samim-robotix/IRoCU-2024-ISRO-Rover/README.md

# Project OBSERACT: Autonomous Planetary Exploration Rover
### ISRO Robotics Challenge - URSC 2024 (IRoC-U 2024) | 5th Position Nationally

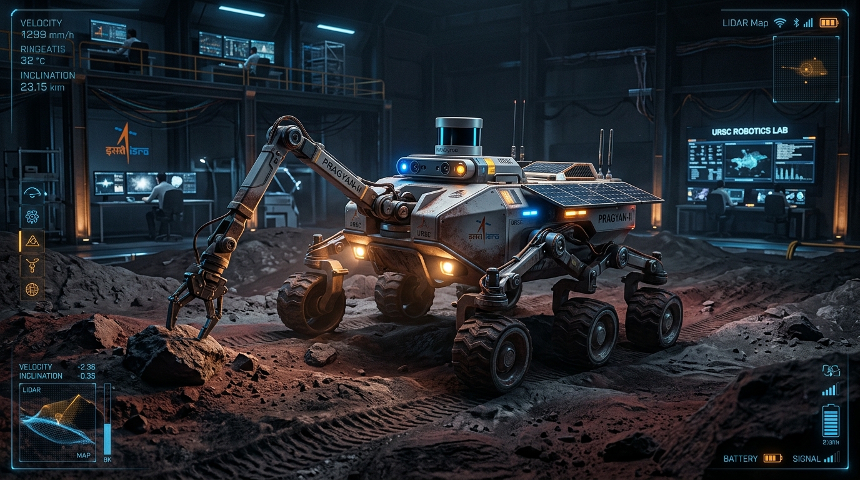
[picture p1: assets/banner.png]
Project Banner


<div align="center">














</div>

---

# Team OBSERACT - IROC-U 2024 Rover Project

<!-- PROJECT POSTER / INFOGRAPHIC (Full Width) -->
<p align="center">
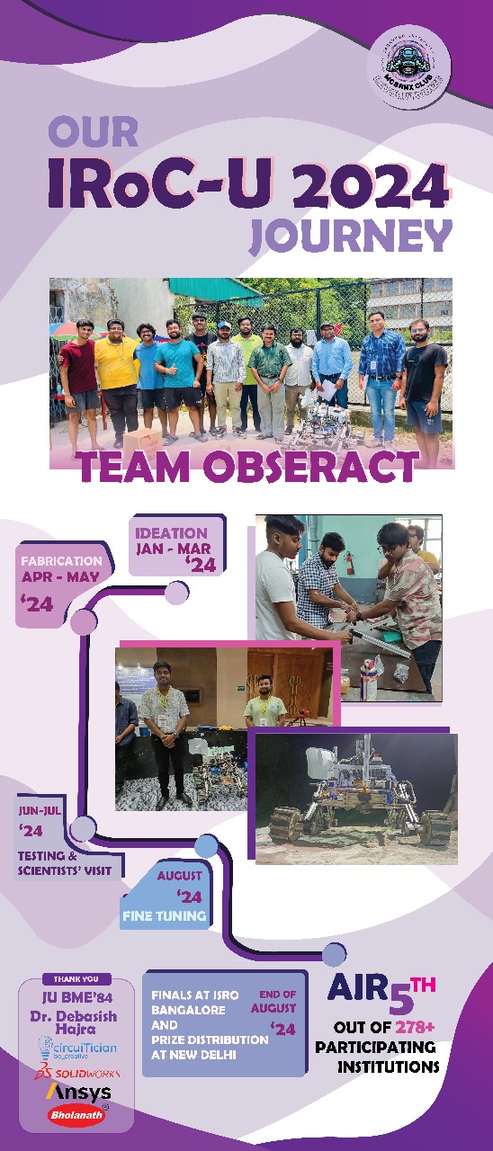
[picture p2: assets/photos/team banner.jpg]
Our IROC-U 2024 Journey Poster
  
</p>

## 🖼️ Project Gallery

### 🤖 Rover Design, Autonomous Testing & Engineering
_Detailed views of the Team OBSERACT rover hardware, computer vision inference, and obstacle navigation systems._

<table width="100%">
  <tr>
    <td width="50%" align="center">
      Rover Hardware Prototype<br>
      <b>Rover Hardware & Chassis Prototype</b>
    </td>
    <td width="50%" align="center">
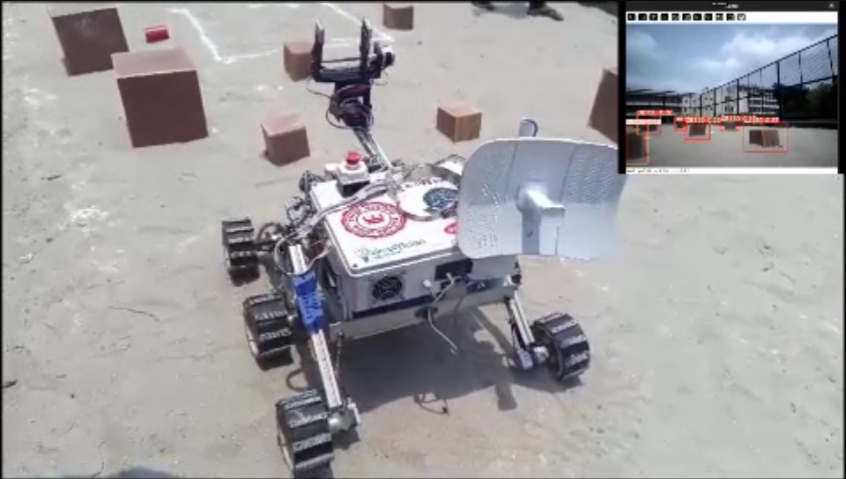
[picture p3: assets/photos/rover ju.PNG]
Autonomous Navigation Testing
      <br>
      <b>Computer Vision & Obstacle Avoidance Testing</b>
    </td>
  </tr>
  <tr>
    <td width="50%" align="center">
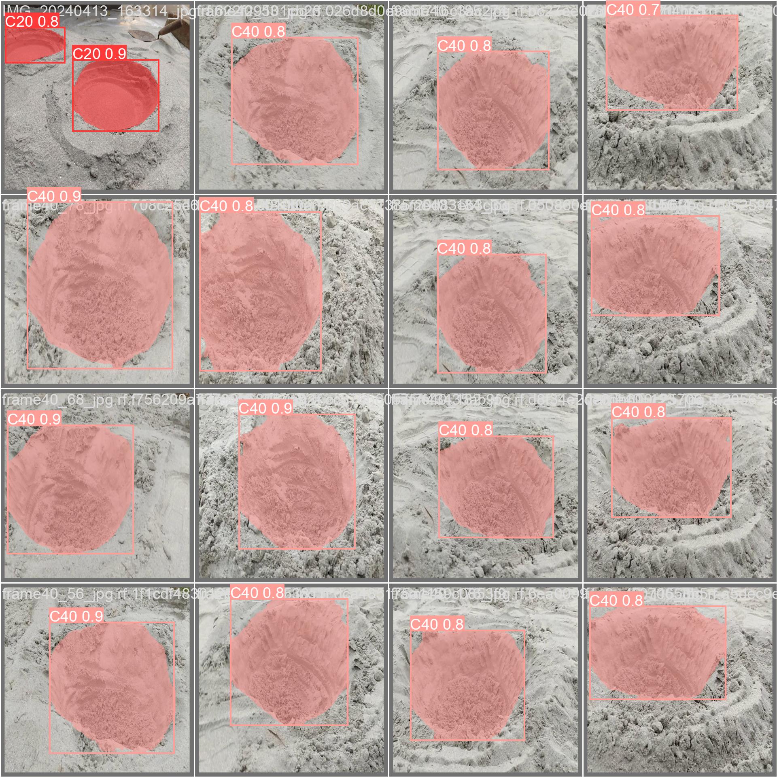
[picture p4: assets/photos/crater_detection_yolov8.jpeg]
YOLOv8 Crater Detection
      <br>
      <b>YOLOv8 Crater Detection Inference</b>
    </td>
    <td width="50%" align="center">
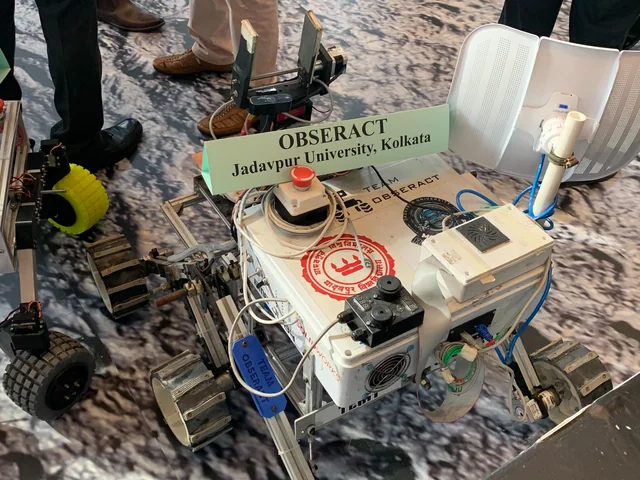
[picture p5: assets/photos/rover isro.WEBP]
Rover at ISRO Arena
      <br>
      <b>Final Rover Configuration at ISRO Arena</b>
    </td>
  </tr>
</table>

---

### 🚀 Team Journey & ISRO Finals
_Snapshots of the team during field calibration and the final staging at the U. R. Rao Satellite Centre (URSC)._

<table width="100%">
  <tr>
    <td width="50%" align="center">
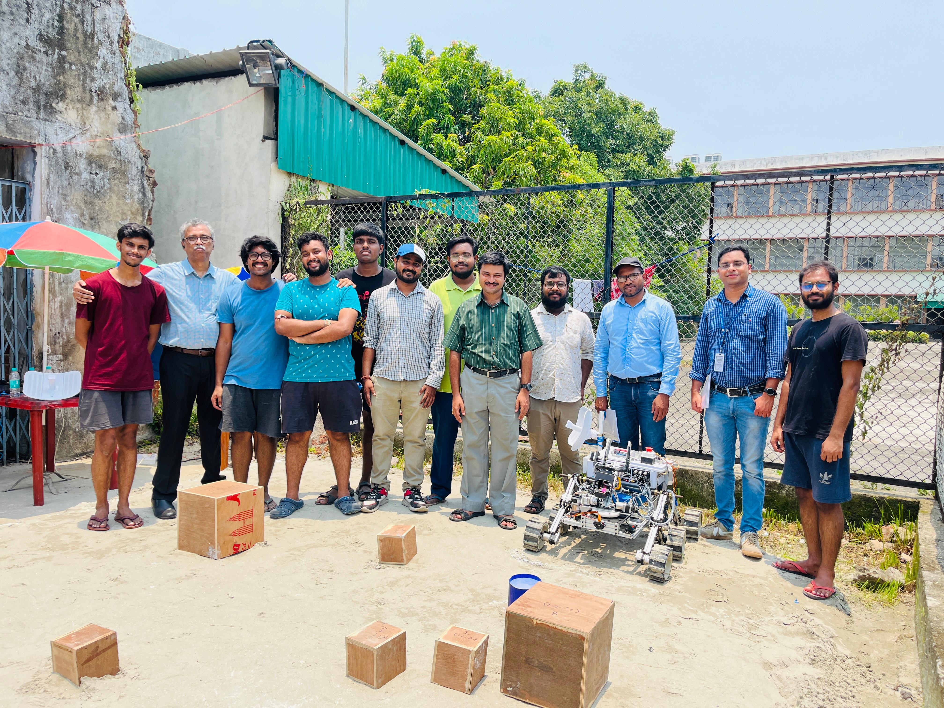
[picture p6: assets/photos/team jadavpur.jpg]
Team Jadavpur Testing Field
      <br>
      <b>Team at Jadavpur University Testing Site</b>
    </td>
    <td width="50%" align="center">
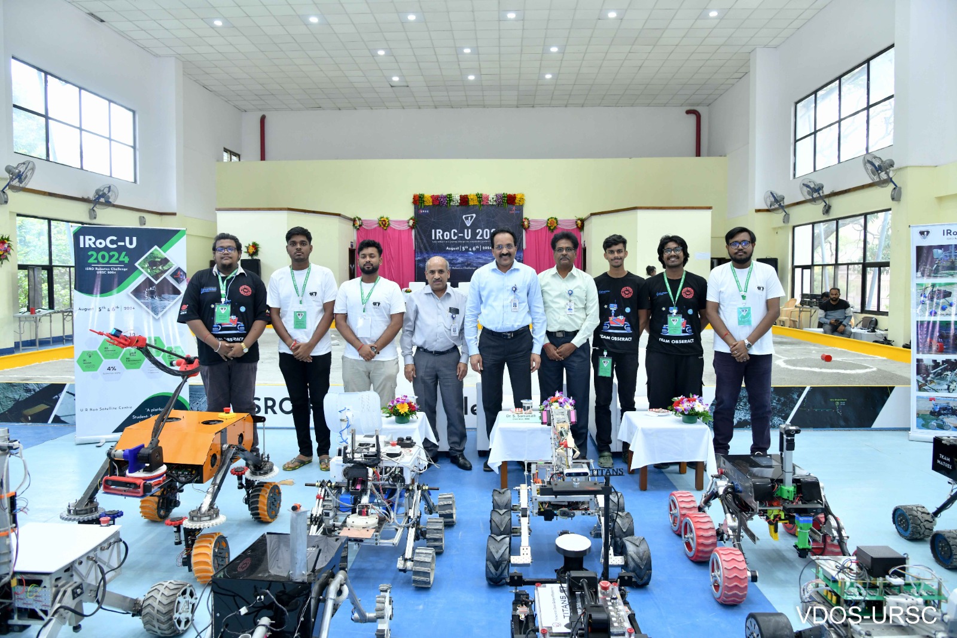
[picture p7: assets/photos/team isro 1.jpg]
ISRO Staging Arena Lineup
      <br>
      <b>Team OBSERACT at URSC Staging Arena</b>
    </td>
  </tr>
  <tr>
    <td width="50%" align="center">
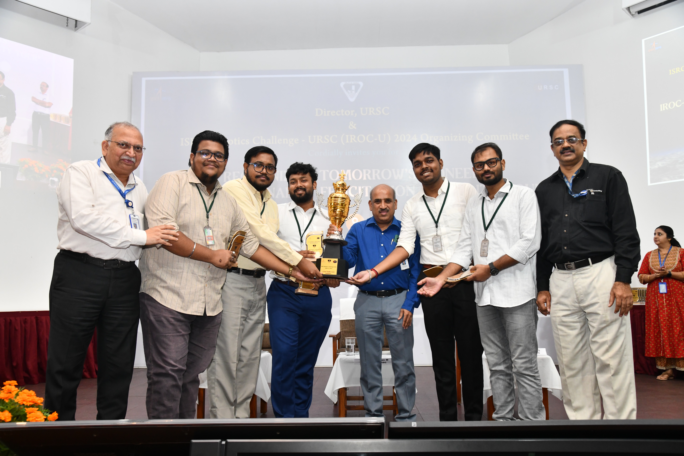
[picture p8: assets/photos/team isro.jpg]
Team Receiving Trophy
      <br>
      <b>Felicitation by the Director, URSC</b>
    </td>
    <td width="50%" align="center">
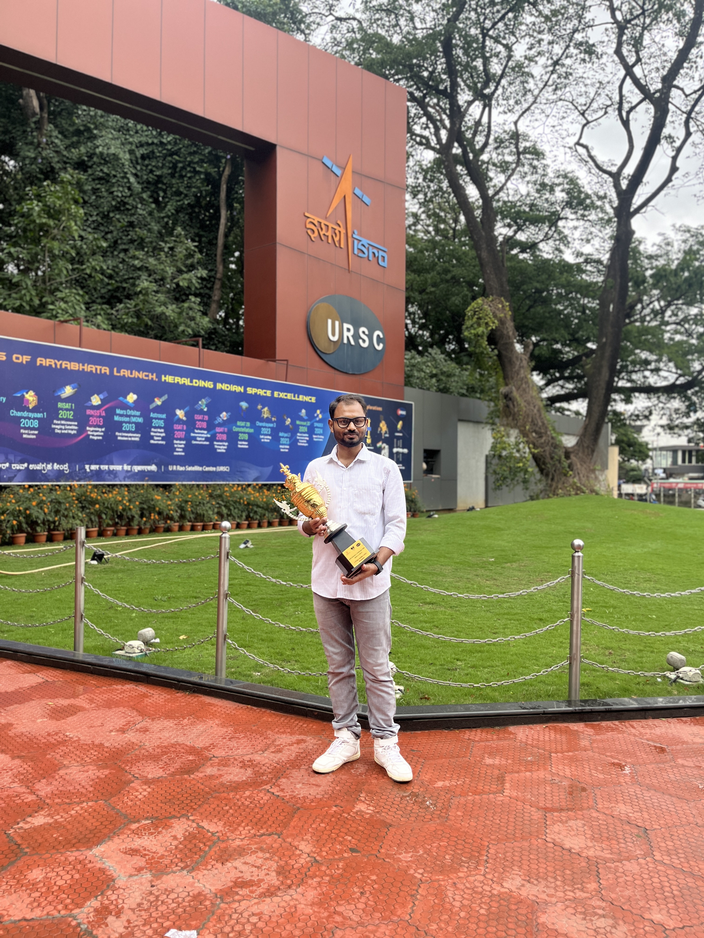
[picture p9: assets/photos/single fron.JPG]
Posing at URSC Sign
      <br>
      <b>Celebrating at URSC Headquarters</b>
    </td>
  </tr>
</table>

---

### 🏆 Awards, Certificates & Media Coverage
_Moments celebrating the All India Rank 5th achievement and the widespread recognition of our work._

<table width="100%">
  <tr>
    <td width="50%" align="center">
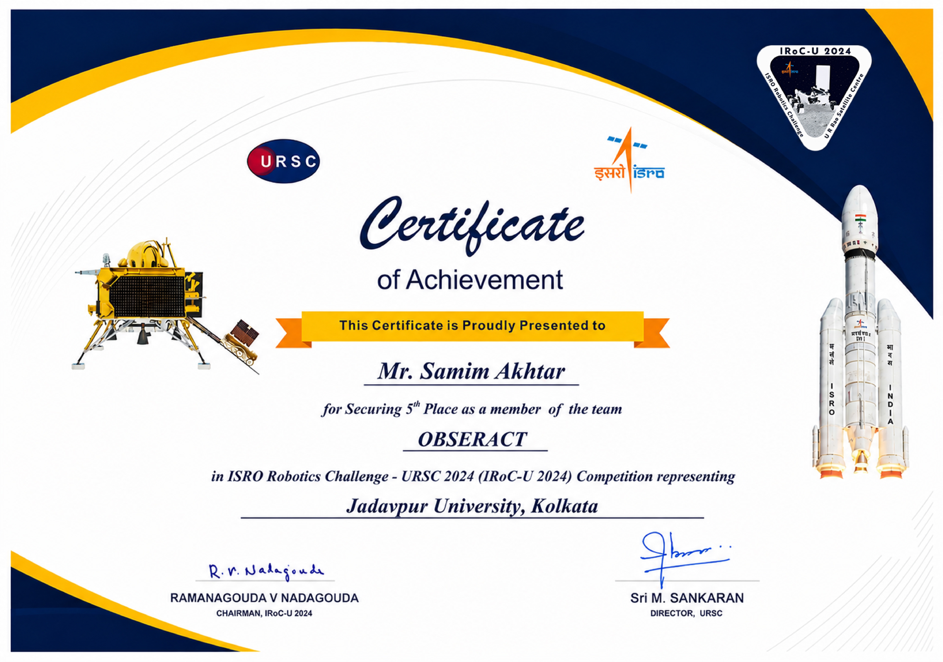
[picture p10: assets/photos/certificate.jpg]
Official Achievement Certificate
      <br>
      <b>Official Achievement Certificate</b>
    </td>
    <td width="50%" align="center">
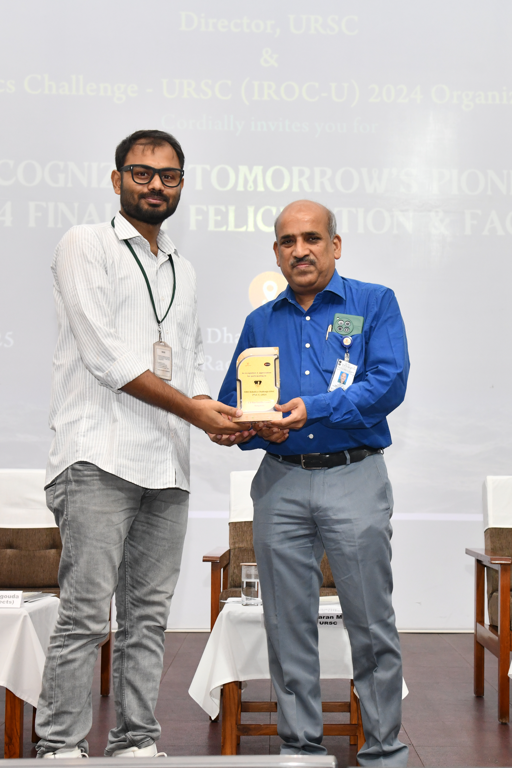
[picture p11: assets/photos/single isro.jpeg]
Receiving Award Token
      <br>
      <b>Receiving the Official Recognition Token</b>
    </td>
  </tr>
  <tr>
    <td width="50%" align="center">
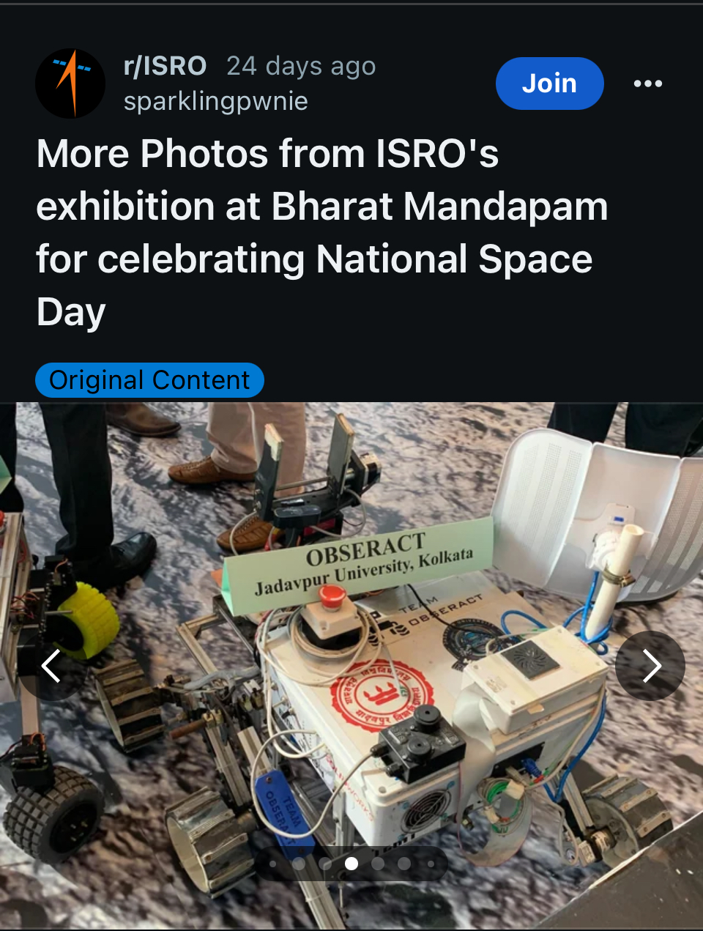
[picture p12: assets/photos/news isro.PNG]
News Coverage 1
      <br>
      <b>Press Coverage Highlighting the Achievement</b>
    </td>
    <td width="50%" align="center">
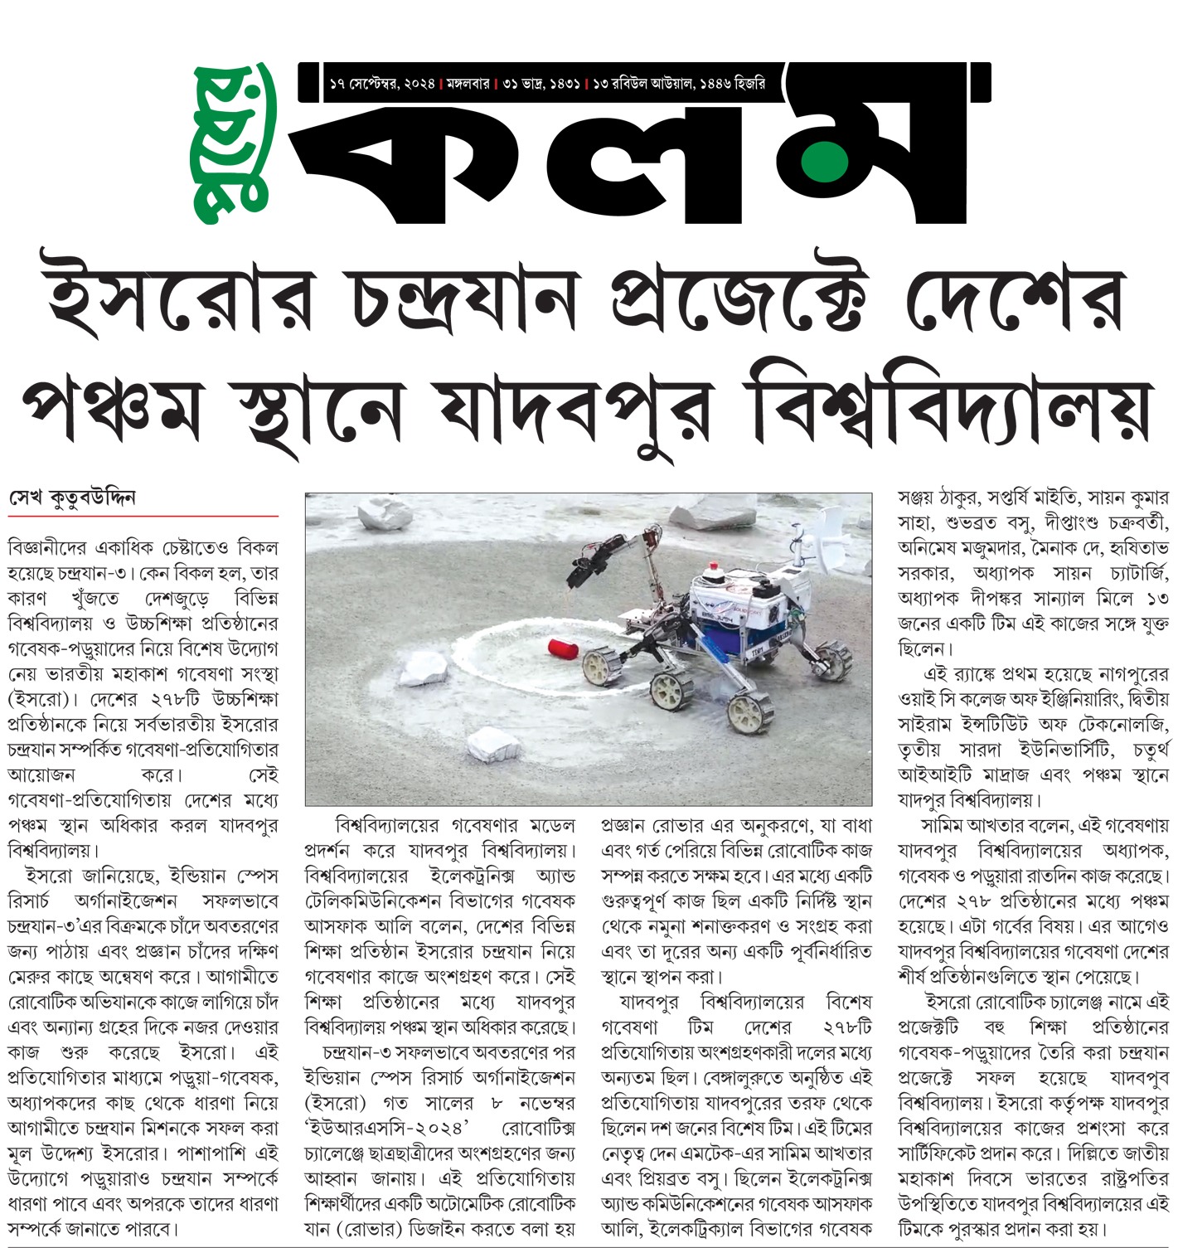
[picture p13: assets/photos/kalam news.jpg]
News Coverage 2
      <br>
      <b>Kalam News Feature Report</b>
    </td>
  </tr>
</table>

---

### 🎥 Field Test Videos & Demonstrations

https://github.com/user-attachments/assets/1fea89f5-3243-4703-b733-9410708686cc

https://github.com/user-attachments/assets/83157b1c-a9e9-4bf5-b669-3bb103190346

https://github.com/user-attachments/assets/7a4b1e10-6299-4aff-aaf4-be91f2c25774

https://github.com/user-attachments/assets/a8de3687-ca90-4187-93c7-3bbb9b5a7004

https://github.com/user-attachments/assets/2eed0919-5cf9-45e3-8780-65f5be33dcf5

https://github.com/user-attachments/assets/71d96060-224c-4bb0-9c72-89f13145069e

---

## 📝 Project Overview and Documentation

## Table of Contents
1. [Competition Overview & National Achievement](#competition-overview--national-achievement)
2. [Hardware & Embedded System Architecture](#hardware--embedded-system-architecture)
3. [Autonomous Perception & Control Pipeline](#autonomous-perception--control-pipeline)
4. [Core Engineering Features](#core-engineering-features)
5. [5-DOF Manipulator & Analytical Kinematics](#5-dof-manipulator--analytical-kinematics)
6. [Bill of Materials (BOM) & Pinout Configuration](#bill-of-materials-bom--pinout-configuration)
7. [Repository File & Directory Structure](#repository-file--directory-structure)
8. [Hardware & Software Setup Guide](#hardware--software-setup-guide)
9. [Media Showcase & Field Tests](#media-showcase--field-tests)
10. [Team & Mentorship](#team--mentorship)
11. [License & Acknowledgments](#license--acknowledgments)

---

## Competition Overview & National Achievement

The **ISRO Robotics Challenge - URSC 2024 (IRoC-U 2024)** was organized by the **U R Rao Satellite Centre (URSC), Indian Space Research Organisation (ISRO)**, Bengaluru. The challenge invited premier universities across India to engineer an extraterrestrial rover prototype capable of operating in simulated lunar and Martian regolith environments.

### Mission Criteria
- **Rocker-Bogie Traverse:** Traverse harsh uneven terrain, scale 150 mm & 300 mm obstacles, and negotiate 15° inclines at controlled speeds of 1 to 5 cm/s.
- **Crater Detection & Avoidance:** Identify and traverse or navigate around 20 cm and 40 cm diameter hemispherical craters.
- **Sample Manipulation:** Autonomously detect, grip, elevate, and deposit target sample cylinders using an onboard multi-axis robotic arm with closed-loop force sensing.
- **Beyond-Line-of-Sight Remote Operation:** Complete all operations remotely within a strict 40-minute window without direct line-of-sight, guided solely by real-time sensor fusion and video telemetry over a 5 GHz wireless link.
- **Emergency Protection:** Hardwired emergency kill-switch mechanism providing instantaneous actuator power isolation.

> **National Standing:** **Team OBSERACT (Team ID: 10487)** from **Jadavpur University, Kolkata** achieved **5th Position Nationally in India**, successfully passing stringent preliminary rounds, design qualification audits, and competitive arena trials.

---

## Hardware & Embedded System Architecture

The rover utilizes a **hierarchical dual-tier processing architecture**: an NVIDIA Jetson Edge AI computer executes compute-heavy perception, neural inference, and path planning, while an STM32F407 ARM Cortex-M4 microcontroller executes deterministic, low-latency motor commutation, CAN bus bus-arbitration, and sensor acquisition.

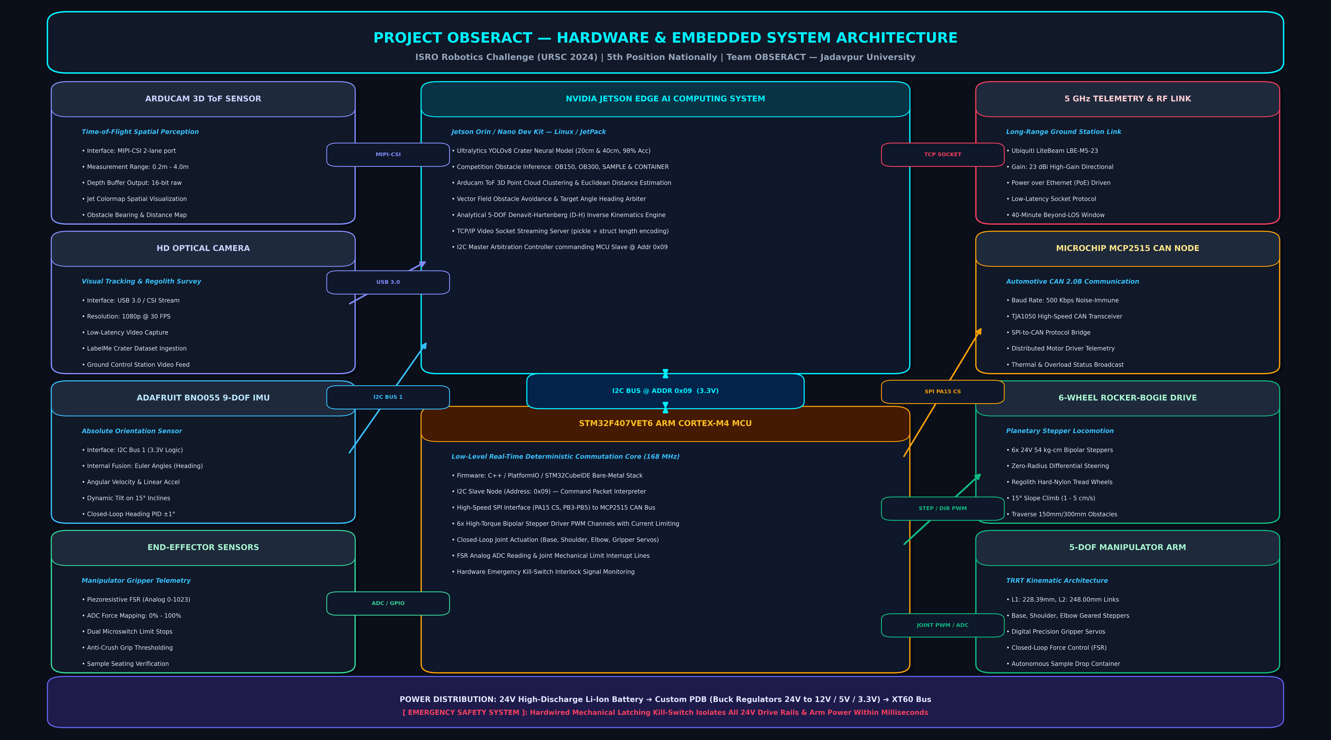
[picture p14: assets/architecture.png]
Hardware & Embedded System Architecture


### Architectural Tier Breakdown
1. **Perception & Telemetry Input Tier:**
   - **Arducam 3D ToF Camera:** Streams 16-bit raw depth buffers over high-speed MIPI-CSI (2-lane) for obstacle range (0.2m-4.0m) and bearing calculation.
   - **HD Optical Camera:** Captures 1080p RGB frames at 30 FPS for YOLOv8 edge inference and ground station streaming.
   - **Adafruit BNO055 9-DOF IMU:** Dedicated I2C Bus 1 interface feeding absolute Euler orientation (heading, pitch, roll) for closed-loop dynamic attitude compensation on 15° slopes.
   - **End-Effector Gripper Sensors:** Analog Piezoresistive FSR (0–1023 ADC mapped to 0–100% force) and digital dual-limit switches for tactile feedback.
2. **High-Level Compute Brain (NVIDIA Jetson Orin / Nano):**
   - Executes real-time TensorRT-accelerated YOLOv8 models for craters and obstacles.
   - Computes dynamic repulsive vector fields and closed-loop heading corrections.
   - Houses the analytical 5-DOF inverse kinematics solver.
   - Operates as **I2C Master** dispatching motion commands to the microcontroller at slave address `0x09`.
   - Runs a TCP/IP video streaming server sending pickle-encoded frame buffers over 5 GHz RF.
3. **Low-Level Deterministic Controller (STM32F407VET6 ARM Cortex-M4 @ 168 MHz):**
   - High-speed SPI (`PA15 CS`) driving the **Microchip MCP2515 CAN Controller** (500 Kbps CAN 2.0B).
   - Generates precision Step/Dir PWM pulses across 6 independent high-torque stepper channels.
   - Monitored by dynamic current-limiting and thermal protection circuits.
4. **Physical Actuation & Power:**
   - **Locomotion:** Six 24V bipolar planetary geared steppers (54 kg-cm torque) driving custom regolith tread wheels.
   - **Arm:** 5-DOF TRRT manipulator with aluminum links and servo/stepper actuators.
   - **Power Distribution Board (PDB):** Step-down buck regulators (24V  12V, 5V, 3.3V) with heavy-duty XT60 buses.
   - **Emergency Kill Switch:** Mechanical latching switch hardwired in-line with the 24V master rail for instantaneous power cutoff.

---

## Autonomous Perception & Control Pipeline

Project OBSERACT features an integrated, closed-loop autonomy pipeline operating in real time at **30 FPS**:

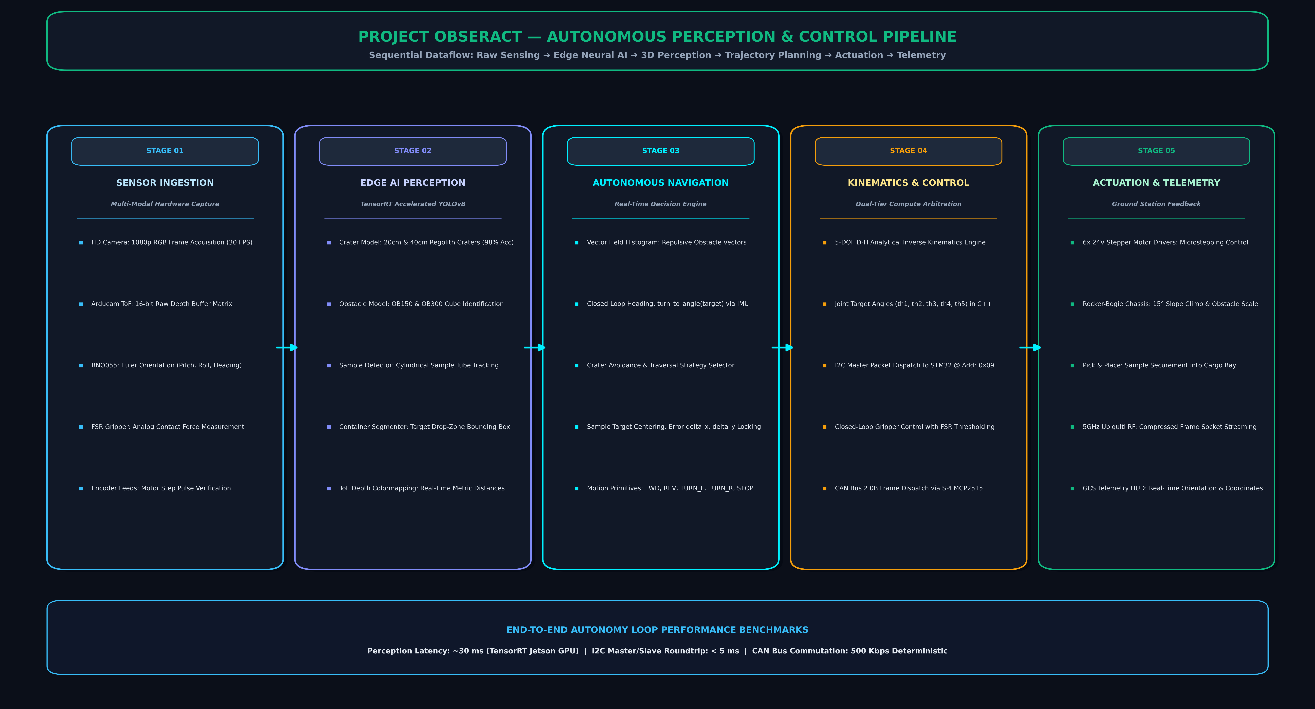
[picture p15: assets/pipeline.png]
Autonomous Perception & Control Pipeline


### Dataflow Stages
| Stage | Subsystem | Functionality & Technical Execution |
|:---:|:---|:---|
| **01** | **Sensor Ingestion** | Synchronized multi-modal capture of 1080p optical video, ToF 16-bit depth buffers, BNO055 9-DOF Euler angles, and analog FSR gripper readings. |
| **02** | **Edge AI Perception** | TensorRT-accelerated dual-model YOLOv8 inference: (1) 20 cm & 40 cm crater detection (98% accuracy), (2) ISRO challenge objects (`OB150`, `OB300`, `SAMPLE`, `CONTAINER`), plus Arducam ToF depth colormapping. |
| **03** | **Autonomous Navigation** | Vector Field Histogram (VFH) generating repulsive steering vectors; closed-loop `turn_to_angle(target)` heading stabilization with 1 precision; automated crater avoidance logic. |
| **04** | **Kinematics & Control** | Analytical 5-DOF Denavit-Hartenberg (D-H) Inverse Kinematics calculating joint angles $\theta_1 \dots \theta_5$; I2C command packet dispatch to STM32 (Addr `0x09`); CAN 2.0B frame broadcast via MCP2515. |
| **05** | **Actuation & Telemetry** | 6-wheel planetary stepper microstepping; 15° slope climb and obstacle traversal; sample pickup and container drop; low-latency OpenCV socket streaming to ground station over 5 GHz Ubiquiti RF. |

---

## Core Engineering Features

- **6-Wheel Rocker-Bogie Suspension:**
  - Engineered with lightweight, structural aluminum T-slot framing (400 mm rocker, 160 mm bogie, 100° span angle).
  - Maintains continuous ground contact across all six wheels on extreme regolith gradients without mechanical springs.
  - Zero-radius differential turning allows on-the-spot rotation and tight steering in confined spaces.
- **Industrial Planetary Drive Actuation:**
  - Six independent 24V bipolar planetary geared stepper motors providing up to **54 kg-cm torque** per wheel.
  - Dedicated multi-channel drive PCB equipped with dynamic current limiting and thermal shutdown safeguards.
- **Dual-Bus Communication Hierarchy:**
  - **CAN Bus 2.0B @ 500 kbps:** Driven by STM32 via SPI-controlled Microchip MCP2515 transceiver for noise-immune actuator signaling.
  - **I2C Master/Slave Protocol:** Jetson Nano operates as I2C master sending motion primitives (`1: Forward`, `2: Backward`, `3: Left`, `4: Right`, `5: Stop`, `6: Heading Target`) to the microcontroller slave at address `0x09`.
- **Closed-Loop Heading Stabilization:**
  - Real-time absolute Euler orientation feedback sourced from the **Adafruit BNO055 9-DOF IMU**.
  - Dynamic turning algorithms (`turn_to_angle`) maintain trajectory accuracy within 1 tolerance.
- **Edge-to-Ground High-Bandwidth Telemetry:**
  - Long-range directional Ubiquiti LiteBeam 5GHz antenna (23 dBi gain) running low-latency TCP/IP socket video streaming.
  - Custom serialization protocol packing frame headers (`struct.pack("Q", len(frame))`) for live ground control feeds.
- **Fail-Safe Emergency Cutoff:**
  - Integrated hardware kill-switch triggering direct power isolation to all actuator circuits within milliseconds.

---

## 5-DOF Manipulator & Analytical Kinematics

The rover carries a 5-Degree-of-Freedom robotic arm configured in a **TRRT** (Twist-Revolute-Revolute-Twist) kinematic arrangement built with lightweight CNC aluminum links and dual-bearing revolute joints.

### Denavit-Hartenberg (D-H) Parameter Table
| Link (i) | Joint Angle (i) | Link Offset (di) | Link Twist (i) | Link Length (ai) |
|:---:|:---:|:---:|:---:|:---:|
| **1** | 1 | 0 | -90 | 0 |
| **2** | 2 | 0 | 0 | L1 (228.39mm) |
| **3** | 3 | 0 | 0 | L2 (248.00mm) |
| **4** | 4 | 0 | +90 | 0 |
| **5** | 5 | 0 | 0 | 0 |

### Analytical Inverse Kinematics Formulation
Given target end-effector coordinates (qx,qy,qz) and orientation matrix elements rij:

1=atan2(qy,qx)

3=qx2+qy2+qz2-L12-L222L1L2

2=L1+L23L23+qx1+qy1-qz

4=r131+r231r33-2-3

5=r211-r111r221-r211

*Closed-form solutions are implemented in high-performance C/C++ ([`arm_manipulator_C_Code.ino`](ISRO/arm_manipulator_C_Code/arm_manipulator_C_Code.ino)) and Python for real-time trajectory planning.*

---

## Bill of Materials (BOM) & Pinout Configuration

### Master Bill of Materials (BOM)
| Subsystem | Component Description | Specifications / Model | Qty | Function |
|:---|:---|:---|:---:|:---|
| **Chassis** | Rocker-Bogie Linkage | 6061-T6 Aluminum T-Slots | 1 Set | Terrain articulation & ground clearance |
| **Locomotion** | Planetary Geared Stepper | 24V, 54 kg-cm torque, BH42SH38-1684PL | 6 | Individual wheel traction & drive |
| **Wheels** | Custom Regolith Wheels | High-durability Nylon / Rubber treads | 6 | Regolith surface grip |
| **Drive Electronics** | Stepper Driver Controller | Multi-Channel Current Regulated Board | 1 | Microstepping & current limiting |
| **Embedded Compute** | Microcontroller | STM32F407VET6 (ARM Cortex-M4, 168 MHz) | 1 | Real-time motion control & CAN bus |
| **Edge AI Brain** | Edge AI Computer | NVIDIA Jetson Nano / Jetson Orin | 1 | YOLOv8 inference, CV, high-level nav |
| **CAN Bus Interface** | CAN Controller & PHY | Microchip MCP2515 + TJA1050 | 1 | High-speed SPI-to-CAN 2.0B bus |
| **Attitude Sensor** | 9-DOF Absolute IMU | Adafruit BNO055 | 1 | Orientation, angular rate & heading |
| **Depth Sensor** | Time-of-Flight Camera | Arducam ToF Depth Camera (MIPI-CSI) | 1 | 3D obstacle depth mapping (up to 4m) |
| **Robotic Arm** | 5-DOF Manipulator | Precision Steppers + Digital High-Torque Servos | 5 | Sample pickup, elevation, and drop |
| **End Effector** | Force Feedback Sensor | Piezoresistive FSR (Analog 0-1023) | 1 | Grasping force regulation |
| **End Effector** | Limit Switches | Microswitches | 2 | Mechanical over-travel protection |
| **RF Communications** | Directional Long-Range Antenna| Ubiquiti LiteBeam LBE-M5-23 (5 GHz, 23 dBi)| 2 | Low-latency telemetry link (Rover + Base) |
| **Power Storage** | Main Battery Pack | 24V High-Discharge Lithium-Ion Pack | 1 | System master power source |
| **Power Distribution** | Custom PDB | Buck Converters (24V  12V, 5V, 3.3V) + XT60 | 1 | Regulated rails & noise filtering |
| **Safety System** | Emergency Kill Switch | High-Current Latching E-Stop Switch | 1 | Instantaneous actuator power cut |

### GPIO Pinout & Communication Interconnect Map

| Device / Module | Signal / Pin | Host / Board Connection | Protocol / Logic Level | Description |
|:---|:---|:---|:---|:---|
| **MCP2515 CAN** | `CS` | STM32F407 Pin `PA15` | SPI (3.3V) | Chip Select for CAN Bus Controller |
| **MCP2515 CAN** | `SCK` | STM32F407 Pin `PB3` / `PA5` | SPI Clock | SPI Bus Clock Line |
| **MCP2515 CAN** | `SO / MISO`| STM32F407 Pin `PB4` / `PA6` | SPI MISO | Controller Data In |
| **MCP2515 CAN** | `SI / MOSI`| STM32F407 Pin `PB5` / `PA7` | SPI MOSI | Controller Data Out |
| **MCP2515 CAN** | `INT` | STM32F407 Interrupt GPIO | Active-Low Interrupt | Frame Receive Notification |
| **BNO055 9-DOF IMU**| `SDA` | Jetson Pin 3 / STM32 `PB7` | I2C (3.3V Pull-up) | Serial Data Line |
| **BNO055 9-DOF IMU**| `SCL` | Jetson Pin 5 / STM32 `PB6` | I2C (3.3V Pull-up) | Serial Clock Line |
| **MCU Slave Port** | `SDA / SCL`| Jetson I2C Bus 1  MCU Addr `0x09`| I2C (3.3V) | Motion command link (Jetson  MCU) |
| **Gripper FSR** | `V_OUT` | STM32 ADC Channel `A0` | Analog (0 - 3.3V) | Force mapping ($0 - 100\%$) |
| **Gripper Limit SW**| `SIGNAL` | STM32 Digital GPIO (Pull-up) | Digital Input | Stroke limit safety interlock |
| **Arducam Depth Cam**| `CSI-2` | Jetson 15-pin / 22-pin MIPI Port | High-Speed MIPI-CSI | Real-time ToF raw depth stream |
| **Kill Switch** | `V_IN / V_OUT`| In-line with 24V Drive Rail | High-Current DC | Emergency power cutoff to drivers |

---

## Repository File & Directory Structure

```
IRoCU-2024/
├── assets/
│   ├── banner.png                              # High-tech project banner
│   ├── architecture.png                        # Hardware & embedded system architecture
│   ├── pipeline.png                            # Autonomous perception & control pipeline
│   ├── photos/                                 # Hardware and arena prototype photos
│   │   ├── crater_detection_yolov8.jpeg        # YOLOv8 crater inference validation
│   │   ├── crater_training_metrics.png         # Precision-recall & loss curves
│   │   ├── rover_hardware_prototype.jpg        # Fabricated Rocker-Bogie chassis
│   │   ├── obstacle_150mm_cube.jpg             # 150mm obstacle detection target
│   │   ├── obstacle_300mm_cube.jpg             # 300mm obstacle avoidance target
│   │   └── obstacle_sample_tube.jpg            # Cylindrical sample target
│   └── videos/                                 # Field tests & mobility recordings
│       ├── rover_mobility_demo.mp4             # 6-wheel rover traversal test
│       ├── obstacle_traversal_demo.mp4         # Rocker-bogie climbing demonstration
│       └── robotic_arm_demo.mp4                # Manipulator pick-and-place trial
├── ISRO/
│   ├── ArmManipulatorC_code_2/                 # Manipulator kinematics firmware
│   ├── arm_manipulator_C_Code/                 # 5-DOF analytical IK implementation
│   ├── Client Server/                          # Video & telemetry socket streaming
│   ├── Force_Sensor_Code/                      # FSR analog force measurement code
│   ├── General Codes/                          # Vector math, frame extraction & nav
│   ├── ML/                                     # YOLOv8 crater weights (best_25.pt)
│   ├── stm_roboarm/                            # PlatformIO project for STM32F407VE
│   │   ├── platformio.ini                      # STSTM32 platform config & DFRobot CAN
│   │   └── src/main.cpp                        # CAN bus transmission loop
│   └── New folder/                             # Design report, schematics & rulebooks
├── ISRO Total File/
│   ├── ISRO Robotics Challenge/
│   │   ├── autonomy/                           # Integrated YOLOv8 + I2C heading navigation
│   │   │   ├── autonomy.py                     # Main autonomy control loop
│   │   │   ├── heading_i2c.py                  # BNO055 IMU + I2C MCU arbitration
│   │   │   └── ml-inf.py                       # Standalone edge inference
│   │   ├── obseract-live-demonstration/        # Arducam ToF depth camera integration
│   │   │   └── depth_cam.py                    # ToF 3D spatial colormapping & range
│   │   └── obseract/                           # Inverse kinematics regression models
│   ├── New Designs/                            # SolidWorks CAD assemblies (.SLDASM, .SLDPRT)
│   └── OBS_Chassis/                            # Rocker-Bogie chassis structural models
├── generate_diagrams.py                        # Automated architecture & pipeline renderer
├── .gitignore                                  # Optimized Git exclusion filters
└── README.md                                   # Production project documentation
```

---

## Hardware & Software Setup Guide

### 1. Embedded Firmware Setup (STM32F407VE)

The low-level controller firmware is developed using **PlatformIO** and **STM32CubeIDE**.

```bash
# Clone the repository
git clone https://github.com/<your-username>/IRoCU-2024.git
cd IRoCU-2024/ISRO/stm_roboarm

# Install PlatformIO Core if not installed:
pip install platformio

# Compile firmware for STM32F407VE
pio run -e black_f407ve

# Flash to target board via ST-Link v2
pio run -e black_f407ve --target upload
```

### 2. Jetson Edge AI & Autonomous Navigation Setup

Ensure your NVIDIA Jetson Nano / Orin is flashed with **JetPack 5.x / Ubuntu 20.04+** with CUDA and TensorRT enabled.

```bash
# Navigate to the autonomy module
cd "ISRO Total File/ISRO Robotics Challenge/autonomy"

# Create virtual environment
python3 -m venv venv
source venv/bin/activate

# Install required packages
pip install --upgrade pip
pip install ultralytics opencv-python numpy smbus2 adafruit-circuitpython-bno055

# Run the autonomous perception and drive loop
python3 autonomy.py
```

### 3. Video Telemetry & Ground Station Streaming

**On Rover (NVIDIA Jetson Server):**
```bash
cd "ISRO/Client Server/Socket Programming Video streaming"
python3 Server.py
```

**On Ground Control Station (PC Client):**
```bash
cd "ISRO Total File/ISRO Robotics Challenge/obseract-live-demonstration"
python3 client.py --host <ROVER_IP_ADDRESS> --port 9999
```

---

## Field Tests

### Hardware Prototype & Deep Learning Outputs
| Fabricated Rover Prototype | YOLOv8 Crater Detection | Model Metrics |
|:---:|:---:|:---:|
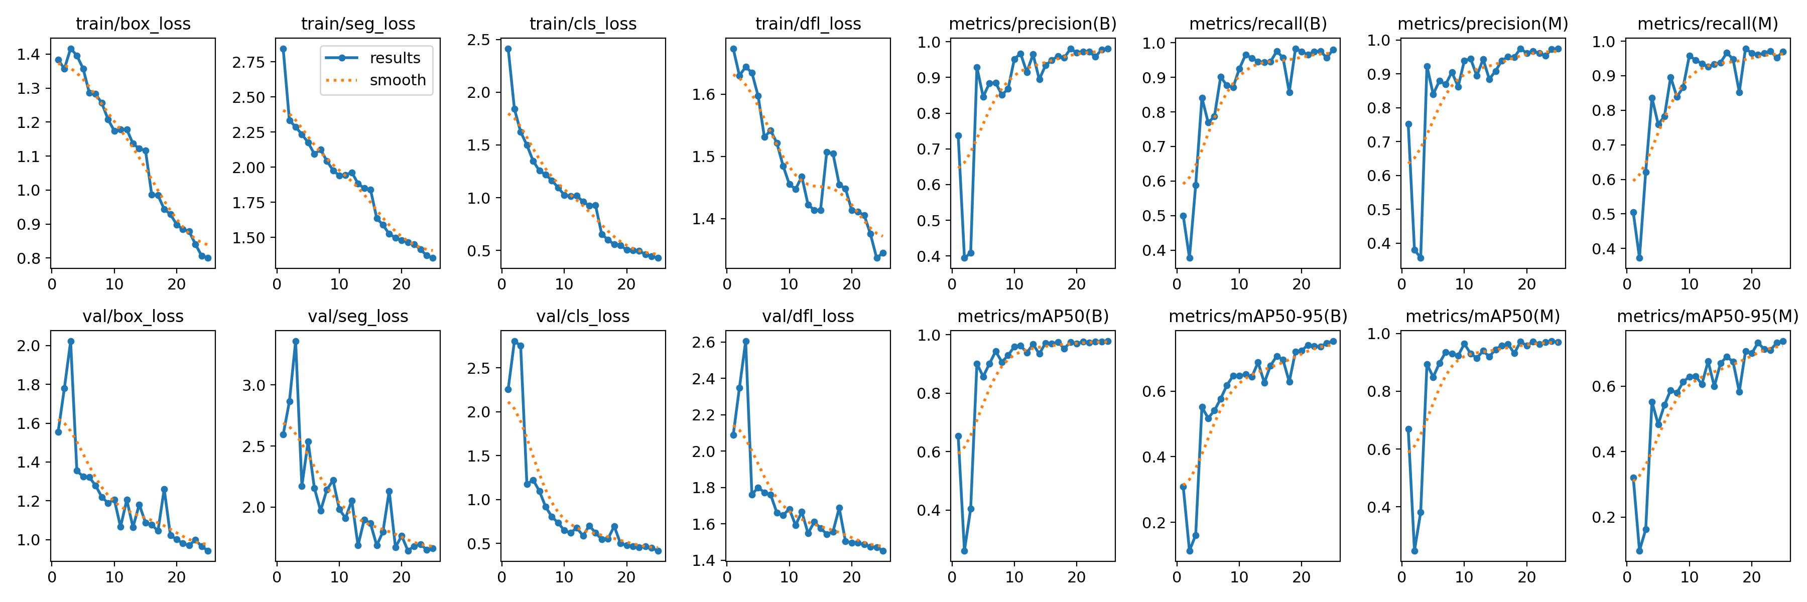
[picture p16: assets/photos/crater_training_metrics.png]
Training Metrics
| Rover Prototype | Crater Detection |  |
| *6-wheel Rocker-Bogie suspension testbed* | *Real-time 20cm/40cm crater inference* | *High precision-recall curve ($98\%$)* |

### Field Target Markers
| 150 mm Obstacle Block | 300 mm Obstacle Block | Sample Retrieval Tube |
|:---:|:---:|:---:|
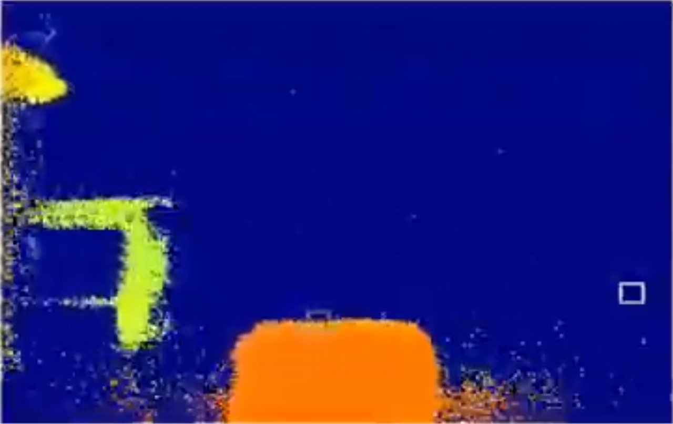
[picture p17: assets/photos/obstacle_150mm_cube.jpg]
150mm Block
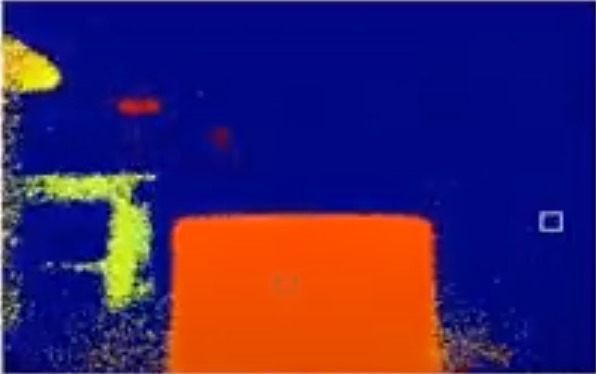
[picture p18: assets/photos/obstacle_sample_tube.jpg]
Sample Tube
|  | 300mm Block |  |
| *Scaling & traversal target* | *Autonomous avoidance obstacle* | *5-DOF manipulator pickup target* |

## Team & Mentorship

<div align="center">

### Faculty Mentors
**Prof. Dr. Sayan Chatterjee**  
*Professor, Department of Electronics & Telecommunication Engineering*  
*Jadavpur University, Kolkata*

**Prof. Dipankar Sanyal**  
*Professor, Department of Mechanical Engineering*  
*Jadavpur University, Kolkata*

---

### Student Engineering Team (Team OBSERACT)

| # | Name | Department | Role / Subsystem Specialization |
|:---:|:---|:---|:---|
| 1 | **Samim Akhtar** | Electronics & Telecommunication Engg | **Team Lead** · Embedded Architecture, CAN Bus & Vision Integration |
| 2 | **Priyabrata Basu** | Electronics & Telecommunication Engg | Telecommunications, Socket Networking & RF Telemetry |
| 3 | **Diptanshu Chakrabartty**| Civil Engineering | Structural Loading, Dynamics & Ground Analysis |
| 4 | **Saptarshi Maity** | Metallurgical & Material Engineering | Materials Selection, Thermal Profiling & Link Rigidity |
| 5 | **Asfak Ali** | Electronics & Telecommunication Engg | Low-Level Firmware, STM32 Driver Development & Kinematics |
| 6 | **Sanjay Thakur** | Electrical Engineering | Power Distribution Board (PDB), Motor Drivers & Battery |
| 7 | **Hrishitava Sarkar** | Mechanical Engineering | Rocker-Bogie Chassis Design, SolidWorks CAD & Stress FEA |
| 8 | **Sayan Kumar Sah** | Metallurgical & Material Engineering | Fabrication, Joint Machining & Mechanical Prototyping |
| 9 | **Mainak Dey** | Mechanical Engineering | 5-DOF Robotic Arm Mechanical Design & Gripper Mechanism |
| 10 | **Animesh Majumder** | Metallurgical & Material Engineering | Chassis Testing, Quality Assurance & Mechanical Assembly |

</div>

---

## License & Acknowledgments

- **Competition Host:** We express our deepest gratitude to the **U R Rao Satellite Centre (URSC), Indian Space Research Organisation (ISRO)** for conceptualizing and organizing the **IRoC-U 2024** challenge and providing a national platform for robotics innovation.
- **Academic Support:** Sincere thanks to **Jadavpur University**, the Department of Electronics & Telecommunication Engineering, and the Department of Mechanical Engineering for workshop facilities, fabrication resources, and departmental guidance.
- **License:** This project is distributed under the [MIT License](LICENSE).
