samim-robotix/IRoCU-2024-ISRO-Rover/ISRO Total File/ISRO Robotics Challenge/ML Images/20_40Craters.v2i.yolov8/valid/images/frame_2_jpg.rf.8c1ff94af3c7788ad4eeecb040791eaf.jpg

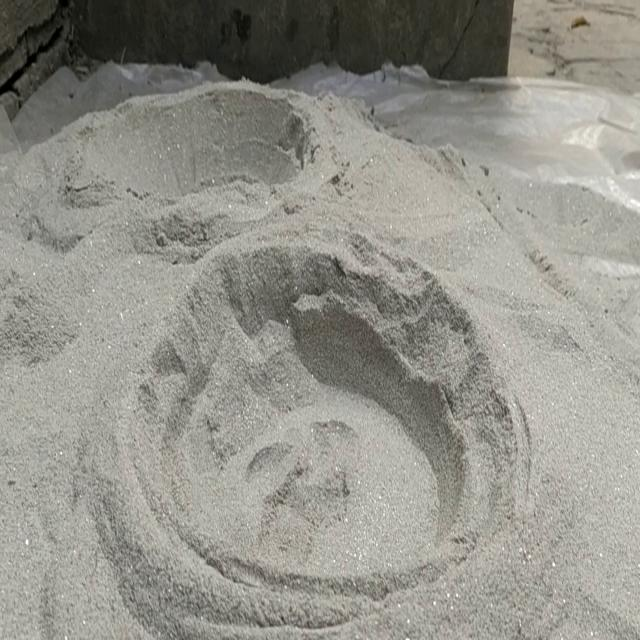
ISRO Total File/ISRO Robotics Challenge/ML Images/20_40Craters.v2i.yolov8/valid/images/frame_2_jpg.rf.8c1ff94af3c7788ad4eeecb040791eaf.jpg
