samim-robotix/IRoCU-2024-ISRO-Rover/ISRO Total File/ISRO Robotics Challenge/ML Images/20_40Craters.v2i.yolov8/valid/images/frame_6_jpg.rf.a0acbc5d8ad12a6c4472a24d94ab41eb.jpg

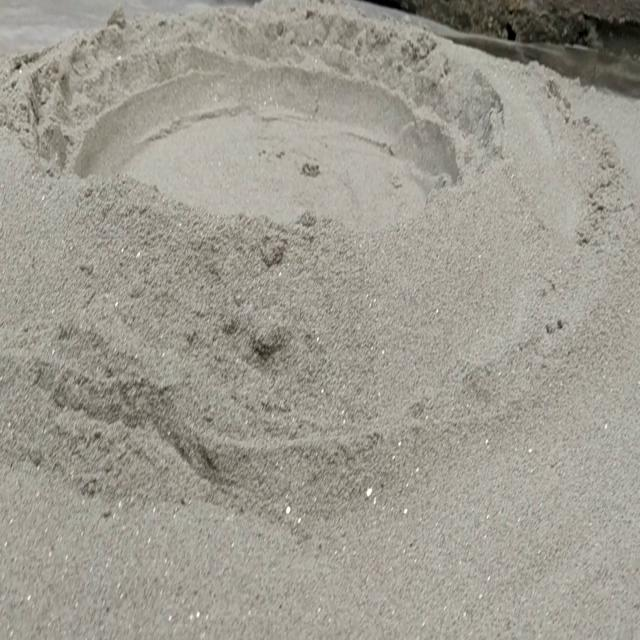
ISRO Total File/ISRO Robotics Challenge/ML Images/20_40Craters.v2i.yolov8/valid/images/frame_6_jpg.rf.a0acbc5d8ad12a6c4472a24d94ab41eb.jpg
