samim-robotix/IRoCU-2024-ISRO-Rover/ISRO Total File/ISRO Robotics Challenge/ML Images/20_40Craters.v2i.yolov8/valid/images/frame_13_jpg.rf.e731c97d967fa71e6efc258e65cf71a0.jpg

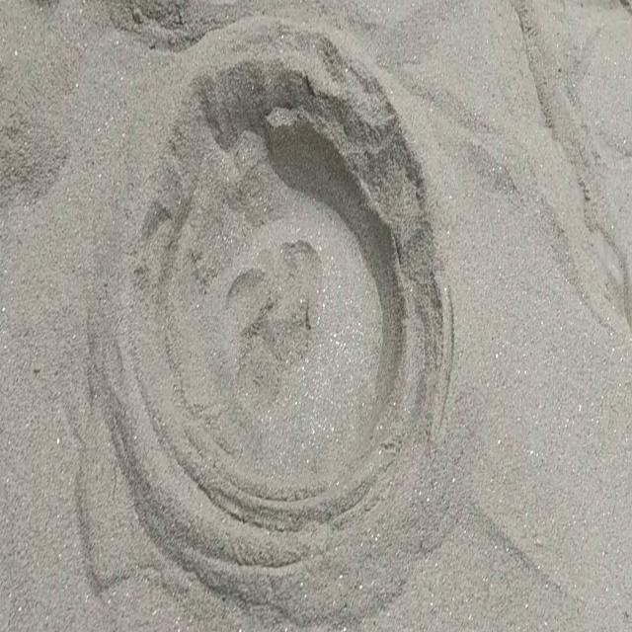
ISRO Total File/ISRO Robotics Challenge/ML Images/20_40Craters.v2i.yolov8/valid/images/frame_13_jpg.rf.e731c97d967fa71e6efc258e65cf71a0.jpg
