samim-robotix/IRoCU-2024-ISRO-Rover/ISRO Total File/ISRO Robotics Challenge/ML Images/20_40Craters.v2i.yolov8/valid/images/frame_14_jpg.rf.c568cc90a22e0c4fc50a3a65dd571331.jpg

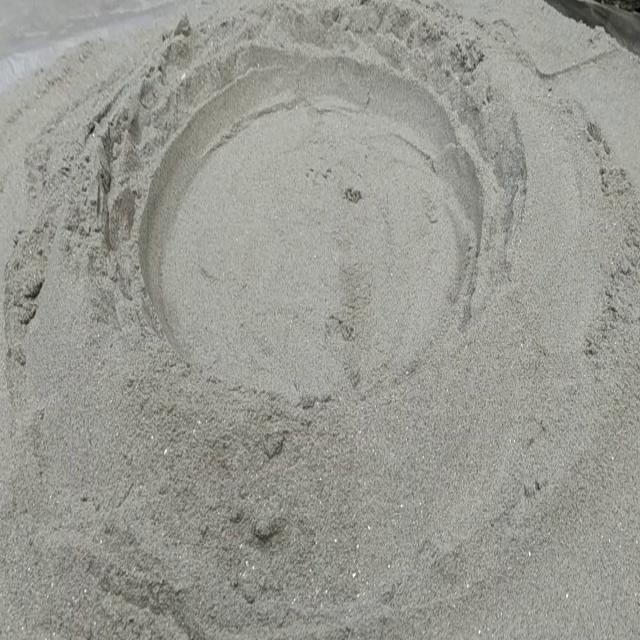
ISRO Total File/ISRO Robotics Challenge/ML Images/20_40Craters.v2i.yolov8/valid/images/frame_14_jpg.rf.c568cc90a22e0c4fc50a3a65dd571331.jpg
