samim-robotix/IRoCU-2024-ISRO-Rover/ISRO Total File/ISRO Robotics Challenge/ML Images/20_40Craters.v2i.yolov8/valid/images/frame_16_jpg.rf.244cc28c9cb41436c8d806cb94a364ef.jpg

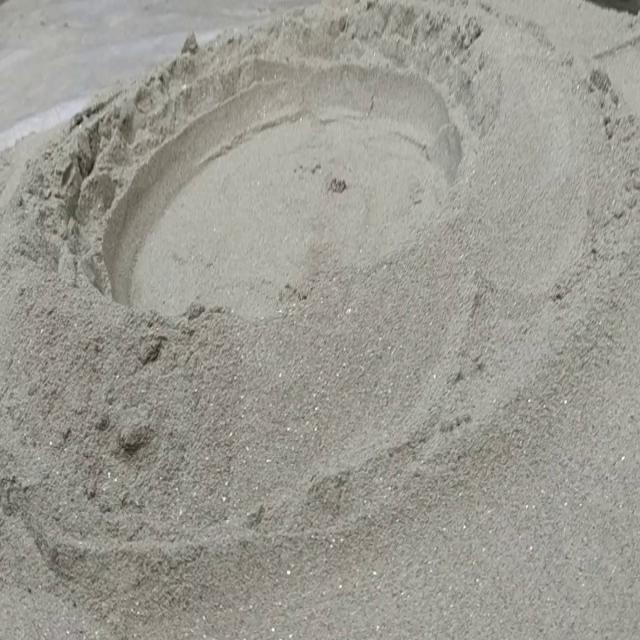
ISRO Total File/ISRO Robotics Challenge/ML Images/20_40Craters.v2i.yolov8/valid/images/frame_16_jpg.rf.244cc28c9cb41436c8d806cb94a364ef.jpg
