samim-robotix/IRoCU-2024-ISRO-Rover/ISRO Total File/ISRO Robotics Challenge/ML Images/20_40Craters.v2i.yolov8/valid/images/frame_19_jpg.rf.c27591f4d9e881a9ca520bb8543271ca.jpg

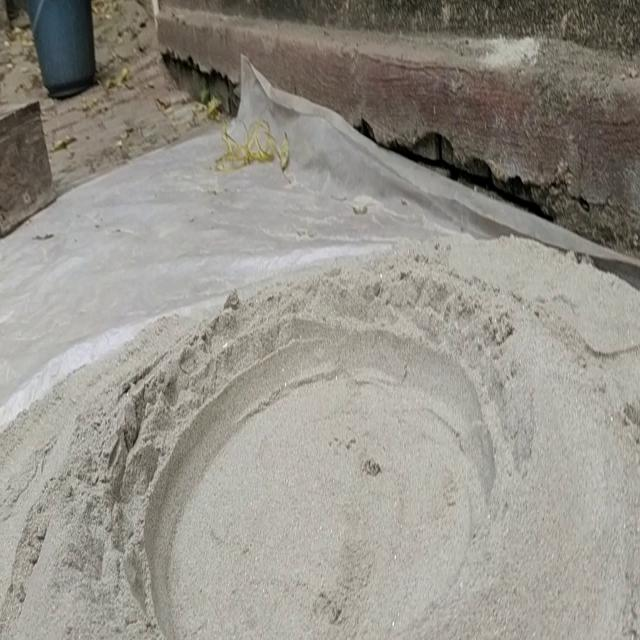
ISRO Total File/ISRO Robotics Challenge/ML Images/20_40Craters.v2i.yolov8/valid/images/frame_19_jpg.rf.c27591f4d9e881a9ca520bb8543271ca.jpg
