samim-robotix/IRoCU-2024-ISRO-Rover/ISRO Total File/ISRO Robotics Challenge/ML Images/20_40Craters.v2i.yolov8/valid/images/frame_22_jpg.rf.d7eccf38984a533224983687193d13f5.jpg

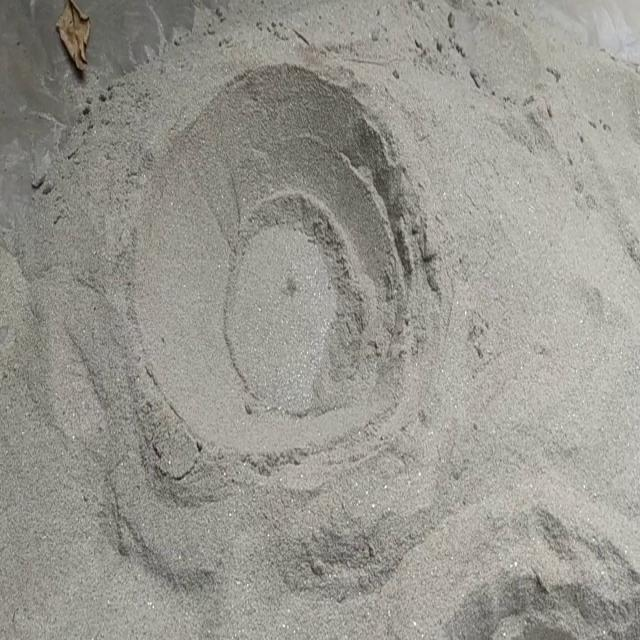
ISRO Total File/ISRO Robotics Challenge/ML Images/20_40Craters.v2i.yolov8/valid/images/frame_22_jpg.rf.d7eccf38984a533224983687193d13f5.jpg
