samim-robotix/IRoCU-2024-ISRO-Rover/ISRO Total File/ISRO Robotics Challenge/ML Images/20_40Craters.v2i.yolov8/valid/images/frame_38_jpg.rf.6da5c61d2fe1e5bdc8561fcd88d1da7a.jpg

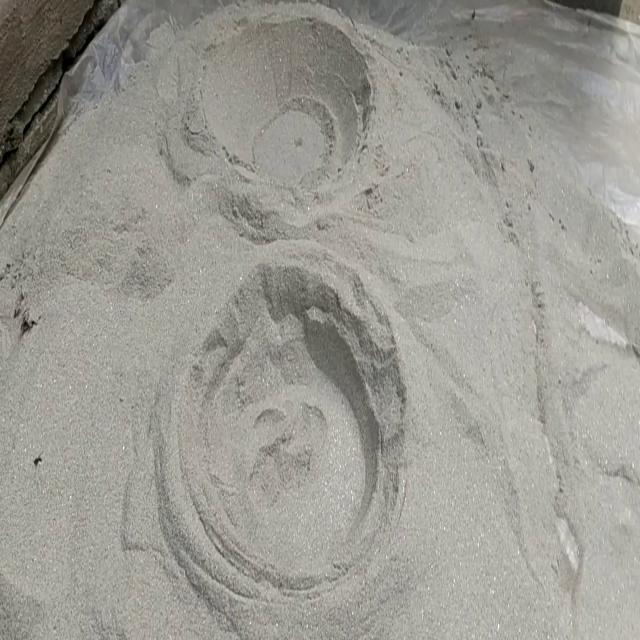
ISRO Total File/ISRO Robotics Challenge/ML Images/20_40Craters.v2i.yolov8/valid/images/frame_38_jpg.rf.6da5c61d2fe1e5bdc8561fcd88d1da7a.jpg
