samim-robotix/IRoCU-2024-ISRO-Rover/ISRO Total File/ISRO Robotics Challenge/ML Images/20_40Craters.v2i.yolov8/valid/images/frame_41_jpg.rf.98104d6bf74a7b3cd82ac5a42d375469.jpg

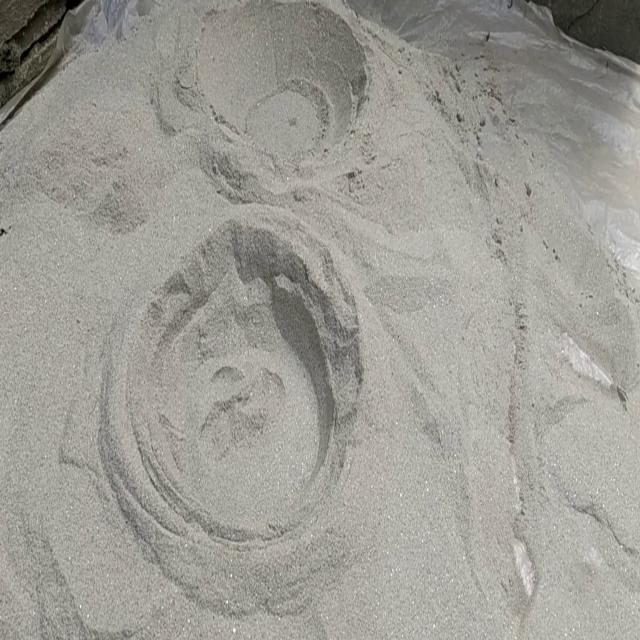
ISRO Total File/ISRO Robotics Challenge/ML Images/20_40Craters.v2i.yolov8/valid/images/frame_41_jpg.rf.98104d6bf74a7b3cd82ac5a42d375469.jpg
