samim-robotix/IRoCU-2024-ISRO-Rover/ISRO Total File/ISRO Robotics Challenge/ML Images/20_40Craters.v2i.yolov8/valid/images/frame_41_jpg.rf.ecd536e4f354195c257cbc0845ad31dd.jpg

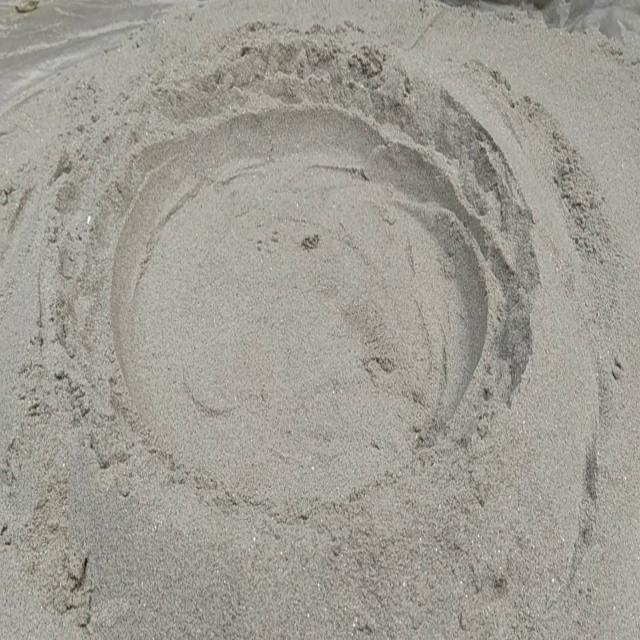
ISRO Total File/ISRO Robotics Challenge/ML Images/20_40Craters.v2i.yolov8/valid/images/frame_41_jpg.rf.ecd536e4f354195c257cbc0845ad31dd.jpg
