samim-robotix/IRoCU-2024-ISRO-Rover/ISRO Total File/ISRO Robotics Challenge/ML Images/20_40Craters.v2i.yolov8/valid/images/frame_42_jpg.rf.6f22638ecfdecd7398a9221b63d22070.jpg

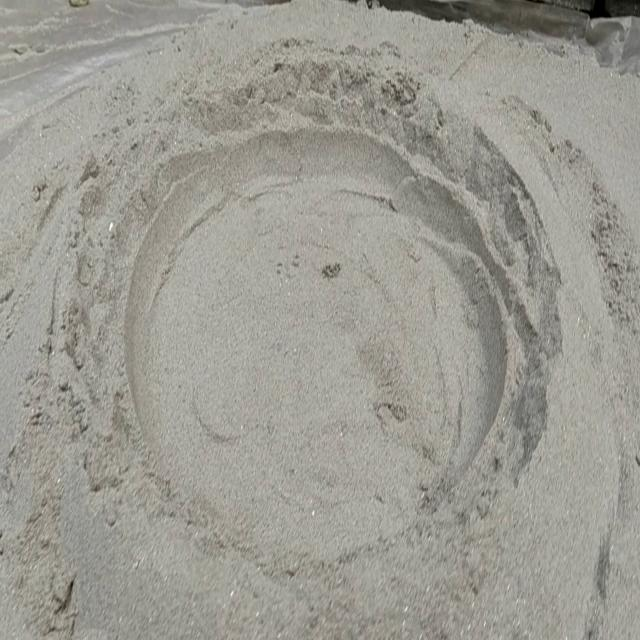
ISRO Total File/ISRO Robotics Challenge/ML Images/20_40Craters.v2i.yolov8/valid/images/frame_42_jpg.rf.6f22638ecfdecd7398a9221b63d22070.jpg
