samim-robotix/IRoCU-2024-ISRO-Rover/ISRO Total File/ISRO Robotics Challenge/ML Images/20_40Craters.v2i.yolov8/valid/images/frame_50_jpg.rf.9fcf4a4fdef42a2672088c543ecdaf5c.jpg

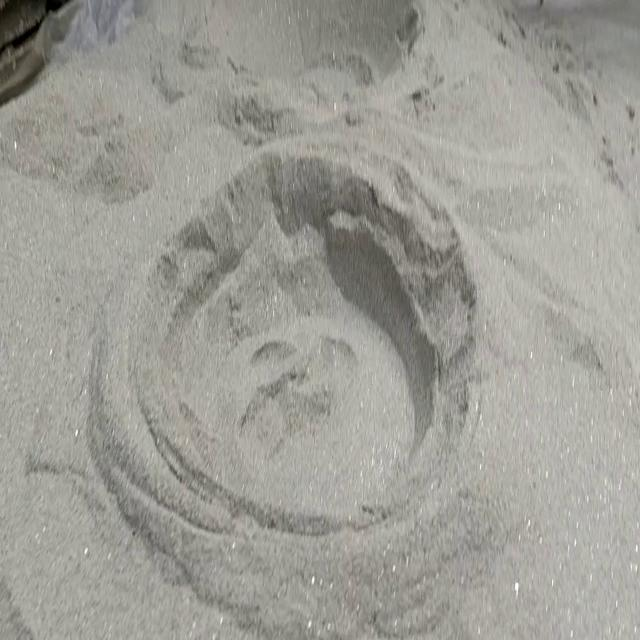
ISRO Total File/ISRO Robotics Challenge/ML Images/20_40Craters.v2i.yolov8/valid/images/frame_50_jpg.rf.9fcf4a4fdef42a2672088c543ecdaf5c.jpg
