samim-robotix/IRoCU-2024-ISRO-Rover/ISRO Total File/ISRO Robotics Challenge/ML Images/20_40Craters.v2i.yolov8/valid/images/frame_50_jpg.rf.f9093e20577cfd321961667b26d30df2.jpg

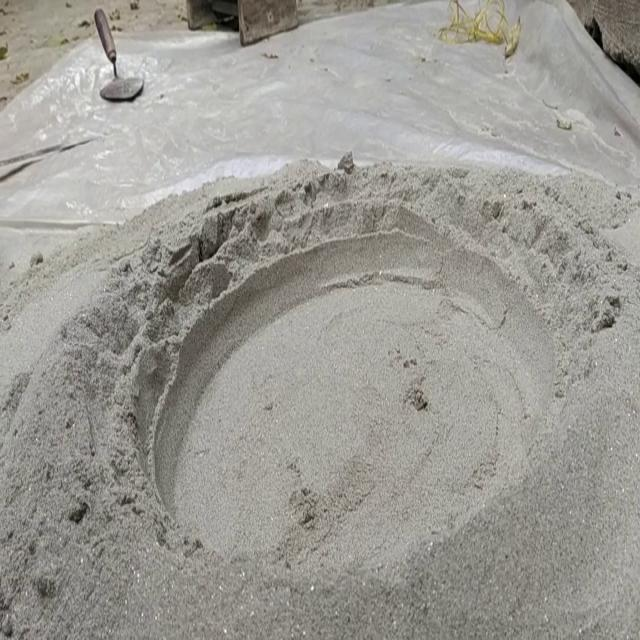
ISRO Total File/ISRO Robotics Challenge/ML Images/20_40Craters.v2i.yolov8/valid/images/frame_50_jpg.rf.f9093e20577cfd321961667b26d30df2.jpg
