samim-robotix/IRoCU-2024-ISRO-Rover/ISRO Total File/ISRO Robotics Challenge/ML Images/20_40Craters.v2i.yolov8/valid/images/frame_55_jpg.rf.c5cb5579119fe4d7c7a84fded9bd8c95.jpg

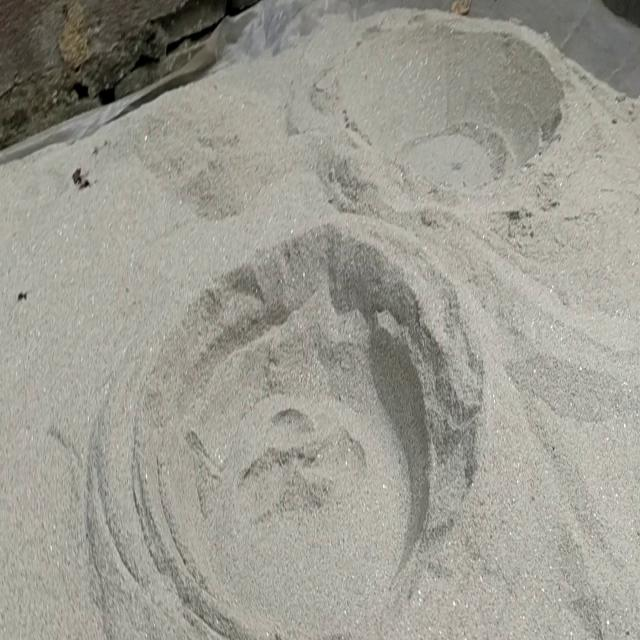
ISRO Total File/ISRO Robotics Challenge/ML Images/20_40Craters.v2i.yolov8/valid/images/frame_55_jpg.rf.c5cb5579119fe4d7c7a84fded9bd8c95.jpg
