samim-robotix/IRoCU-2024-ISRO-Rover/ISRO Total File/ISRO Robotics Challenge/ML Images/20_40Craters.v2i.yolov8/valid/images/frame_56_jpg.rf.14609f3cdea8566490607b31cebca83f.jpg

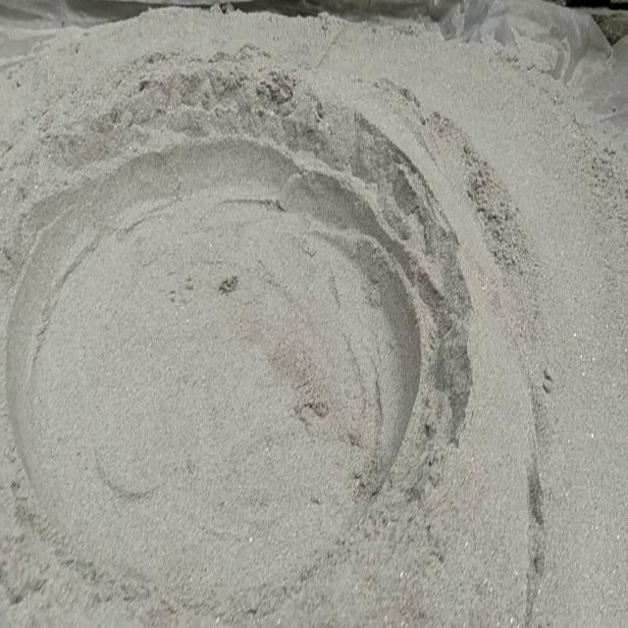
ISRO Total File/ISRO Robotics Challenge/ML Images/20_40Craters.v2i.yolov8/valid/images/frame_56_jpg.rf.14609f3cdea8566490607b31cebca83f.jpg
