samim-robotix/IRoCU-2024-ISRO-Rover/ISRO Total File/ISRO Robotics Challenge/ML Images/20_40Craters.v2i.yolov8/valid/images/frame_57_jpg.rf.93f1606f98c719a71131d59f7b032d25.jpg

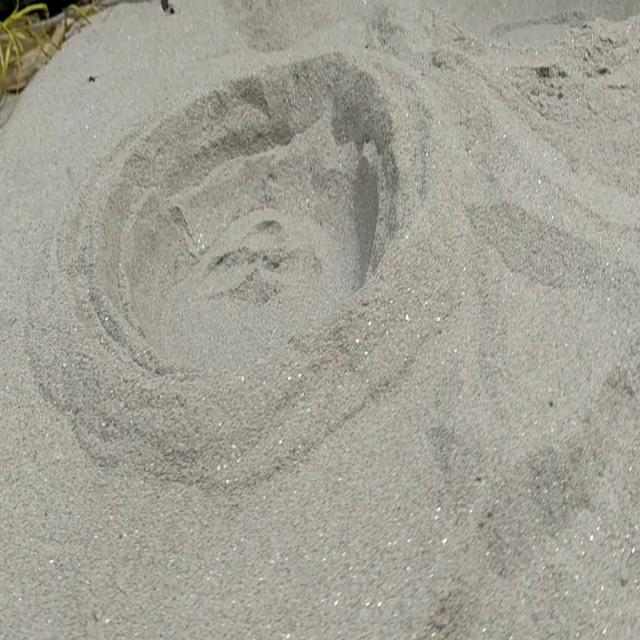
ISRO Total File/ISRO Robotics Challenge/ML Images/20_40Craters.v2i.yolov8/valid/images/frame_57_jpg.rf.93f1606f98c719a71131d59f7b032d25.jpg
