samim-robotix/IRoCU-2024-ISRO-Rover/ISRO Total File/ISRO Robotics Challenge/ML Images/20_40Craters.v2i.yolov8/valid/images/frame_75_jpg.rf.51f10fb425b23fcc2a3e807a93401cce.jpg

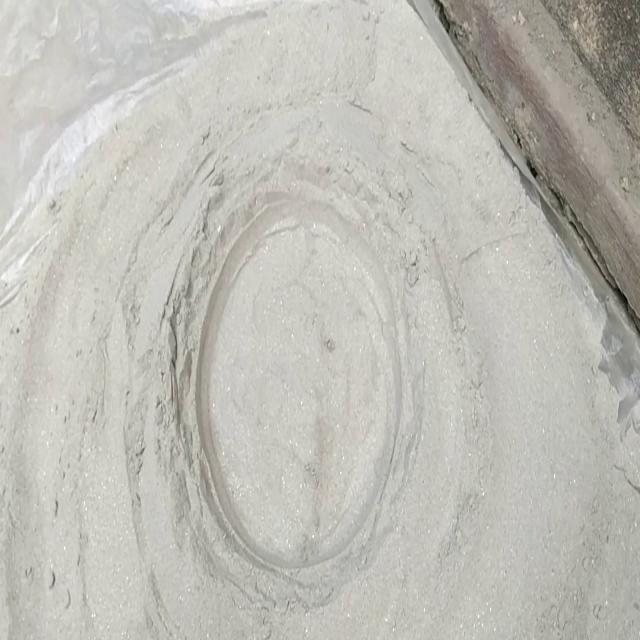
ISRO Total File/ISRO Robotics Challenge/ML Images/20_40Craters.v2i.yolov8/valid/images/frame_75_jpg.rf.51f10fb425b23fcc2a3e807a93401cce.jpg
