samim-robotix/IRoCU-2024-ISRO-Rover/ISRO Total File/ISRO Robotics Challenge/ML Images/20_40Craters.v2i.yolov8/valid/images/frame_78_jpg.rf.a7c25cd1e5da02aac2f0bc3ecab0f3ce.jpg

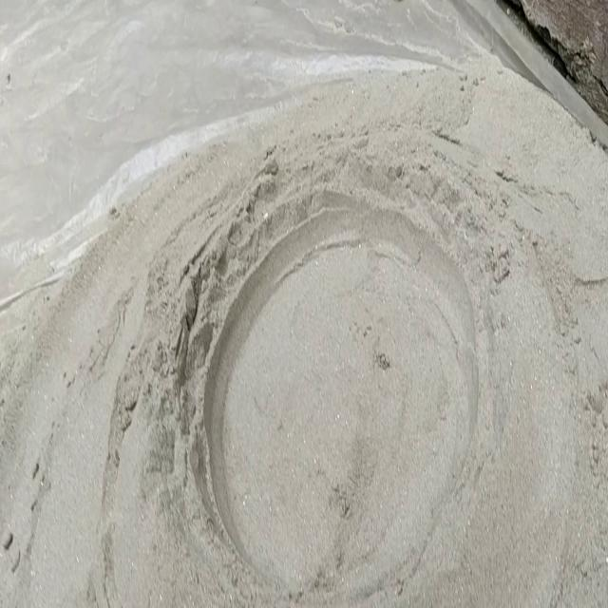
ISRO Total File/ISRO Robotics Challenge/ML Images/20_40Craters.v2i.yolov8/valid/images/frame_78_jpg.rf.a7c25cd1e5da02aac2f0bc3ecab0f3ce.jpg
