samim-robotix/IRoCU-2024-ISRO-Rover/ISRO Total File/ISRO Robotics Challenge/ML Images/20_40Craters.v2i.yolov8/valid/images/frame_79_jpg.rf.c63901935a1f01d035abdc1aa334992b.jpg

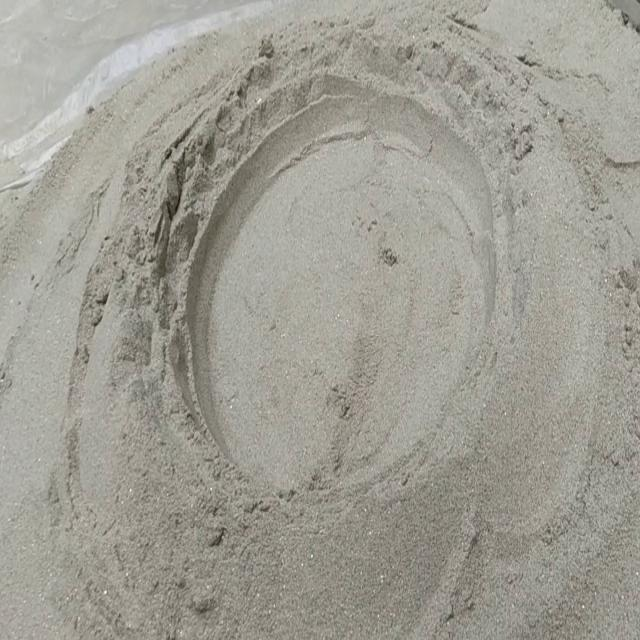
ISRO Total File/ISRO Robotics Challenge/ML Images/20_40Craters.v2i.yolov8/valid/images/frame_79_jpg.rf.c63901935a1f01d035abdc1aa334992b.jpg
