samim-robotix/IRoCU-2024-ISRO-Rover/ISRO Total File/ISRO Robotics Challenge/ML Images/20_40Craters.v2i.yolov8/valid/images/frame_82_jpg.rf.daf9e92e8d16757172b76886ac764654.jpg

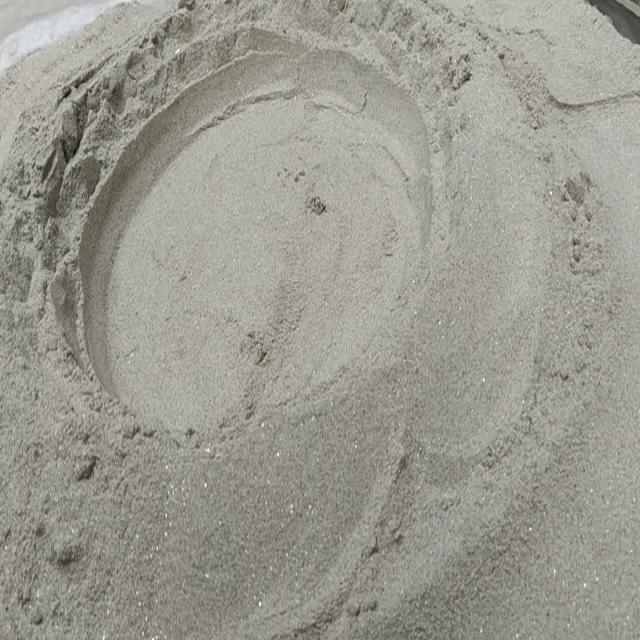
ISRO Total File/ISRO Robotics Challenge/ML Images/20_40Craters.v2i.yolov8/valid/images/frame_82_jpg.rf.daf9e92e8d16757172b76886ac764654.jpg
