samim-robotix/IRoCU-2024-ISRO-Rover/ISRO Total File/ISRO Robotics Challenge/ML Images/20_40Craters.v2i.yolov8/valid/images/frame_87_jpg.rf.393565ed081ba05aa5c6b54c0cd1e7cd.jpg

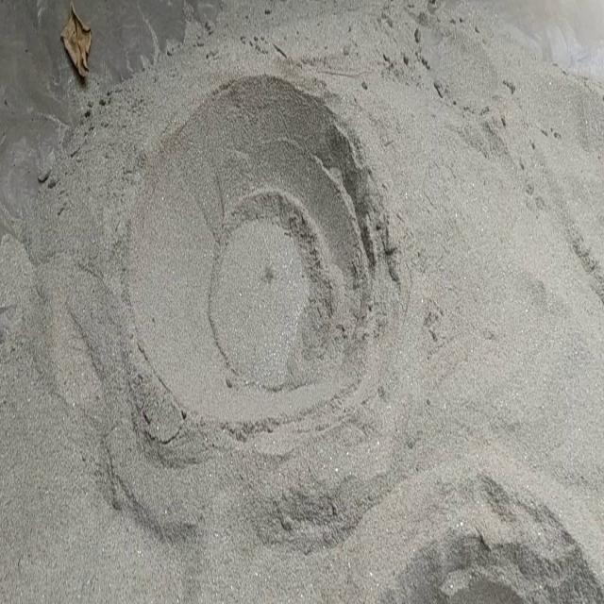
ISRO Total File/ISRO Robotics Challenge/ML Images/20_40Craters.v2i.yolov8/valid/images/frame_87_jpg.rf.393565ed081ba05aa5c6b54c0cd1e7cd.jpg
