samim-robotix/IRoCU-2024-ISRO-Rover/ISRO Total File/ISRO Robotics Challenge/ML Images/20_40Craters.v2i.yolov8/valid/images/frame_92_jpg.rf.01d093807f87a33678cef150a2ba1afc.jpg

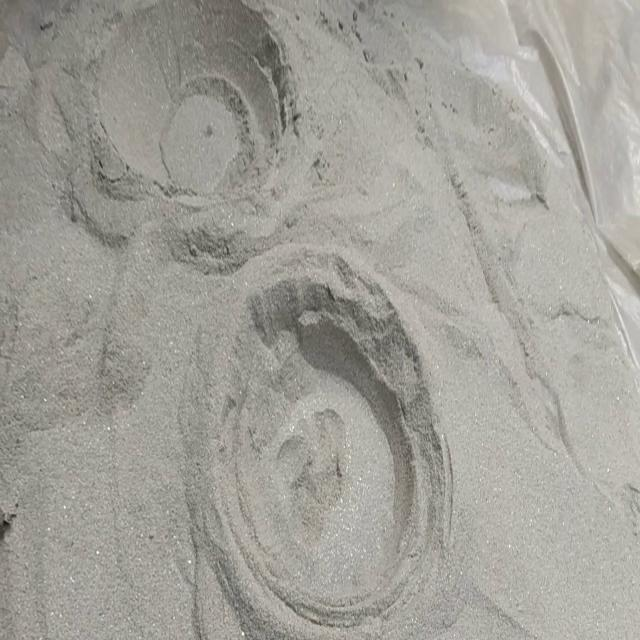
ISRO Total File/ISRO Robotics Challenge/ML Images/20_40Craters.v2i.yolov8/valid/images/frame_92_jpg.rf.01d093807f87a33678cef150a2ba1afc.jpg
