samim-robotix/IRoCU-2024-ISRO-Rover/ISRO Total File/ISRO Robotics Challenge/ML Images/20_40Craters.v2i.yolov8/valid/images/frame_99_jpg.rf.05140fdc88e68e8d5e7c7946fd0cb119.jpg

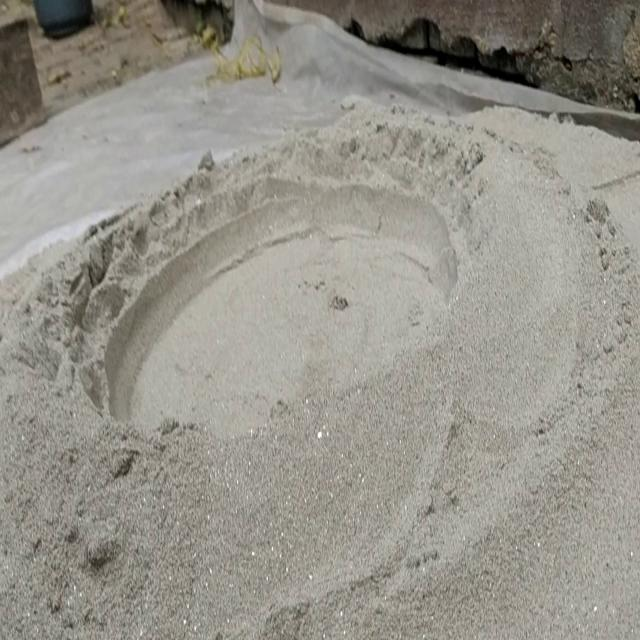
ISRO Total File/ISRO Robotics Challenge/ML Images/20_40Craters.v2i.yolov8/valid/images/frame_99_jpg.rf.05140fdc88e68e8d5e7c7946fd0cb119.jpg
