samim-robotix/IRoCU-2024-ISRO-Rover/ISRO Total File/ISRO Robotics Challenge/ML Images/20_40Craters.v2i.yolov8/valid/images/frame_104_jpg.rf.9ae2e81127c039883ac6e435107af33f.jpg

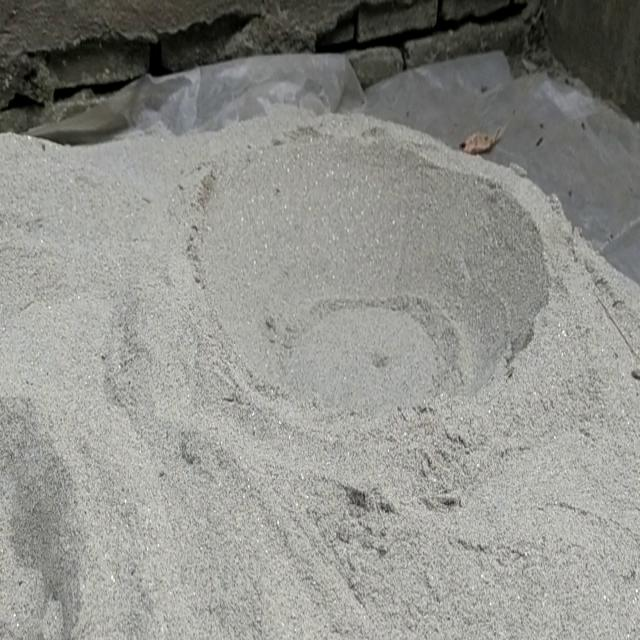
ISRO Total File/ISRO Robotics Challenge/ML Images/20_40Craters.v2i.yolov8/valid/images/frame_104_jpg.rf.9ae2e81127c039883ac6e435107af33f.jpg
