samim-robotix/IRoCU-2024-ISRO-Rover/ISRO Total File/ISRO Robotics Challenge/ML Images/20_40Craters.v2i.yolov8/valid/images/frame_105_jpg.rf.d6d9e8e9b47f6043ca831b5ad91ea921.jpg

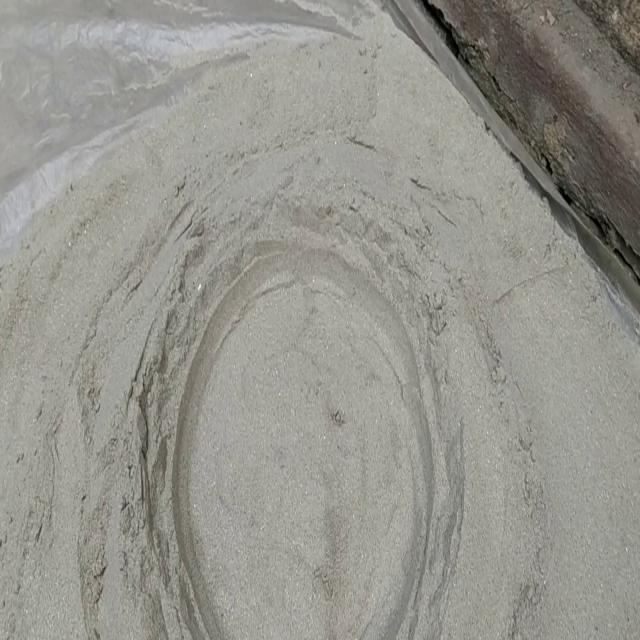
ISRO Total File/ISRO Robotics Challenge/ML Images/20_40Craters.v2i.yolov8/valid/images/frame_105_jpg.rf.d6d9e8e9b47f6043ca831b5ad91ea921.jpg
