samim-robotix/IRoCU-2024-ISRO-Rover/ISRO Total File/ISRO Robotics Challenge/ML Images/20_40Craters.v2i.yolov8/valid/images/frame_108_jpg.rf.b1ee0e7f21684331ad3e0f052290f1b8.jpg

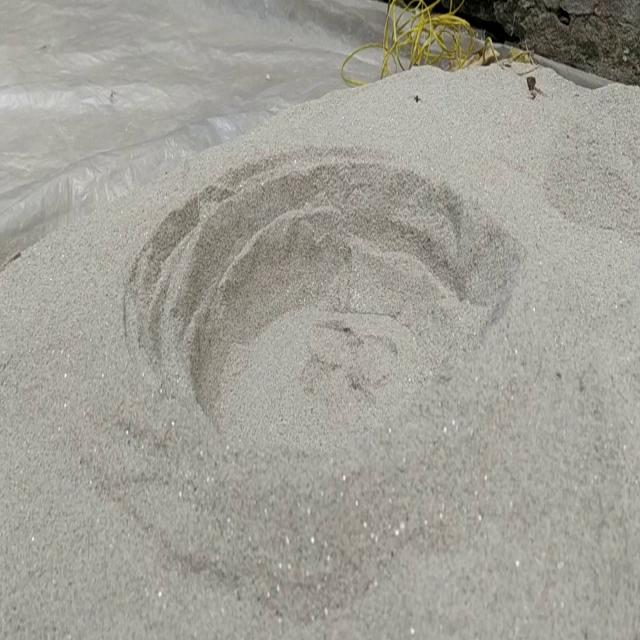
ISRO Total File/ISRO Robotics Challenge/ML Images/20_40Craters.v2i.yolov8/valid/images/frame_108_jpg.rf.b1ee0e7f21684331ad3e0f052290f1b8.jpg
