samim-robotix/IRoCU-2024-ISRO-Rover/ISRO Total File/ISRO Robotics Challenge/ML Images/20_40Craters.v2i.yolov8/valid/images/frame_127_jpg.rf.47b52c701239e405727ab3b69a9ca63c.jpg

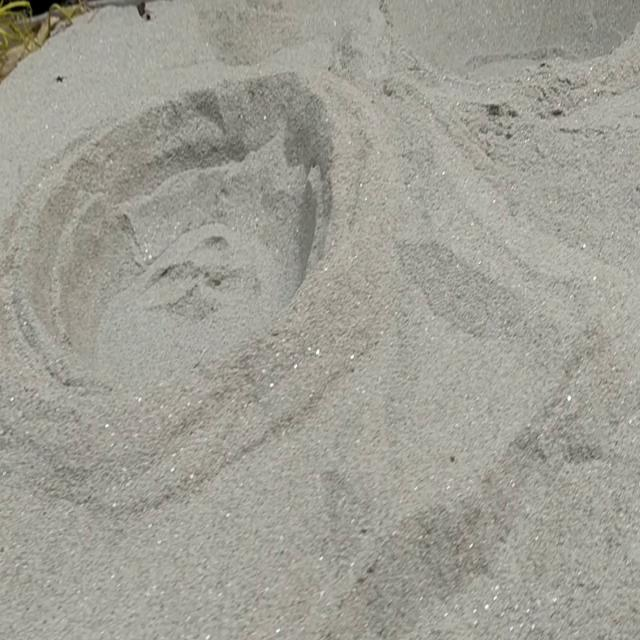
ISRO Total File/ISRO Robotics Challenge/ML Images/20_40Craters.v2i.yolov8/valid/images/frame_127_jpg.rf.47b52c701239e405727ab3b69a9ca63c.jpg
