samim-robotix/IRoCU-2024-ISRO-Rover/ISRO Total File/ISRO Robotics Challenge/ML Images/20_40Craters.v2i.yolov8/valid/images/frame_139_jpg.rf.aceb1fcfb4785dbdea2f3b7b8a7255c0.jpg

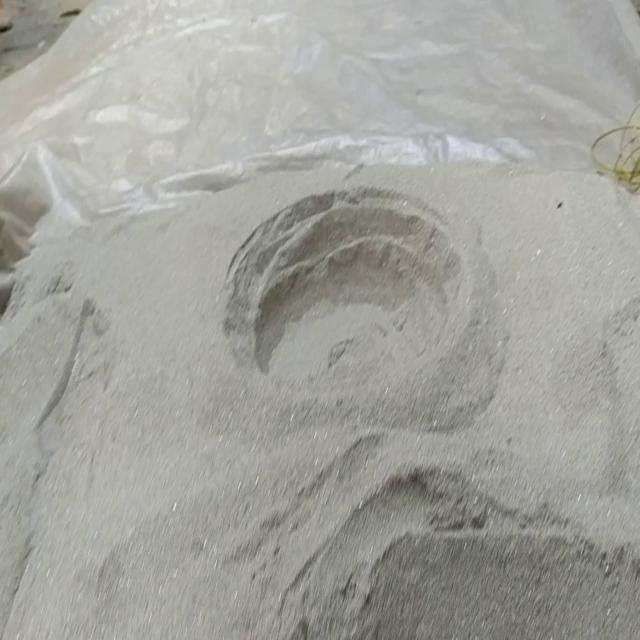
ISRO Total File/ISRO Robotics Challenge/ML Images/20_40Craters.v2i.yolov8/valid/images/frame_139_jpg.rf.aceb1fcfb4785dbdea2f3b7b8a7255c0.jpg
