samim-robotix/IRoCU-2024-ISRO-Rover/ISRO Total File/ISRO Robotics Challenge/ML Images/20_40Craters.v2i.yolov8/valid/images/frame_144_jpg.rf.2bd2aaf739ac835c689580035ae3eca1.jpg

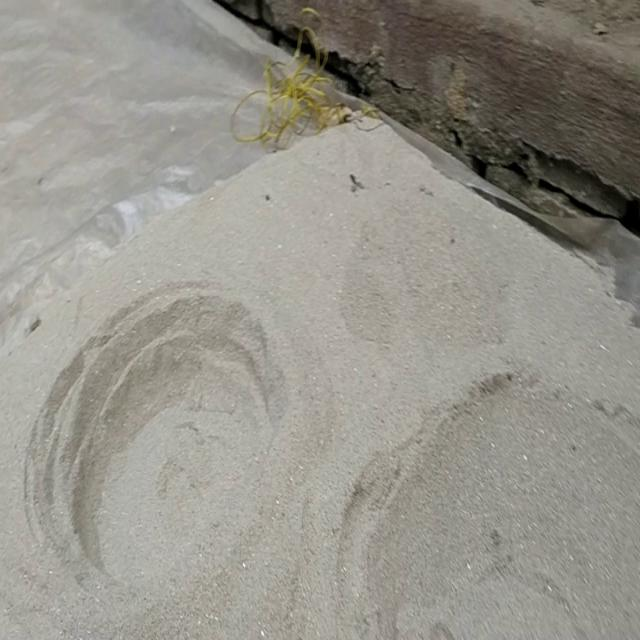
ISRO Total File/ISRO Robotics Challenge/ML Images/20_40Craters.v2i.yolov8/valid/images/frame_144_jpg.rf.2bd2aaf739ac835c689580035ae3eca1.jpg
