samim-robotix/IRoCU-2024-ISRO-Rover/ISRO Total File/ISRO Robotics Challenge/ML Images/20_40Craters.v2i.yolov8/valid/images/frame_147_jpg.rf.20ec984a3a53d7f930d4af329ee93c37.jpg

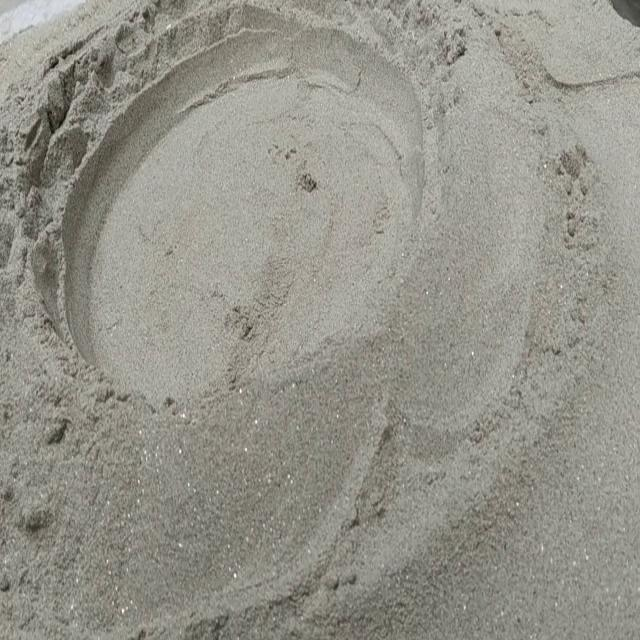
ISRO Total File/ISRO Robotics Challenge/ML Images/20_40Craters.v2i.yolov8/valid/images/frame_147_jpg.rf.20ec984a3a53d7f930d4af329ee93c37.jpg
