samim-robotix/IRoCU-2024-ISRO-Rover/ISRO Total File/ISRO Robotics Challenge/ML Images/20_40Craters.v2i.yolov8/valid/images/frame_148_jpg.rf.f3b6759beb35a5ae3310dc77cdf1f2a2.jpg

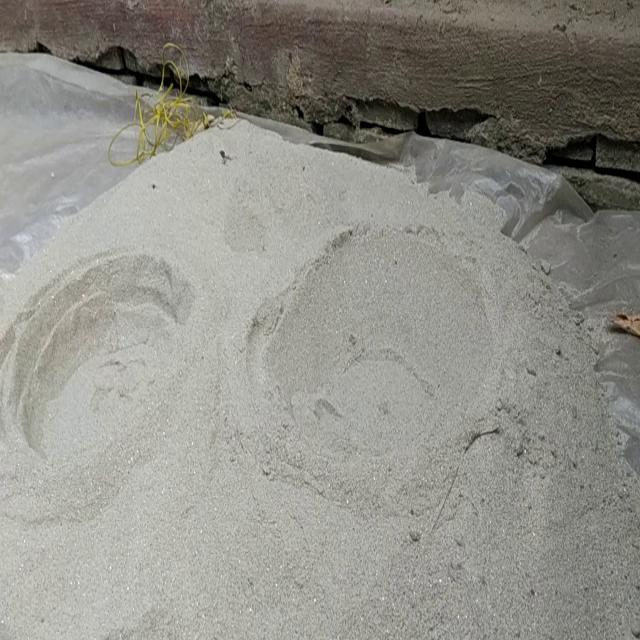
ISRO Total File/ISRO Robotics Challenge/ML Images/20_40Craters.v2i.yolov8/valid/images/frame_148_jpg.rf.f3b6759beb35a5ae3310dc77cdf1f2a2.jpg
