samim-robotix/IRoCU-2024-ISRO-Rover/ISRO Total File/ISRO Robotics Challenge/ML Images/20_40Craters.v2i.yolov8/valid/images/frame_154_jpg.rf.3a0c457bda682c21e72c783e0be0aa3d.jpg

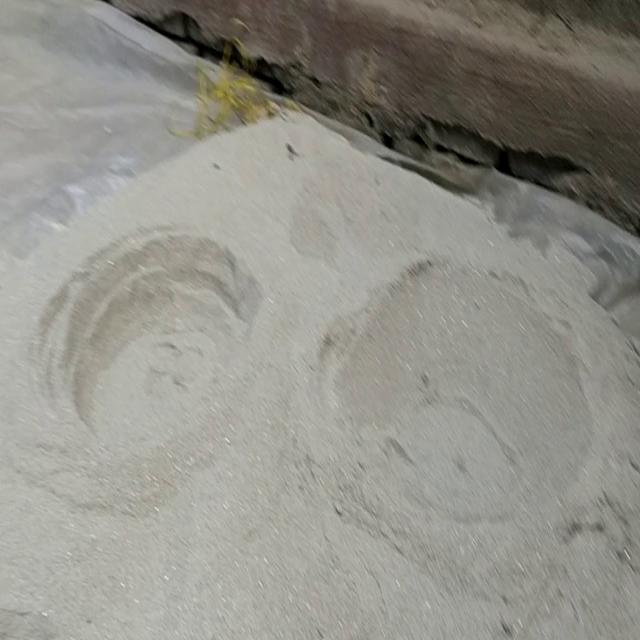
ISRO Total File/ISRO Robotics Challenge/ML Images/20_40Craters.v2i.yolov8/valid/images/frame_154_jpg.rf.3a0c457bda682c21e72c783e0be0aa3d.jpg
