samim-robotix/IRoCU-2024-ISRO-Rover/ISRO Total File/ISRO Robotics Challenge/ML Images/20_40Craters.v2i.yolov8/valid/images/frame_159_jpg.rf.2dba0fa8bd8965e56d932e8f21e22e2c.jpg

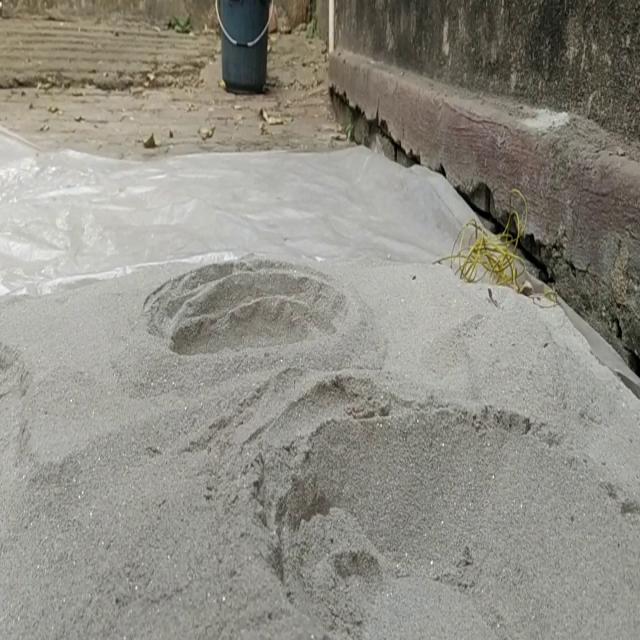
ISRO Total File/ISRO Robotics Challenge/ML Images/20_40Craters.v2i.yolov8/valid/images/frame_159_jpg.rf.2dba0fa8bd8965e56d932e8f21e22e2c.jpg
