samim-robotix/IRoCU-2024-ISRO-Rover/ISRO Total File/ISRO Robotics Challenge/ML Images/20_40Craters.v2i.yolov8/valid/images/frame_166_jpg.rf.cfc1435ee6b97ab140554c725cc1696a.jpg

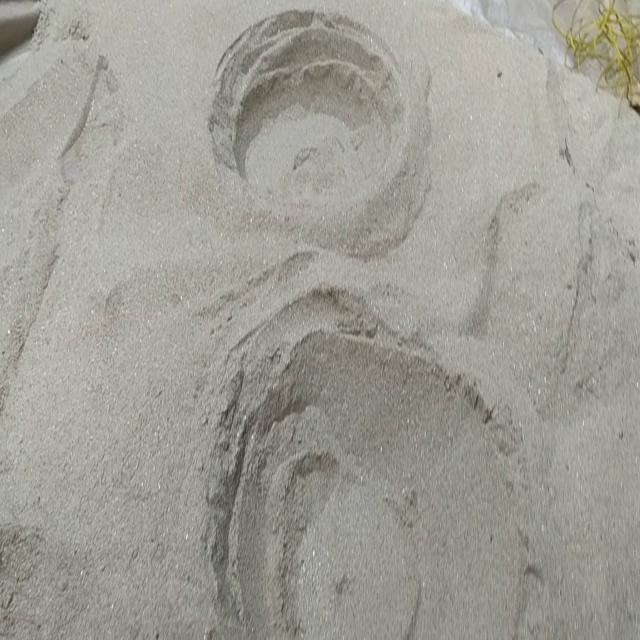
ISRO Total File/ISRO Robotics Challenge/ML Images/20_40Craters.v2i.yolov8/valid/images/frame_166_jpg.rf.cfc1435ee6b97ab140554c725cc1696a.jpg
