samim-robotix/IRoCU-2024-ISRO-Rover/ISRO Total File/ISRO Robotics Challenge/ML Images/20_40Craters.v2i.yolov8/valid/images/frame_169_jpg.rf.c75c79bab8d35a848754456a6d10cd5d.jpg

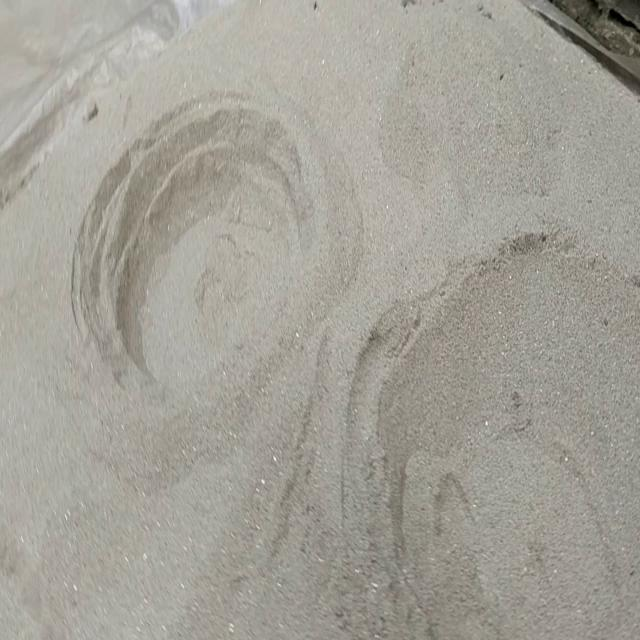
ISRO Total File/ISRO Robotics Challenge/ML Images/20_40Craters.v2i.yolov8/valid/images/frame_169_jpg.rf.c75c79bab8d35a848754456a6d10cd5d.jpg
