samim-robotix/IRoCU-2024-ISRO-Rover/ISRO Total File/ISRO Robotics Challenge/ML Images/20_40Craters.v2i.yolov8/valid/images/frame_173_jpg.rf.ced0bdbae4f27bad622915199a909a66.jpg

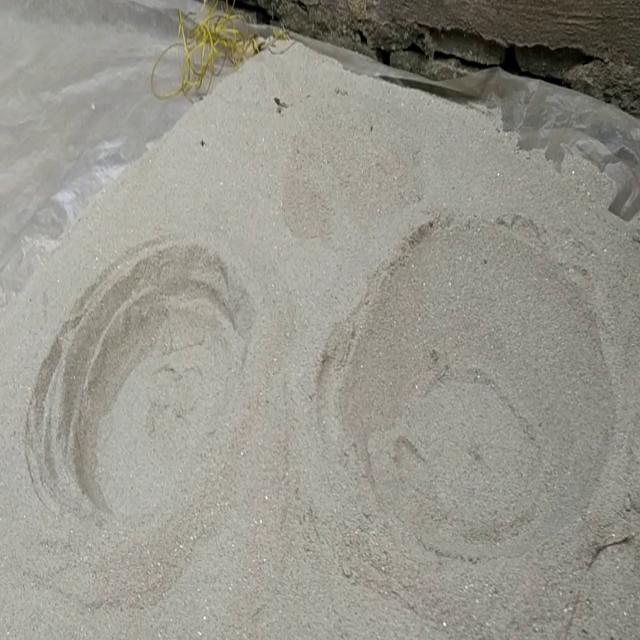
ISRO Total File/ISRO Robotics Challenge/ML Images/20_40Craters.v2i.yolov8/valid/images/frame_173_jpg.rf.ced0bdbae4f27bad622915199a909a66.jpg
