samim-robotix/IRoCU-2024-ISRO-Rover/ISRO Total File/ISRO Robotics Challenge/ML Images/20_40Craters.v2i.yolov8/valid/images/frame_176_jpg.rf.59cde87a840ab7fab69db6559b27eff0.jpg

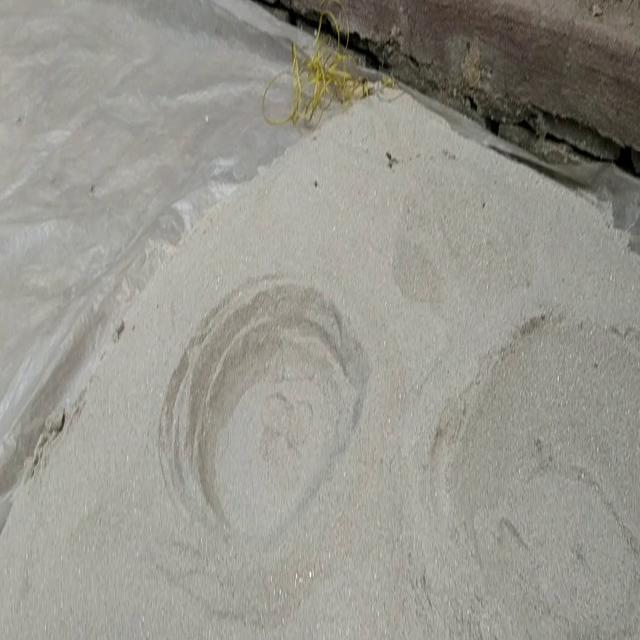
ISRO Total File/ISRO Robotics Challenge/ML Images/20_40Craters.v2i.yolov8/valid/images/frame_176_jpg.rf.59cde87a840ab7fab69db6559b27eff0.jpg
