samim-robotix/IRoCU-2024-ISRO-Rover/ISRO Total File/ISRO Robotics Challenge/ML Images/20_40Craters.v2i.yolov8/valid/images/frame_180_jpg.rf.4d55e63b2dabb1412b8d55a17c7eb3f3.jpg

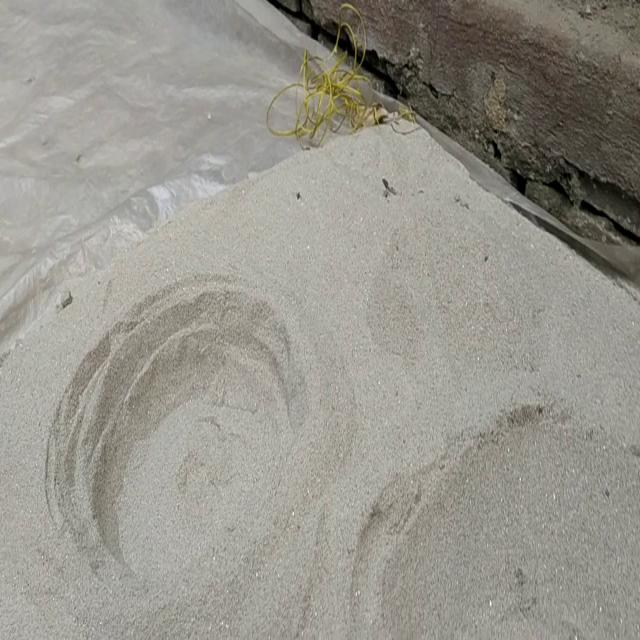
ISRO Total File/ISRO Robotics Challenge/ML Images/20_40Craters.v2i.yolov8/valid/images/frame_180_jpg.rf.4d55e63b2dabb1412b8d55a17c7eb3f3.jpg
