samim-robotix/IRoCU-2024-ISRO-Rover/ISRO Total File/ISRO Robotics Challenge/ML Images/20_40Craters.v2i.yolov8/valid/images/frame_181_jpg.rf.d2f000fa86070397a0b80a28a985409b.jpg

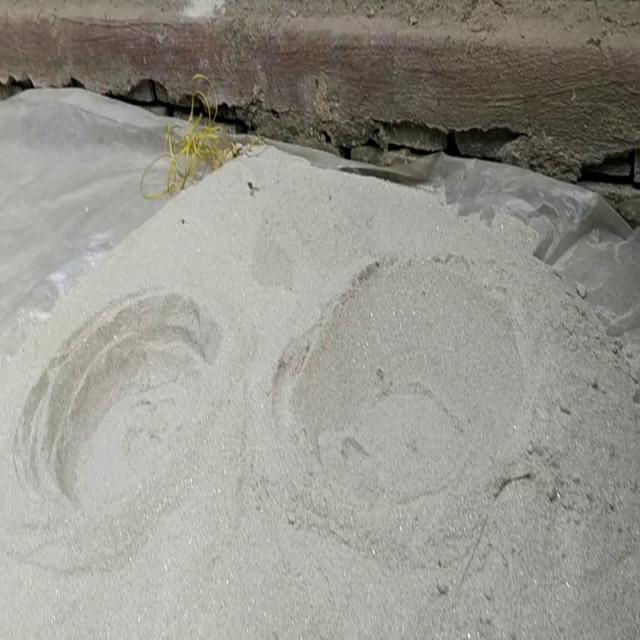
ISRO Total File/ISRO Robotics Challenge/ML Images/20_40Craters.v2i.yolov8/valid/images/frame_181_jpg.rf.d2f000fa86070397a0b80a28a985409b.jpg
