samim-robotix/IRoCU-2024-ISRO-Rover/ISRO Total File/ISRO Robotics Challenge/ML Images/20_40Craters.v2i.yolov8/valid/images/frame_183_jpg.rf.b1ff9fa90d9352ecca88f84ef4094f80.jpg

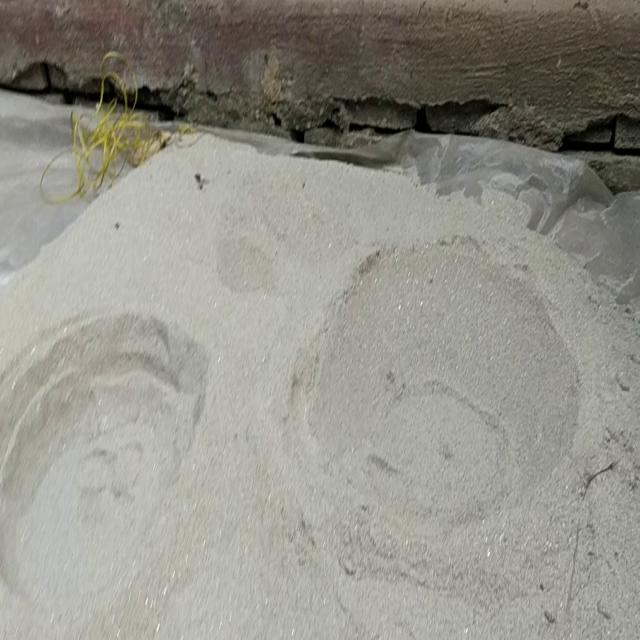
ISRO Total File/ISRO Robotics Challenge/ML Images/20_40Craters.v2i.yolov8/valid/images/frame_183_jpg.rf.b1ff9fa90d9352ecca88f84ef4094f80.jpg
