samim-robotix/IRoCU-2024-ISRO-Rover/ISRO Total File/ISRO Robotics Challenge/ML Images/20_40Craters.v2i.yolov8/valid/images/frame_185_jpg.rf.af2d7cf883eda0bb767288c4276e7411.jpg

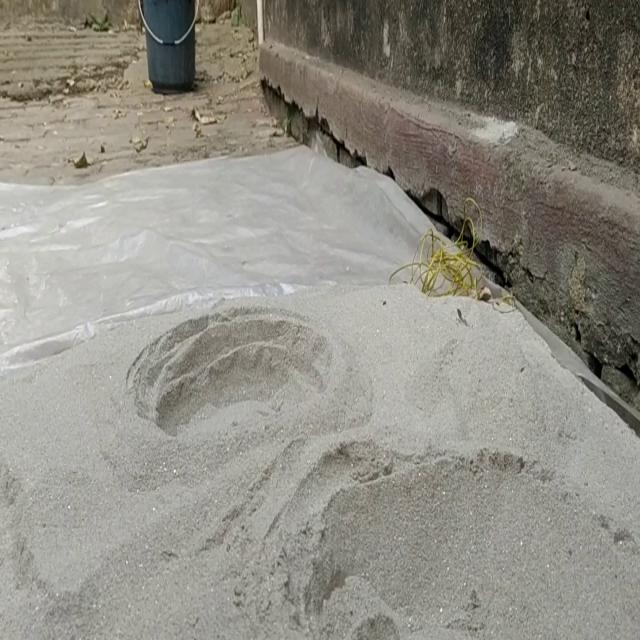
ISRO Total File/ISRO Robotics Challenge/ML Images/20_40Craters.v2i.yolov8/valid/images/frame_185_jpg.rf.af2d7cf883eda0bb767288c4276e7411.jpg
