samim-robotix/IRoCU-2024-ISRO-Rover/ISRO Total File/ISRO Robotics Challenge/ML Images/20_40Craters.v2i.yolov8/valid/images/IMG_20240413_163314_jpg.rf.ff69f6687d99125ef99c7f3812cc13fc.jpg

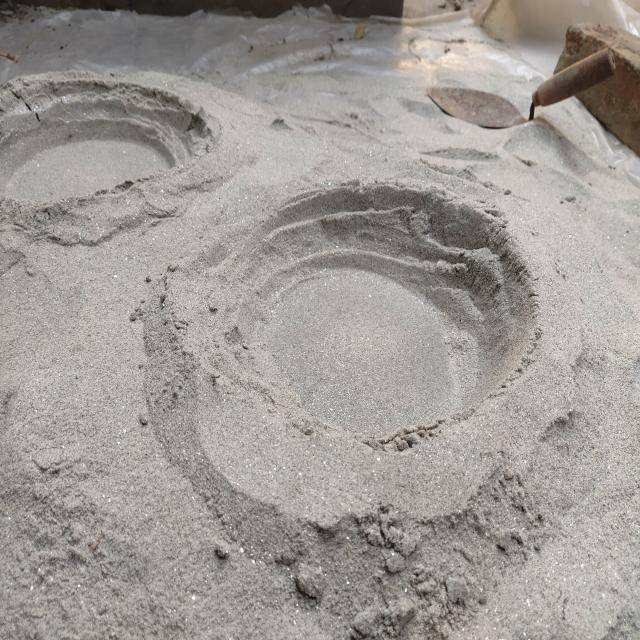
ISRO Total File/ISRO Robotics Challenge/ML Images/20_40Craters.v2i.yolov8/valid/images/IMG_20240413_163314_jpg.rf.ff69f6687d99125ef99c7f3812cc13fc.jpg
