samim-robotix/IRoCU-2024-ISRO-Rover/ISRO Total File/ISRO Robotics Challenge/ML Images/20_40Craters.v2i.yolov8/valid/images/IMG_20240413_163339_jpg.rf.6c94660e89682dea70ec29ece08c84ce.jpg

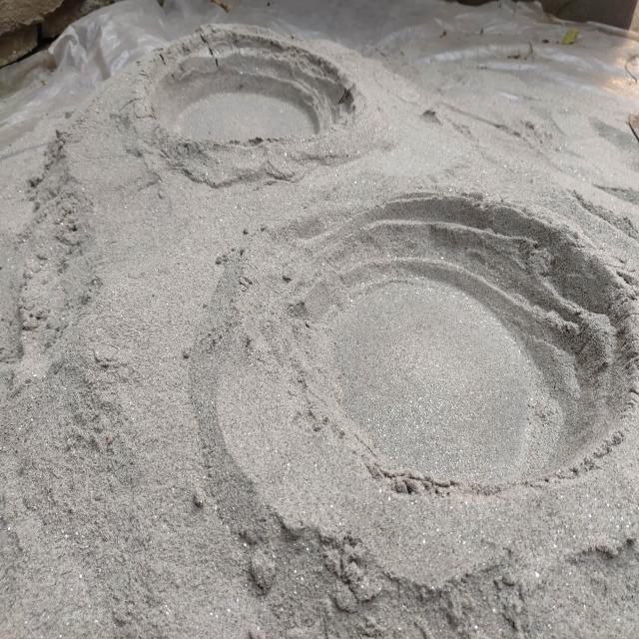
ISRO Total File/ISRO Robotics Challenge/ML Images/20_40Craters.v2i.yolov8/valid/images/IMG_20240413_163339_jpg.rf.6c94660e89682dea70ec29ece08c84ce.jpg
