samim-robotix/IRoCU-2024-ISRO-Rover/ISRO Total File/ISRO Robotics Challenge/ML Images/20_40Craters.v2i.yolov8/valid/images/IMG_20240413_163426_jpg.rf.a5046a0e9176494a9a883bcd8753f503.jpg

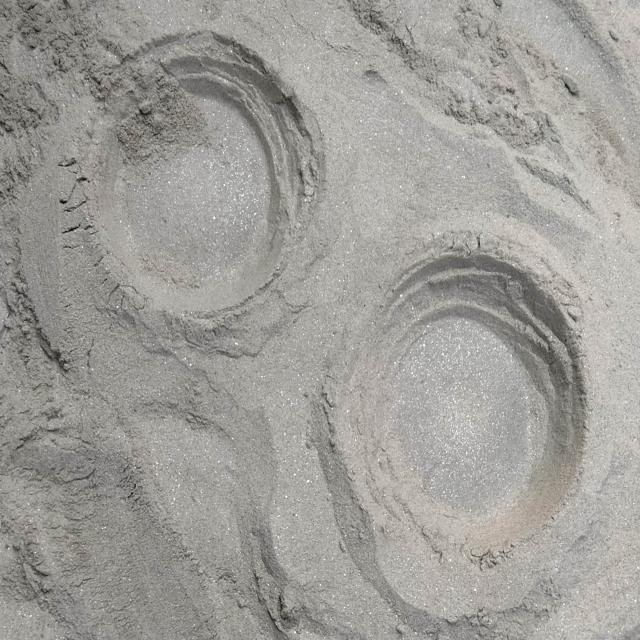
ISRO Total File/ISRO Robotics Challenge/ML Images/20_40Craters.v2i.yolov8/valid/images/IMG_20240413_163426_jpg.rf.a5046a0e9176494a9a883bcd8753f503.jpg
