samim-robotix/IRoCU-2024-ISRO-Rover/ISRO Total File/ISRO Robotics Challenge/ML Images/20_40Craters.v2i.yolov8/valid/images/IMG_20240413_163514_jpg.rf.fbb8fa3e9f49fa1f0e001a1dd062ca19.jpg

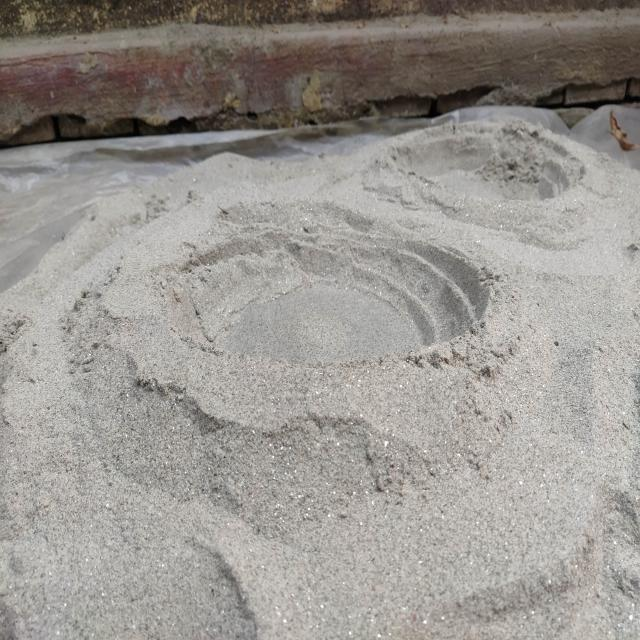
ISRO Total File/ISRO Robotics Challenge/ML Images/20_40Craters.v2i.yolov8/valid/images/IMG_20240413_163514_jpg.rf.fbb8fa3e9f49fa1f0e001a1dd062ca19.jpg
