samim-robotix/IRoCU-2024-ISRO-Rover/ISRO Total File/ISRO Robotics Challenge/ML Images/20_40Craters.v2i.yolov8/valid/images/IMG_20240413_164128_jpg.rf.69066e8d13748bf5ef8833f41b7f28c2.jpg

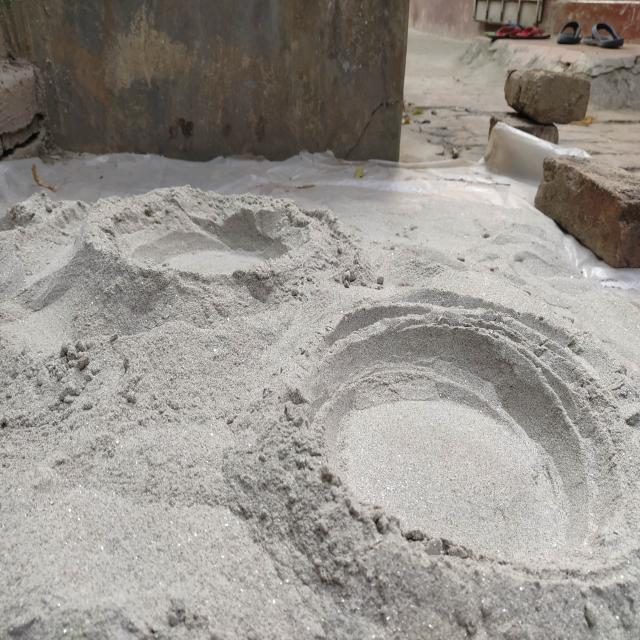
ISRO Total File/ISRO Robotics Challenge/ML Images/20_40Craters.v2i.yolov8/valid/images/IMG_20240413_164128_jpg.rf.69066e8d13748bf5ef8833f41b7f28c2.jpg
