samim-robotix/IRoCU-2024-ISRO-Rover/ISRO Total File/ISRO Robotics Challenge/ML Images/20_40Craters.v2i.yolov8/valid/images/IMG_20240413_164129_jpg.rf.9d959480151e8a1fd7beb08fe64e17fe.jpg

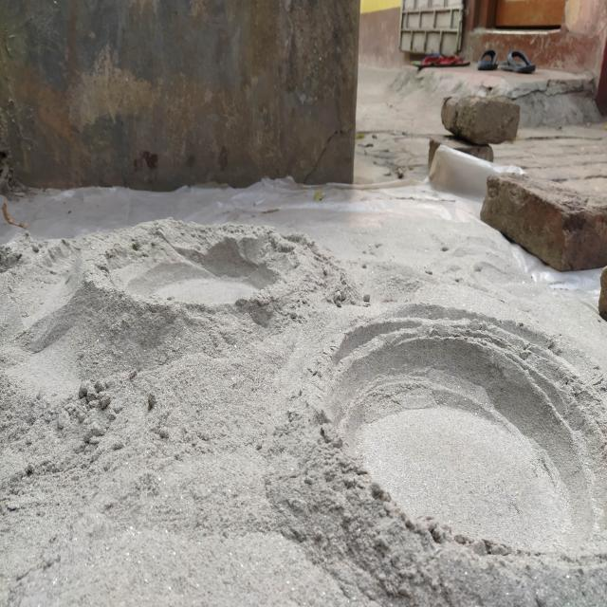
ISRO Total File/ISRO Robotics Challenge/ML Images/20_40Craters.v2i.yolov8/valid/images/IMG_20240413_164129_jpg.rf.9d959480151e8a1fd7beb08fe64e17fe.jpg
