samim-robotix/IRoCU-2024-ISRO-Rover/ISRO Total File/ISRO Robotics Challenge/ML Images/20_40Craters.v2i.yolov8/valid/images/IMG_20240413_164140_jpg.rf.2fb11c65ebeecbe1f4c4b8adee278386.jpg

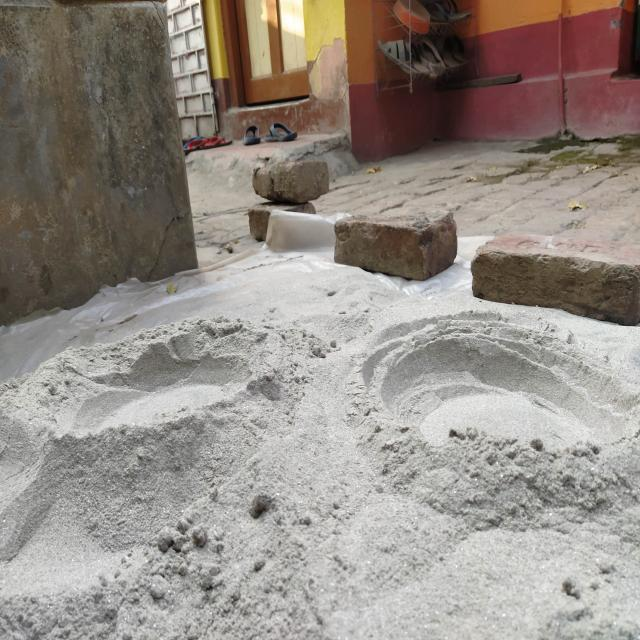
ISRO Total File/ISRO Robotics Challenge/ML Images/20_40Craters.v2i.yolov8/valid/images/IMG_20240413_164140_jpg.rf.2fb11c65ebeecbe1f4c4b8adee278386.jpg
