samim-robotix/IRoCU-2024-ISRO-Rover/ISRO Total File/ISRO Robotics Challenge/ML Images/20_40Craters.v2i.yolov8/valid/images/IMG_20240413_164243_jpg.rf.de9690627a3820f2a5f9503eec7deedf.jpg

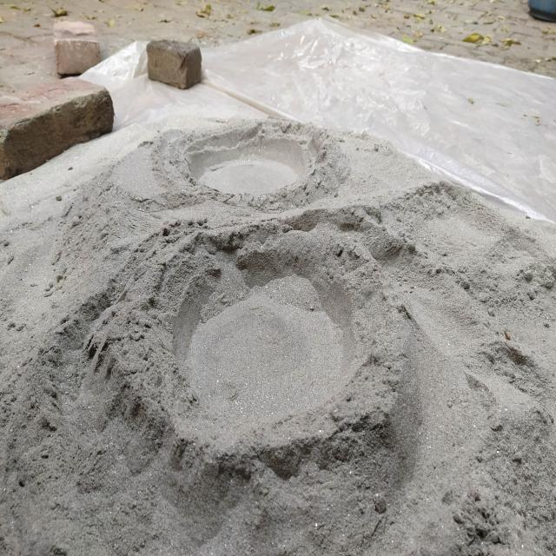
ISRO Total File/ISRO Robotics Challenge/ML Images/20_40Craters.v2i.yolov8/valid/images/IMG_20240413_164243_jpg.rf.de9690627a3820f2a5f9503eec7deedf.jpg
