samim-robotix/IRoCU-2024-ISRO-Rover/ISRO Total File/ISRO Robotics Challenge/ML Images/20_40Craters.v2i.yolov8/valid/images/IMG_20240413_164309_jpg.rf.d2669d3ab9257b441cc941f29dba0e70.jpg

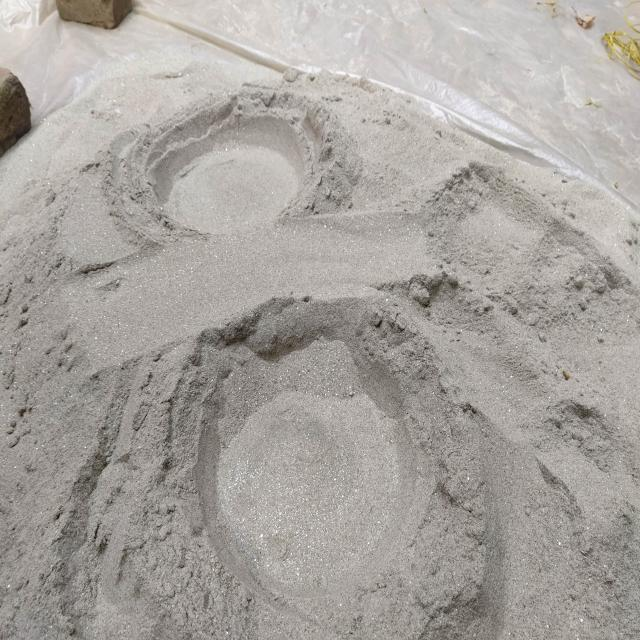
ISRO Total File/ISRO Robotics Challenge/ML Images/20_40Craters.v2i.yolov8/valid/images/IMG_20240413_164309_jpg.rf.d2669d3ab9257b441cc941f29dba0e70.jpg
