samim-robotix/IRoCU-2024-ISRO-Rover/ISRO Total File/ISRO Robotics Challenge/ML Images/20_40Craters.v2i.yolov8/valid/images/IMG_20240413_164528_jpg.rf.36ff515d4278af4d65cafb5d9ccbec8b.jpg

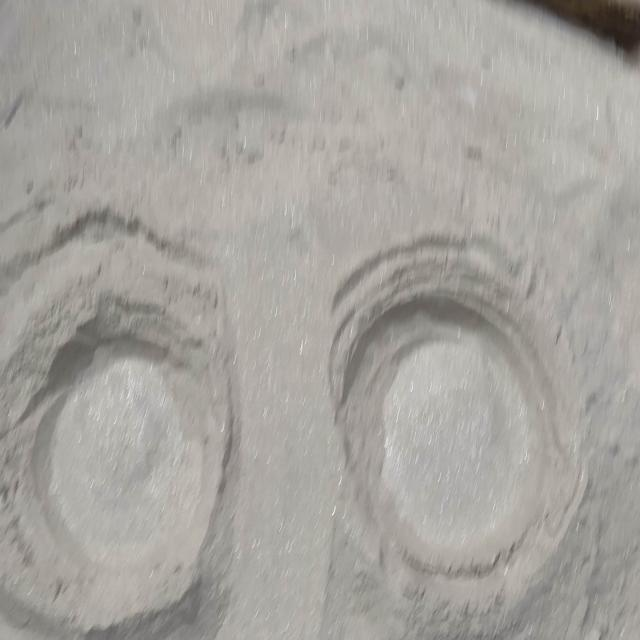
ISRO Total File/ISRO Robotics Challenge/ML Images/20_40Craters.v2i.yolov8/valid/images/IMG_20240413_164528_jpg.rf.36ff515d4278af4d65cafb5d9ccbec8b.jpg
