samim-robotix/IRoCU-2024-ISRO-Rover/ISRO Total File/ISRO Robotics Challenge/ML Images/20_40Craters.v2i.yolov8/valid/images/IMG_20240413_164614_jpg.rf.bc44d34c3add04e42779a9fd4d958b71.jpg

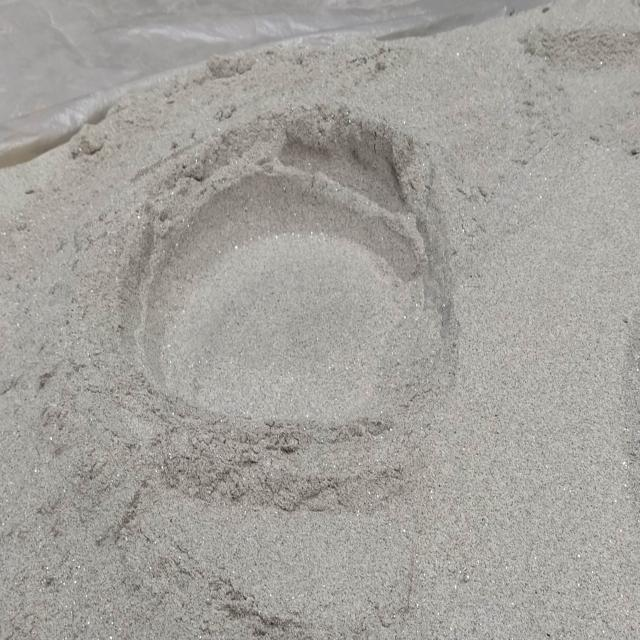
ISRO Total File/ISRO Robotics Challenge/ML Images/20_40Craters.v2i.yolov8/valid/images/IMG_20240413_164614_jpg.rf.bc44d34c3add04e42779a9fd4d958b71.jpg
