samim-robotix/IRoCU-2024-ISRO-Rover/ISRO Total File/ISRO Robotics Challenge/ML Images/20_40Craters.v2i.yolov8/valid/images/IMG_20240413_164622_jpg.rf.241ca6f788b3053a85f225df5cb3836d.jpg

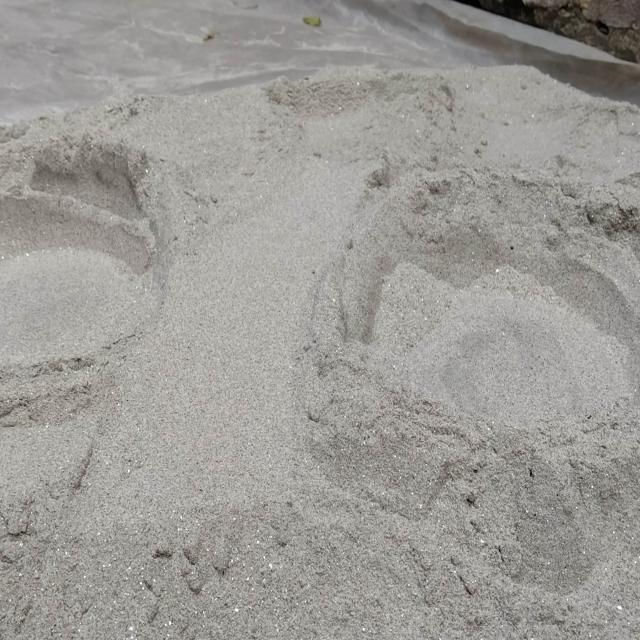
ISRO Total File/ISRO Robotics Challenge/ML Images/20_40Craters.v2i.yolov8/valid/images/IMG_20240413_164622_jpg.rf.241ca6f788b3053a85f225df5cb3836d.jpg
