samim-robotix/IRoCU-2024-ISRO-Rover/ISRO Total File/ISRO Robotics Challenge/ML Images/20_40Craters.v2i.yolov8/valid/images/IMG_20240413_164639_jpg.rf.1d1e5b86984272add638e2b1b283b51a.jpg

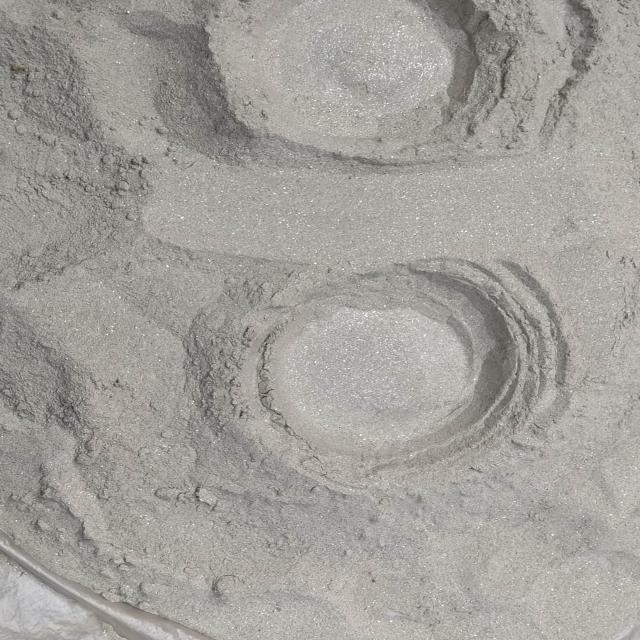
ISRO Total File/ISRO Robotics Challenge/ML Images/20_40Craters.v2i.yolov8/valid/images/IMG_20240413_164639_jpg.rf.1d1e5b86984272add638e2b1b283b51a.jpg
