samim-robotix/IRoCU-2024-ISRO-Rover/ISRO Total File/ISRO Robotics Challenge/ML Images/20_40Craters.v2i.yolov8/valid/images/IMG_20240413_164653_jpg.rf.0acf46fa053ed0f6849593cd6d18d2d8.jpg

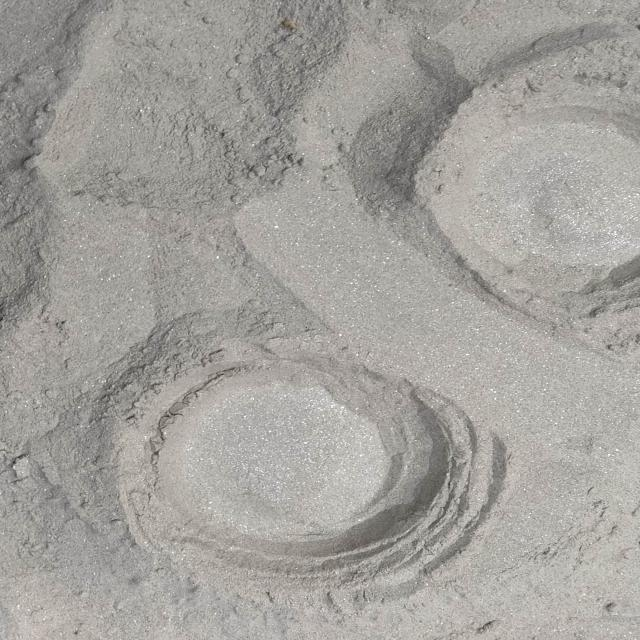
ISRO Total File/ISRO Robotics Challenge/ML Images/20_40Craters.v2i.yolov8/valid/images/IMG_20240413_164653_jpg.rf.0acf46fa053ed0f6849593cd6d18d2d8.jpg
