samim-robotix/IRoCU-2024-ISRO-Rover/ISRO Total File/ISRO Robotics Challenge/ML Images/20_40Craters.v2i.yolov8/valid/images/IMG_20240413_164725_jpg.rf.725b4a7a84d728971c7c4aef6179a669.jpg

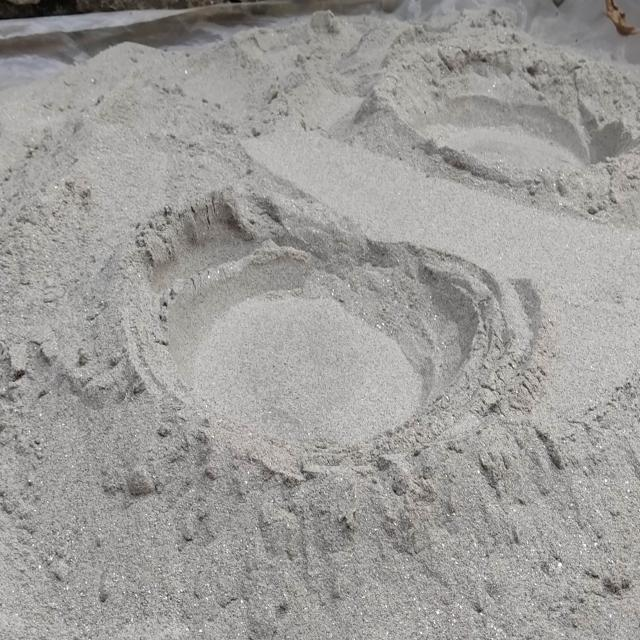
ISRO Total File/ISRO Robotics Challenge/ML Images/20_40Craters.v2i.yolov8/valid/images/IMG_20240413_164725_jpg.rf.725b4a7a84d728971c7c4aef6179a669.jpg
