samim-robotix/IRoCU-2024-ISRO-Rover/ISRO Total File/ISRO Robotics Challenge/ML Images/20_40Craters.v2i.yolov8/valid/images/IMG_20240413_164829_jpg.rf.cab28a98d6eb1e9c748473c5926953ee.jpg

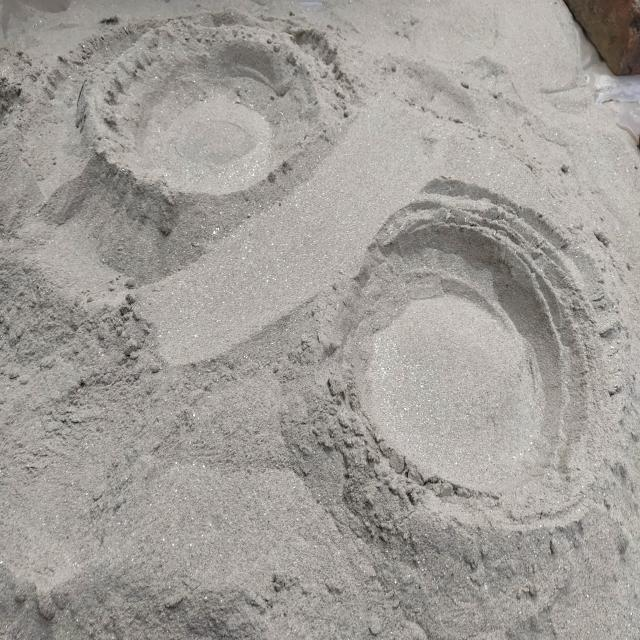
ISRO Total File/ISRO Robotics Challenge/ML Images/20_40Craters.v2i.yolov8/valid/images/IMG_20240413_164829_jpg.rf.cab28a98d6eb1e9c748473c5926953ee.jpg
