samim-robotix/IRoCU-2024-ISRO-Rover/ISRO Total File/ISRO Robotics Challenge/ML Images/20_40Craters.v2i.yolov8/valid/images/IMG_20240413_165030_jpg.rf.bbb3314a0fd515dec545e74a01ace980.jpg

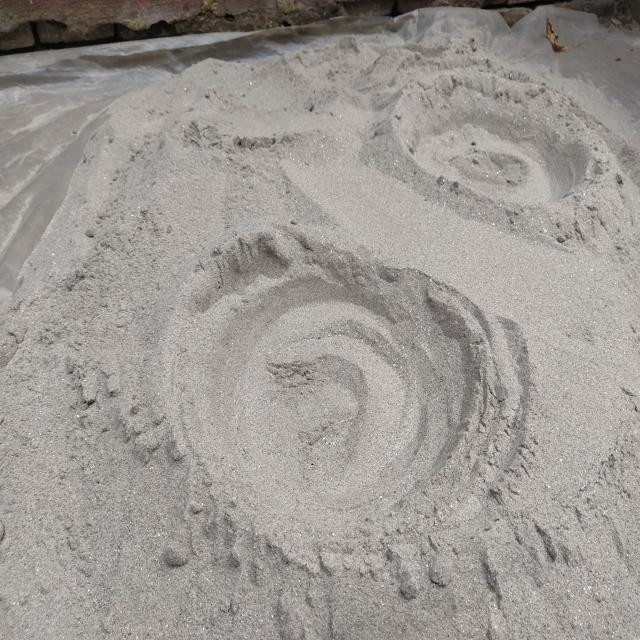
ISRO Total File/ISRO Robotics Challenge/ML Images/20_40Craters.v2i.yolov8/valid/images/IMG_20240413_165030_jpg.rf.bbb3314a0fd515dec545e74a01ace980.jpg
