samim-robotix/IRoCU-2024-ISRO-Rover/ISRO Total File/ISRO Robotics Challenge/ML Images/20_40Craters.v2i.yolov8/valid/images/IMG_20240413_165135_jpg.rf.79d9f88d471e45bdd934fb70b2819812.jpg

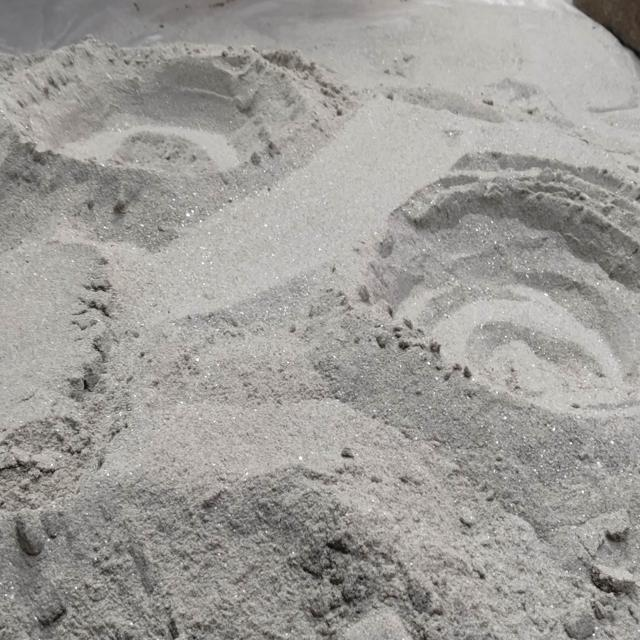
ISRO Total File/ISRO Robotics Challenge/ML Images/20_40Craters.v2i.yolov8/valid/images/IMG_20240413_165135_jpg.rf.79d9f88d471e45bdd934fb70b2819812.jpg
