samim-robotix/IRoCU-2024-ISRO-Rover/ISRO Total File/ISRO Robotics Challenge/ML Images/20_40Craters.v2i.yolov8/valid/images/IMG_20240413_165211_jpg.rf.d4ad13d6372beb247c30577bb7c3d29d.jpg

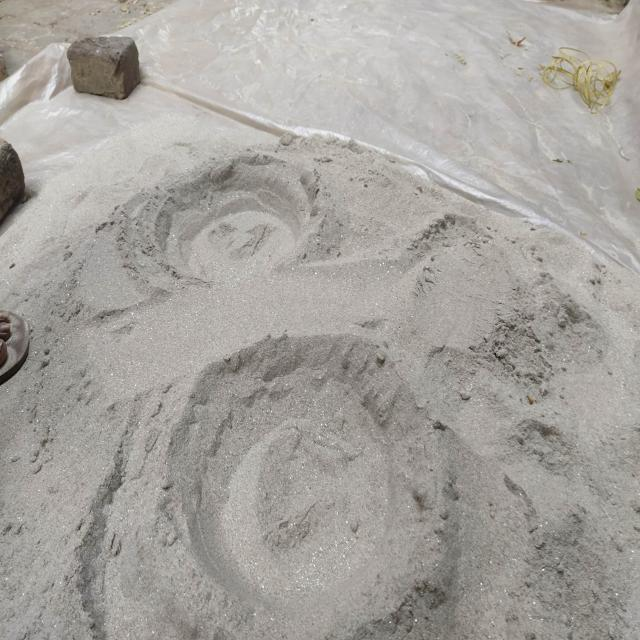
ISRO Total File/ISRO Robotics Challenge/ML Images/20_40Craters.v2i.yolov8/valid/images/IMG_20240413_165211_jpg.rf.d4ad13d6372beb247c30577bb7c3d29d.jpg
