samim-robotix/IRoCU-2024-ISRO-Rover/ISRO Total File/ISRO Robotics Challenge/ML Images/20_40Craters.v2i.yolov8/valid/images/IMG_20240413_165214_jpg.rf.a67ef12a4416668218bb5440ccff308a.jpg

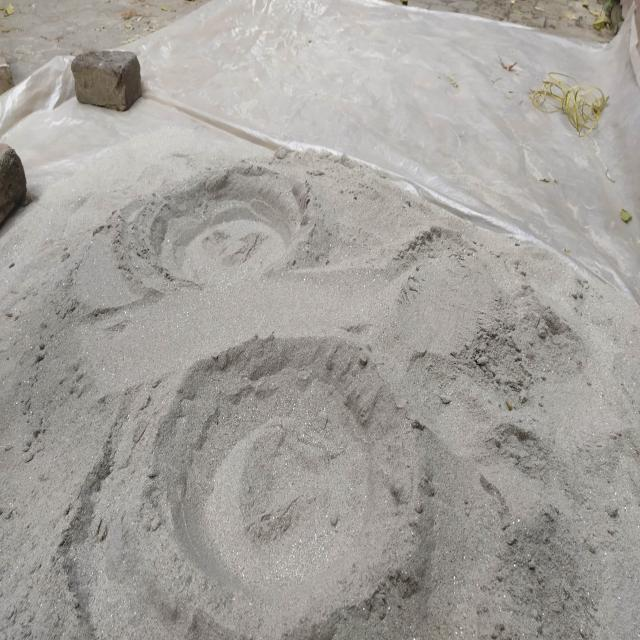
ISRO Total File/ISRO Robotics Challenge/ML Images/20_40Craters.v2i.yolov8/valid/images/IMG_20240413_165214_jpg.rf.a67ef12a4416668218bb5440ccff308a.jpg
