samim-robotix/IRoCU-2024-ISRO-Rover/ISRO Total File/ISRO Robotics Challenge/ML Images/20_40Craters.v2i.yolov8/valid/images/IMG_20240413_170524_jpg.rf.a87111198c95b79ca978d71c9e3217d8.jpg

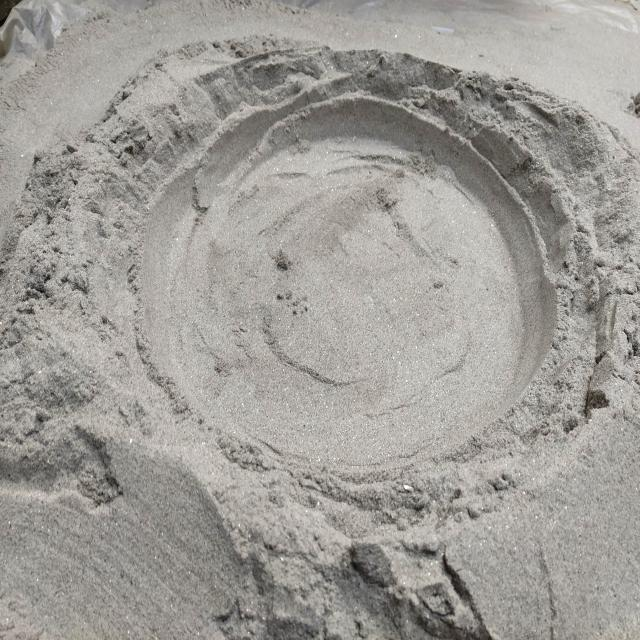
ISRO Total File/ISRO Robotics Challenge/ML Images/20_40Craters.v2i.yolov8/valid/images/IMG_20240413_170524_jpg.rf.a87111198c95b79ca978d71c9e3217d8.jpg
