samim-robotix/IRoCU-2024-ISRO-Rover/ISRO Total File/ISRO Robotics Challenge/ML Images/20_40Craters.v2i.yolov8/valid/images/IMG_20240413_170556_jpg.rf.2ea6eb63d1d5a24202387d17405c8859.jpg

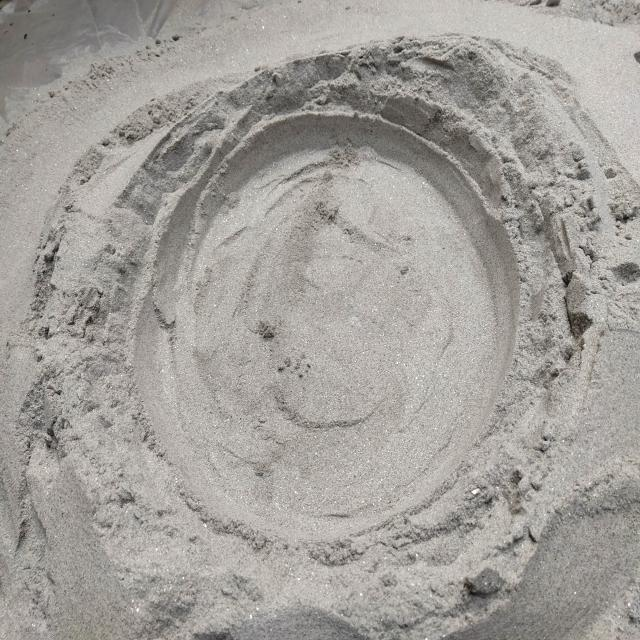
ISRO Total File/ISRO Robotics Challenge/ML Images/20_40Craters.v2i.yolov8/valid/images/IMG_20240413_170556_jpg.rf.2ea6eb63d1d5a24202387d17405c8859.jpg
