samim-robotix/IRoCU-2024-ISRO-Rover/ISRO Total File/ISRO Robotics Challenge/ML Images/20_40Craters.v2i.yolov8/valid/images/IMG_20240413_170606_jpg.rf.ed52e3d3e116c18624078eecdd196820.jpg

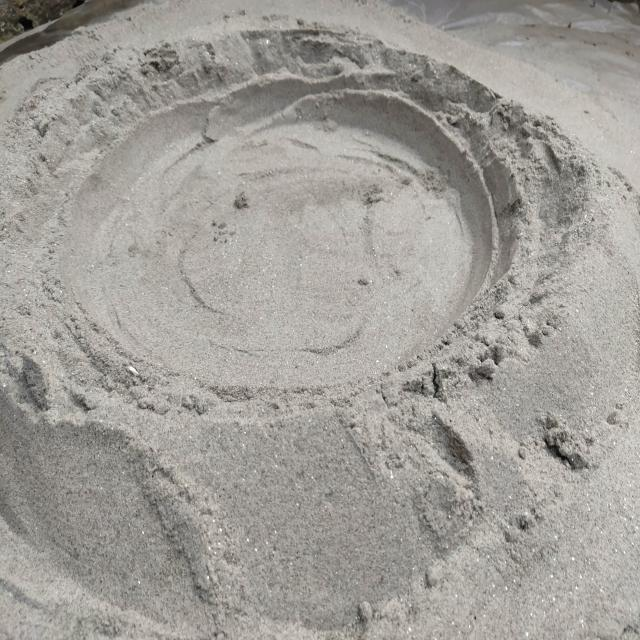
ISRO Total File/ISRO Robotics Challenge/ML Images/20_40Craters.v2i.yolov8/valid/images/IMG_20240413_170606_jpg.rf.ed52e3d3e116c18624078eecdd196820.jpg
