samim-robotix/IRoCU-2024-ISRO-Rover/ISRO Total File/ISRO Robotics Challenge/ML Images/20_40Craters.v2i.yolov8/valid/images/IMG_20240413_170621_jpg.rf.3dbd2df6ec229af867114b4bd0d3b4a8.jpg

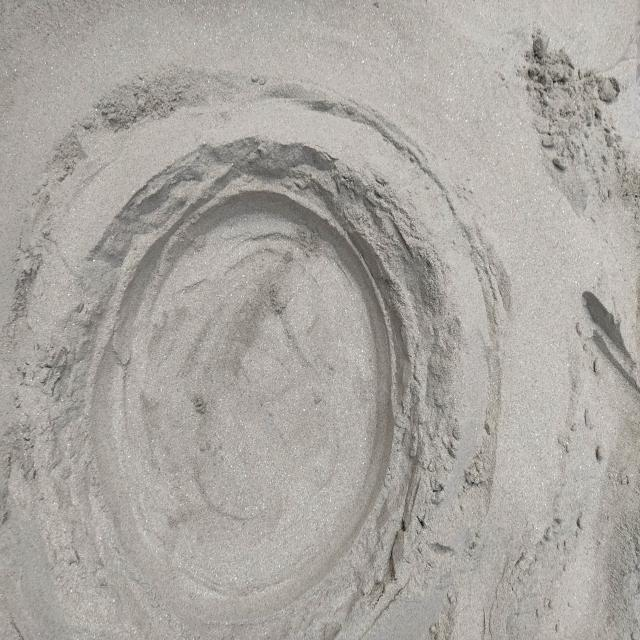
ISRO Total File/ISRO Robotics Challenge/ML Images/20_40Craters.v2i.yolov8/valid/images/IMG_20240413_170621_jpg.rf.3dbd2df6ec229af867114b4bd0d3b4a8.jpg
