samim-robotix/IRoCU-2024-ISRO-Rover/ISRO Total File/ISRO Robotics Challenge/ML Images/20_40Craters.v2i.yolov8/valid/images/IMG_20240413_170752_jpg.rf.be32dcb7e4adaa1e0b37c60805049445.jpg

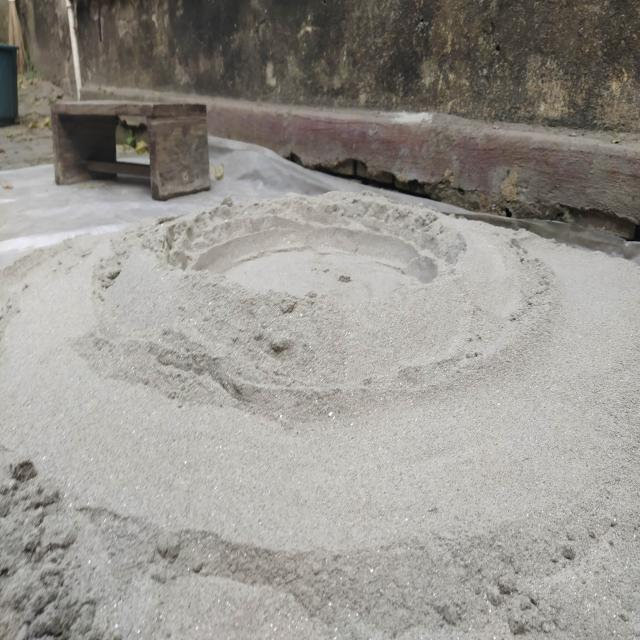
ISRO Total File/ISRO Robotics Challenge/ML Images/20_40Craters.v2i.yolov8/valid/images/IMG_20240413_170752_jpg.rf.be32dcb7e4adaa1e0b37c60805049445.jpg
