samim-robotix/IRoCU-2024-ISRO-Rover/ISRO Total File/ISRO Robotics Challenge/ML Images/20_40Craters.v2i.yolov8/valid/images/IMG_20240413_170813_jpg.rf.b748196a85a19d93d0676aa554f3c8bd.jpg

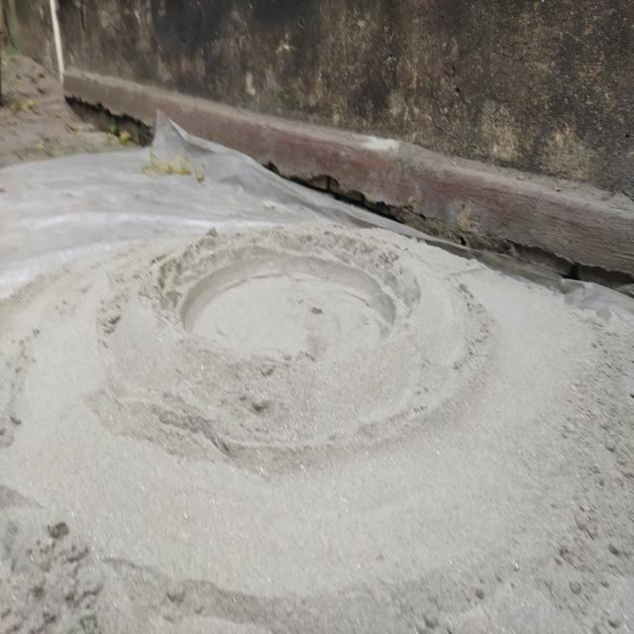
ISRO Total File/ISRO Robotics Challenge/ML Images/20_40Craters.v2i.yolov8/valid/images/IMG_20240413_170813_jpg.rf.b748196a85a19d93d0676aa554f3c8bd.jpg
