samim-robotix/IRoCU-2024-ISRO-Rover/ISRO Total File/ISRO Robotics Challenge/ML Images/20_40Craters.v2i.yolov8/valid/images/IMG_20240413_170819_jpg.rf.261f57a9d229f3ca26e11e771cca77c5.jpg

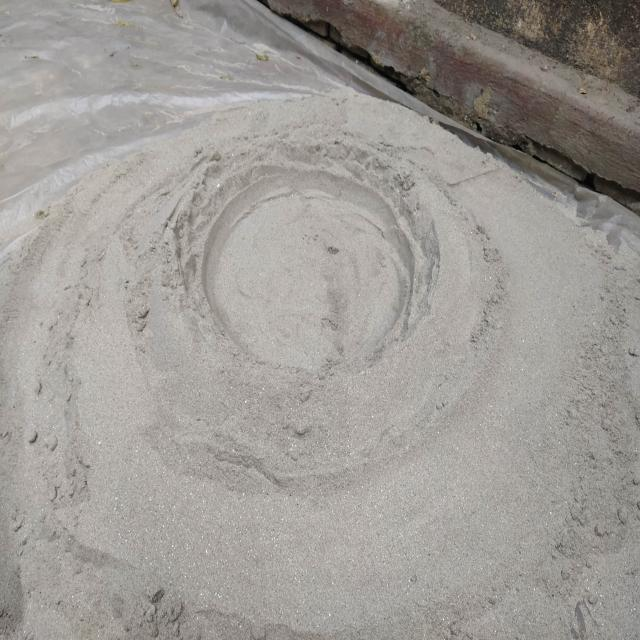
ISRO Total File/ISRO Robotics Challenge/ML Images/20_40Craters.v2i.yolov8/valid/images/IMG_20240413_170819_jpg.rf.261f57a9d229f3ca26e11e771cca77c5.jpg
