samim-robotix/IRoCU-2024-ISRO-Rover/ISRO Total File/ISRO Robotics Challenge/ML Images/20_40Craters.v2i.yolov8/valid/images/IMG_20240413_170842_jpg.rf.1c2907d3b1ec54c9b2945384bc402ea9.jpg

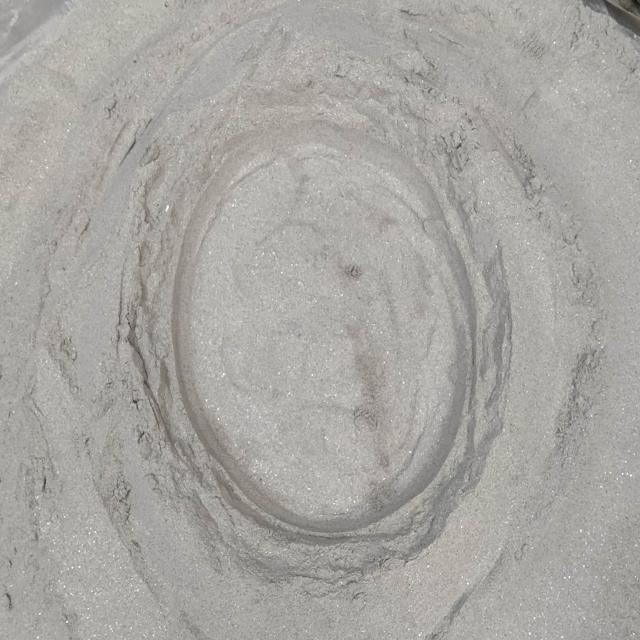
ISRO Total File/ISRO Robotics Challenge/ML Images/20_40Craters.v2i.yolov8/valid/images/IMG_20240413_170842_jpg.rf.1c2907d3b1ec54c9b2945384bc402ea9.jpg
