samim-robotix/IRoCU-2024-ISRO-Rover/ISRO Total File/ISRO Robotics Challenge/ML Images/20_new/video/extracted_frames/frame_96.jpg

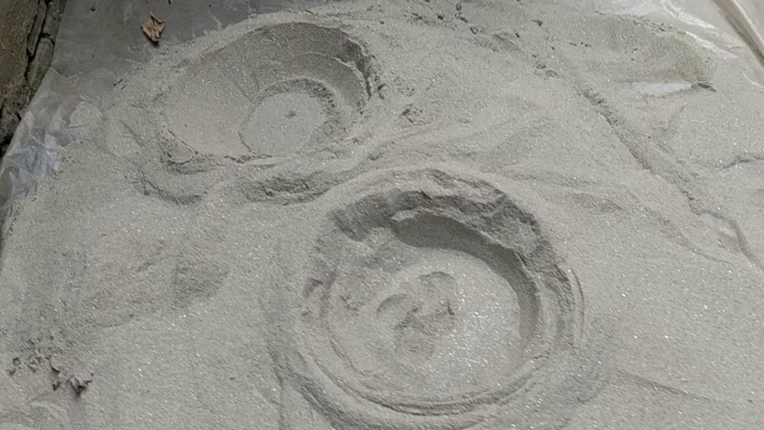
ISRO Total File/ISRO Robotics Challenge/ML Images/20_new/video/extracted_frames/frame_96.jpg
