samim-robotix/IRoCU-2024-ISRO-Rover/ISRO Total File/ISRO Robotics Challenge/ML Images/40_new/frame_45.jpg

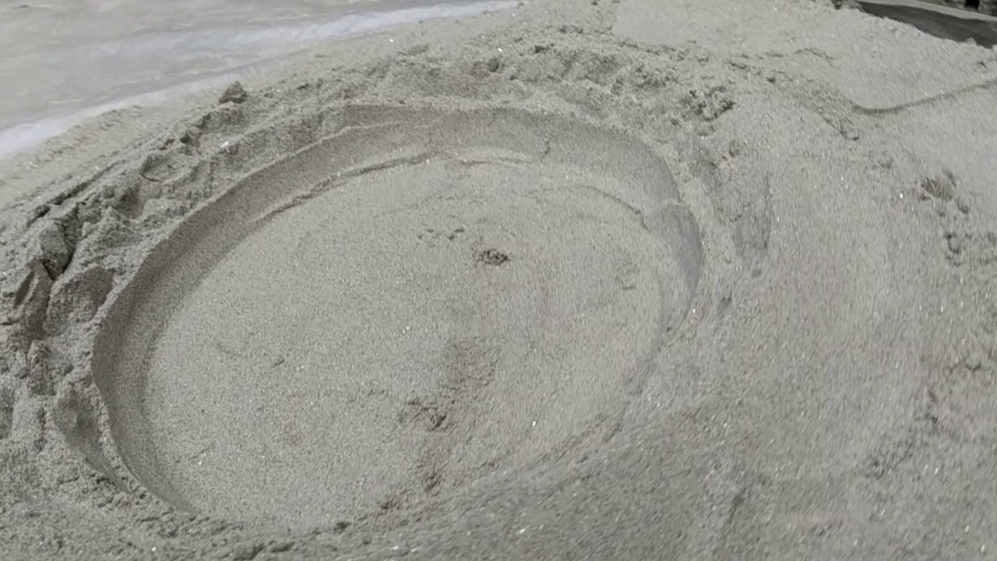
ISRO Total File/ISRO Robotics Challenge/ML Images/40_new/frame_45.jpg
