samim-robotix/IRoCU-2024-ISRO-Rover/ISRO Total File/ISRO Robotics Challenge/ML Images/40_new/IMG_20240413_170732.jpg

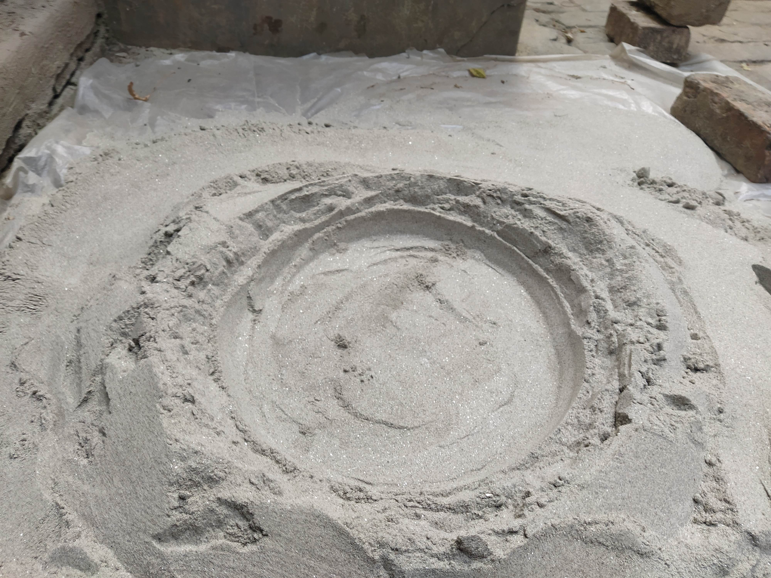
ISRO Total File/ISRO Robotics Challenge/ML Images/40_new/IMG_20240413_170732.jpg
