samim-robotix/IRoCU-2024-ISRO-Rover/ISRO Total File/ISRO Robotics Challenge/ML Images/40_new/video/extracted_frames/frame_9.jpg

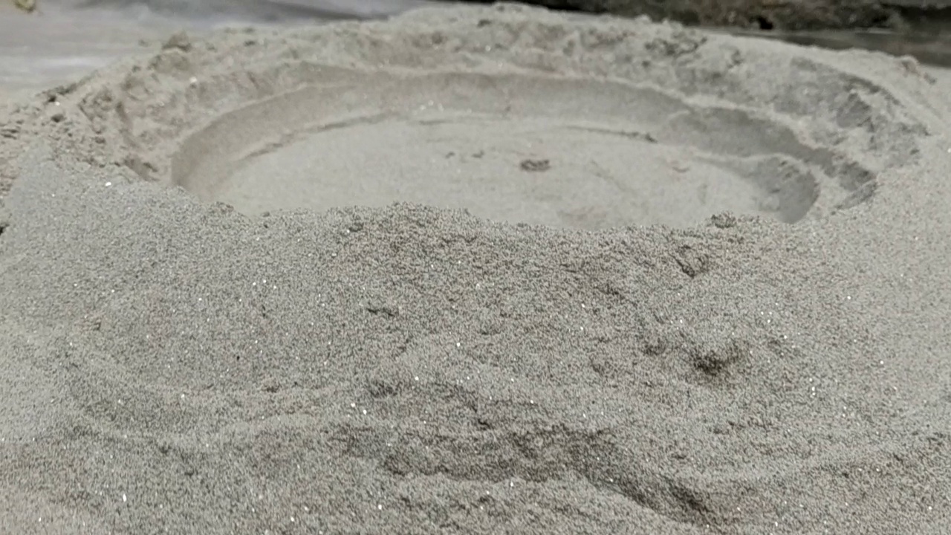
ISRO Total File/ISRO Robotics Challenge/ML Images/40_new/video/extracted_frames/frame_9.jpg
