samim-robotix/IRoCU-2024-ISRO-Rover/ISRO Total File/ISRO Robotics Challenge/ML Images/Data_0105/Images/IMG_20240430_180324_BURST1.jpg

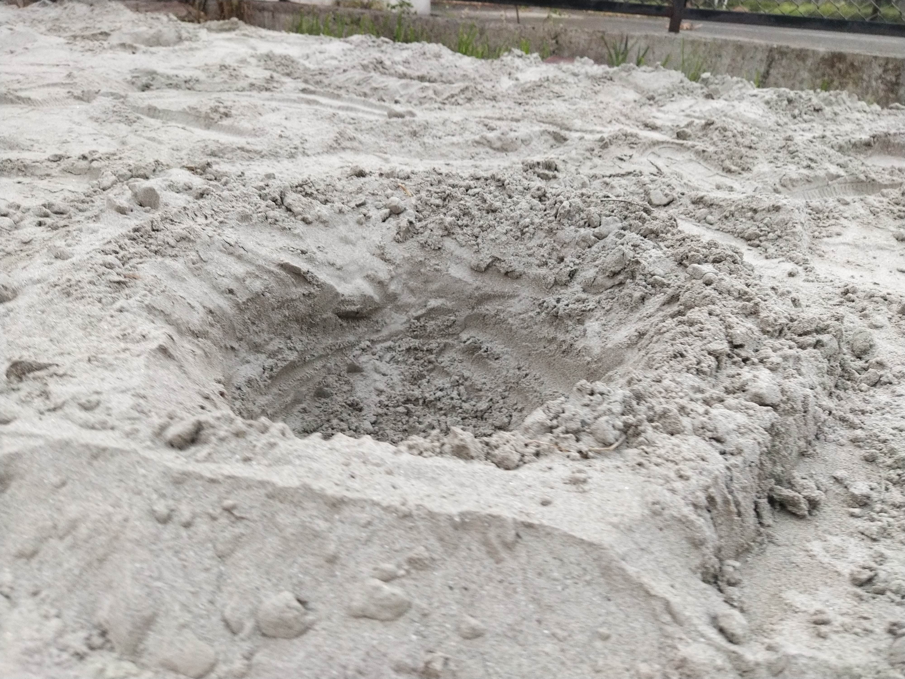
ISRO Total File/ISRO Robotics Challenge/ML Images/Data_0105/Images/IMG_20240430_180324_BURST1.jpg
