samim-robotix/IRoCU-2024-ISRO-Rover/ISRO Total File/ISRO Robotics Challenge/ML Images/obstacle sample/output.png

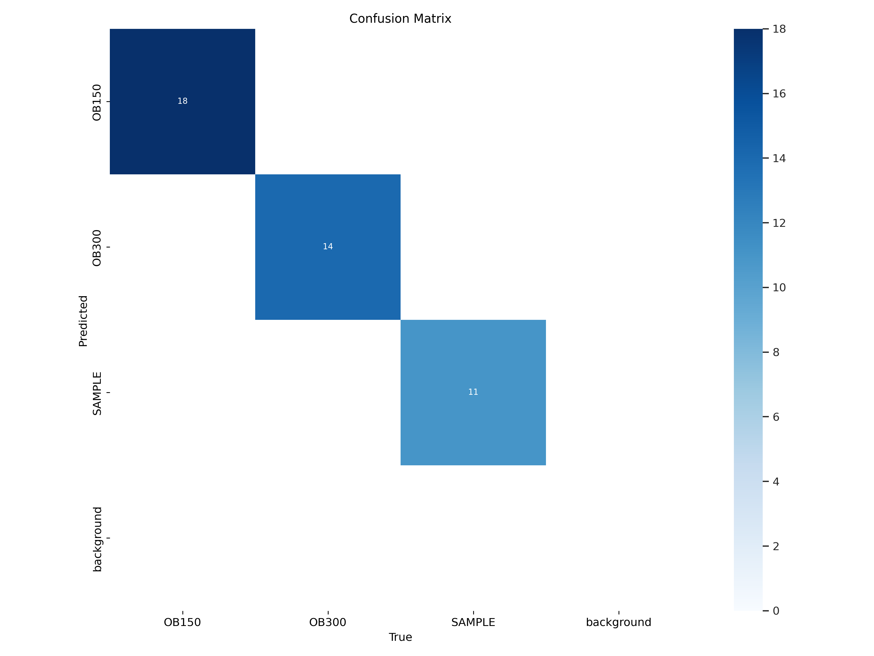
ISRO Total File/ISRO Robotics Challenge/ML Images/obstacle sample/output.png
