samim-robotix/IRoCU-2024-ISRO-Rover/ISRO Total File/ISRO Robotics Challenge/OB_Final/g1.jpg

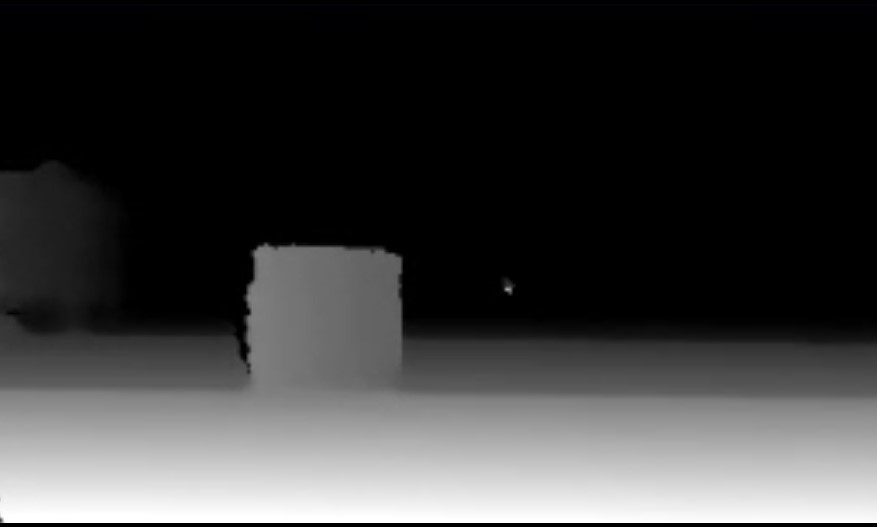
ISRO Total File/ISRO Robotics Challenge/OB_Final/g1.jpg
