samim-robotix/IRoCU-2024-ISRO-Rover/ISRO Total File/ISRO Robotics Challenge/Obseract Final Image Data/stars/27.jpg

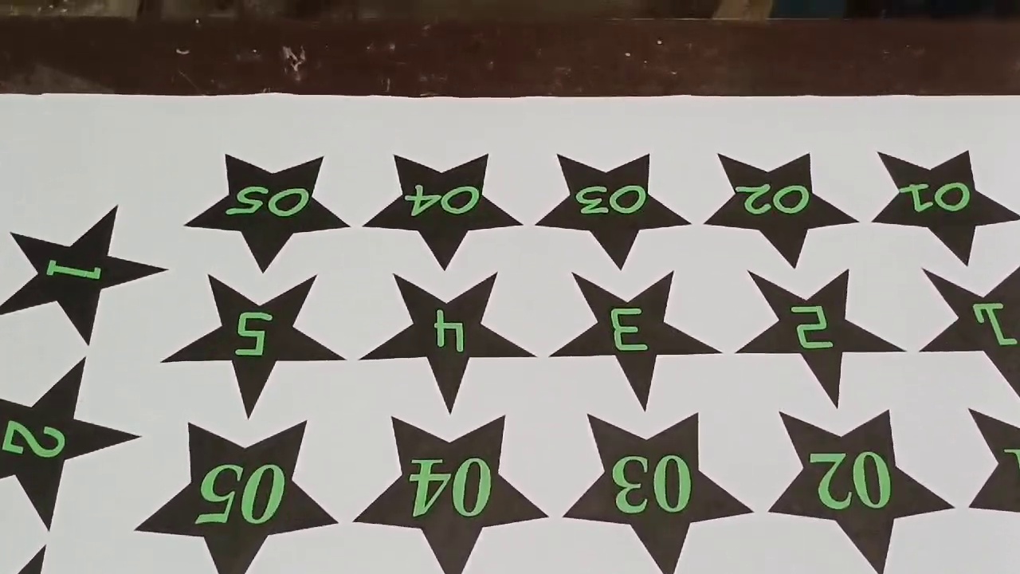
ISRO Total File/ISRO Robotics Challenge/Obseract Final Image Data/stars/27.jpg
