samim-robotix/IRoCU-2024-ISRO-Rover/ISRO Total File/OBS_Chassis/Chasis FOS min max.jpg

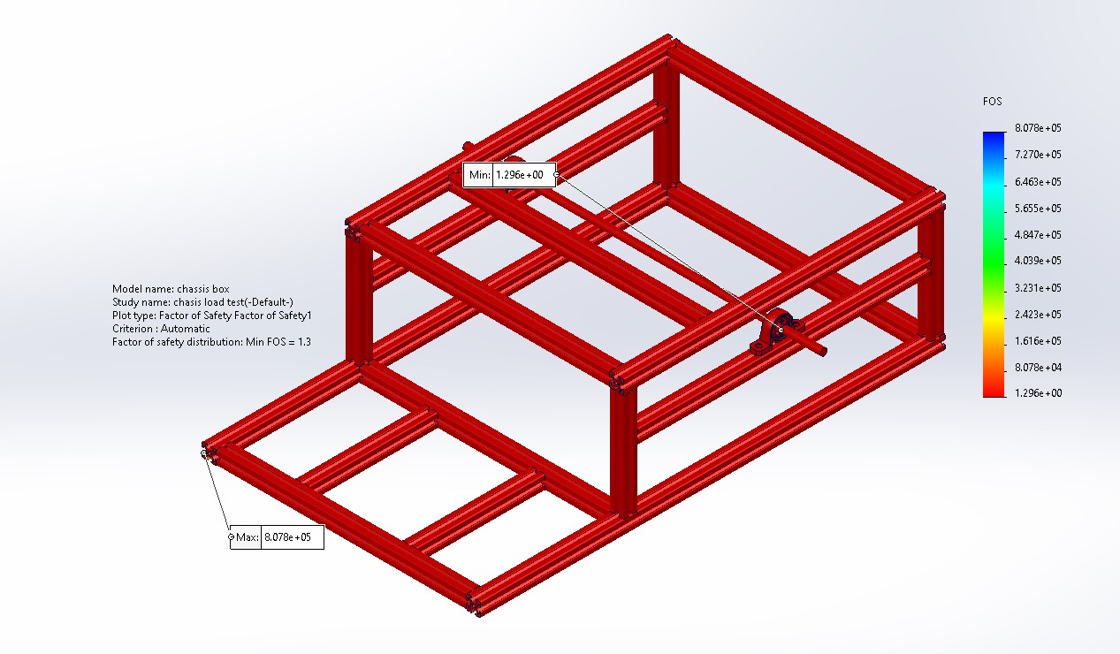
ISRO Total File/OBS_Chassis/Chasis FOS min max.jpg
