samim-robotix/IRoCU-2024-ISRO-Rover/ISRO Total File/Robotic Arm/Gripper/robot-servo-motor-gripper-1.snapshot.3/8.png

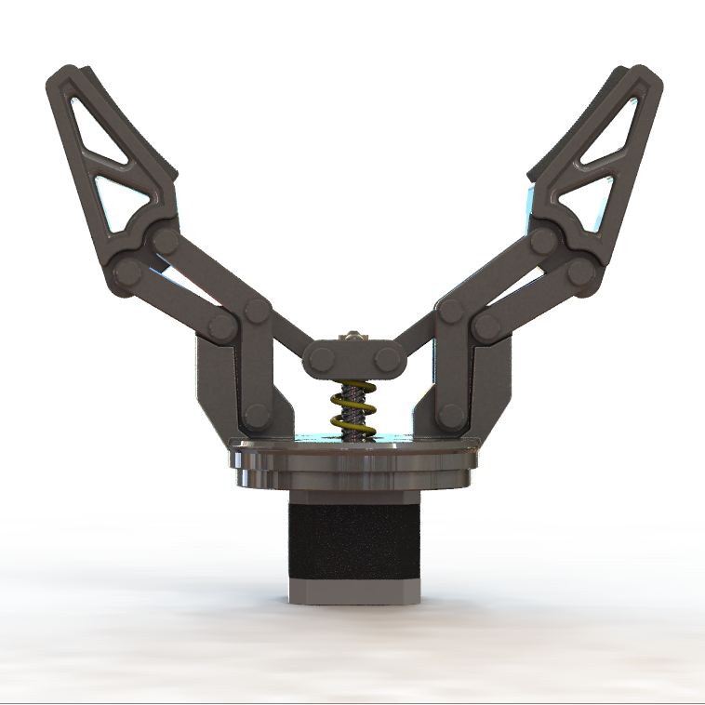
ISRO Total File/Robotic Arm/Gripper/robot-servo-motor-gripper-1.snapshot.3/8.png
