samim-robotix/IRoCU-2024-ISRO-Rover/ISRO Total File/Robotic Arm/simple-gripper-with-high-gripping-force-2.snapshot.5/Cattura5.PNG

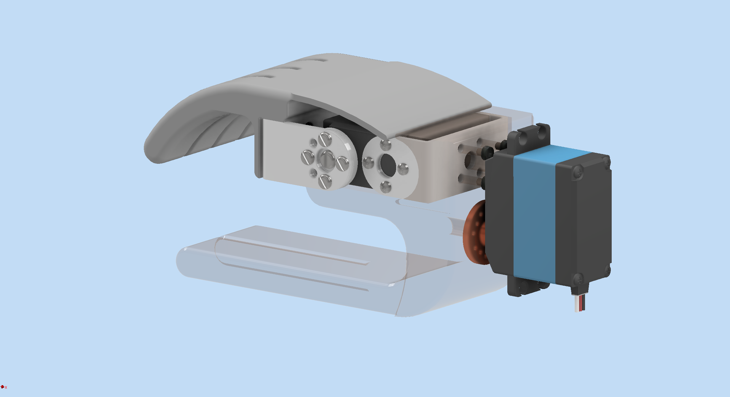
ISRO Total File/Robotic Arm/simple-gripper-with-high-gripping-force-2.snapshot.5/Cattura5.PNG
