samim-robotix/IRoCU-2024-ISRO-Rover/ISRO/DAY Video/dayphoto/frame1_189.jpg

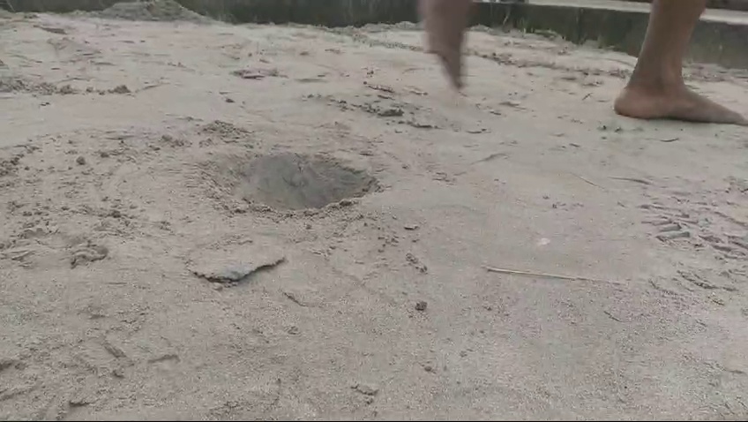
ISRO/DAY Video/dayphoto/frame1_189.jpg
