samim-robotix/IRoCU-2024-ISRO-Rover/ISRO Total File/Electronics/xt60 assm.SLDASM

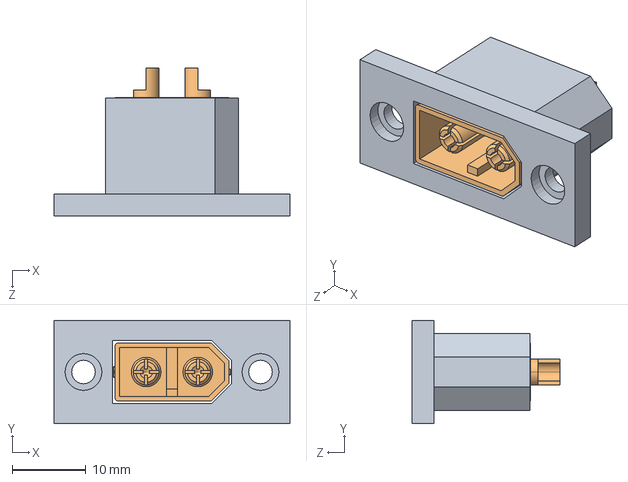
[picture p245: CAD file, 2026-10-19]
ISRO Total File/Electronics/xt60 assm.SLDASM
32.0 x 14.0 x 20.1 mm
xt60_faceplate
XT60_Macho.step
