samim-robotix/IRoCU-2024-ISRO-Rover/ISRO Total File/New Designs/wheel 2.1 assembly.STEP

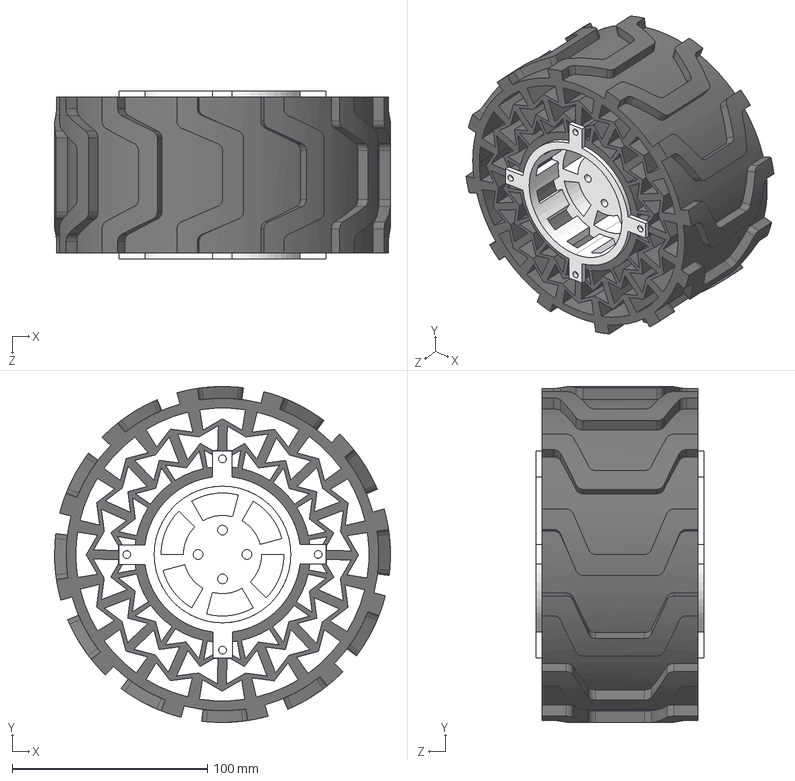
[picture p246: CAD file, 2026-10-19]
ISRO Total File/New Designs/wheel 2.1 assembly.STEP
172.0 x 172.0 x 86.0 mm
wheel 2.1
rim2
