samim-robotix/IRoCU-2024-ISRO-Rover/ISRO Total File/OBS_Chassis/Chassis Asem 2_1.SLDASM

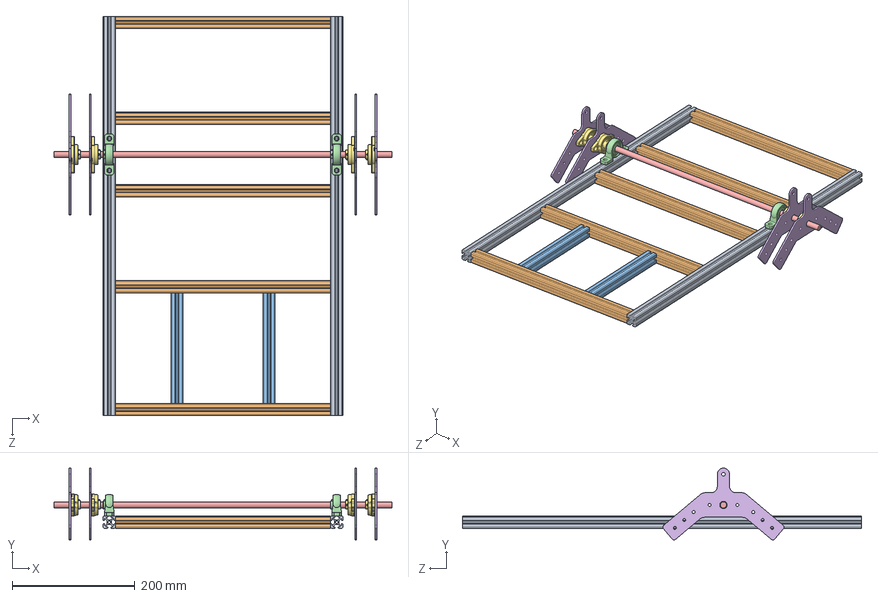
[picture p247: CAD file, 2026-10-19]
ISRO Total File/OBS_Chassis/Chassis Asem 2_1.SLDASM
550.0 x 116.9 x 650.0 mm
T55 x 2
T35 x 5
T18 x 2
KP000 x 2
axl
1st piv x 4
KFL000 bearing unit 10mm x 4
