samim-robotix/IRoCU-2024-ISRO-Rover/ISRO Total File/Robotic Arm/146552629-7-skf_bearing_51118_2/skf_bearing_51118_2.SLDASM

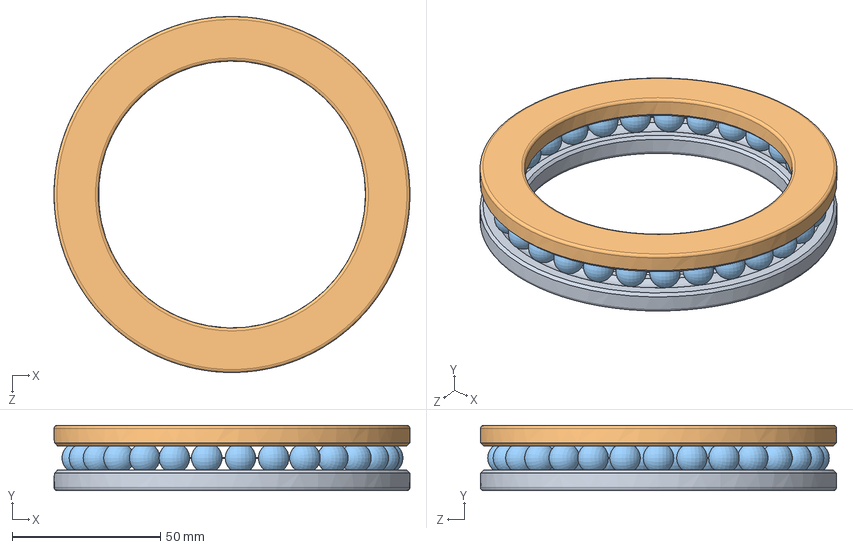
[picture p248: CAD file, 2026-10-19]
ISRO Total File/Robotic Arm/146552629-7-skf_bearing_51118_2/skf_bearing_51118_2.SLDASM
120.0 x 22.0 x 120.0 mm
skf_bearing_51118_2_01
skf_bearing_51118_2_02
skf_bearing_51118_2_03
