samim-robotix/IRoCU-2024-ISRO-Rover/ISRO Total File/Robotic Arm/roboarm.SLDASM

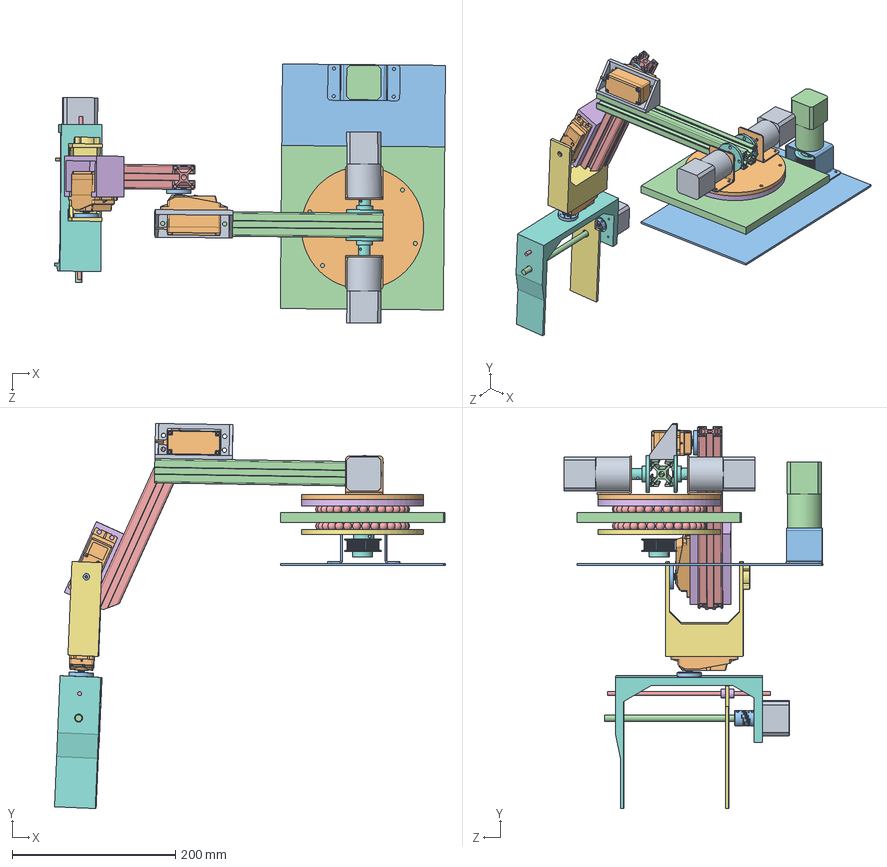
[picture p249: CAD file, 2026-10-19]
ISRO Total File/Robotic Arm/roboarm.SLDASM
479.6 x 472.3 x 317.8 mm
servo clamp
DS Servo DS5160 SSG x 3
DS51_Arm_Disc x 3
arm_l1
arm_l2_30
servo clamp - wrist
servo clamp - wrist U
u gripper clamp
gripper motor
skf_bearing_608-z_2.stp x 2
5mm to 8mm flexible shaft coupler.stp
lead screw
smooth rod 5mm
5mm bush
grip move
sld_cpl x 2
shoulder _elbow x 2
shldr motor clamp x 2
base big plate
51118 base
skf_bearing_51118_2_03 x 2
top rot plate
bot rot plate
GT2 pulley 60 teeth width 11mm 8mm bore.stp x 2
skf_bearing_16010_2.stp
shoulder motor holder
base motor clamp
wheel motor
