samim-robotix/IRoCU-2024-ISRO-Rover/ISRO Total File/ARM/arm new assm.SLDASM

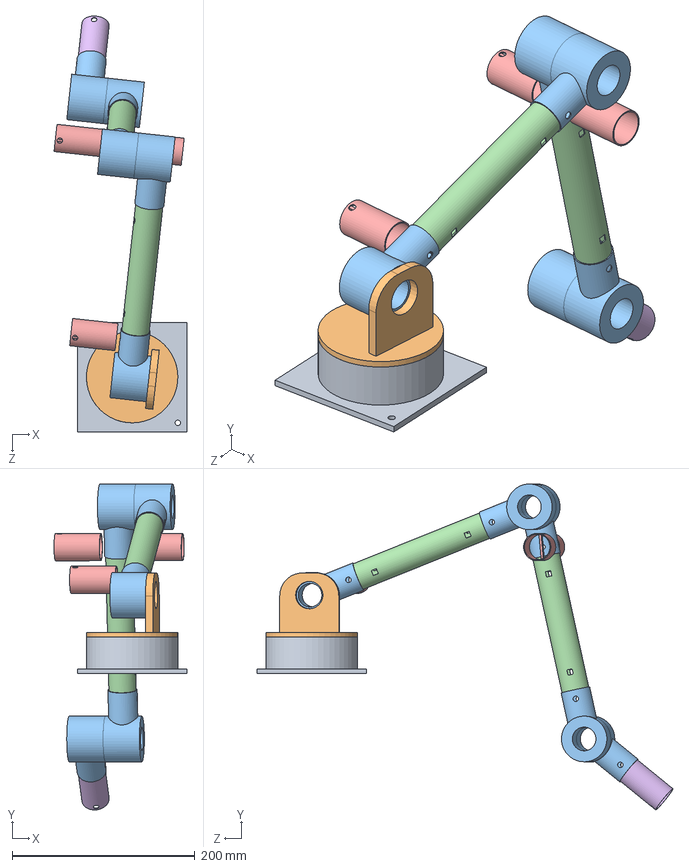
[picture p250: CAD file, 2026-10-19]
ISRO Total File/ARM/arm new assm.SLDASM
145.5 x 356.6 x 455.1 mm
base j
base joiner
joints x 5
AL1 x 2
wt blk x 3
ALG
