samim-robotix/IRoCU-2024-ISRO-Rover/ISRO Total File/OBS_Chassis/Chassis Asem 2.SLDASM

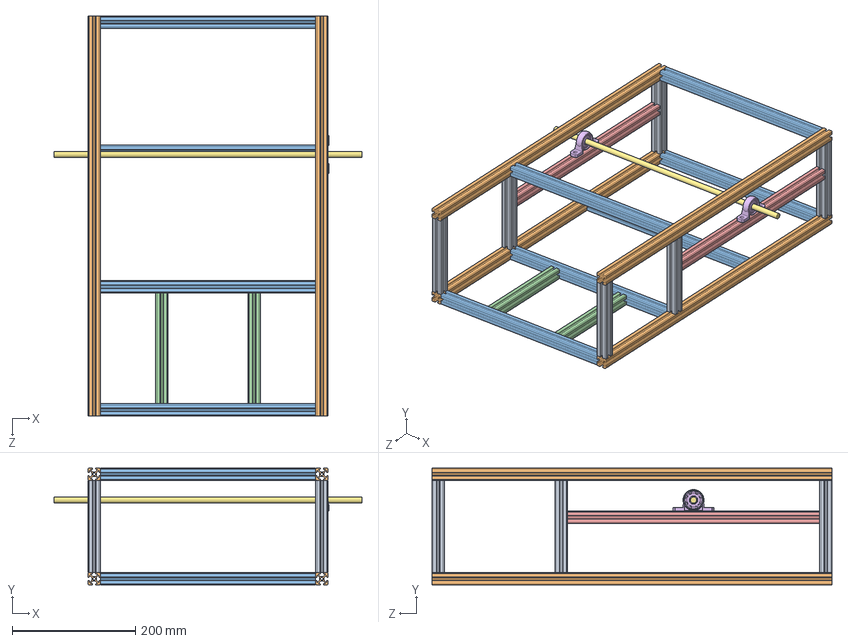
[picture p251: CAD file, 2026-10-19]
ISRO Total File/OBS_Chassis/Chassis Asem 2.SLDASM
500.0 x 190.0 x 650.0 mm
T15 x 6
T55 x 4
T35 x 6
T18 x 2
T41 x 2
KP000 x 2
axl
