samim-robotix/IRoCU-2024-ISRO-Rover/ISRO Total File/RoboML/roboarmml.SLDASM

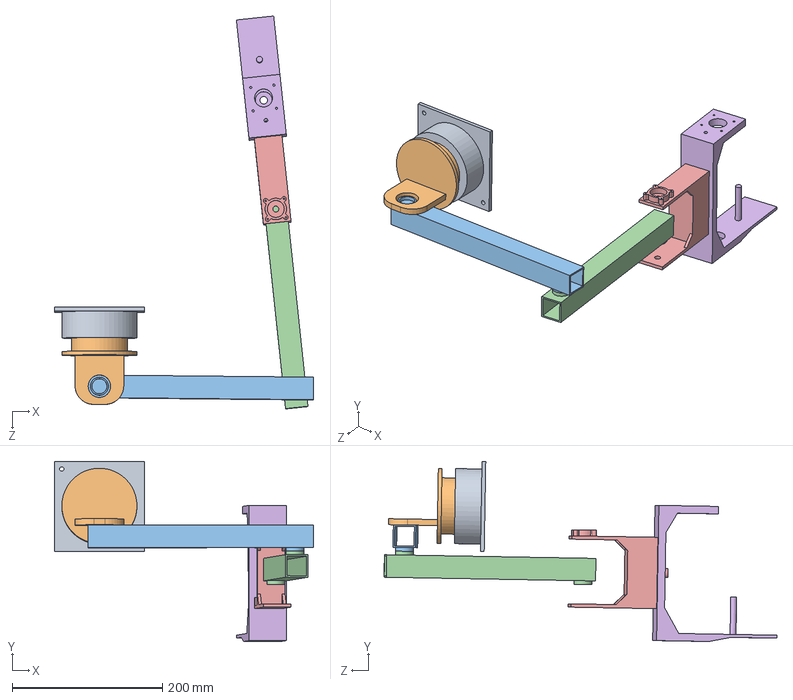
[picture p252: CAD file, 2026-10-19]
ISRO Total File/RoboML/roboarmml.SLDASM
345.1 x 239.6 x 523.0 mm
base j
base joiner
tp1
tp2
servo clamp - wrist U
u gripper clamp
