samim-robotix/IRoCU-2024-ISRO-Rover/ISRO Total File/Robotic Arm/Gripper/gripper assem.SLDASM

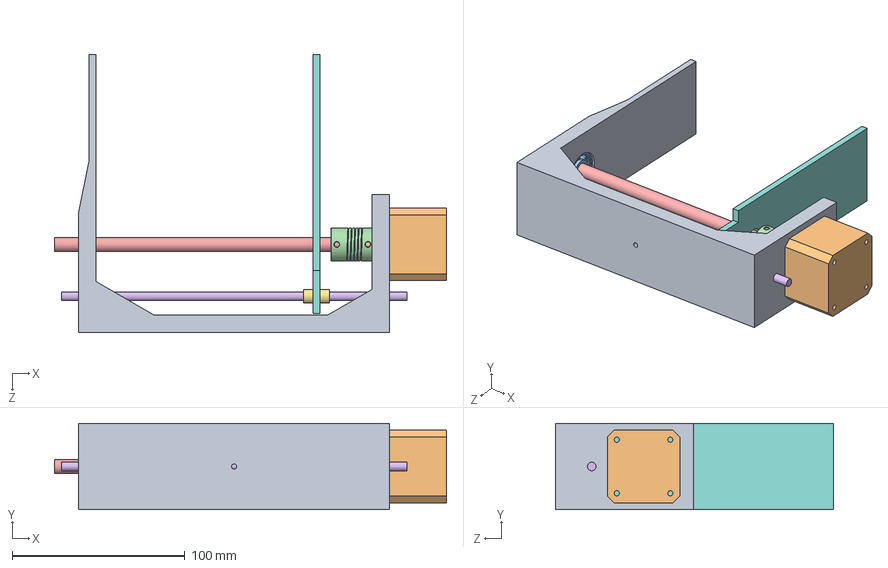
[picture p253: CAD file, 2026-10-19]
ISRO Total File/Robotic Arm/Gripper/gripper assem.SLDASM
227.0 x 50.0 x 161.0 mm
u gripper clamp
gripper motor
skf_bearing_608-z_2.stp
5mm to 8mm flexible shaft coupler.stp
lead screw
smooth rod 5mm
5mm bush
grip move
