samim-robotix/IRoCU-2024-ISRO-Rover/ISRO Total File/OBS_Chassis/RB parts/2-3assm.SLDASM

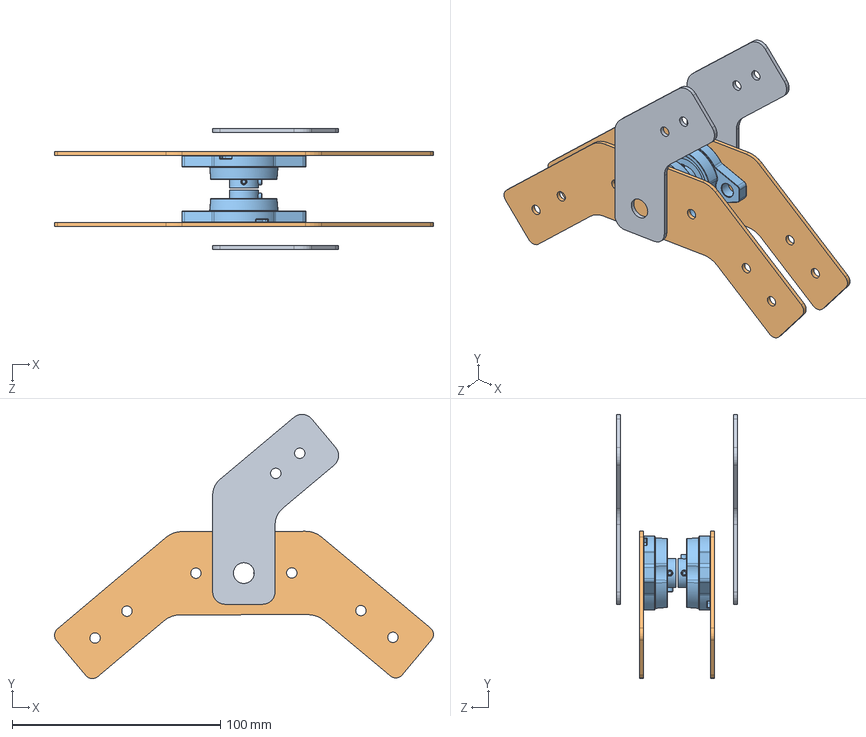
[picture p254: CAD file, 2026-10-19]
ISRO Total File/OBS_Chassis/RB parts/2-3assm.SLDASM
181.9 x 126.8 x 58.0 mm
2nd piv 1 x 2
3rd piv x 2
KFL000 bearing unit 10mm x 2
