samim-robotix/IRoCU-2024-ISRO-Rover/ISRO Total File/ARM/testassm.SLDASM

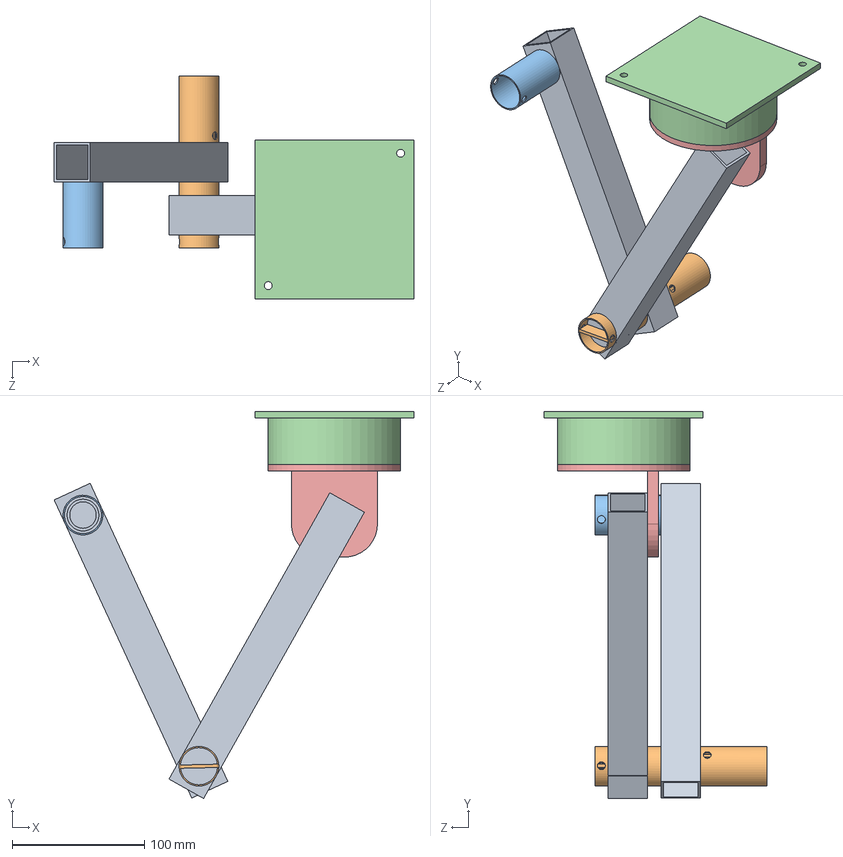
[picture p255: CAD file, 2026-10-19]
ISRO Total File/ARM/testassm.SLDASM
271.7 x 292.3 x 168.2 mm
tp1 x 2
wt blk x 2
ALG
base j
base joiner
