samim-robotix/IRoCU-2024-ISRO-Rover/ISRO Total File/OBS_Chassis/RB parts/alter 3rd assm.SLDASM

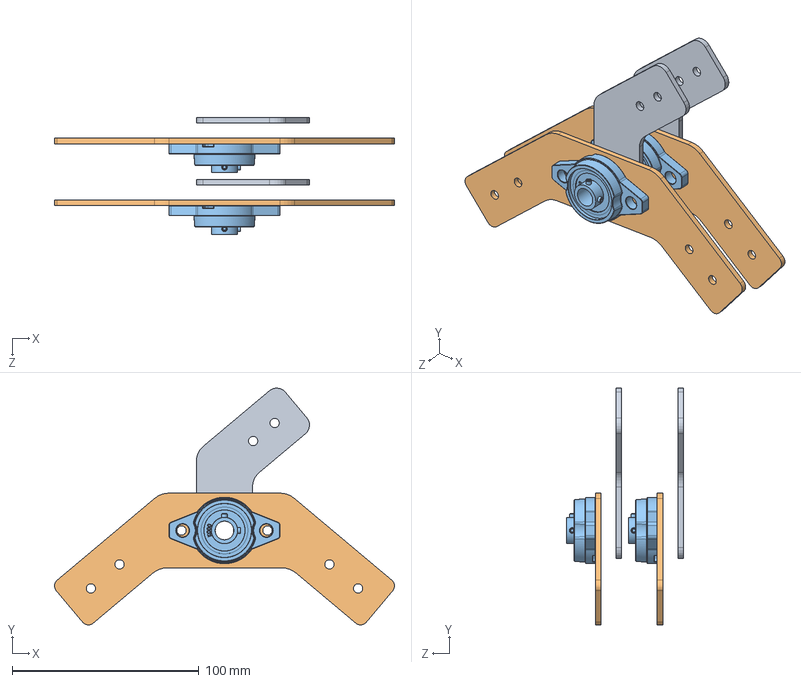
[picture p256: CAD file, 2026-10-19]
ISRO Total File/OBS_Chassis/RB parts/alter 3rd assm.SLDASM
181.9 x 126.6 x 62.5 mm
2nd piv 1 x 2
3rd piv x 2
KFL000 bearing unit 10mm x 2
