samim-robotix/IRoCU-2024-ISRO-Rover/ISRO Total File/ARM/test base.SLDASM

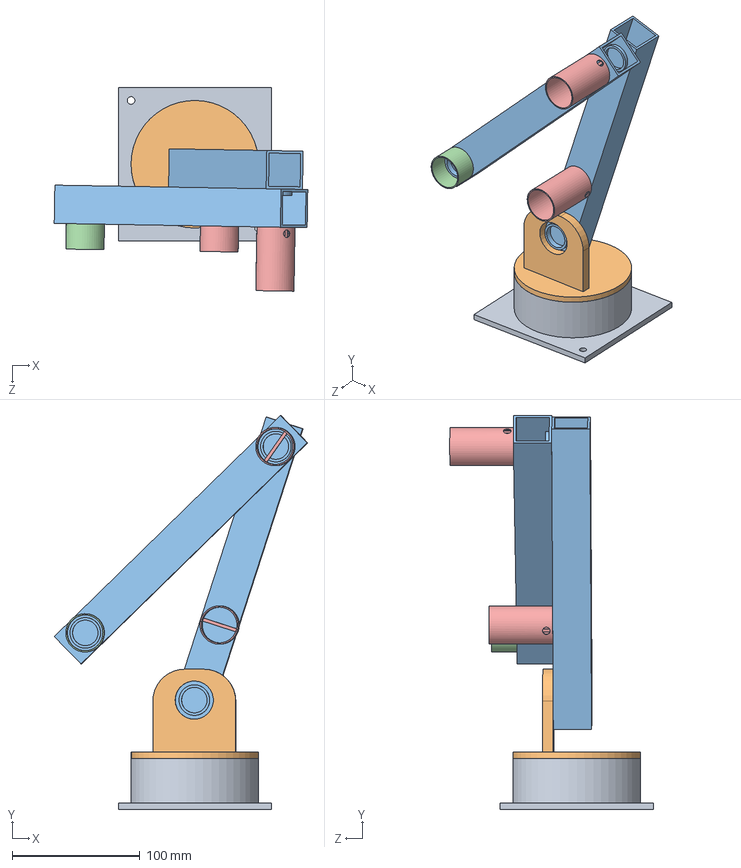
[picture p257: CAD file, 2026-10-19]
ISRO Total File/ARM/test base.SLDASM
198.8 x 308.9 x 159.6 mm
base j
base joiner
tp1 x 2
ALG
wt blk x 2
