samim-robotix/IRoCU-2024-ISRO-Rover/ISRO Total File/OBS_Chassis/chassis box.SLDASM

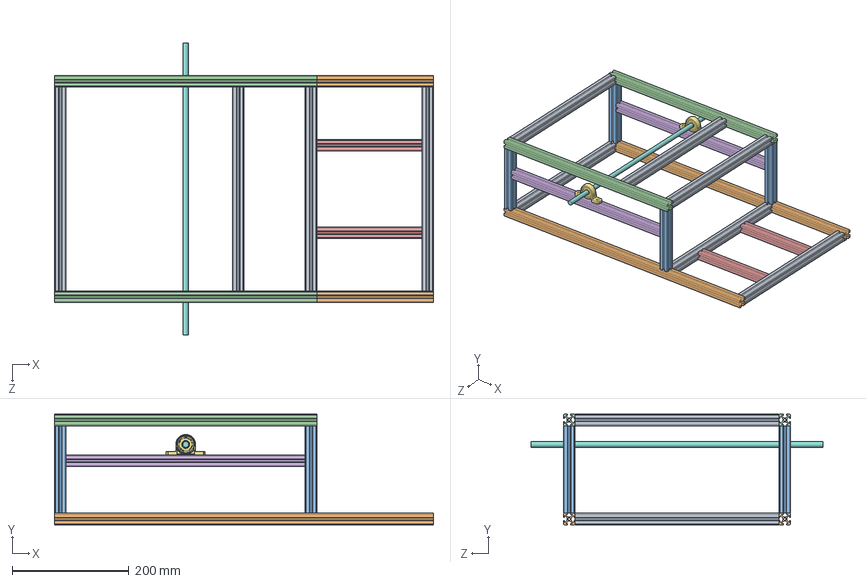
[picture p258: CAD file, 2026-10-19]
ISRO Total File/OBS_Chassis/chassis box.SLDASM
650.0 x 190.0 x 500.0 mm
T35 x 6
T55 x 2
T15 x 4
T45 x 2
T18 x 2
T41 x 2
KP000.stp x 2
axl
