samim-robotix/IRoCU-2024-ISRO-Rover/ISRO Total File/Robotic Arm/SM Base assm.SLDASM

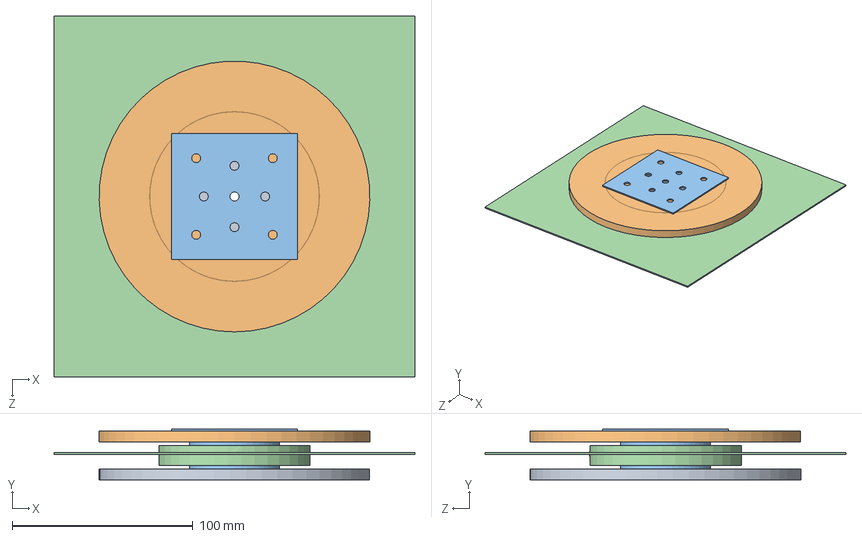
[picture p259: CAD file, 2026-10-19]
ISRO Total File/Robotic Arm/SM Base assm.SLDASM
200.0 x 28.0 x 200.0 mm
nylon disk btm
nylon disk top
plate pipe
SM_base
skf_bearing_16010_2.stp
