samim-robotix/IRoCU-2024-ISRO-Rover/ISRO Total File/ARM/arm assem.SLDASM

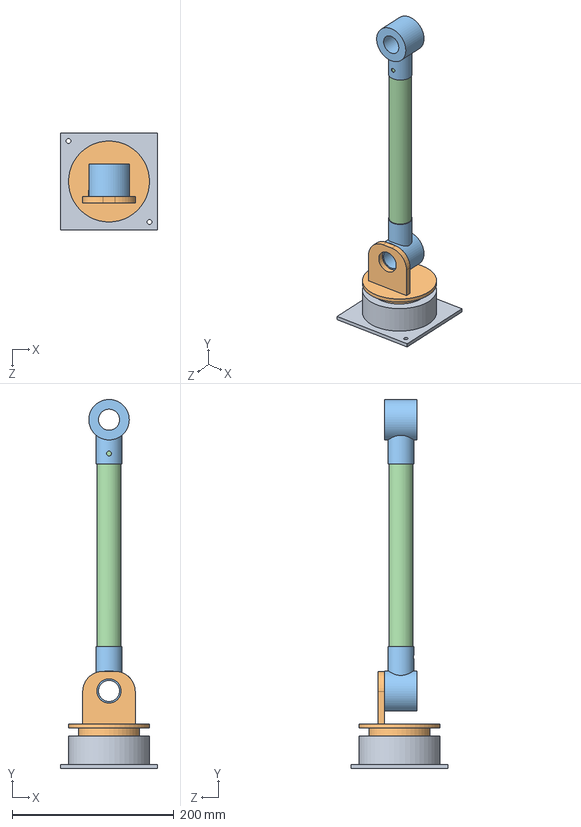
[picture p260: CAD file, 2026-10-19]
ISRO Total File/ARM/arm assem.SLDASM
120.0 x 455.7 x 120.0 mm
base j
base joiner
joints x 2
AL1
