samim-robotix/IRoCU-2024-ISRO-Rover/ISRO Total File/BOT/bot assem.SLDASM

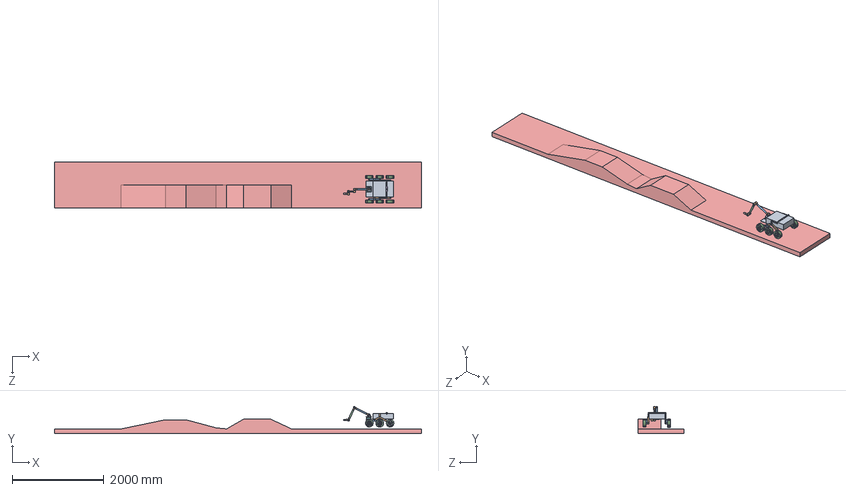
[picture p261: CAD file, 2026-10-19]
ISRO Total File/BOT/bot assem.SLDASM
8000.0 x 589.7 x 1000.0 mm
rocker x 2
boogie x 2
wheel x 6
diff bar
diff arm3 x 2
base j
base joiner
joints x 5
AL1
AL2
ALG
