samim-robotix/IRoCU-2024-ISRO-Rover/ISRO Total File/OBS_Chassis/RB parts/2nd piv assm.SLDASM

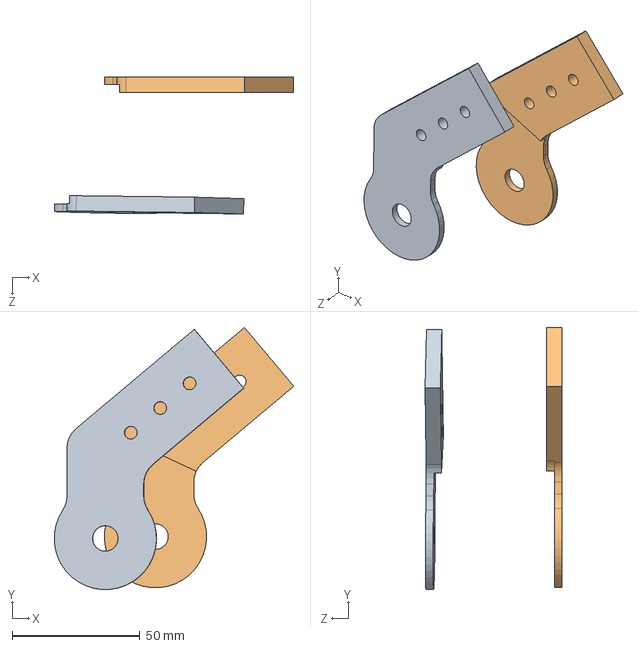
[picture p262: CAD file, 2026-10-19]
ISRO Total File/OBS_Chassis/RB parts/2nd piv assm.SLDASM
93.7 x 102.5 x 53.6 mm
2nd piv 2
2nd piv 1
