samim-robotix/IRoCU-2024-ISRO-Rover/ISRO Total File/OBS_Chassis/RB parts/cent_pivot.SLDASM

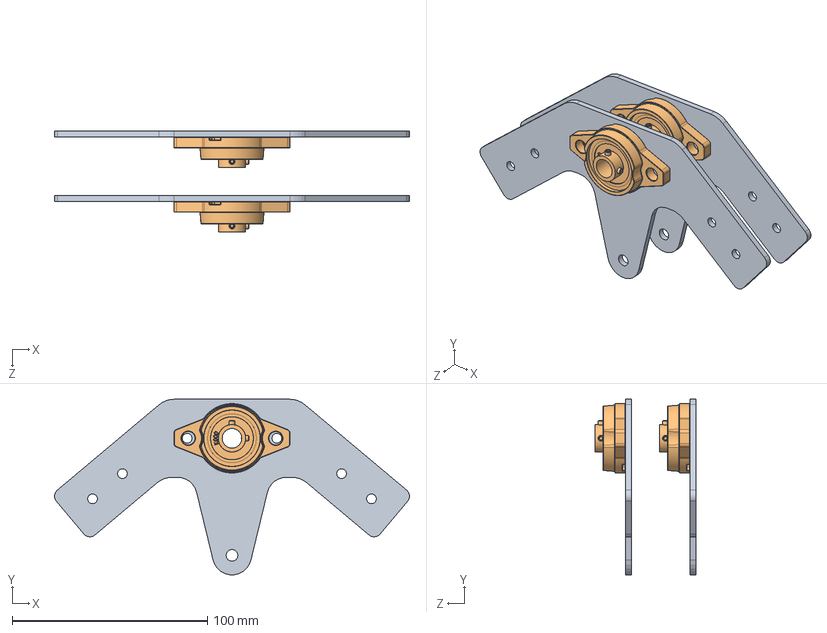
[picture p263: CAD file, 2026-10-19]
ISRO Total File/OBS_Chassis/RB parts/cent_pivot.SLDASM
181.9 x 89.9 x 51.5 mm
1st piv x 2
KFL000 bearing unit 10mm x 2
