samim-robotix/IRoCU-2024-ISRO-Rover/ISRO Total File/OBS_Chassis/rover assem.SLDASM

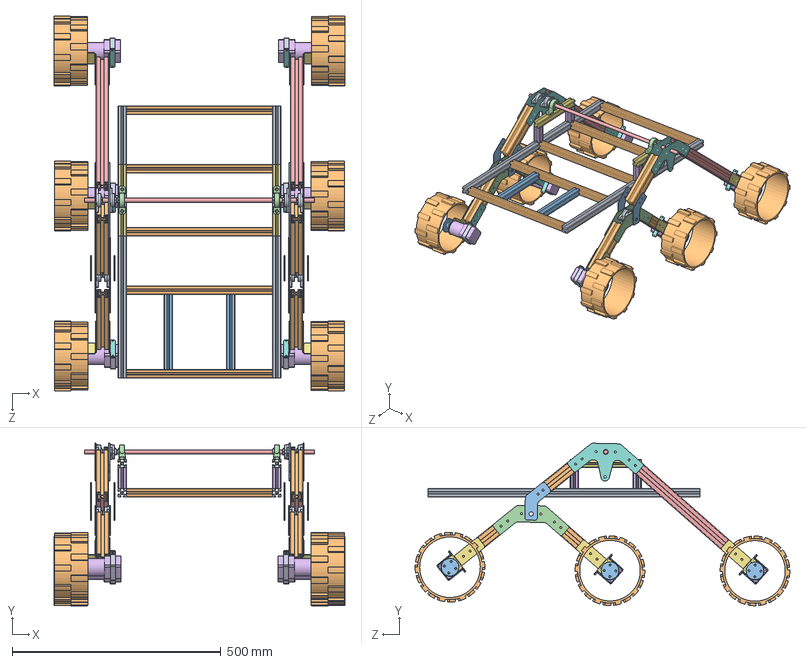
[picture p264: CAD file, 2026-10-19]
ISRO Total File/OBS_Chassis/rover assem.SLDASM
696.4 x 389.2 x 896.9 mm
T55 x 2
T35 x 5
T18 x 2
KP000 x 2
axl
T15 x 4
T41 x 2
1st piv x 4
KFL000 bearing unit 10mm x 8
30 RL x 6
2nd piv 1 x 4
3rd piv x 4
30 RR x 2
wheel motor x 6
motor Clamp msd x 6
motor Clamp osd x 6
motor Clamp Losd x 6
wheel 2.2 x 6
wheel motor coupler x 6
