samim-robotix/IRoCU-2024-ISRO-Rover/ISRO Total File/Robotic Arm/wrist_motor assm.SLDASM

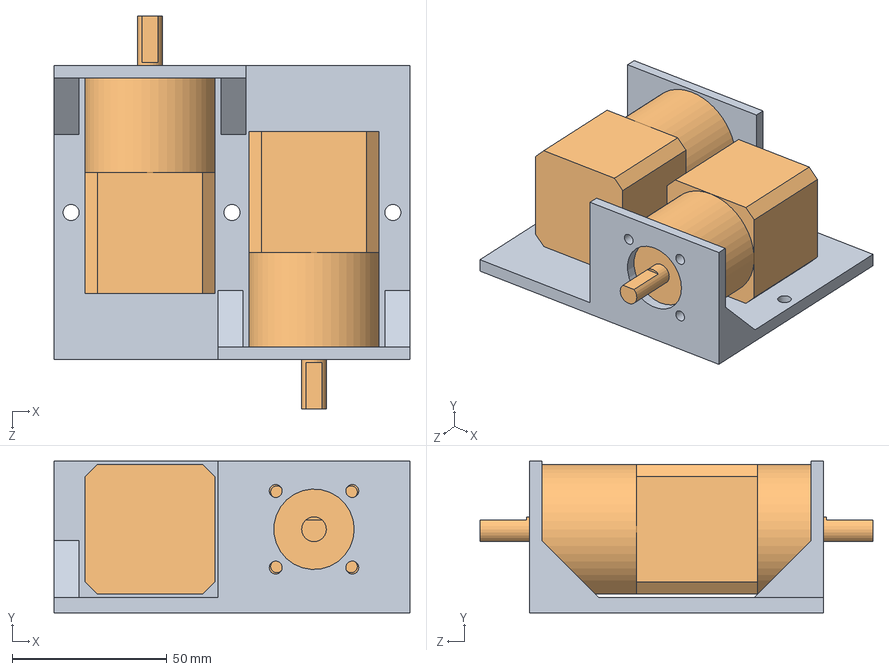
[picture p265: CAD file, 2026-10-19]
ISRO Total File/Robotic Arm/wrist_motor assm.SLDASM
115.0 x 49.0 x 127.0 mm
wrist motor clamp
wrist motor x 2
