samim-robotix/IRoCU-2024-ISRO-Rover/ISRO Total File/Robotic Arm/Gripper/robot-servo-motor-gripper-1.snapshot.3/Assembly/Assem2.SLDASM

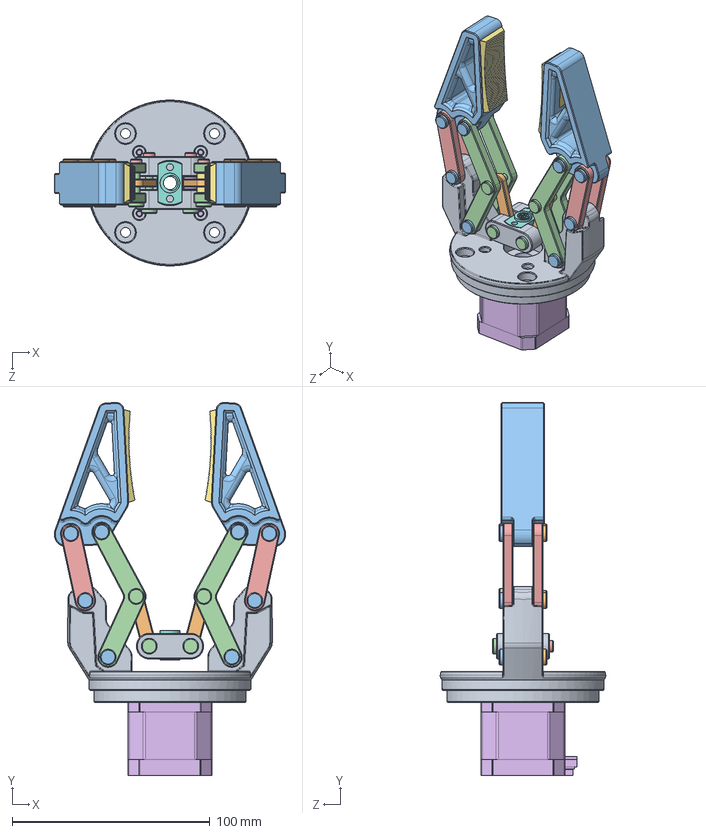
[picture p266: CAD file, 2026-10-19]
ISRO Total File/Robotic Arm/Gripper/robot-servo-motor-gripper-1.snapshot.3/Assembly/Assem2.SLDASM
117.1 x 188.7 x 83.8 mm
B1
LR1 x 2
G1 x 2
L1 x 4
L2 x 4
17HS3001-280N
GE x 2
T8 Nut 1.5
LCH0
Joint rod cap x 8
Joint rod x 8
Joint rod_3.8 x 4
Joint rod cap 3.8 x 4
washer_1 x 2
washer_2.8 x 2
