samim-robotix/IRoCU-2024-ISRO-Rover/ISRO Total File/Robotic Arm/cam assem.SLDASM

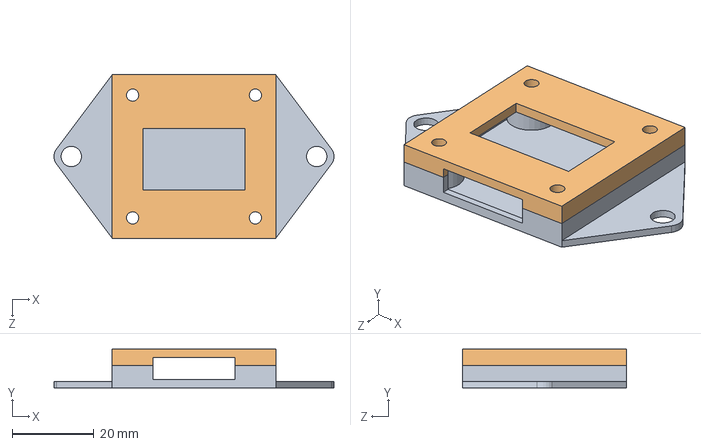
[picture p267: CAD file, 2026-10-19]
ISRO Total File/Robotic Arm/cam assem.SLDASM
68.5 x 9.45 x 40.0 mm
cam enc p1
cam enc p2
