samim-robotix/IRoCU-2024-ISRO-Rover/ISRO Total File/Robotic Arm/base assem.SLDASM

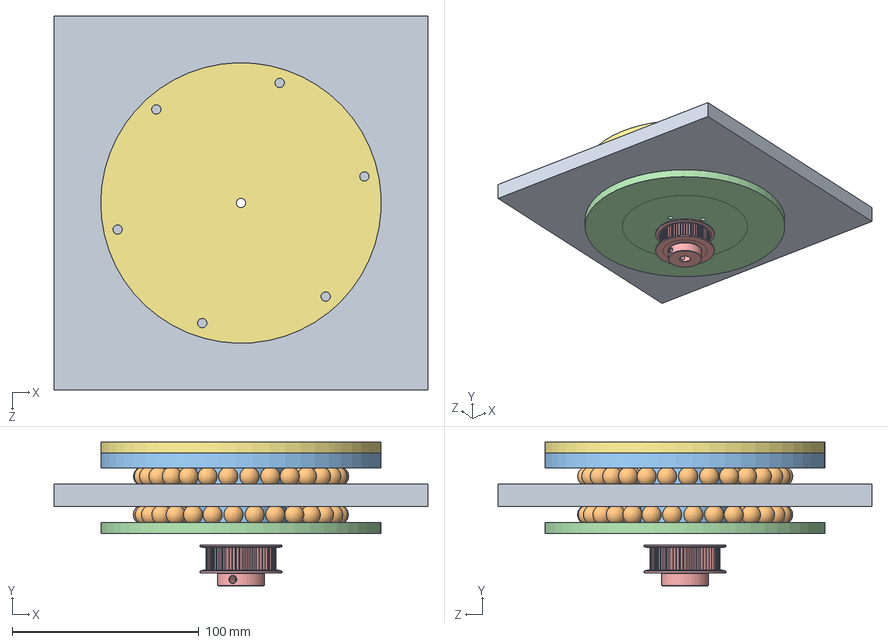
[picture p268: CAD file, 2026-10-19]
ISRO Total File/Robotic Arm/base assem.SLDASM
200.0 x 77.0 x 200.0 mm
51118 base
skf_bearing_51118_2_03 x 2
top rot plate
bot rot plate
GT2 pulley 60 teeth width 11mm 8mm bore.stp
skf_bearing_16010_2.stp
shoulder motor holder
