samim-robotix/IRoCU-2024-ISRO-Rover/ISRO Total File/Robotic Arm/roboarm-ml.SLDASM

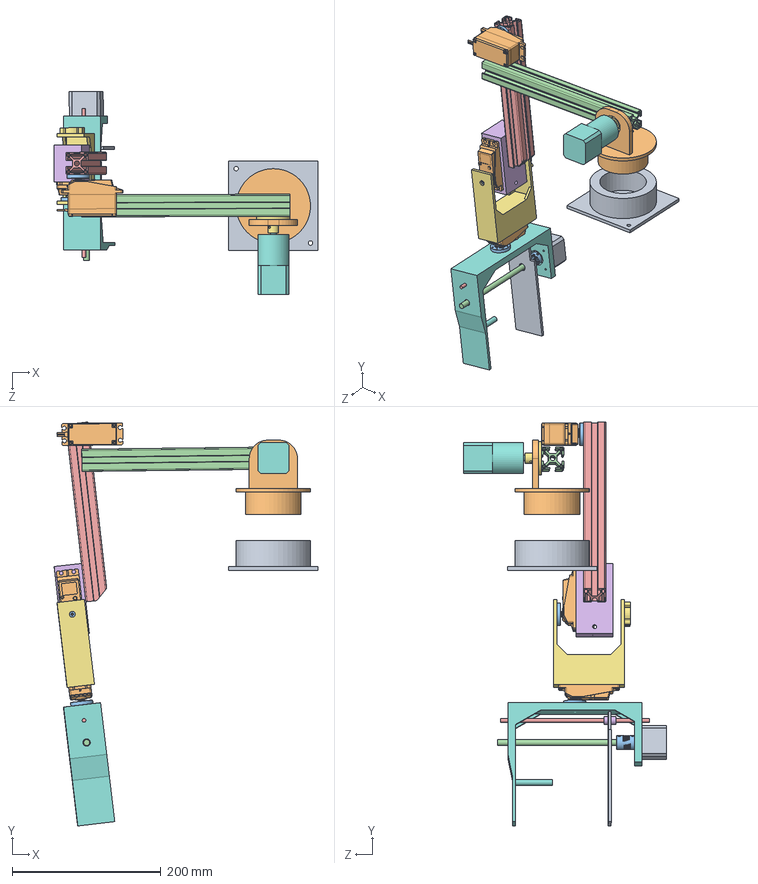
[picture p269: CAD file, 2026-10-19]
ISRO Total File/Robotic Arm/roboarm-ml.SLDASM
354.8 x 543.2 x 272.7 mm
DS Servo DS5160 SSG x 3
DS51_Arm_Disc x 3
arm_l1
arm_l2_30
servo clamp - wrist
servo clamp - wrist U
u gripper clamp
gripper motor
skf_bearing_608-z_2.stp x 2
5mm to 8mm flexible shaft coupler.stp
lead screw
smooth rod 5mm
5mm bush
grip move
sld_cpl
base j
base joiner
