samim-robotix/IRoCU-2024-ISRO-Rover/ISRO Total File/Robotic Arm/enc assm.SLDASM

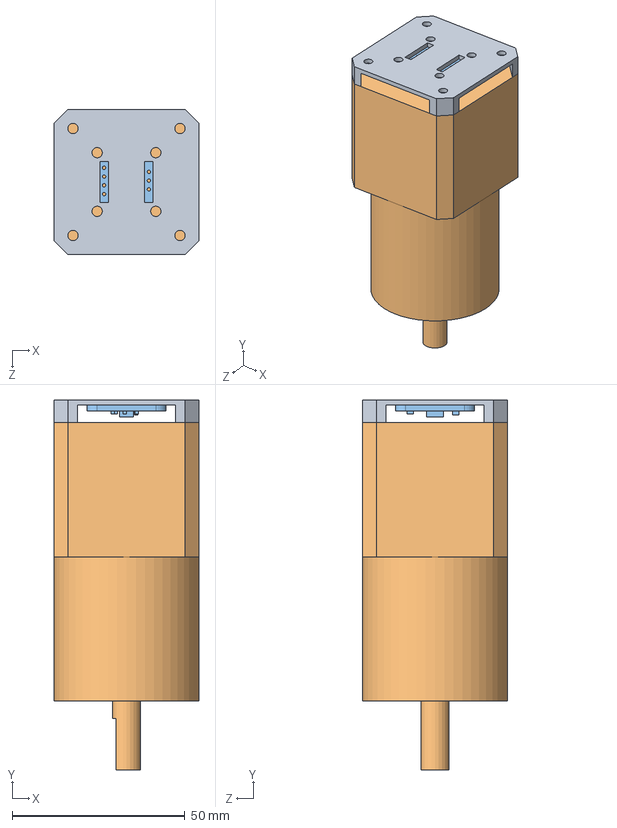
[picture p270: CAD file, 2026-10-19]
ISRO Total File/Robotic Arm/enc assm.SLDASM
42.0 x 107.2 x 42.0 mm
enc case
shoulder _elbow
AS5600 v1.step
