samim-robotix/IRoCU-2024-ISRO-Rover/ISRO Total File/Robotic Arm/arm_l1_assm.SLDASM

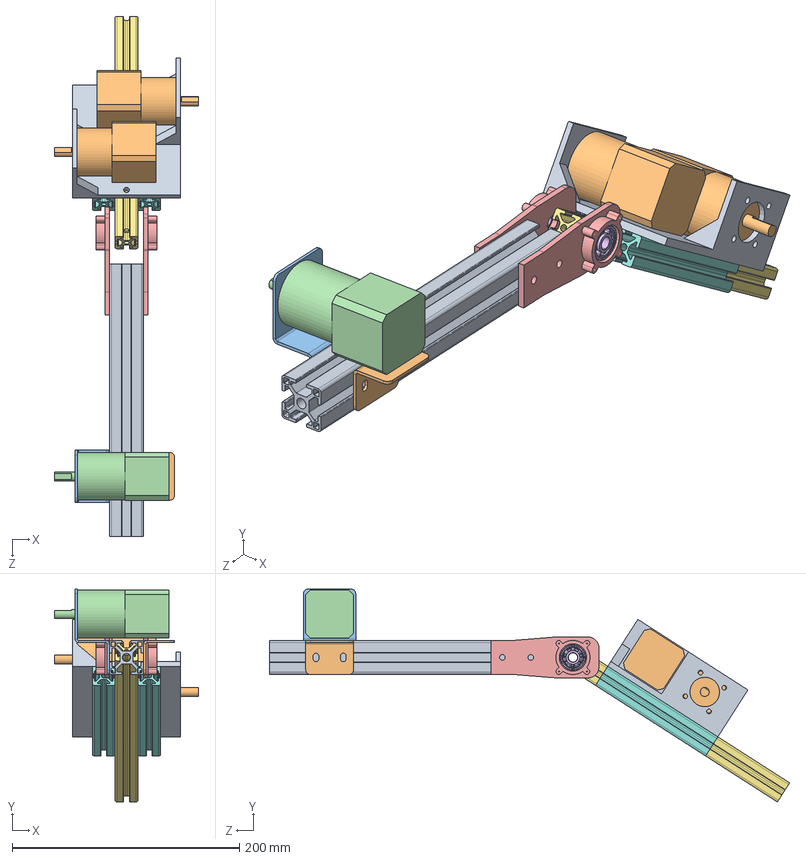
[picture p271: CAD file, 2026-10-19]
ISRO Total File/Robotic Arm/arm_l1_assm.SLDASM
127.0 x 187.3 x 457.6 mm
arm_l1
el_mt_sup
el_mt_clmp
wheel motor
elbow_link_1 x 2
skf_bearing_608-z_2.stp x 2
arm_l2_20
arm_l2_20 -supp x 2
wrist motor clamp
wrist motor x 2
