samim-robotix/IRoCU-2024-ISRO-Rover/ISRO Total File/ARM/tp2.SLDPRT

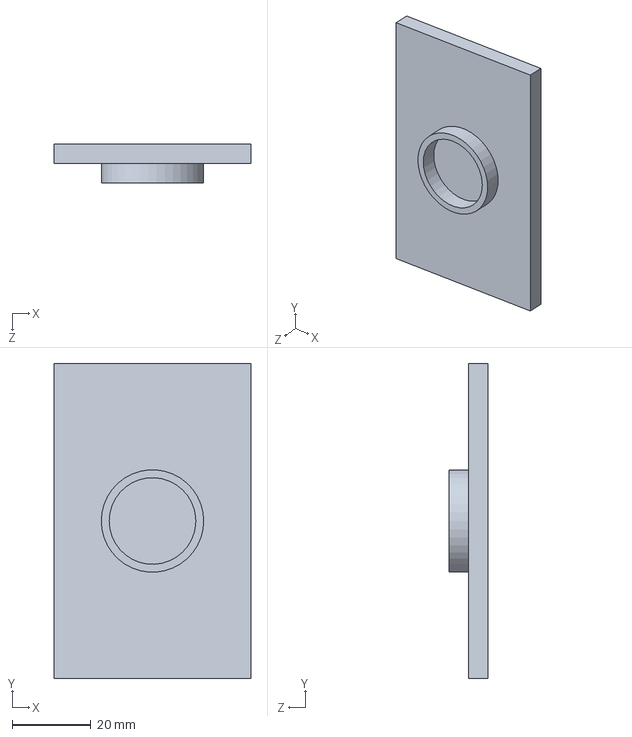
[picture p272: CAD file, 2026-10-19]
ISRO Total File/ARM/tp2.SLDPRT
50.0 x 80.0 x 10.0 mm
