samim-robotix/IRoCU-2024-ISRO-Rover/ISRO Total File/BOT/wheel.SLDPRT

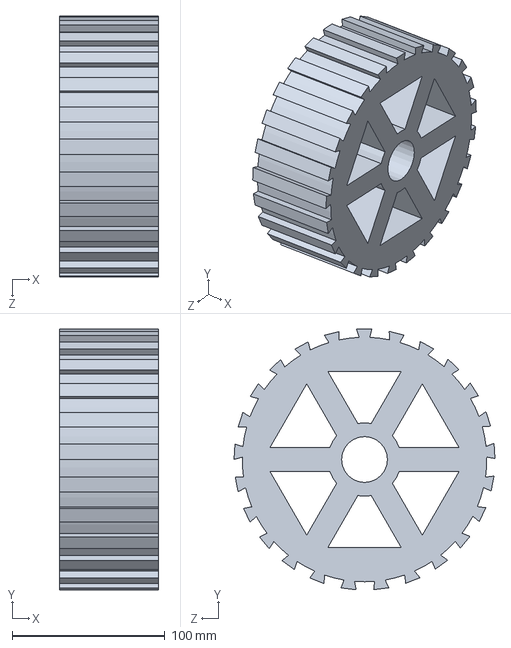
[picture p273: CAD file, 2026-10-19]
ISRO Total File/BOT/wheel.SLDPRT
65.0 x 170.5 x 170.8 mm
