samim-robotix/IRoCU-2024-ISRO-Rover/ISRO Total File/Electronics/xt60_faceplate.SLDPRT

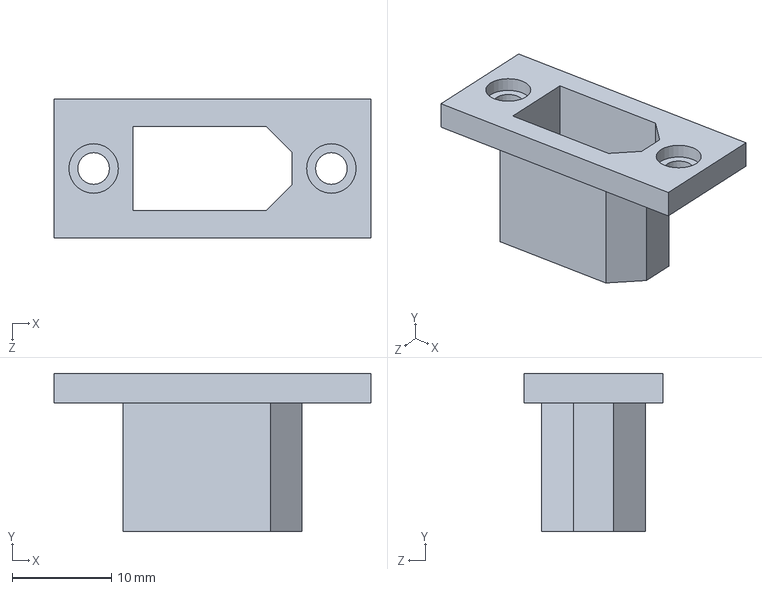
[picture p274: CAD file, 2026-10-19]
ISRO Total File/Electronics/xt60_faceplate.SLDPRT
32.0 x 16.0 x 14.0 mm
