samim-robotix/IRoCU-2024-ISRO-Rover/ISRO Total File/New Designs/rim.STEP

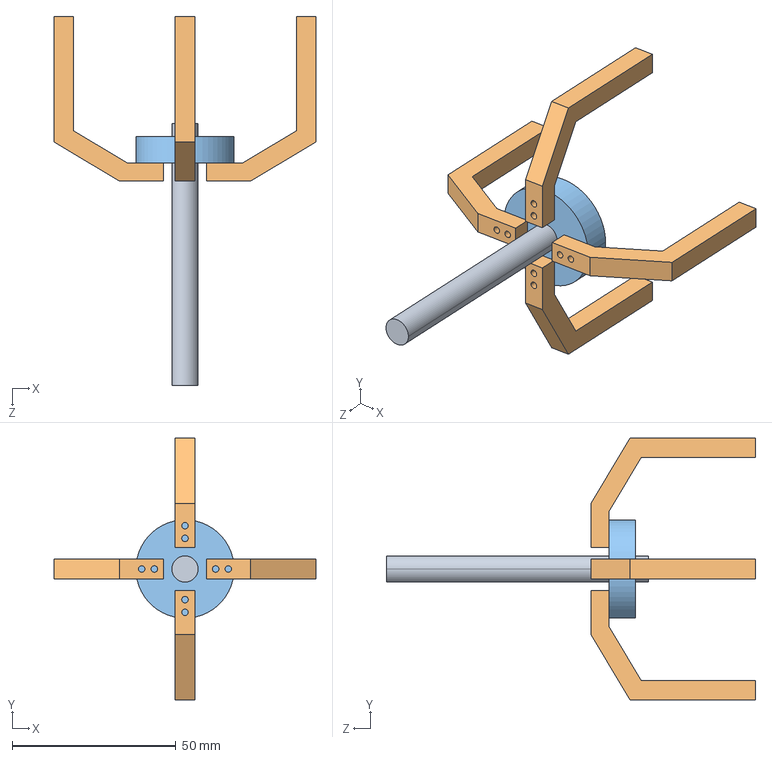
[picture p275: CAD file, 2026-10-19]
ISRO Total File/New Designs/rim.STEP
80.0 x 80.0 x 112.7 mm
