samim-robotix/IRoCU-2024-ISRO-Rover/ISRO Total File/OBS_Chassis/RB parts/30 RR.SLDPRT

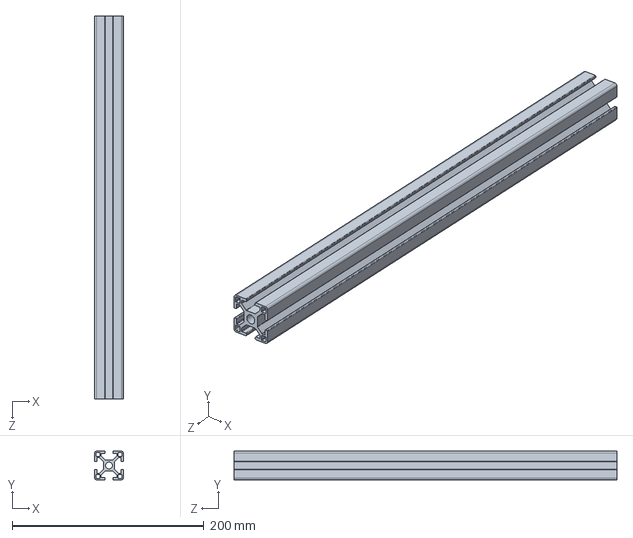
[picture p276: CAD file, 2026-10-19]
ISRO Total File/OBS_Chassis/RB parts/30 RR.SLDPRT
30.0 x 30.0 x 400.0 mm
