samim-robotix/IRoCU-2024-ISRO-Rover/ISRO Total File/OBS_Chassis/T45.SLDPRT

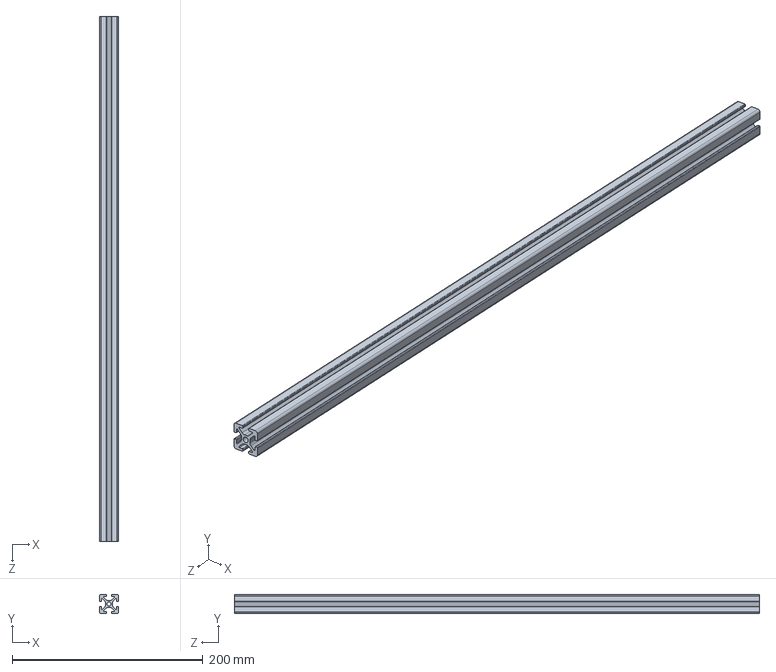
[picture p277: CAD file, 2026-10-19]
ISRO Total File/OBS_Chassis/T45.SLDPRT
20.0 x 20.0 x 550.0 mm
