samim-robotix/IRoCU-2024-ISRO-Rover/ISRO Total File/RoboML/tp2.SLDPRT

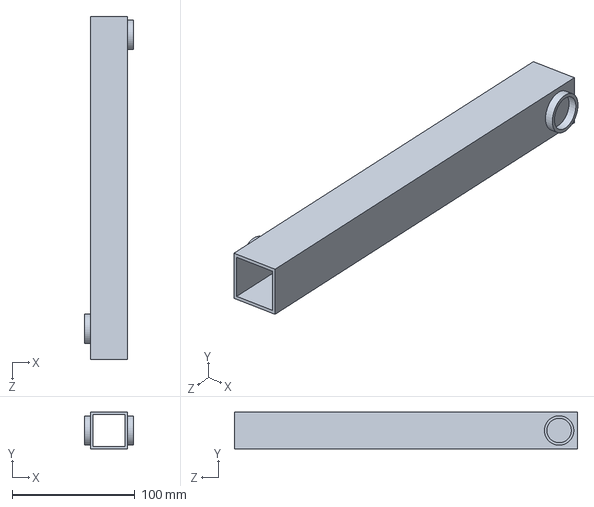
[picture p278: CAD file, 2026-10-19]
ISRO Total File/RoboML/tp2.SLDPRT
40.0 x 30.0 x 280.0 mm
