samim-robotix/IRoCU-2024-ISRO-Rover/ISRO Total File/Robotic Arm/146552629-7-skf_bearing_51118_2/skf_bearing_51118_2_01.SLDPRT

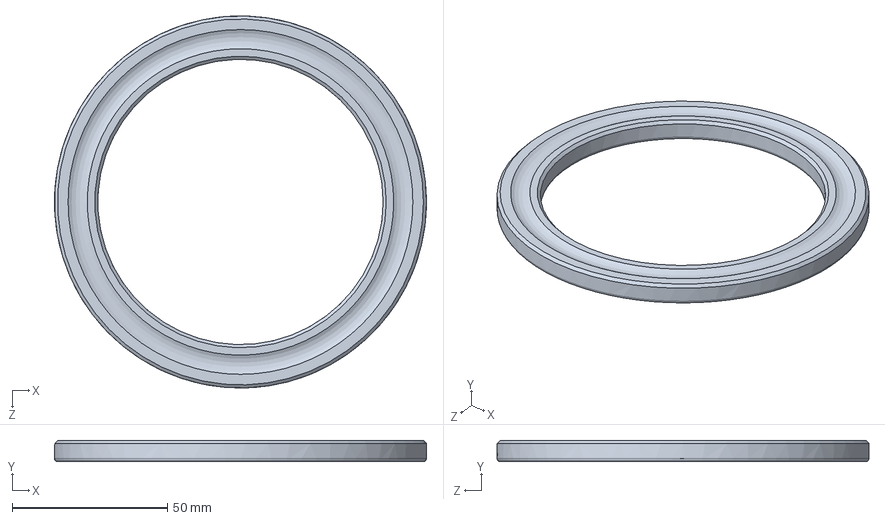
[picture p279: CAD file, 2026-10-19]
ISRO Total File/Robotic Arm/146552629-7-skf_bearing_51118_2/skf_bearing_51118_2_01.SLDPRT
120.0 x 6.87 x 120.0 mm
