samim-robotix/IRoCU-2024-ISRO-Rover/ISRO Total File/Robotic Arm/146972118-19-skf_bearing_608-z_2/skf_bearing_608-z_2.stp

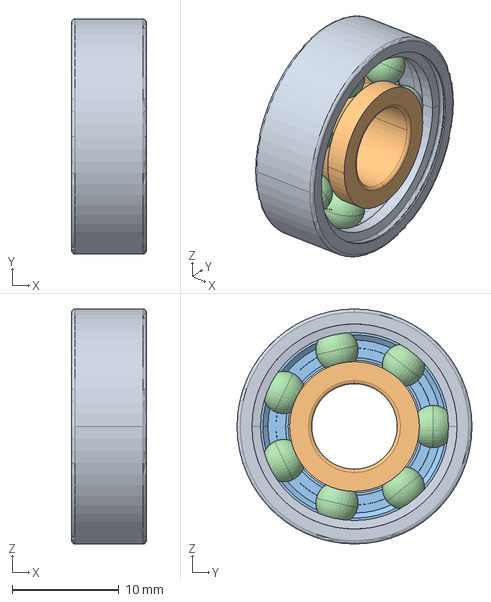
[picture p280: CAD file, 2026-10-19]
ISRO Total File/Robotic Arm/146972118-19-skf_bearing_608-z_2/skf_bearing_608-z_2.stp
7.00 x 22.0 x 22.0 mm
