samim-robotix/IRoCU-2024-ISRO-Rover/ISRO Total File/Robotic Arm/Gripper/grip move.SLDPRT

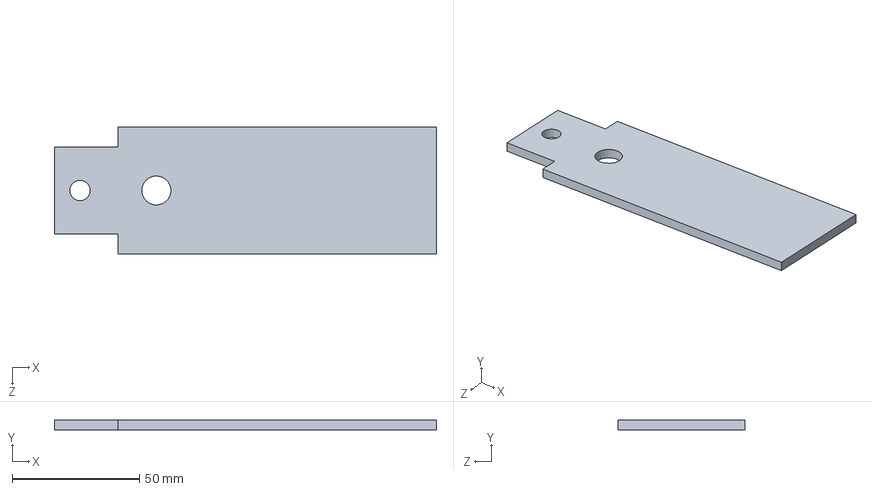
[picture p281: CAD file, 2026-10-19]
ISRO Total File/Robotic Arm/Gripper/grip move.SLDPRT
150.0 x 4.00 x 50.0 mm
