samim-robotix/IRoCU-2024-ISRO-Rover/ISRO Total File/Robotic Arm/Gripper/robot-servo-motor-gripper-1.snapshot.3/Assembly/Joint rod.SLDPRT

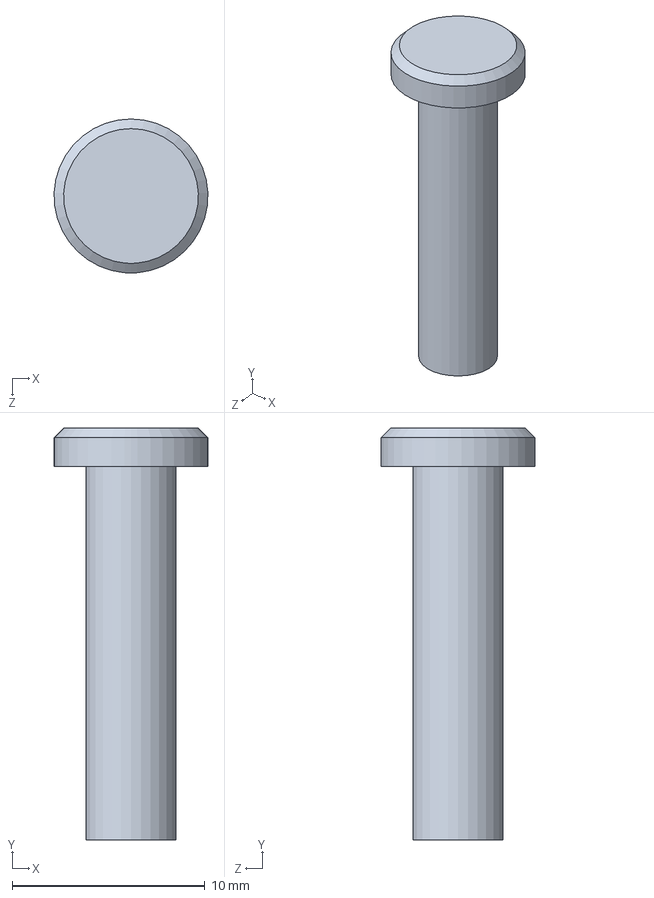
[picture p282: CAD file, 2026-10-19]
ISRO Total File/Robotic Arm/Gripper/robot-servo-motor-gripper-1.snapshot.3/Assembly/Joint rod.SLDPRT
7.99 x 21.4 x 8.00 mm
