samim-robotix/IRoCU-2024-ISRO-Rover/ISRO Total File/Robotic Arm/Robo Arm Assem/el_mt_sup.SLDPRT

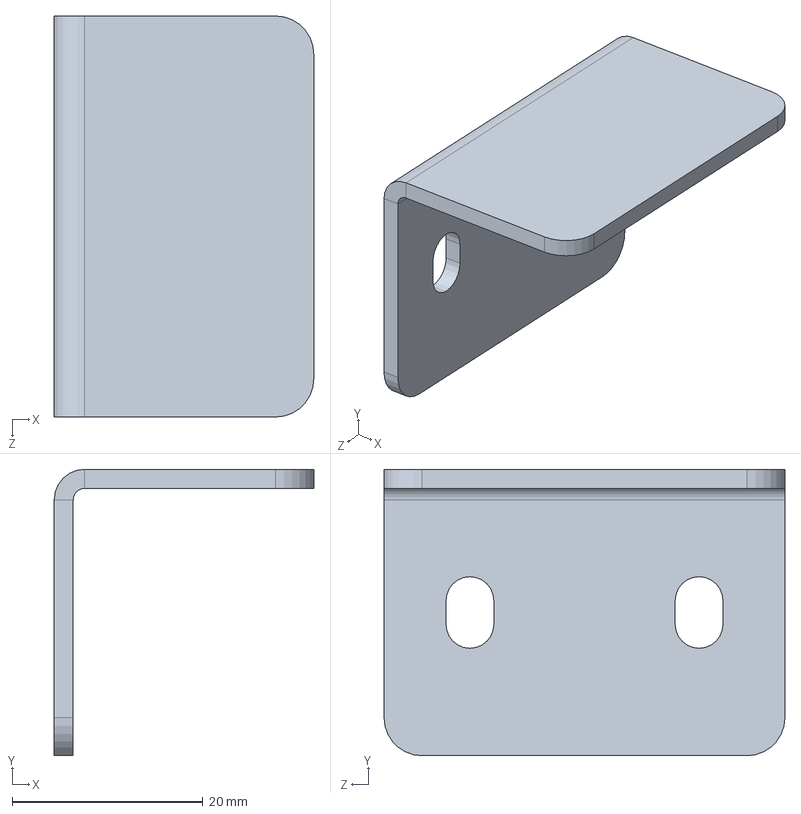
[picture p283: CAD file, 2026-10-19]
ISRO Total File/Robotic Arm/Robo Arm Assem/el_mt_sup.SLDPRT
27.2 x 30.0 x 42.0 mm
