samim-robotix/IRoCU-2024-ISRO-Rover/ISRO Total File/Robotic Arm/roboarm-backup.IGS

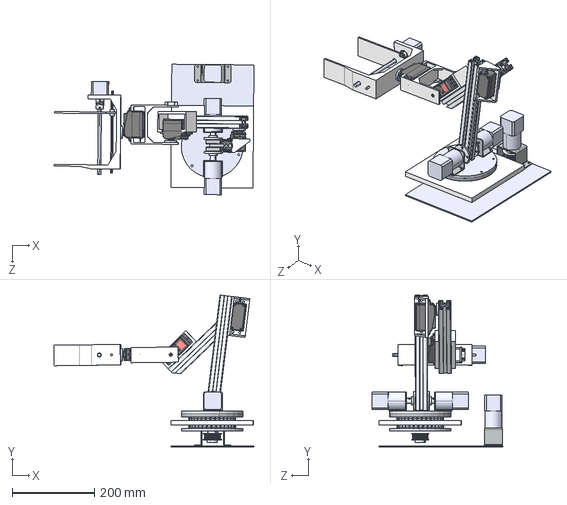
[picture p284: CAD file, 2026-10-19]
ISRO Total File/Robotic Arm/roboarm-backup.IGS
486.8 x 369.9 x 317.8 mm
