samim-robotix/IRoCU-2024-ISRO-Rover/ISRO Total File/Robotic Arm/simple-gripper-with-high-gripping-force-2.snapshot.5/Assieme_pinza_rds2.stp

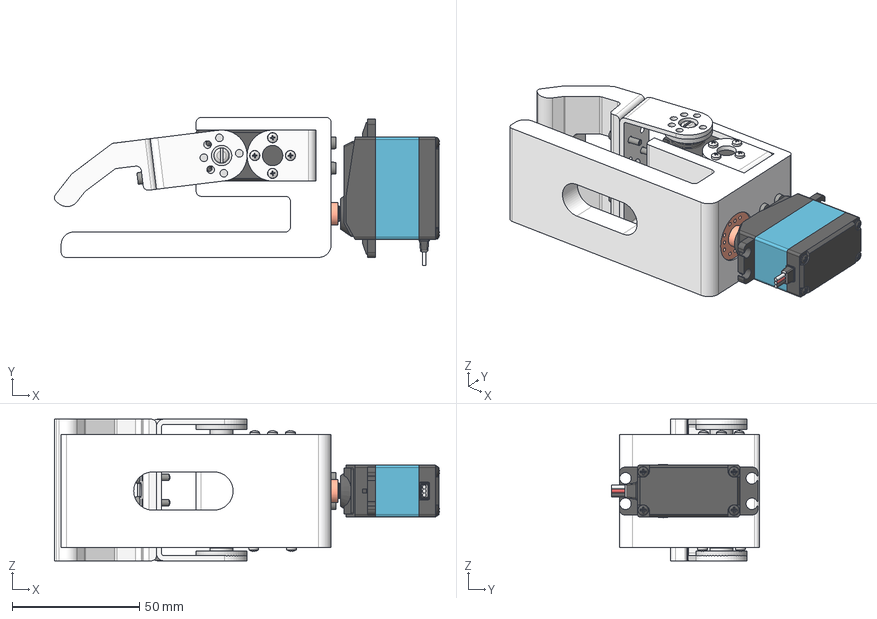
[picture p285: CAD file, 2026-10-19]
ISRO Total File/Robotic Arm/simple-gripper-with-high-gripping-force-2.snapshot.5/Assieme_pinza_rds2.stp
151.1 x 58.2 x 55.6 mm
GE_57
DUOPAN-SG
DUOPAN-DG
ZJ-DUAN
corpo_3ds3120
ANSI B18.6.5M - 2.2x0.8 x 4(9) x 8
mano
DS3225MG Servo 25Kg 4.8-6.8V B
DS3225MG Servo 25Kg 4.8-6.8V A
DS3225MG Servo 25Kg 4.8-6.8V C
FS5109M_palo C
Vite a testa cilindrica incassata esalobulare ISO 14580 - M2,5x12-4.8 x 8
AS 1427 - M3 x 8
FS5109M_vis arbre M3 x 6
griffa_alta
AS 1112 - M2,5 Tipo 5 x 4
ZJ-CHANG
