samim-robotix/IRoCU-2024-ISRO-Rover/ISRO Total File/Robotic Arm/WXA-250-6DOF/WXA-250-6DOF-MOBILE.step

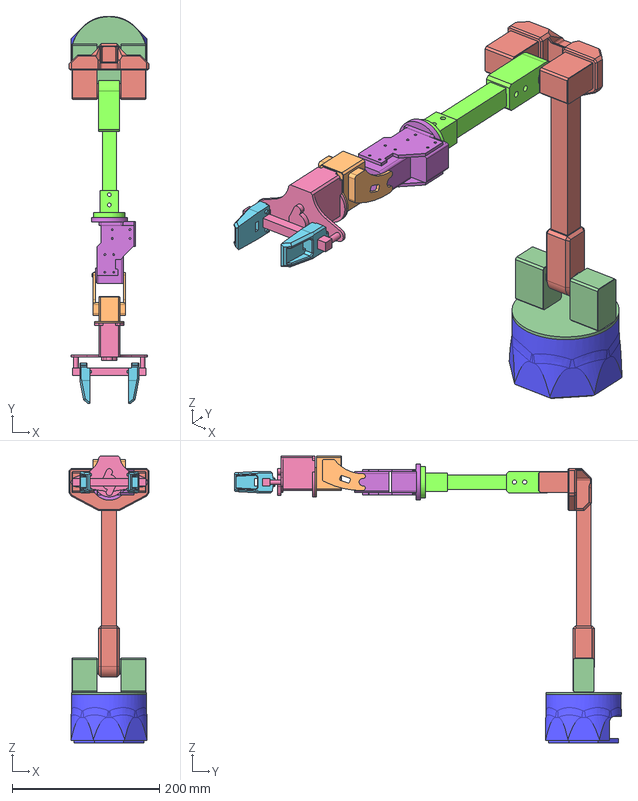
[picture p286: CAD file, 2026-10-19]
ISRO Total File/Robotic Arm/WXA-250-6DOF/WXA-250-6DOF-MOBILE.step
108.2 x 525.2 x 389.1 mm
SIMPLIFIED - WXA-250-6DOF Upper Forearm v3
430 Dual Shoulder v2
SIMPLIFIED - XM-430 Base Mobile v3 x 4
SRG Carriage With Finger v3 x 2
UA - 6 - WX-250 v2
SRG v3 x 2
430 - Wrist v3
SIMPLIFIED - WXA-250-6DOF Lower Forearm v4
