samim-robotix/IRoCU-2024-ISRO-Rover/ISRO Total File/usb-type-a-housing-case20221211-228130-ea8r07/jinner/usb-type-a-housing-case/Case_lower.stl

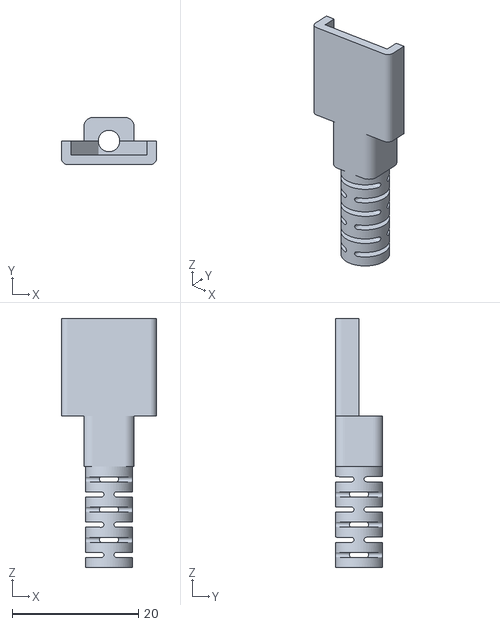
[picture p287: CAD file, 2026-10-19]
ISRO Total File/usb-type-a-housing-case20221211-228130-ea8r07/jinner/usb-type-a-housing-case/Case_lower.stl
15.1 x 7.50 x 39.5
