samim-robotix/IRoCU-2024-ISRO-Rover/ISRO Total File/ARM/base j.SLDPRT

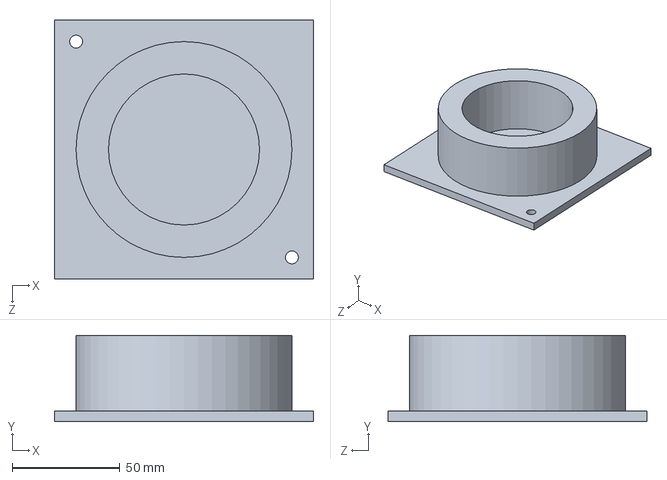
[picture p288: CAD file, 2026-10-19]
ISRO Total File/ARM/base j.SLDPRT
120.0 x 40.0 x 120.0 mm
