samim-robotix/IRoCU-2024-ISRO-Rover/ISRO Total File/BOT/diff arm 2b.SLDPRT

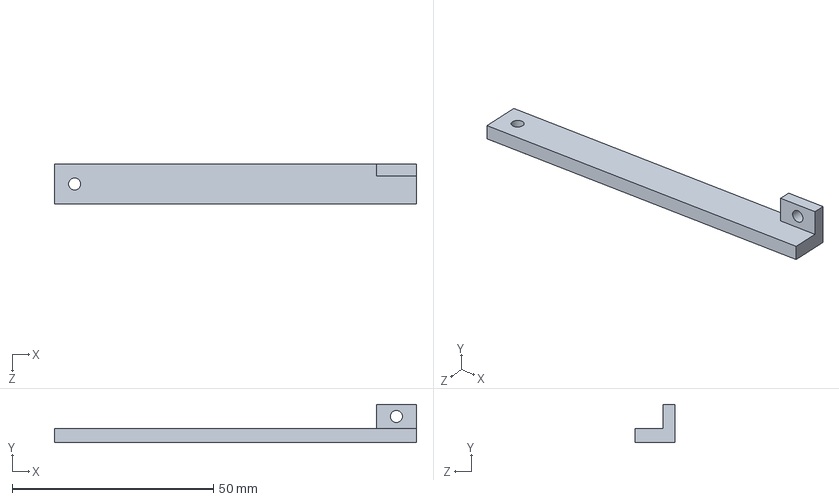
[picture p289: CAD file, 2026-10-19]
ISRO Total File/BOT/diff arm 2b.SLDPRT
90.0 x 9.50 x 10.0 mm
