samim-robotix/IRoCU-2024-ISRO-Rover/ISRO Total File/RoboML/tp1.SLDPRT

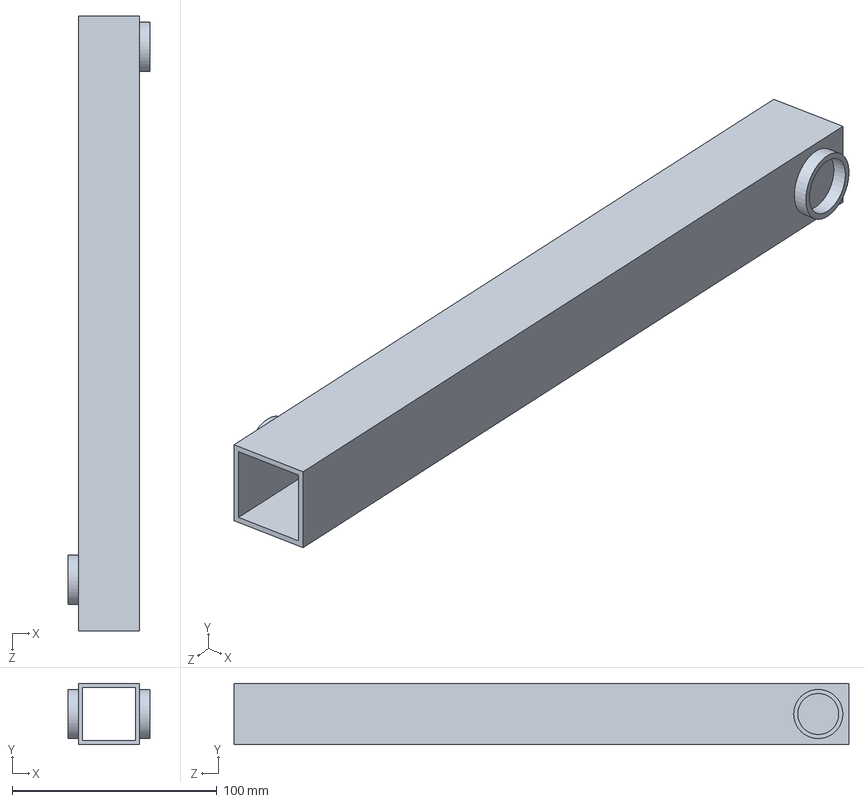
[picture p290: CAD file, 2026-10-19]
ISRO Total File/RoboML/tp1.SLDPRT
40.0 x 30.0 x 300.0 mm
