samim-robotix/IRoCU-2024-ISRO-Rover/ISRO Total File/Robotic Arm/Gripper/5mm bush.SLDPRT

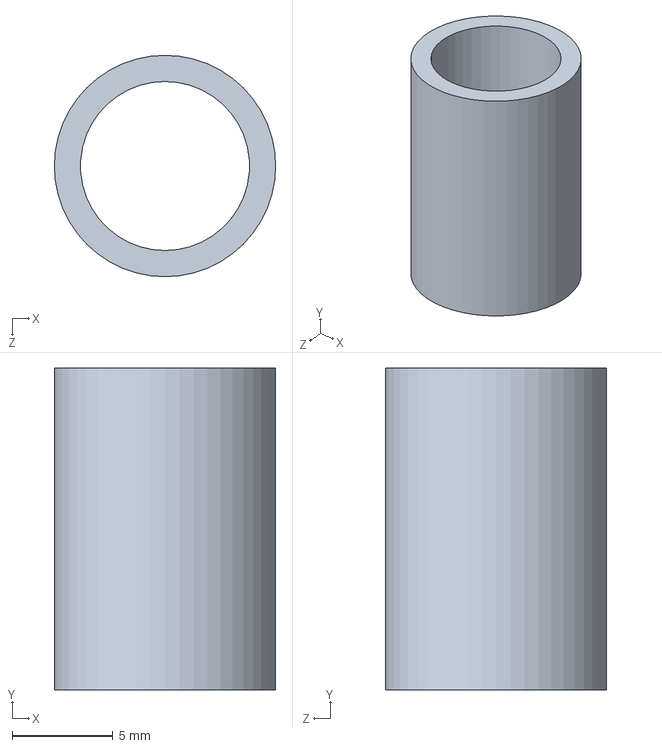
[picture p291: CAD file, 2026-10-19]
ISRO Total File/Robotic Arm/Gripper/5mm bush.SLDPRT
11.0 x 16.0 x 11.0 mm
