samim-robotix/IRoCU-2024-ISRO-Rover/ISRO Total File/Robotic Arm/Gripper/robot-servo-motor-gripper-1.snapshot.3/Assembly/17HS3001-280N.SLDPRT

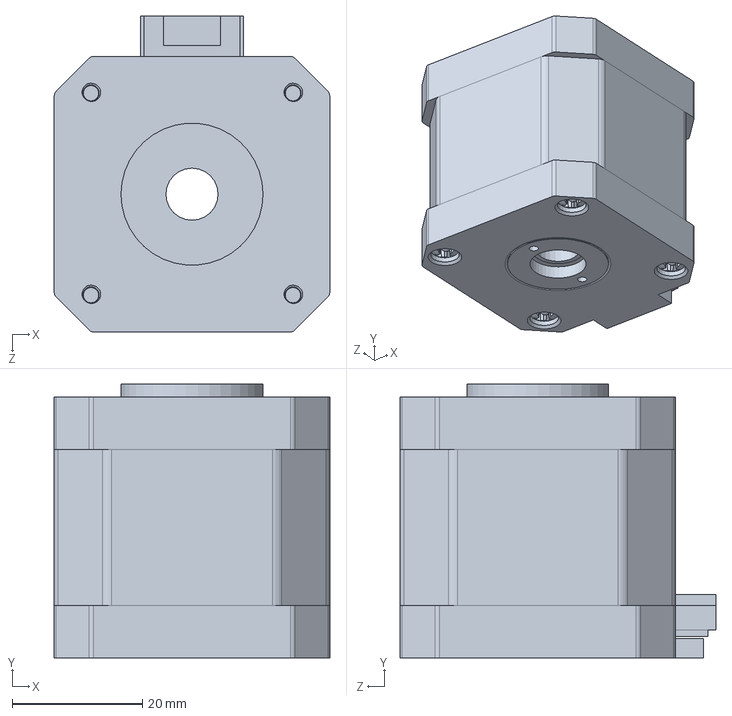
[picture p292: CAD file, 2026-10-19]
ISRO Total File/Robotic Arm/Gripper/robot-servo-motor-gripper-1.snapshot.3/Assembly/17HS3001-280N.SLDPRT
42.3 x 42.0 x 48.5 mm
