samim-robotix/IRoCU-2024-ISRO-Rover/ISRO Total File/Robotic Arm/misc/shldr cpl wld.SLDPRT

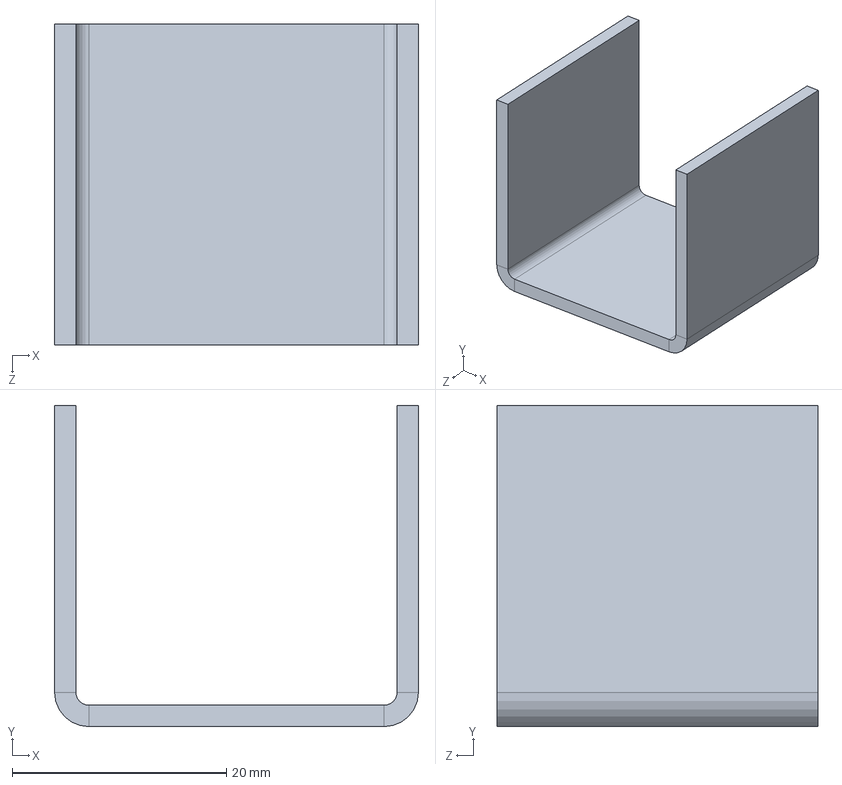
[picture p293: CAD file, 2026-10-19]
ISRO Total File/Robotic Arm/misc/shldr cpl wld.SLDPRT
34.0 x 30.0 x 30.0 mm
