samim-robotix/IRoCU-2024-ISRO-Rover/ISRO Total File/Robotic Arm/Robo Arm Assem/shoulder _elbow.SLDPRT

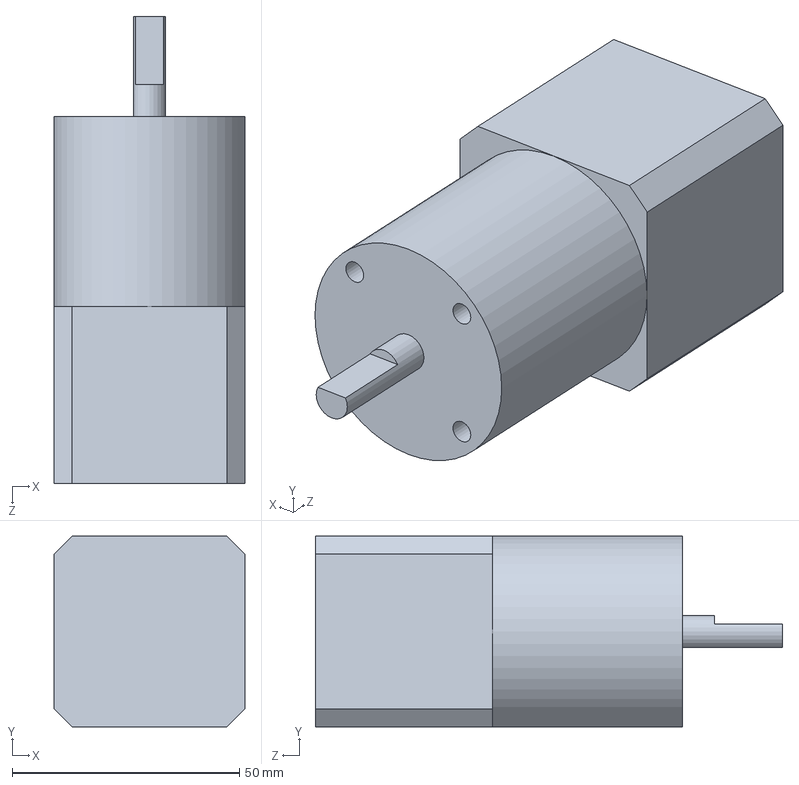
[picture p294: CAD file, 2026-10-19]
ISRO Total File/Robotic Arm/Robo Arm Assem/shoulder _elbow.SLDPRT
42.0 x 42.0 x 102.8 mm
