samim-robotix/IRoCU-2024-ISRO-Rover/ISRO Total File/Robotic Arm/simple-gripper-with-high-gripping-force-2.snapshot.5/Assieme_pinza_rds.stp

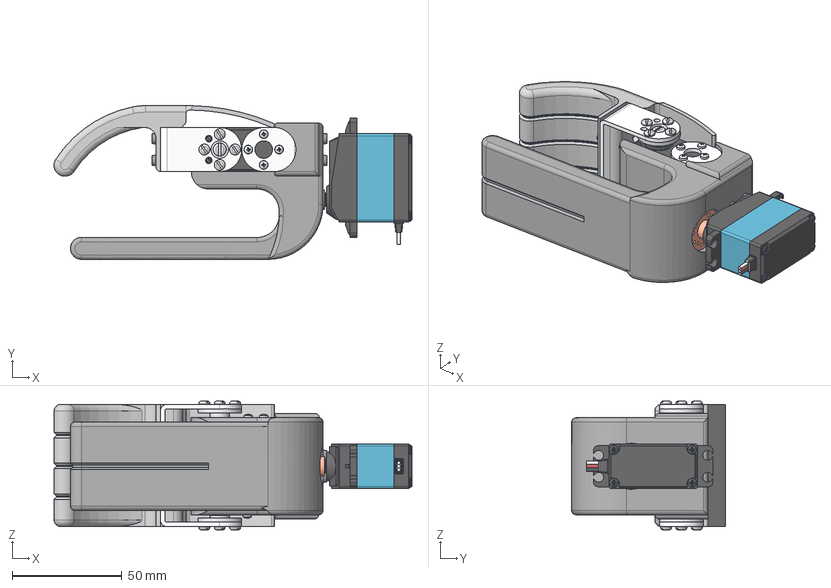
[picture p295: CAD file, 2026-10-19]
ISRO Total File/Robotic Arm/simple-gripper-with-high-gripping-force-2.snapshot.5/Assieme_pinza_rds.stp
163.0 x 70.0 x 58.6 mm
GE_57
DUOPAN-SG
DUOPAN-DG
ZJ-CHANG
ZJ-DUAN
corpo_3ds3120
AS 1427 - M2,5 x 4(3) x 8
ANSI B18.6.5M - 2.2x0.8 x 4(9) x 8
dita
mano
DS3225MG Servo 25Kg 4.8-6.8V B
DS3225MG Servo 25Kg 4.8-6.8V A
DS3225MG Servo 25Kg 4.8-6.8V C
FS5109M_vis arbre M3 x 6
FS5109M_palo C
Vite a testa cilindrica incassata esalobulare ISO 14580 - M2,5x3-4.8 x 8
AS 1427 - M3 x 8
