samim-robotix/IRoCU-2024-ISRO-Rover/ISRO Total File/Robotic Arm/WXA-250-6DOF/WXA-250-6DOF.step

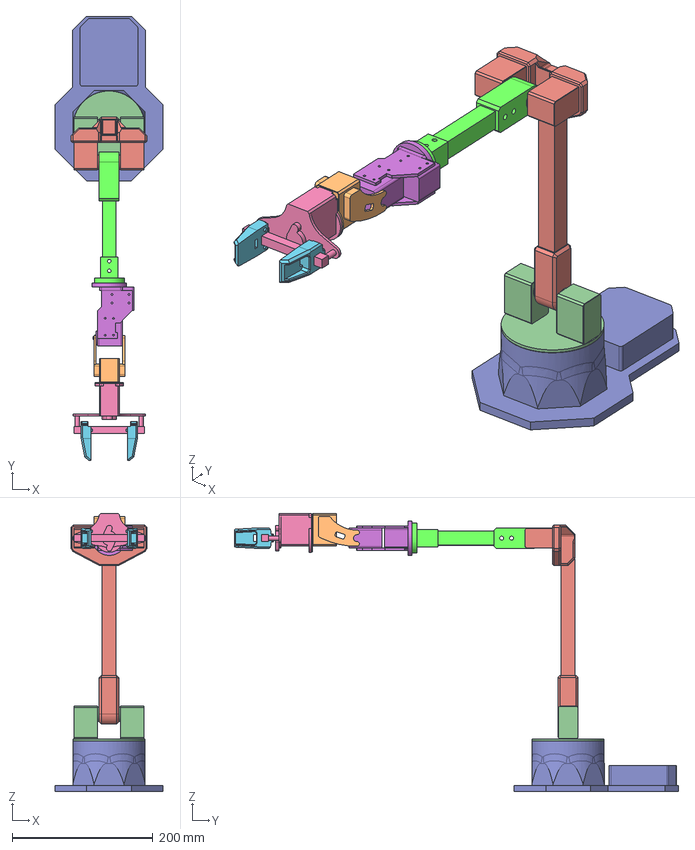
[picture p296: CAD file, 2026-10-19]
ISRO Total File/Robotic Arm/WXA-250-6DOF/WXA-250-6DOF.step
153.1 x 631.2 x 395.5 mm
430 Base v3
430 Dual Shoulder v2
UA - 6 - WX-250 v2
SIMPLIFIED - WXA-250-6DOF Upper Forearm v3
SIMPLIFIED - WXA-250-6DOF Lower Forearm v4
430 - Wrist v3
SRG v3 (1)
SRG Carriage With Finger v3 x 2
SRG v3
