samim-robotix/IRoCU-2024-ISRO-Rover/ISRO Total File/ARM/wheel mill 1.SLDPRT

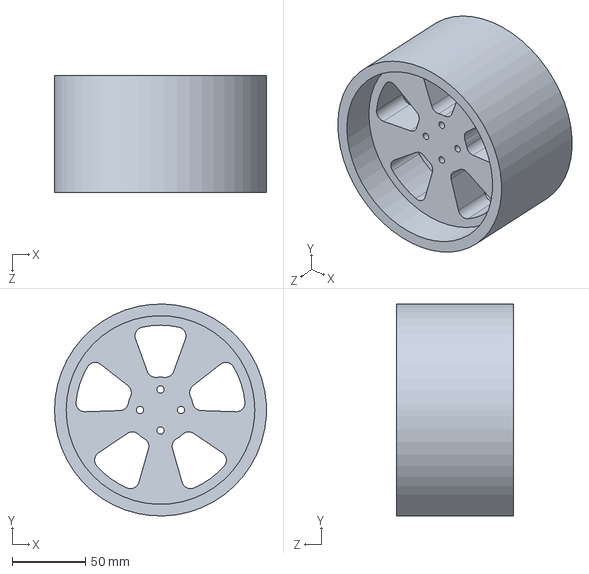
[picture p298: CAD file, 2026-10-19]
ISRO Total File/ARM/wheel mill 1.SLDPRT
145.0 x 144.9 x 80.0 mm
