samim-robotix/IRoCU-2024-ISRO-Rover/ISRO Total File/BOT/arena.SLDPRT

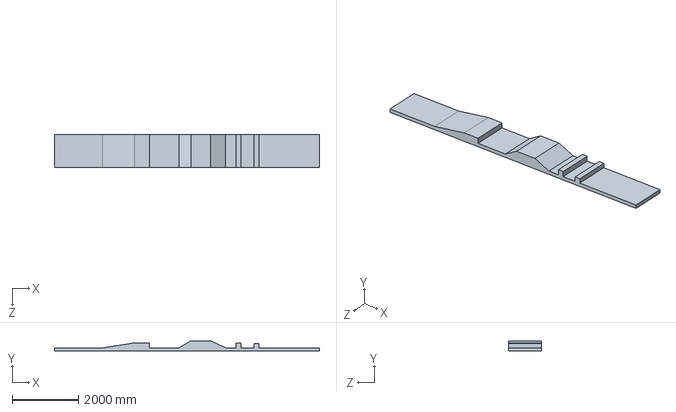
[picture p299: CAD file, 2026-10-19]
ISRO Total File/BOT/arena.SLDPRT
8000.0 x 312.1 x 1000.0 mm
