samim-robotix/IRoCU-2024-ISRO-Rover/ISRO Total File/New Designs/motor mount1.SLDPRT

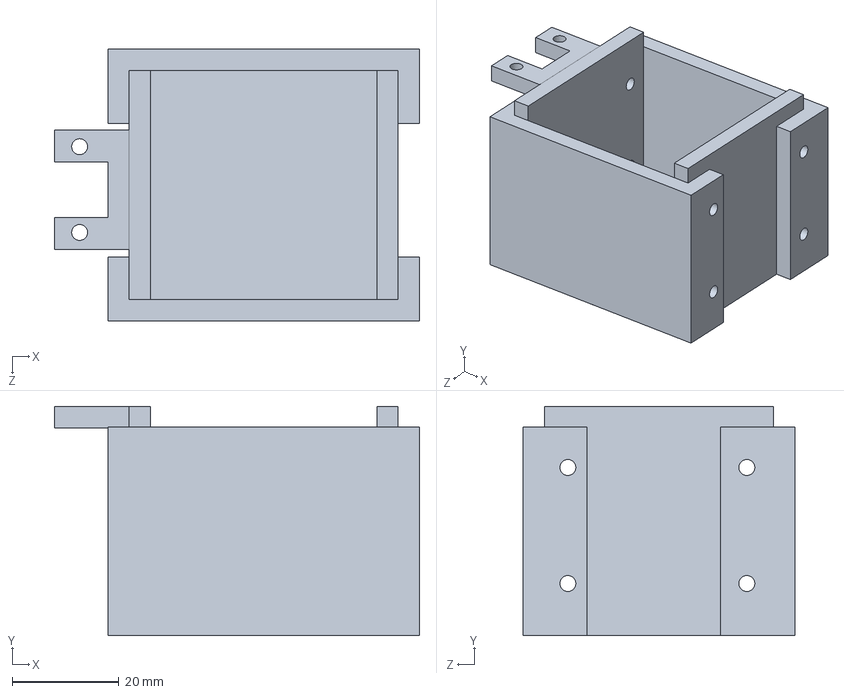
[picture p300: CAD file, 2026-10-19]
ISRO Total File/New Designs/motor mount1.SLDPRT
68.5 x 43.0 x 51.0 mm
