samim-robotix/IRoCU-2024-ISRO-Rover/ISRO Total File/OBS_Chassis/KP000.stp

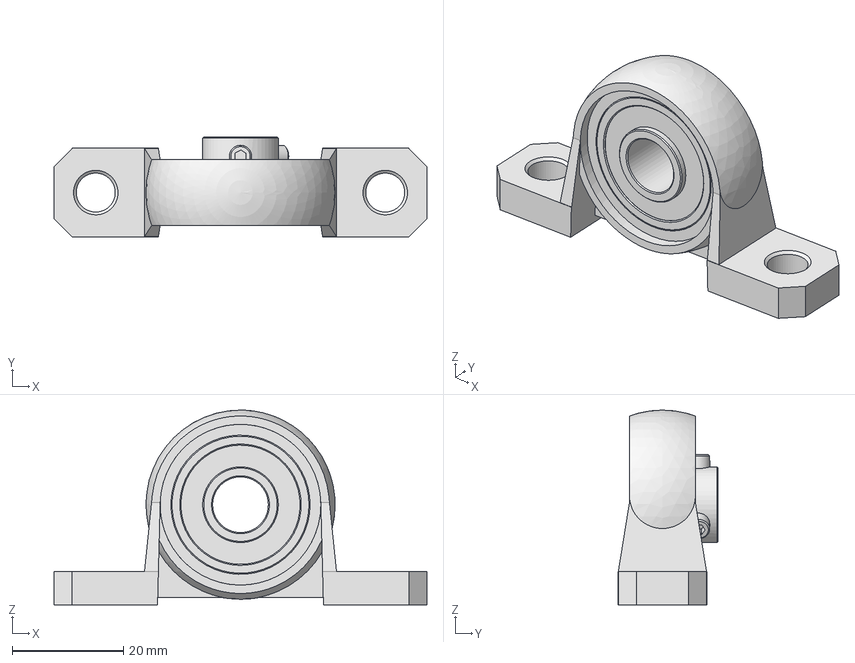
[picture p301: CAD file, 2026-10-19]
ISRO Total File/OBS_Chassis/KP000.stp
67.0 x 18.0 x 35.0 mm
