samim-robotix/IRoCU-2024-ISRO-Rover/ISRO Total File/OBS_Chassis/RB parts/2nd piv 2.SLDPRT

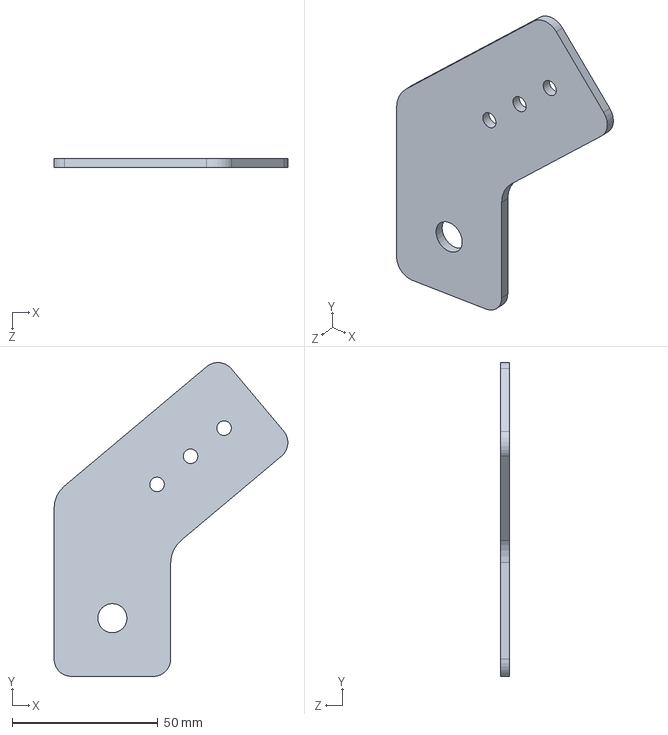
[picture p302: CAD file, 2026-10-19]
ISRO Total File/OBS_Chassis/RB parts/2nd piv 2.SLDPRT
80.2 x 107.7 x 3.00 mm
