samim-robotix/IRoCU-2024-ISRO-Rover/ISRO Total File/RoboML/servo clamp - wrist U.SLDPRT

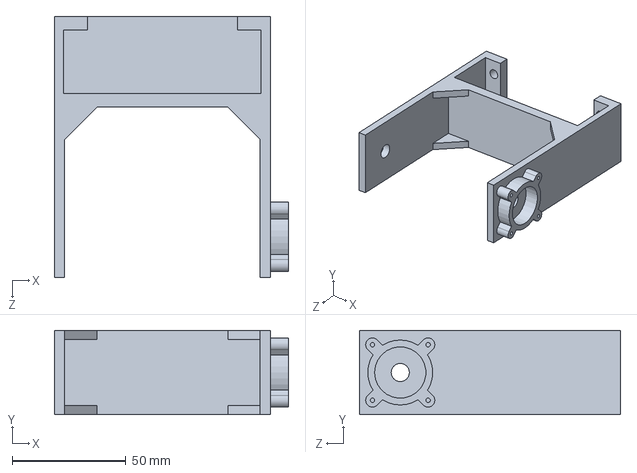
[picture p303: CAD file, 2026-10-19]
ISRO Total File/RoboML/servo clamp - wrist U.SLDPRT
103.0 x 37.0 x 115.0 mm
