samim-robotix/IRoCU-2024-ISRO-Rover/ISRO Total File/Robotic Arm/Gripper/robot-servo-motor-gripper-1.snapshot.3/Assembly/LCH0.SLDPRT

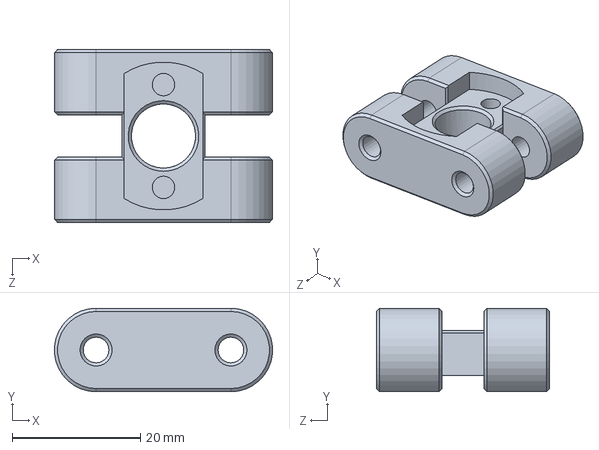
[picture p305: CAD file, 2026-10-19]
ISRO Total File/Robotic Arm/Gripper/robot-servo-motor-gripper-1.snapshot.3/Assembly/LCH0.SLDPRT
33.9 x 13.0 x 27.0 mm
