samim-robotix/IRoCU-2024-ISRO-Rover/ISRO Total File/Robotic Arm/misc/Bearing_Ball_6206_ZZ.SLDPRT

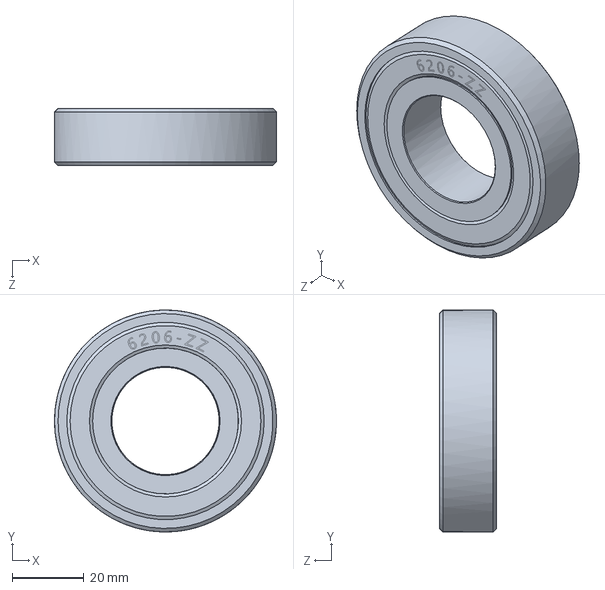
[picture p306: CAD file, 2026-10-19]
ISRO Total File/Robotic Arm/misc/Bearing_Ball_6206_ZZ.SLDPRT
62.0 x 62.0 x 16.0 mm
