samim-robotix/IRoCU-2024-ISRO-Rover/ISRO Total File/Robotic Arm/Robo Arm Assem/shoulder motor holder.SLDPRT

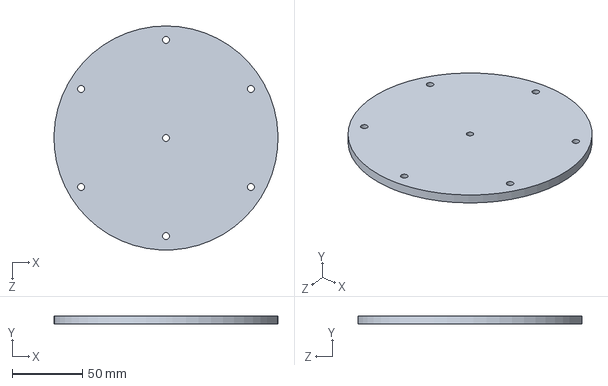
[picture p307: CAD file, 2026-10-19]
ISRO Total File/Robotic Arm/Robo Arm Assem/shoulder motor holder.SLDPRT
159.9 x 6.00 x 160.0 mm
