samim-robotix/IRoCU-2024-ISRO-Rover/ISRO Total File/Robotic Arm/STLS/u gripper clamp.STL

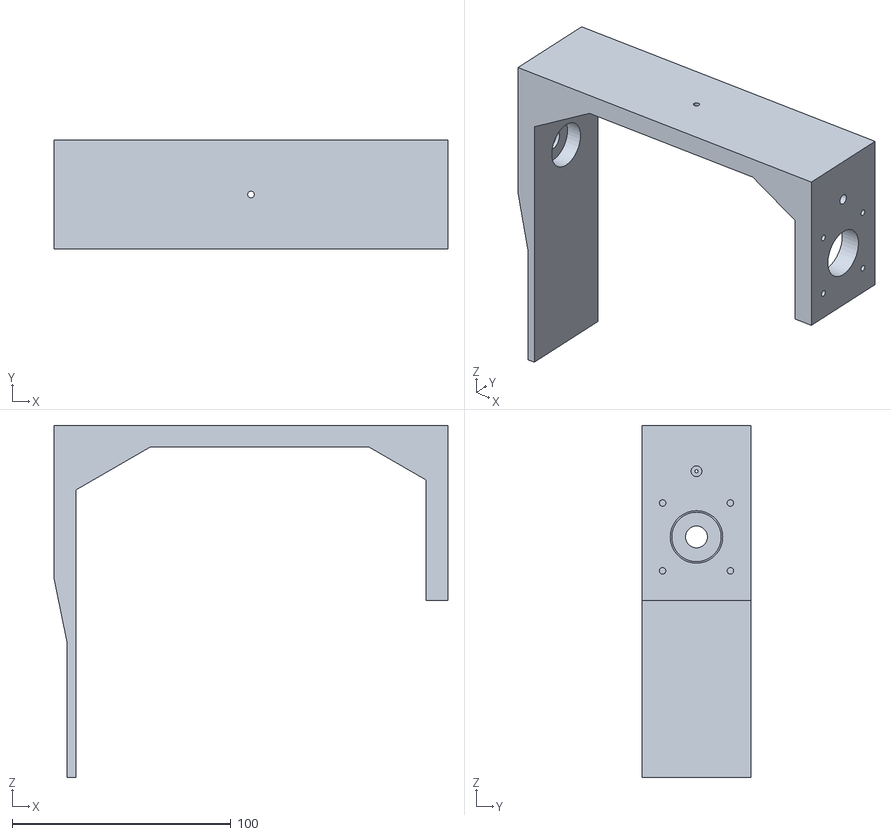
[picture p308: CAD file, 2026-10-19]
ISRO Total File/Robotic Arm/STLS/u gripper clamp.STL
180.0 x 50.0 x 161.0
