samim-robotix/IRoCU-2024-ISRO-Rover/ISRO Total File/BOT/rocker.SLDPRT

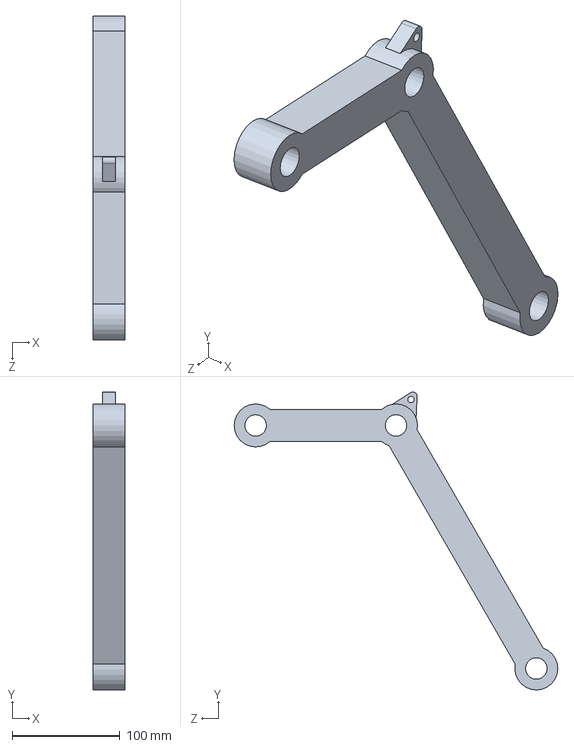
[picture p309: CAD file, 2026-10-19]
ISRO Total File/BOT/rocker.SLDPRT
30.0 x 277.1 x 301.0 mm
