samim-robotix/IRoCU-2024-ISRO-Rover/ISRO Total File/Electronics/XT60_Macho.STEP

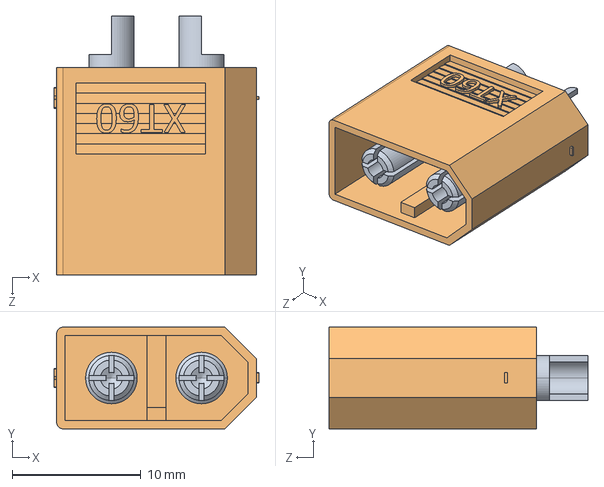
[picture p310: CAD file, 2026-10-19]
ISRO Total File/Electronics/XT60_Macho.STEP
15.9 x 7.90 x 20.1 mm
