samim-robotix/IRoCU-2024-ISRO-Rover/ISRO Total File/New Designs/wheel rim.STL

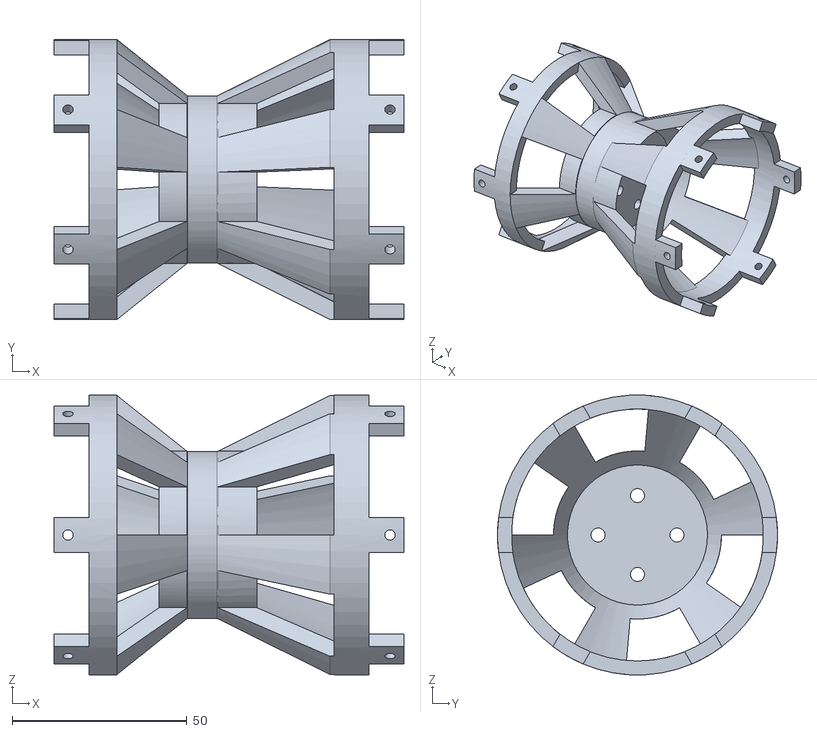
[picture p311: CAD file, 2026-10-19]
ISRO Total File/New Designs/wheel rim.STL
100.0 x 80.0 x 79.9
