samim-robotix/IRoCU-2024-ISRO-Rover/ISRO Total File/Robotic Arm/146552629-7-skf_bearing_51118_2/skf_bearing_51118_2_03.SLDPRT

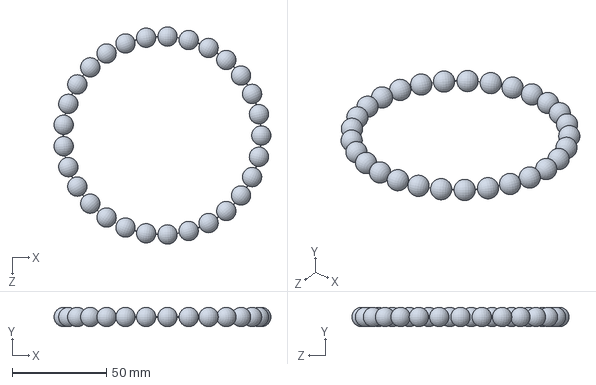
[picture p312: CAD file, 2026-10-19]
ISRO Total File/Robotic Arm/146552629-7-skf_bearing_51118_2/skf_bearing_51118_2_03.SLDPRT
115.0 x 10.3 x 115.1 mm
