samim-robotix/IRoCU-2024-ISRO-Rover/ISRO Total File/Robotic Arm/el_mt_clmp.SLDPRT

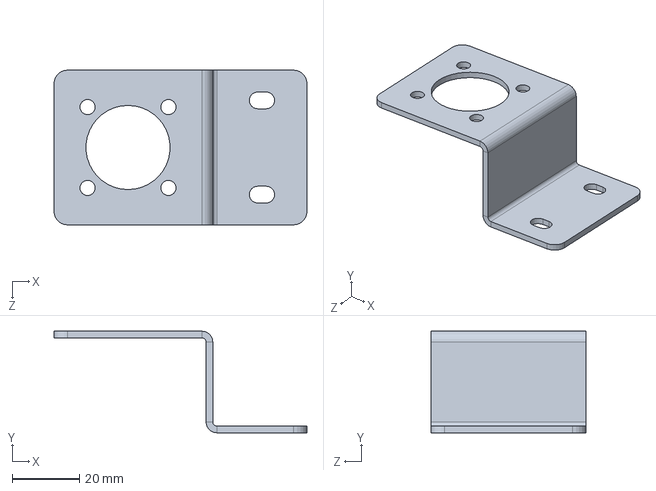
[picture p313: CAD file, 2026-10-19]
ISRO Total File/Robotic Arm/el_mt_clmp.SLDPRT
75.2 x 30.2 x 46.0 mm
