samim-robotix/IRoCU-2024-ISRO-Rover/ISRO Total File/Robotic Arm/Gripper/pinza_N20_DC3225MG.stp

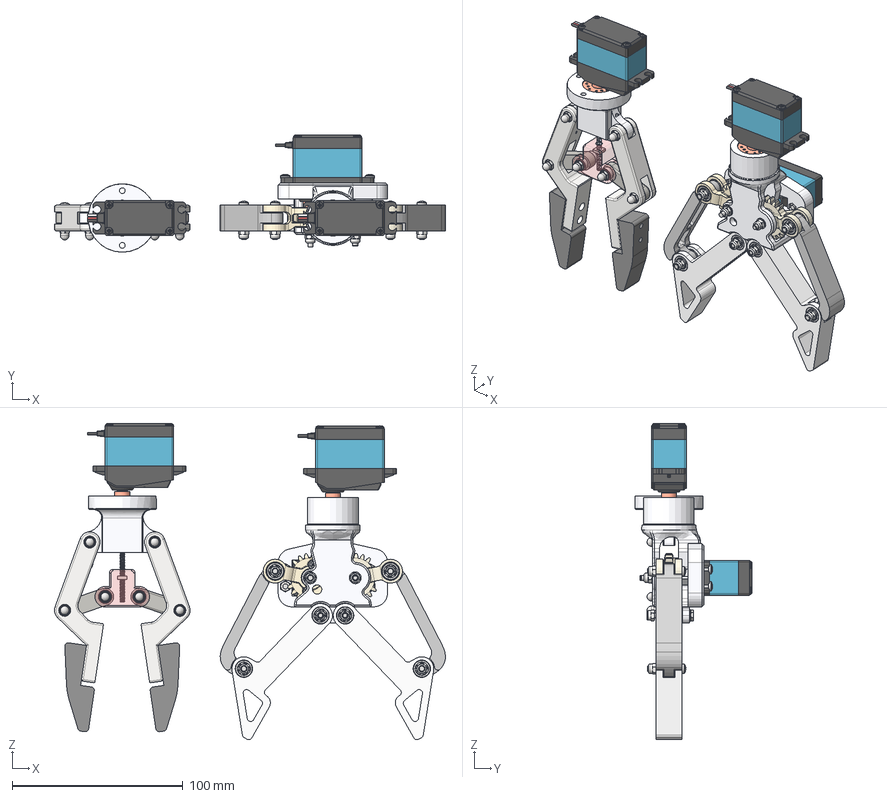
[picture p314: CAD file, 2026-10-19]
ISRO Total File/Robotic Arm/Gripper/pinza_N20_DC3225MG.stp
228.8 x 68.7 x 185.2 mm
épure pince x 2
leva
blovvo_vite_mobile
Motor Case
Rear Bearing
Front Bearing
Rotor
Spur 1-15_Spur01 x 3
Plate 1
Stand 2 x 2
Spur 2-24_Spur01
Plate 2
Spur 2-15_Spur01
Spur 1-26_Spur01
Stand 4 x 2
Spur 1-24_Spur01
countersunk flat head cross recess screw_iso_ISO 7046-1 - M2 x 12 - Z --- 12N x 2
Rear Cover
Plate 3
AS 1474 - M3
albero-M3_140922
blocco_motore
griffa
KS B 2023 - 693 - 3 x 8 x 3 x 12
leva_MIR
griffa_MIR
rondella_3x0.5 x 13
AS 1427 - M3 x 16 x 6
UN 5721 - M3 x 6
bâti
Rondelle ISO 7089 - 3 x 21
Vis ISO 7045 - M3 x 12 x 4
Ecrou JIS B 1181 H M3 x 4
Vis H ISO 4017 - M3 x 25-N x 3
DIN EN ISO 7040 - M3 - N x 8
Vis ISO 7045 - M3 x 16
FS5109M_vis arbre M3 x 6 x 3
FS5109M_palo C x 3
secteur récepteur
STN 024640 SKF (D) - SKF 623-2Z x 15
secteur moteur
vis Parker 2 x 12 x 2
bielle longue x 2
Vis ISO 7045 - M3 x 20 x 4
pinza_a x 2
DS3225MG Servo 25Kg 4.8-6.8V B x 3
DS3225MG Servo 25Kg 4.8-6.8V A x 3
DS3225MG Servo 25Kg 4.8-6.8V C x 3
griffa_N20 x 2
