samim-robotix/IRoCU-2024-ISRO-Rover/ISRO Total File/Robotic Arm/Robo Arm Assem/plate pipe.SLDPRT

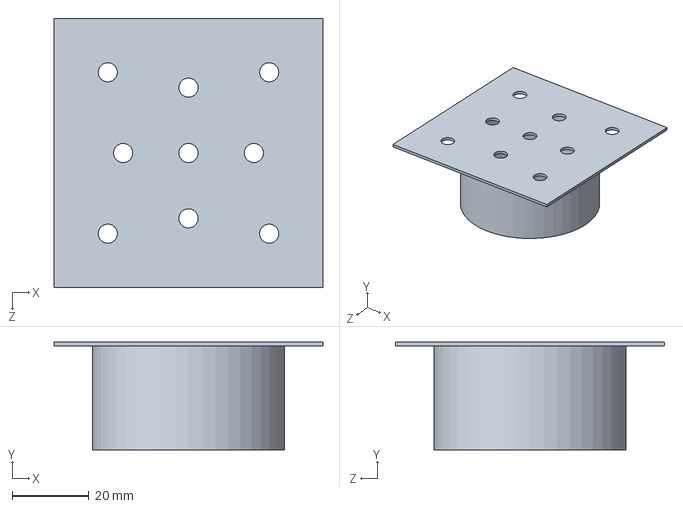
[picture p315: CAD file, 2026-10-19]
ISRO Total File/Robotic Arm/Robo Arm Assem/plate pipe.SLDPRT
70.0 x 28.0 x 70.0 mm
