samim-robotix/IRoCU-2024-ISRO-Rover/ISRO Total File/Robotic Arm/STLS/servo clamp-elbow.STL

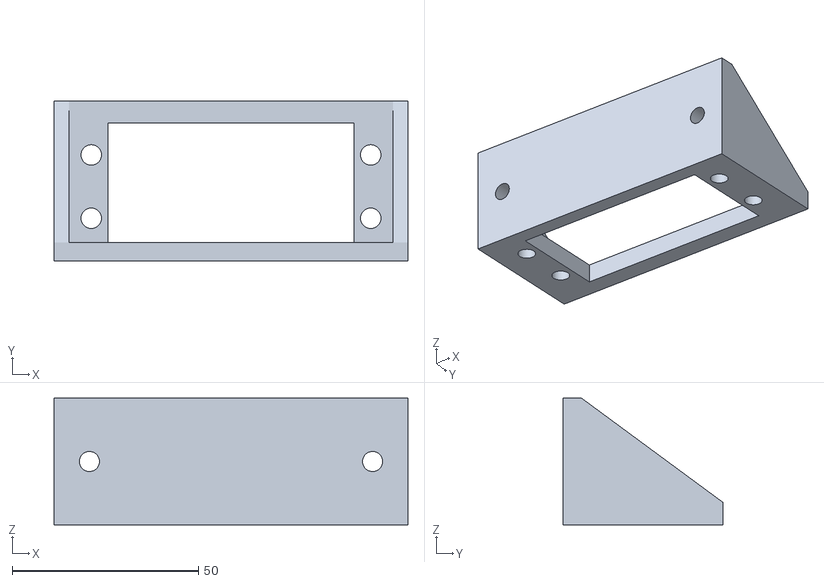
[picture p316: CAD file, 2026-10-19]
ISRO Total File/Robotic Arm/STLS/servo clamp-elbow.STL
95.0 x 43.0 x 34.0
