samim-robotix/IRoCU-2024-ISRO-Rover/ISRO Total File/ARM/wt blk.SLDPRT

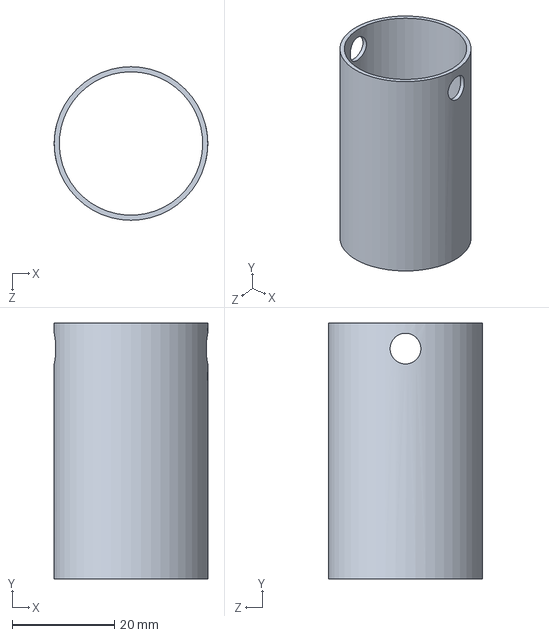
[picture p317: CAD file, 2026-10-19]
ISRO Total File/ARM/wt blk.SLDPRT
30.0 x 50.0 x 30.0 mm
