samim-robotix/IRoCU-2024-ISRO-Rover/ISRO Total File/BOT/body.SLDPRT

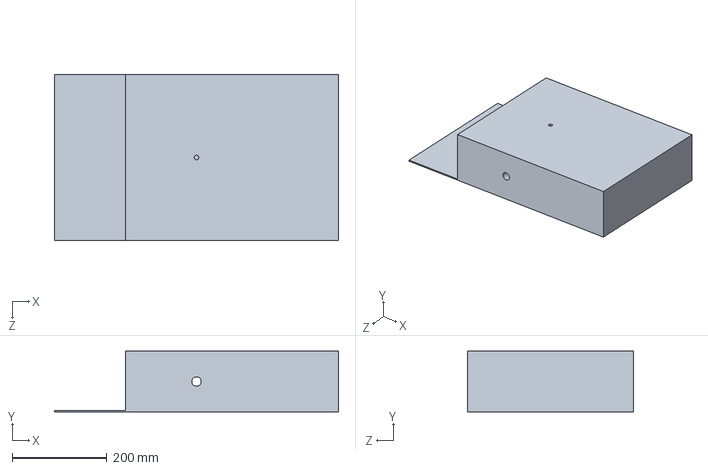
[picture p318: CAD file, 2026-10-19]
ISRO Total File/BOT/body.SLDPRT
600.0 x 128.0 x 350.0 mm
