samim-robotix/IRoCU-2024-ISRO-Rover/ISRO Total File/OBS_Chassis/RB parts/KFL000 v1.step

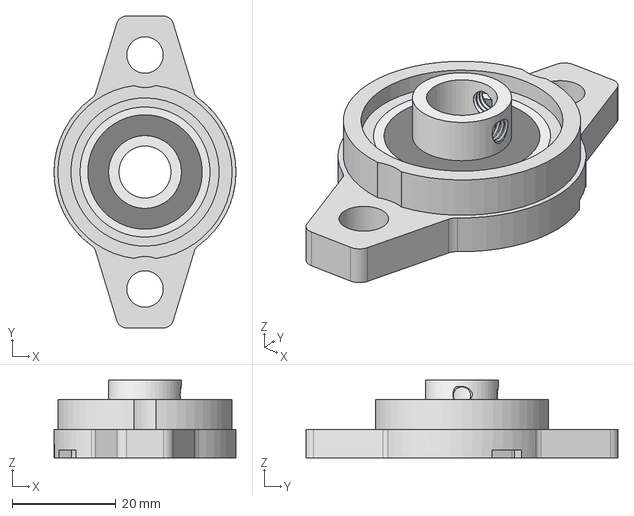
[picture p319: CAD file, 2026-10-19]
ISRO Total File/OBS_Chassis/RB parts/KFL000 v1.step
35.0 x 60.0 x 15.0 mm
