samim-robotix/IRoCU-2024-ISRO-Rover/ISRO Total File/Robotic Arm/DS Servo DS5160 SSG.SLDPRT

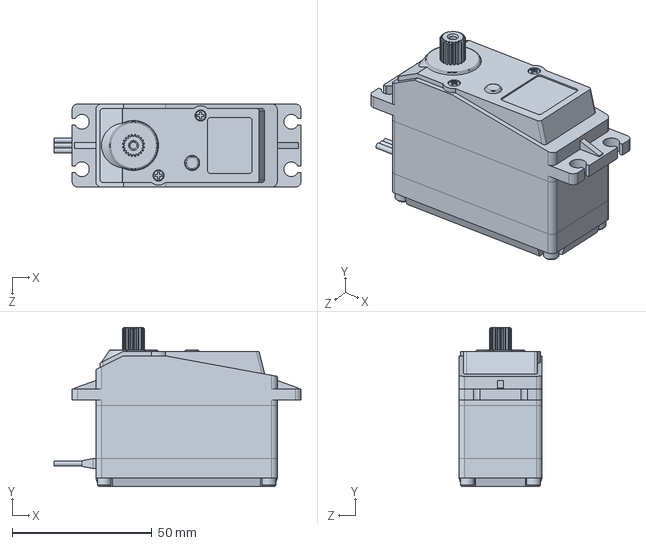
[picture p320: CAD file, 2026-10-19]
ISRO Total File/Robotic Arm/DS Servo DS5160 SSG.SLDPRT
88.5 x 57.0 x 29.8 mm
