samim-robotix/IRoCU-2024-ISRO-Rover/ISRO Total File/Robotic Arm/Gripper/robot-servo-motor-gripper-1.snapshot.3/Assembly/B1.SLDPRT

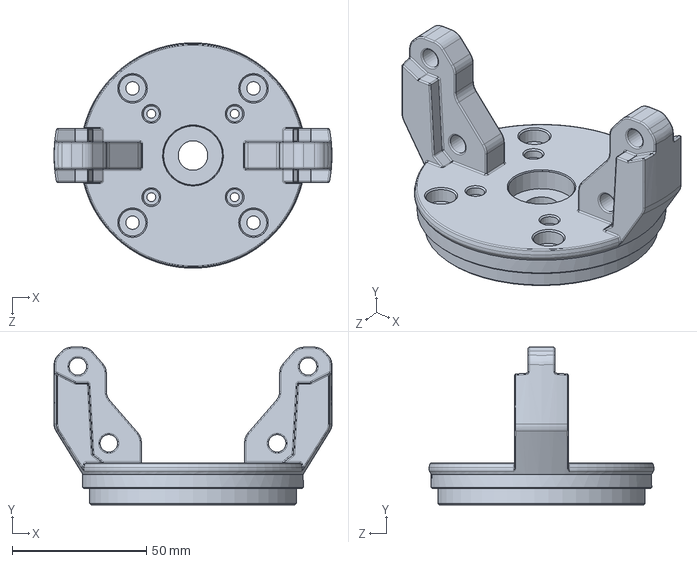
[picture p321: CAD file, 2026-10-19]
ISRO Total File/Robotic Arm/Gripper/robot-servo-motor-gripper-1.snapshot.3/Assembly/B1.SLDPRT
103.4 x 58.7 x 83.8 mm
