samim-robotix/IRoCU-2024-ISRO-Rover/ISRO Total File/Robotic Arm/Robo Arm Assem/arm_l2_20 -supp.SLDPRT

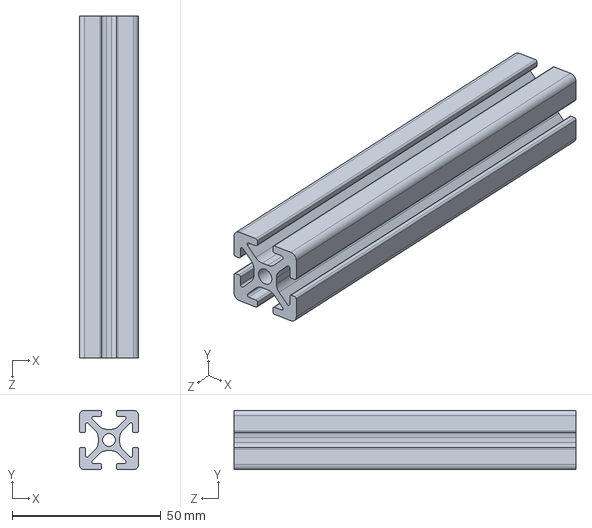
[picture p322: CAD file, 2026-10-19]
ISRO Total File/Robotic Arm/Robo Arm Assem/arm_l2_20 -supp.SLDPRT
20.0 x 20.0 x 115.0 mm
