samim-robotix/IRoCU-2024-ISRO-Rover/ISRO Total File/ARM/AL1.SLDPRT

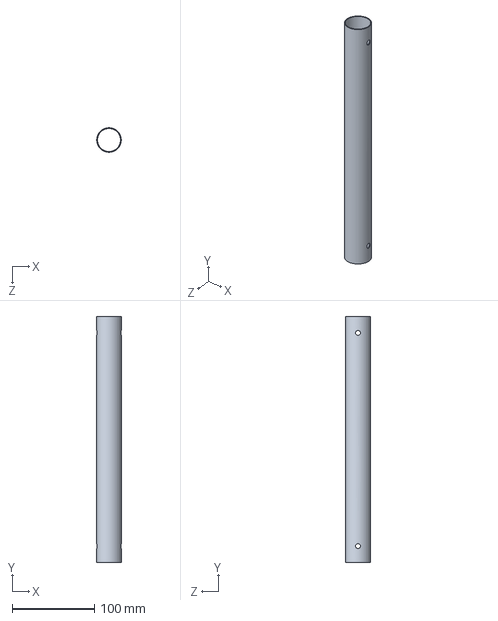
[picture p323: CAD file, 2026-10-19]
ISRO Total File/ARM/AL1.SLDPRT
30.0 x 300.0 x 30.0 mm
