samim-robotix/IRoCU-2024-ISRO-Rover/ISRO Total File/BOT/diff arm3.SLDPRT

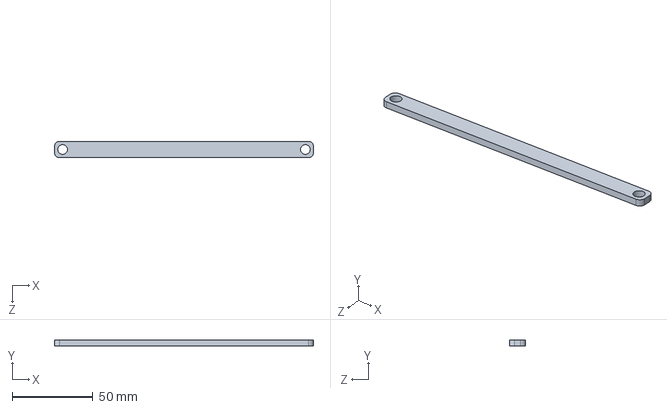
[picture p324: CAD file, 2026-10-19]
ISRO Total File/BOT/diff arm3.SLDPRT
160.0 x 3.50 x 10.0 mm
