samim-robotix/IRoCU-2024-ISRO-Rover/ISRO Total File/OBS_Chassis/RB parts/30 RL.SLDPRT

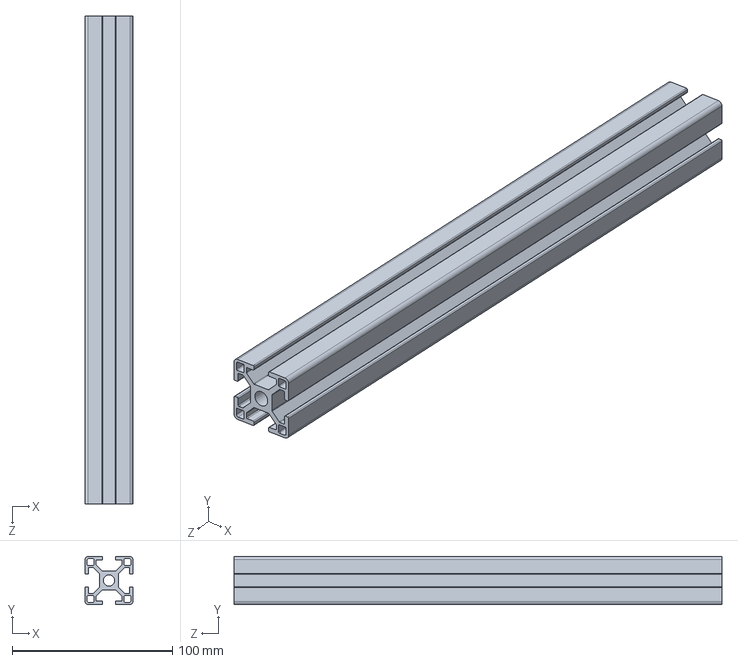
[picture p325: CAD file, 2026-10-19]
ISRO Total File/OBS_Chassis/RB parts/30 RL.SLDPRT
30.0 x 30.0 x 304.8 mm
