samim-robotix/IRoCU-2024-ISRO-Rover/ISRO Total File/Robotic Arm/base motor clamp.SLDPRT

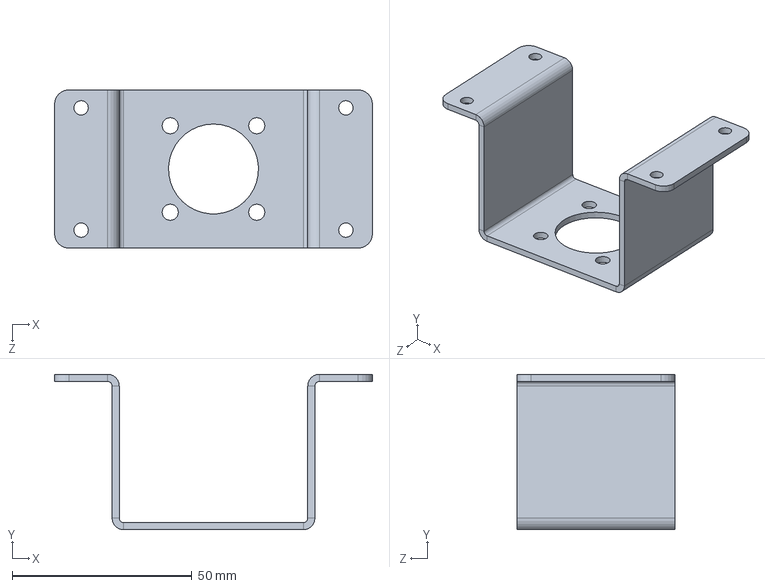
[picture p326: CAD file, 2026-10-19]
ISRO Total File/Robotic Arm/base motor clamp.SLDPRT
88.4 x 43.2 x 44.0 mm
