samim-robotix/IRoCU-2024-ISRO-Rover/ISRO Total File/Robotic Arm/Gripper/worm gear shaft.SLDPRT

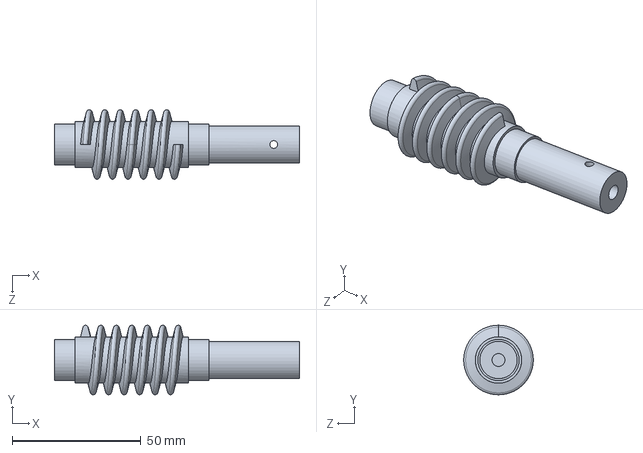
[picture p327: CAD file, 2026-10-19]
ISRO Total File/Robotic Arm/Gripper/worm gear shaft.SLDPRT
95.0 x 27.0 x 27.0 mm
