samim-robotix/IRoCU-2024-ISRO-Rover/ISRO Total File/Robotic Arm/Robo Arm Assem/nylon disk top.SLDPRT

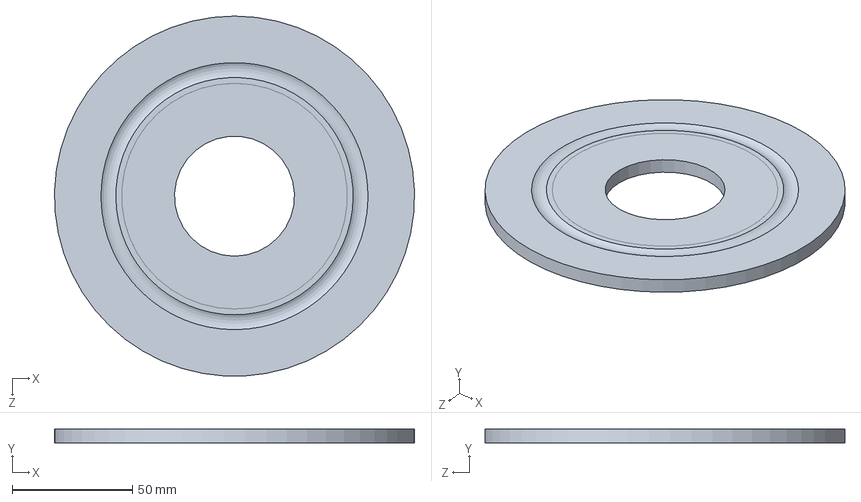
[picture p328: CAD file, 2026-10-19]
ISRO Total File/Robotic Arm/Robo Arm Assem/nylon disk top.SLDPRT
149.9 x 6.00 x 149.9 mm
