samim-robotix/IRoCU-2024-ISRO-Rover/ISRO Total File/ARM/wheel mill half.SLDPRT

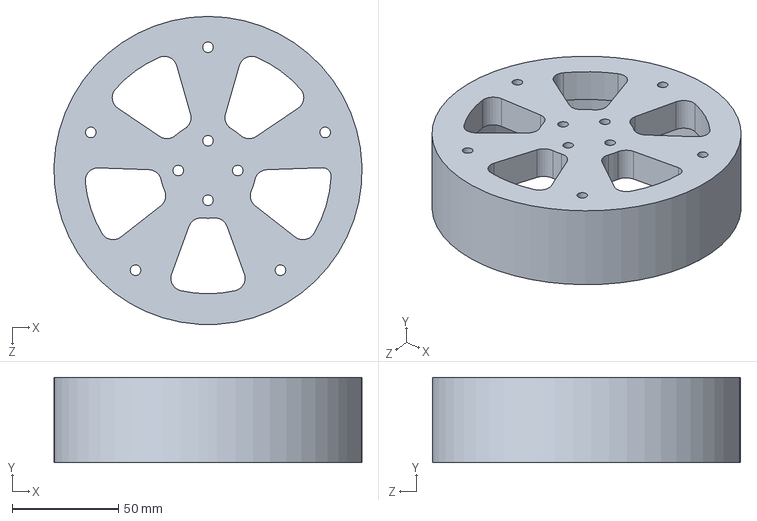
[picture p329: CAD file, 2026-10-19]
ISRO Total File/ARM/wheel mill half.SLDPRT
144.9 x 40.0 x 145.0 mm
