samim-robotix/IRoCU-2024-ISRO-Rover/ISRO Total File/BOT/boogie.SLDPRT

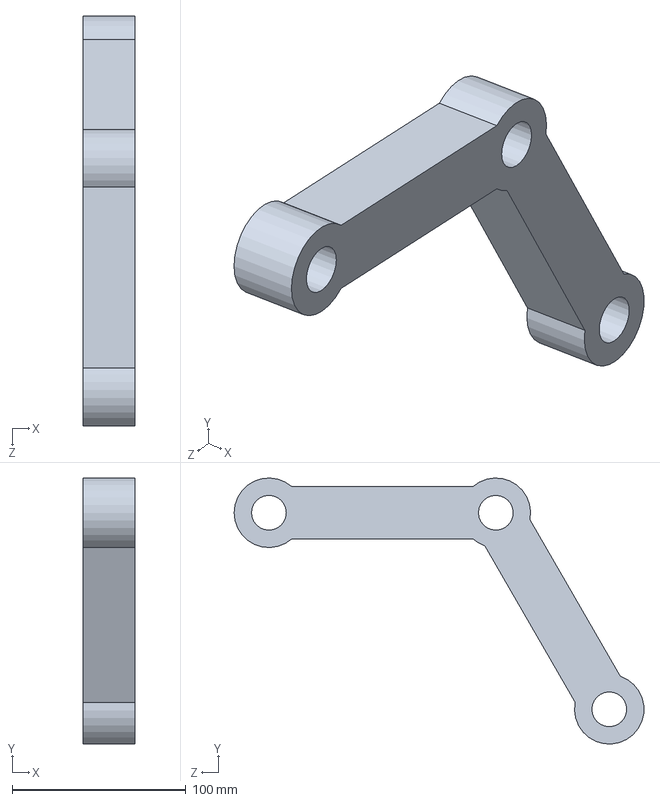
[picture p330: CAD file, 2026-10-19]
ISRO Total File/BOT/boogie.SLDPRT
30.0 x 153.0 x 235.7 mm
