samim-robotix/IRoCU-2024-ISRO-Rover/ISRO Total File/Robotic Arm/GT2 pulley 60 teeth width 11mm 8mm bore.stp

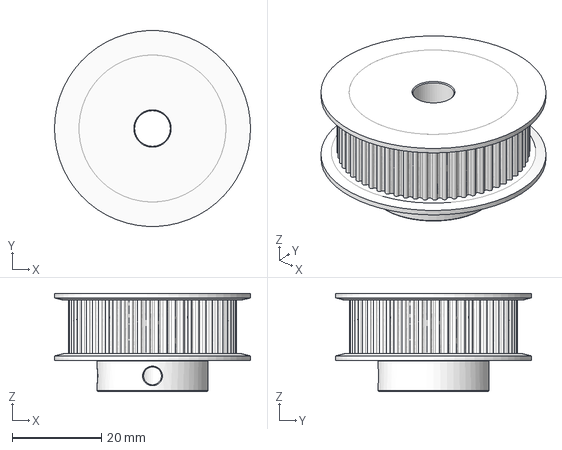
[picture p331: CAD file, 2026-10-19]
ISRO Total File/Robotic Arm/GT2 pulley 60 teeth width 11mm 8mm bore.stp
44.0 x 43.9 x 22.0 mm
