samim-robotix/IRoCU-2024-ISRO-Rover/ISRO Total File/Robotic Arm/Robo Arm Assem/wrist motor clamp.SLDPRT

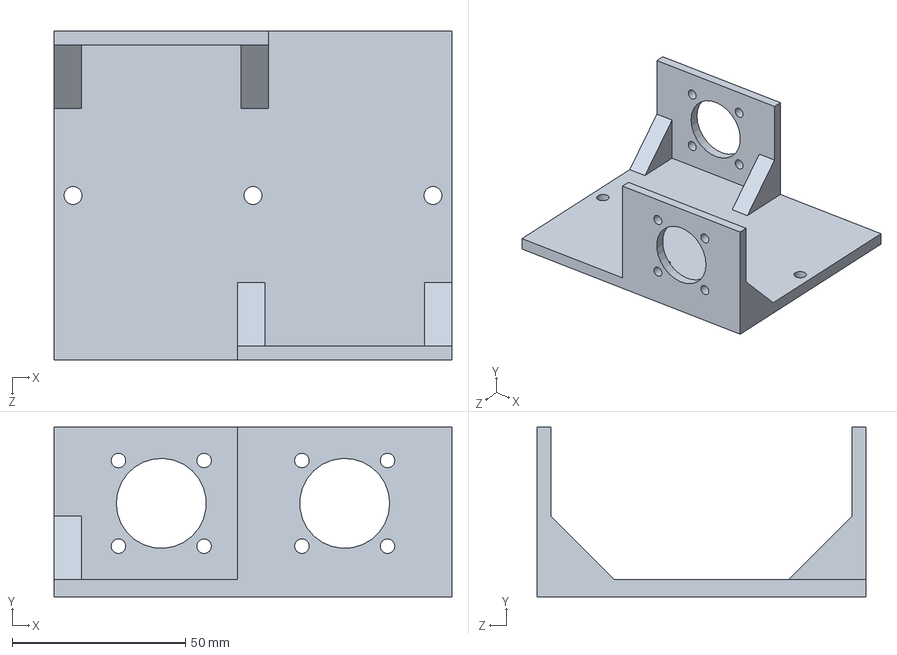
[picture p332: CAD file, 2026-10-19]
ISRO Total File/Robotic Arm/Robo Arm Assem/wrist motor clamp.SLDPRT
115.0 x 49.0 x 95.0 mm
