samim-robotix/IRoCU-2024-ISRO-Rover/ISRO Total File/BOT/obstacle.SLDPRT

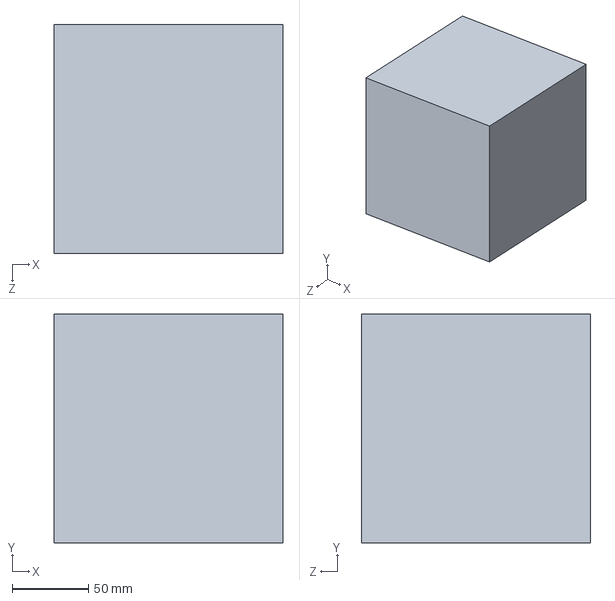
[picture p333: CAD file, 2026-10-19]
ISRO Total File/BOT/obstacle.SLDPRT
150.0 x 150.0 x 150.0 mm
