samim-robotix/IRoCU-2024-ISRO-Rover/ISRO Total File/Robotic Arm/Gripper/smooth rod 5mm.SLDPRT

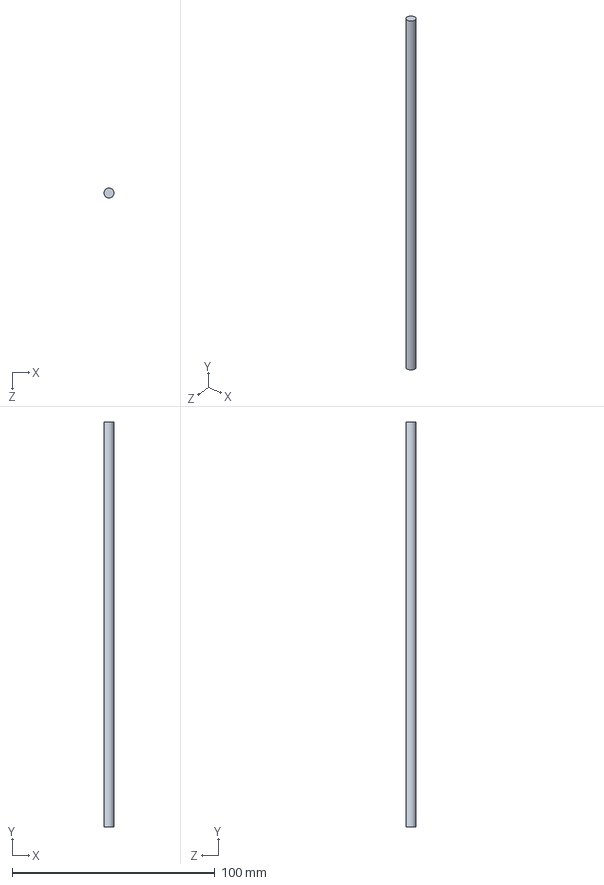
[picture p334: CAD file, 2026-10-19]
ISRO Total File/Robotic Arm/Gripper/smooth rod 5mm.SLDPRT
5.00 x 200.0 x 5.00 mm
