samim-robotix/IRoCU-2024-ISRO-Rover/ISRO Total File/ARM/joints.SLDPRT

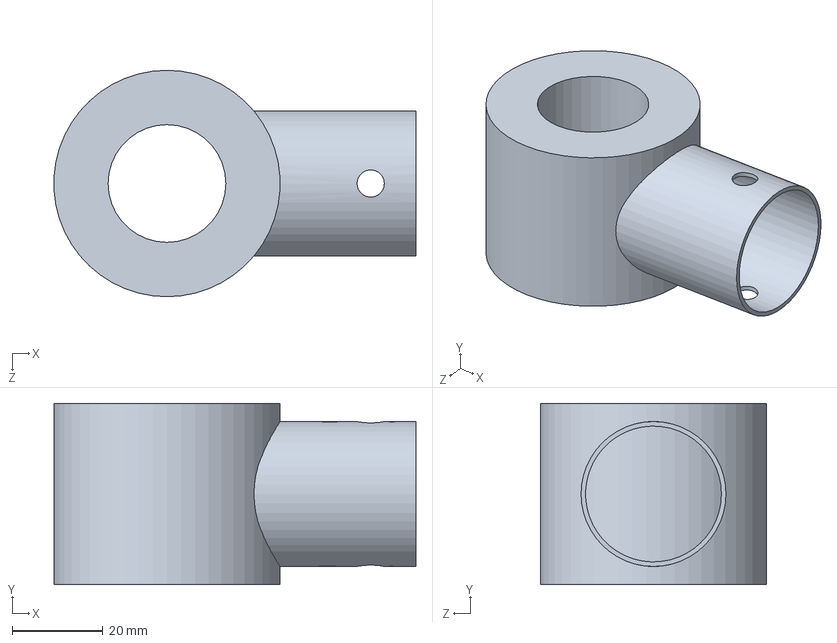
[picture p335: CAD file, 2026-10-19]
ISRO Total File/ARM/joints.SLDPRT
80.0 x 40.0 x 50.0 mm
