samim-robotix/IRoCU-2024-ISRO-Rover/ISRO Total File/BOT/diff hand.SLDPRT

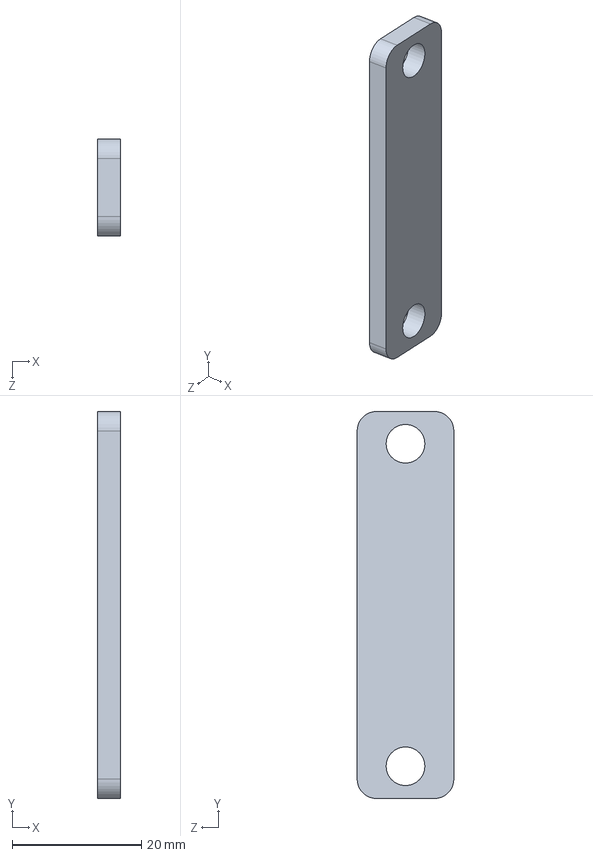
[picture p336: CAD file, 2026-10-19]
ISRO Total File/BOT/diff hand.SLDPRT
3.50 x 60.0 x 15.0 mm
