samim-robotix/IRoCU-2024-ISRO-Rover/ISRO Total File/OBS_Chassis/RB parts/KFL000 bearing unit 10mm.SLDPRT

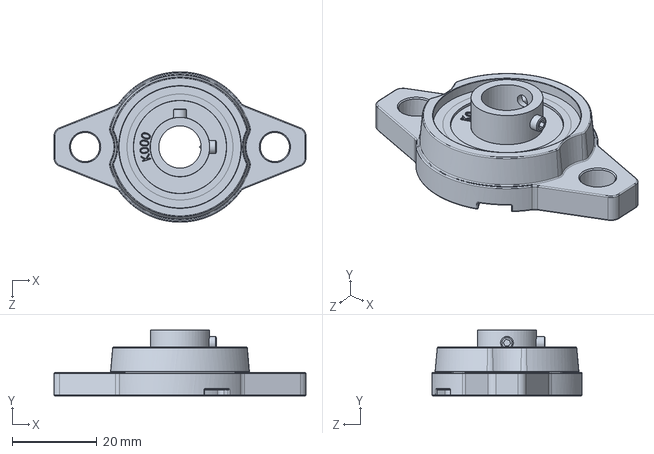
[picture p337: CAD file, 2026-10-19]
ISRO Total File/OBS_Chassis/RB parts/KFL000 bearing unit 10mm.SLDPRT
59.5 x 15.5 x 35.5 mm
