samim-robotix/IRoCU-2024-ISRO-Rover/ISRO Total File/Robotic Arm/Robo Arm Assem/sld_cpl.SLDPRT

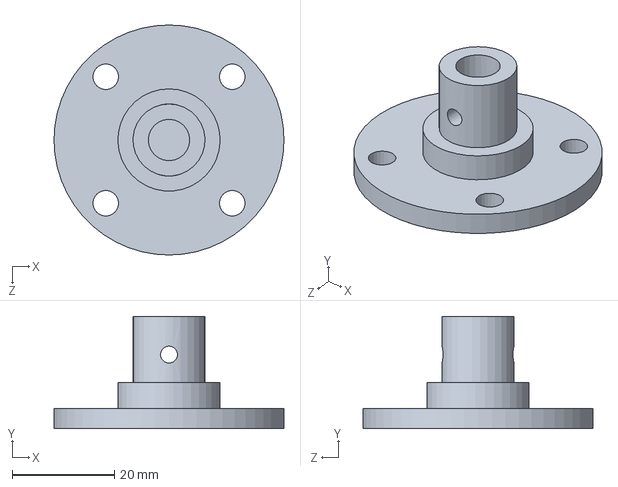
[picture p339: CAD file, 2026-10-19]
ISRO Total File/Robotic Arm/Robo Arm Assem/sld_cpl.SLDPRT
45.0 x 22.0 x 45.0 mm
