samim-robotix/IRoCU-2024-ISRO-Rover/ISRO Total File/ARM/tp1.SLDPRT

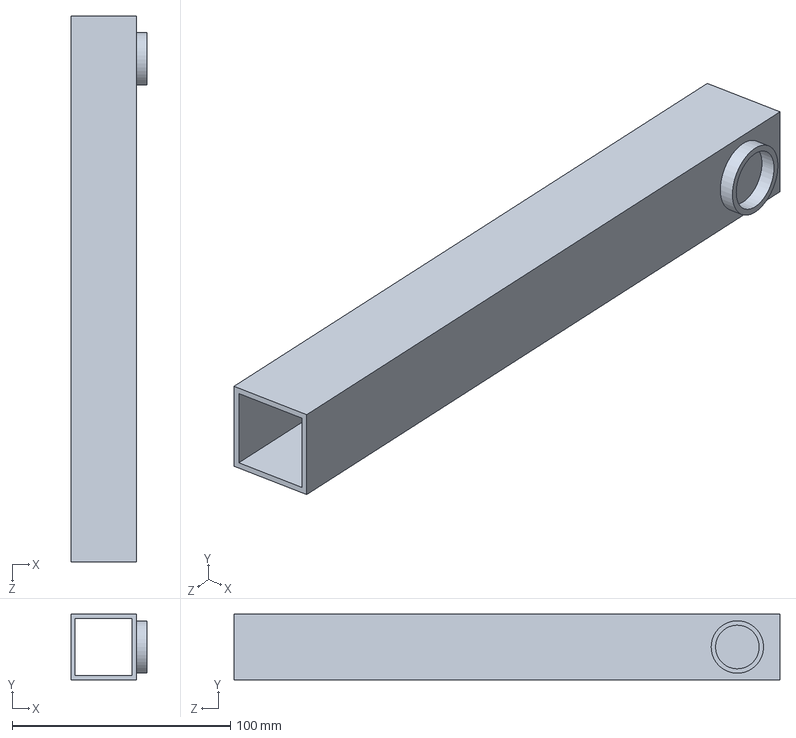
[picture p340: CAD file, 2026-10-19]
ISRO Total File/ARM/tp1.SLDPRT
35.0 x 30.0 x 250.0 mm
