samim-robotix/IRoCU-2024-ISRO-Rover/ISRO Total File/BOT/diff bar.SLDPRT

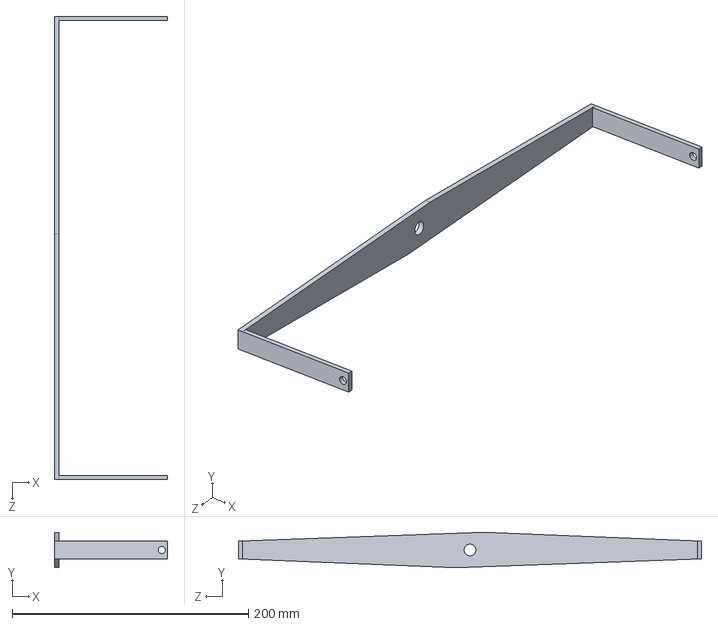
[picture p341: CAD file, 2026-10-19]
ISRO Total File/BOT/diff bar.SLDPRT
96.0 x 30.0 x 392.0 mm
