samim-robotix/IRoCU-2024-ISRO-Rover/ISRO Total File/OBS_Chassis/axl.SLDPRT

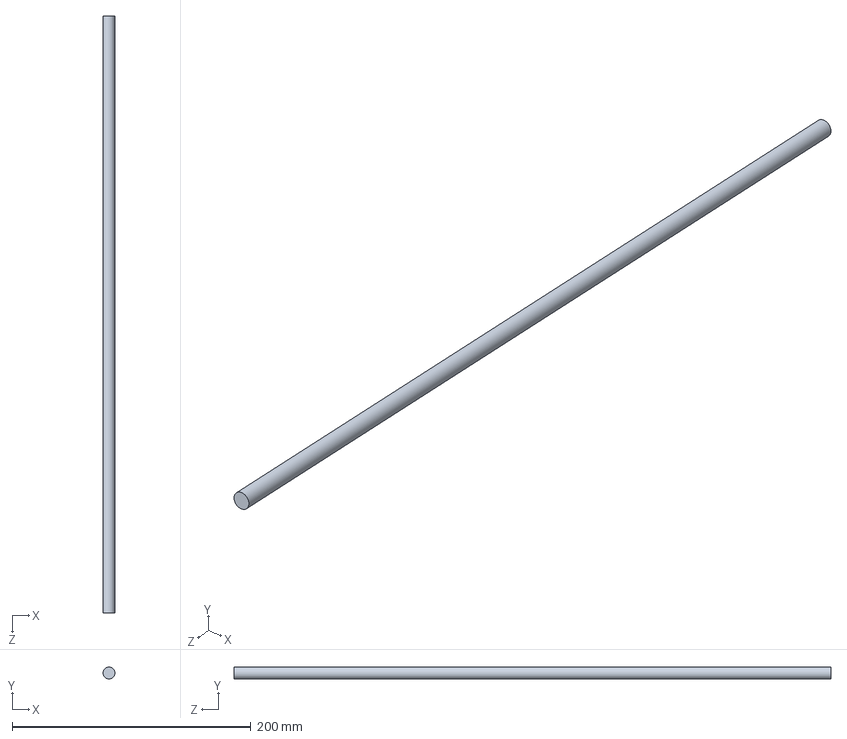
[picture p342: CAD file, 2026-10-19]
ISRO Total File/OBS_Chassis/axl.SLDPRT
10.0 x 10.0 x 500.0 mm
