samim-robotix/IRoCU-2024-ISRO-Rover/ISRO Total File/OBS_Chassis/RB parts/1st piv.SLDPRT

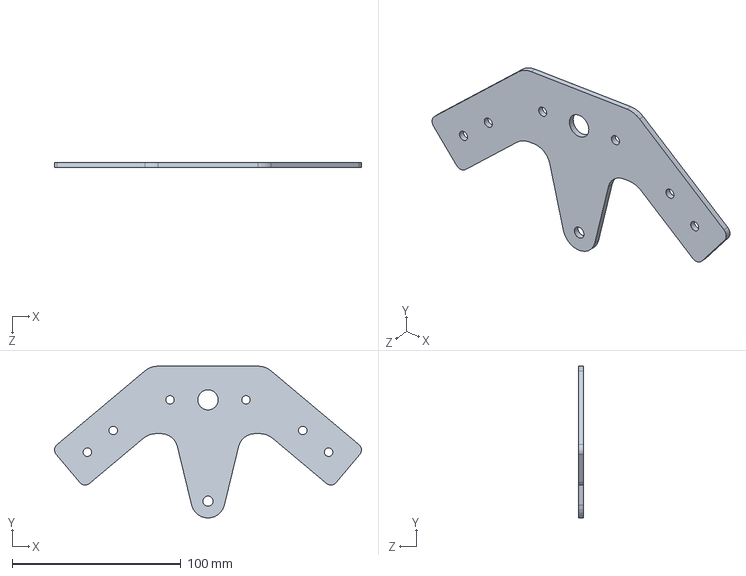
[picture p343: CAD file, 2026-10-19]
ISRO Total File/OBS_Chassis/RB parts/1st piv.SLDPRT
181.9 x 89.9 x 3.00 mm
