samim-robotix/IRoCU-2024-ISRO-Rover/ISRO Total File/Robotic Arm/cam enc p2.SLDPRT

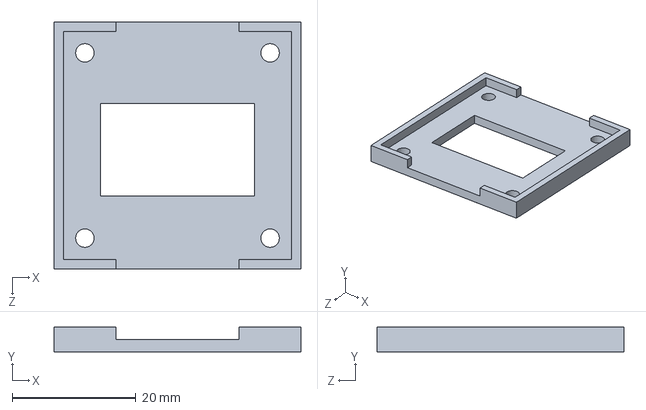
[picture p344: CAD file, 2026-10-19]
ISRO Total File/Robotic Arm/cam enc p2.SLDPRT
40.0 x 4.00 x 40.0 mm
