samim-robotix/IRoCU-2024-ISRO-Rover/ISRO Total File/Robotic Arm/Robo Arm Assem/wrist motor.SLDPRT

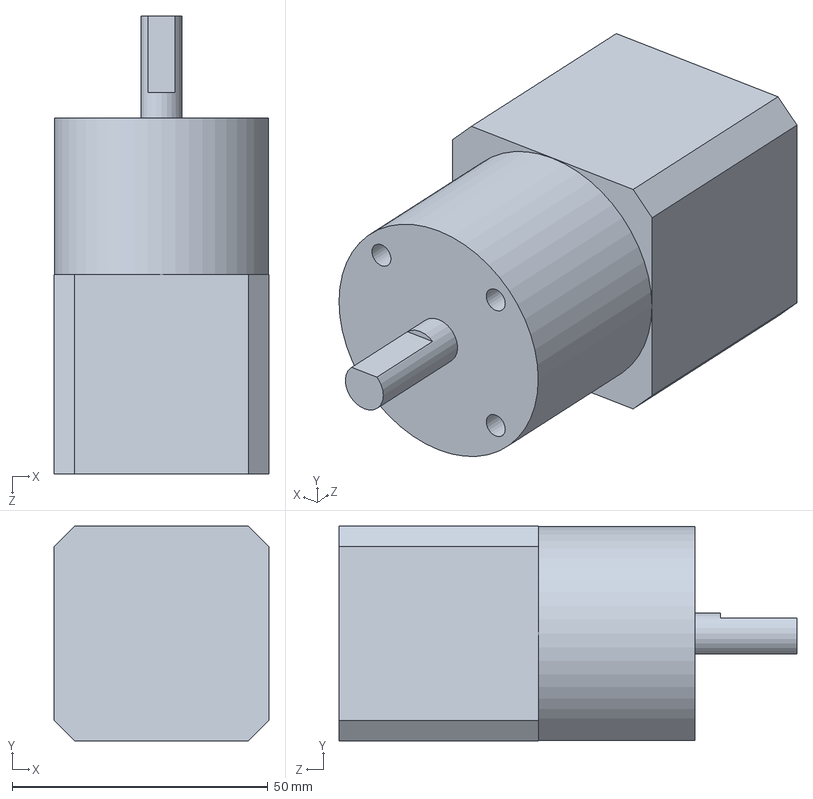
[picture p346: CAD file, 2026-10-19]
ISRO Total File/Robotic Arm/Robo Arm Assem/wrist motor.SLDPRT
42.0 x 42.0 x 89.6 mm
