samim-robotix/IRoCU-2024-ISRO-Rover/ISRO Total File/OBS_Chassis/RB parts/3rd piv.SLDPRT

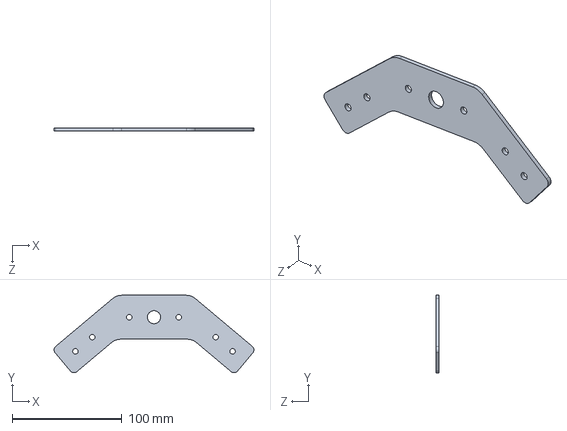
[picture p347: CAD file, 2026-10-19]
ISRO Total File/OBS_Chassis/RB parts/3rd piv.SLDPRT
181.9 x 70.5 x 3.00 mm
