samim-robotix/IRoCU-2024-ISRO-Rover/ISRO Total File/Robotic Arm/gripper motor.SLDPRT

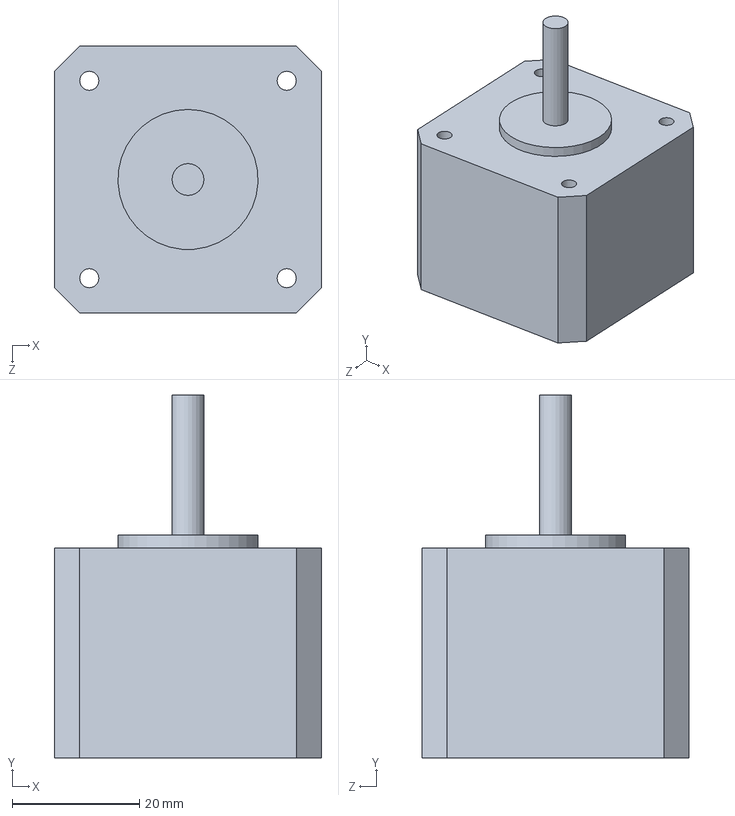
[picture p350: CAD file, 2026-10-19]
ISRO Total File/Robotic Arm/gripper motor.SLDPRT
42.0 x 57.0 x 42.0 mm
