samim-robotix/IRoCU-2024-ISRO-Rover/ISRO Total File/ARM/base joiner.SLDPRT

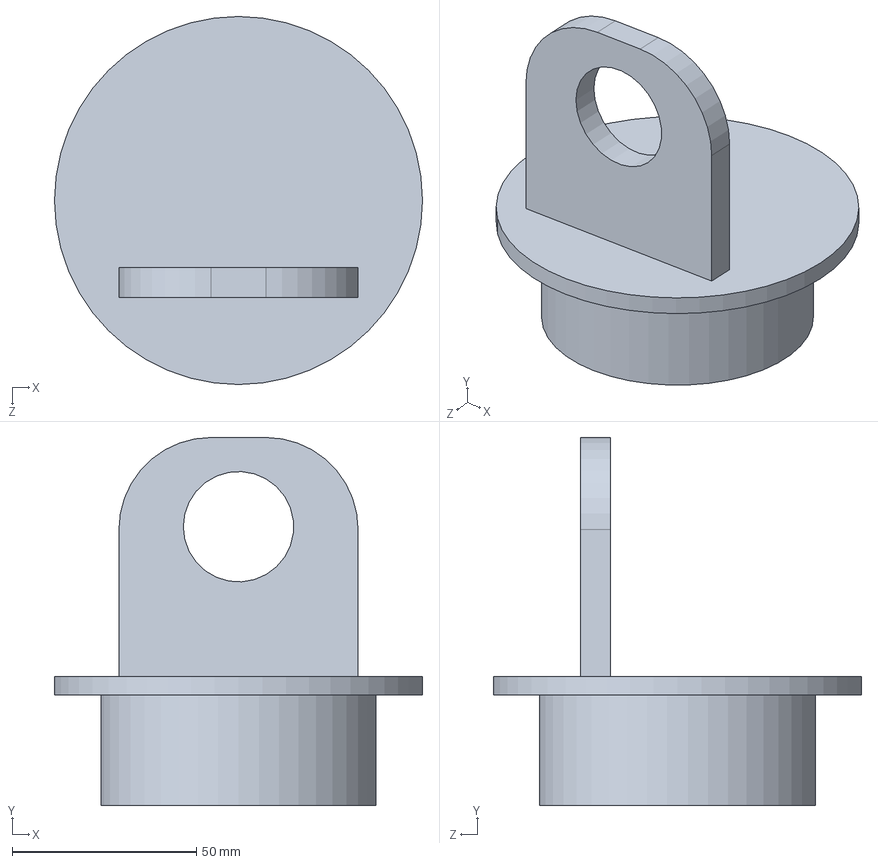
[picture p352: CAD file, 2026-10-19]
ISRO Total File/ARM/base joiner.SLDPRT
100.0 x 100.0 x 100.0 mm
