samim-robotix/IRoCU-2024-ISRO-Rover/ISRO Total File/Robotic Arm/base big plate.SLDPRT

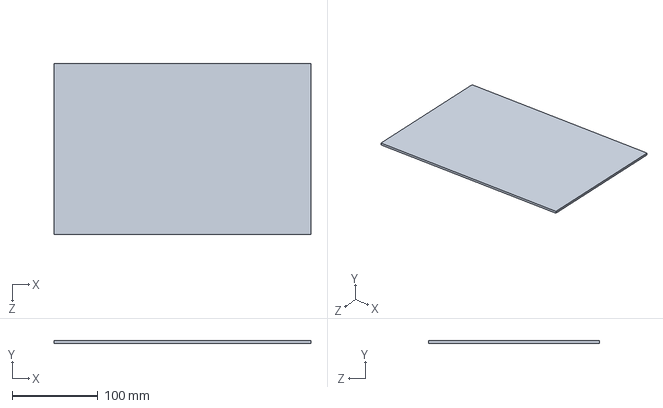
[picture p353: CAD file, 2026-10-19]
ISRO Total File/Robotic Arm/base big plate.SLDPRT
300.0 x 3.00 x 200.0 mm
