samim-robotix/IRoCU-2024-ISRO-Rover/ISRO Total File/ARM/AL2.SLDPRT

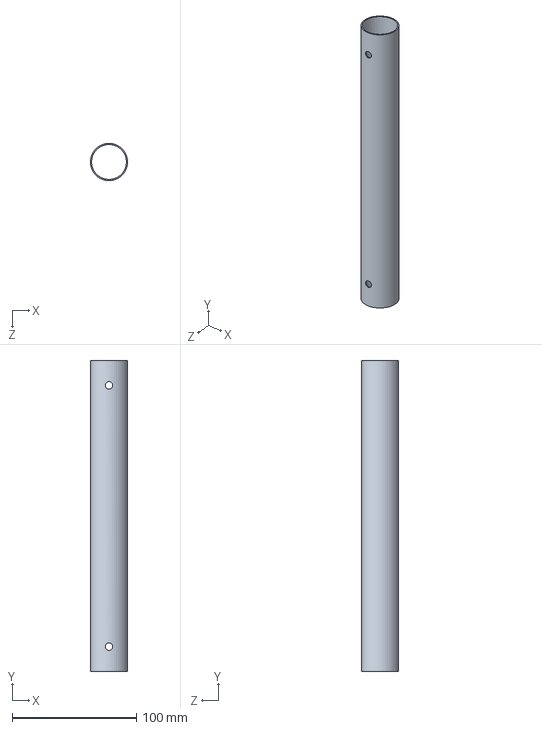
[picture p354: CAD file, 2026-10-19]
ISRO Total File/ARM/AL2.SLDPRT
30.0 x 250.0 x 30.0 mm
