samim-robotix/IRoCU-2024-ISRO-Rover/ISRO Total File/Robotic Arm/Gripper/robot-servo-motor-gripper-1.snapshot.3/Assembly/Joint rod cap 3.8.SLDPRT

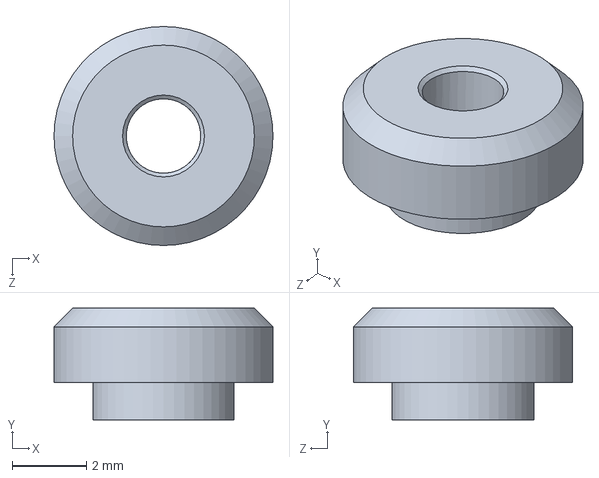
[picture p355: CAD file, 2026-10-19]
ISRO Total File/Robotic Arm/Gripper/robot-servo-motor-gripper-1.snapshot.3/Assembly/Joint rod cap 3.8.SLDPRT
5.88 x 3.00 x 5.88 mm
