samim-robotix/IRoCU-2024-ISRO-Rover/ISRO Total File/Robotic Arm/SM_base.SLDPRT

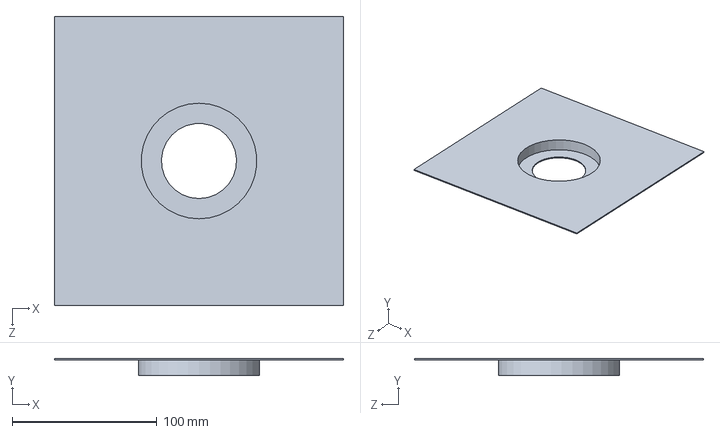
[picture p356: CAD file, 2026-10-19]
ISRO Total File/Robotic Arm/SM_base.SLDPRT
200.0 x 12.0 x 200.0 mm
