samim-robotix/IRoCU-2024-ISRO-Rover/ISRO Total File/Robotic Arm/5mm to 8mm flexible shaft coupler.stp

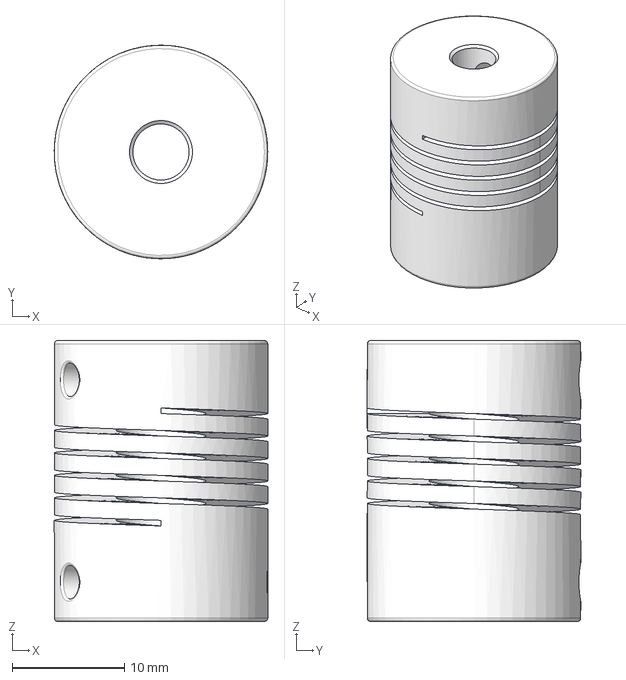
[picture p357: CAD file, 2026-10-19]
ISRO Total File/Robotic Arm/5mm to 8mm flexible shaft coupler.stp
19.0 x 19.0 x 25.0 mm
