samim-robotix/IRoCU-2024-ISRO-Rover/ISRO Total File/Robotic Arm/test608bear.SLDPRT

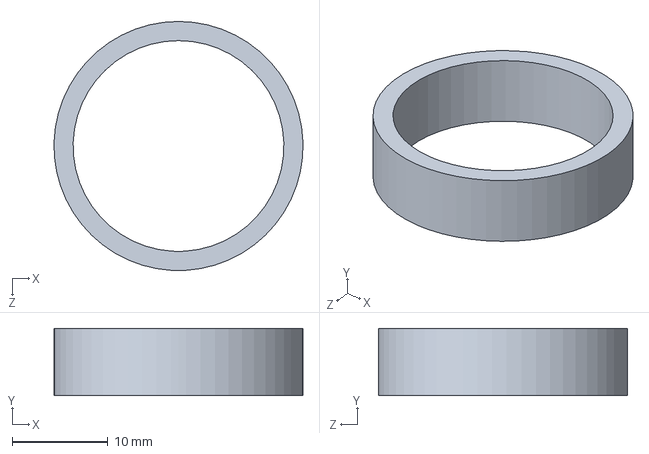
[picture p360: CAD file, 2026-10-19]
ISRO Total File/Robotic Arm/test608bear.SLDPRT
26.0 x 7.00 x 26.0 mm
