samim-robotix/IRoCU-2024-ISRO-Rover/ISRO Total File/Robotic Arm/top rot plate.SLDPRT

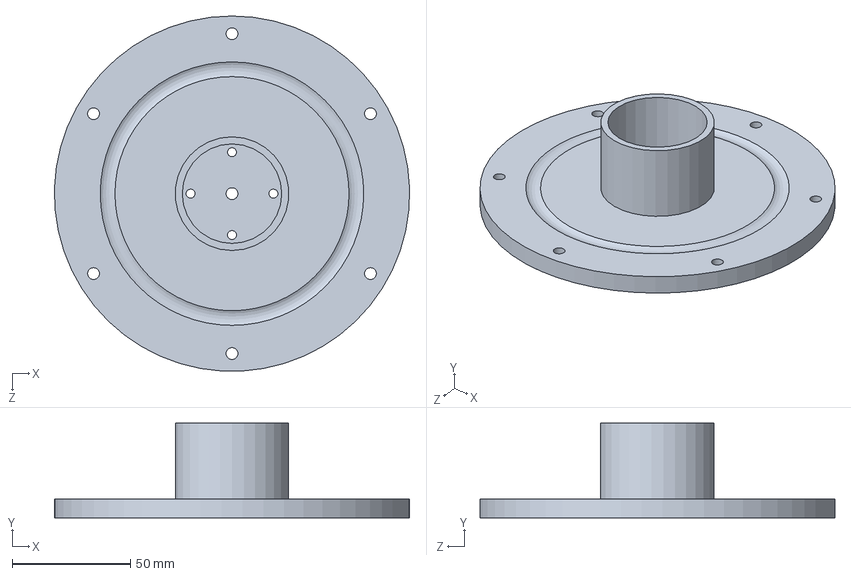
[picture p361: CAD file, 2026-10-19]
ISRO Total File/Robotic Arm/top rot plate.SLDPRT
149.9 x 40.0 x 149.9 mm
