samim-robotix/IRoCU-2024-ISRO-Rover/ISRO Total File/Robotic Arm/DS51_Arm_Disc.SLDPRT

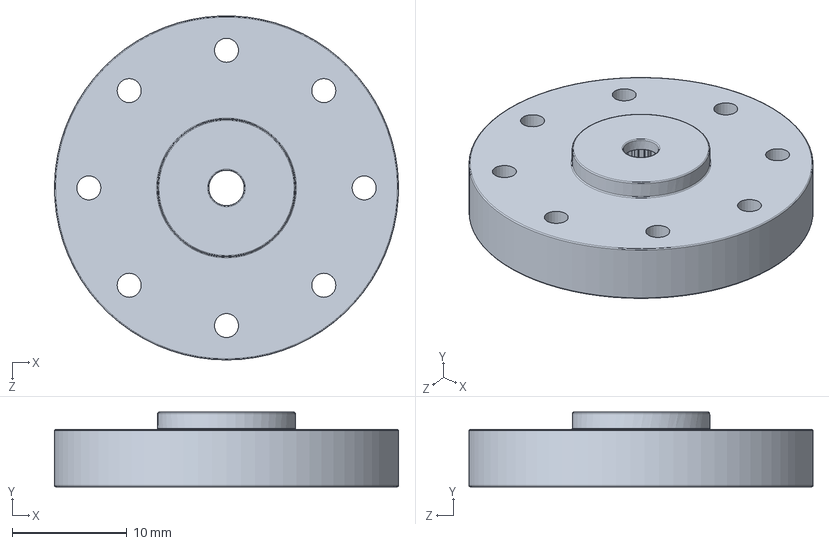
[picture p362: CAD file, 2026-10-19]
ISRO Total File/Robotic Arm/DS51_Arm_Disc.SLDPRT
30.0 x 6.50 x 30.0 mm
