samim-robotix/IRoCU-2024-ISRO-Rover/ISRO Total File/Robotic Arm/elbow_link_1.SLDPRT

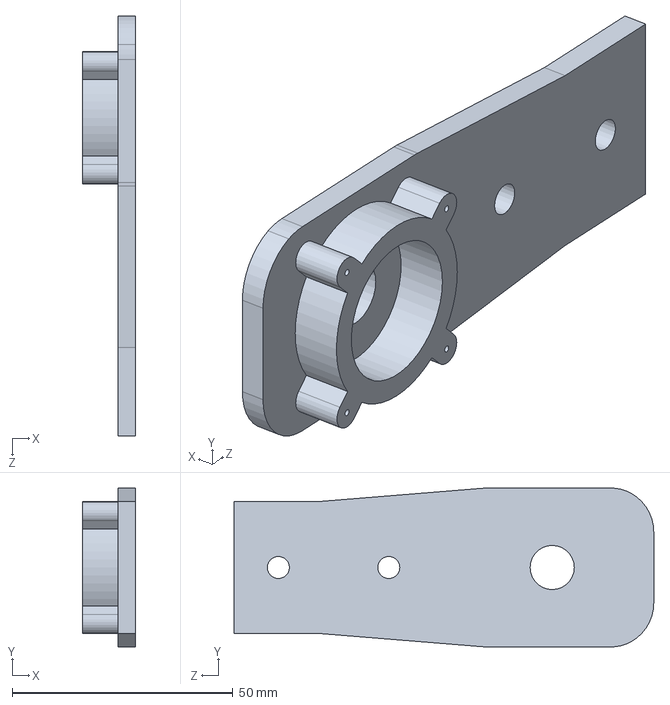
[picture p363: CAD file, 2026-10-19]
ISRO Total File/Robotic Arm/elbow_link_1.SLDPRT
12.0 x 36.0 x 95.0 mm
