samim-robotix/IRoCU-2024-ISRO-Rover/ISRO Total File/Robotic Arm/cam enc p1.SLDPRT

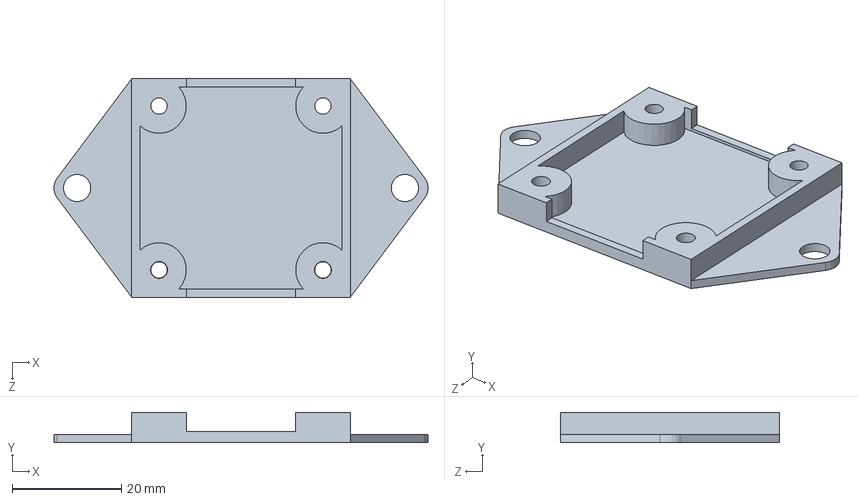
[picture p365: CAD file, 2026-10-19]
ISRO Total File/Robotic Arm/cam enc p1.SLDPRT
68.5 x 5.50 x 40.0 mm
