samim-robotix/IRoCU-2024-ISRO-Rover/ISRO Total File/Robotic Arm/AS5600 v1.step.SLDPRT

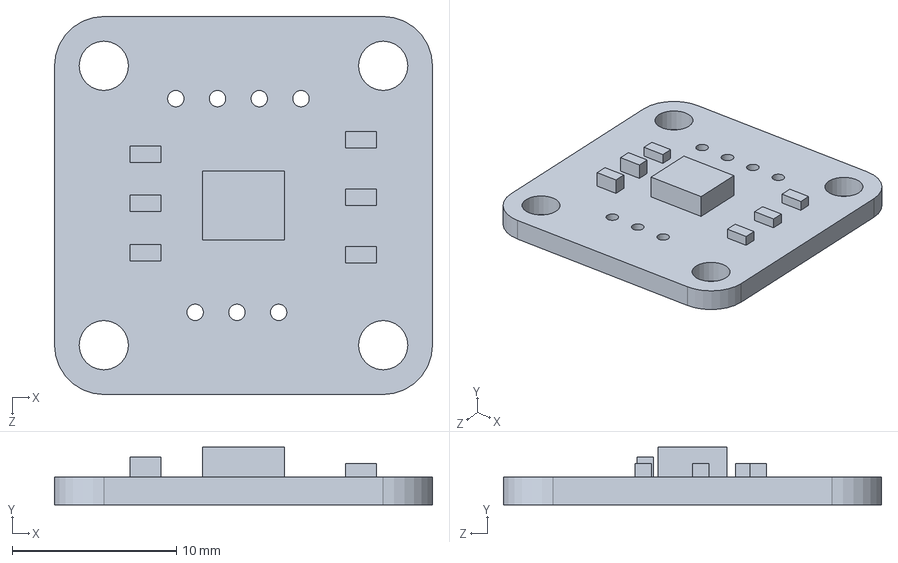
[picture p366: CAD file, 2026-10-19]
ISRO Total File/Robotic Arm/AS5600 v1.step.SLDPRT
23.0 x 3.50 x 23.0 mm
