samim-robotix/IRoCU-2024-ISRO-Rover/ISRO Total File/Robotic Arm/bot rot plate.SLDPRT

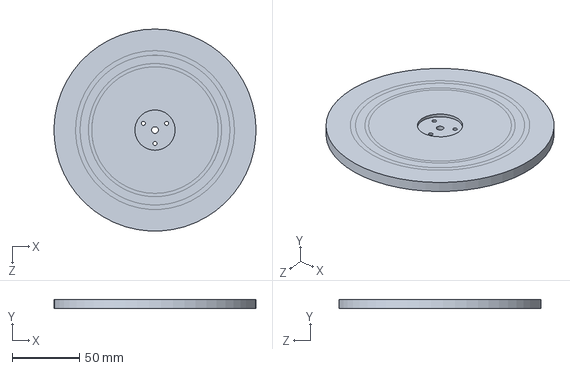
[picture p367: CAD file, 2026-10-19]
ISRO Total File/Robotic Arm/bot rot plate.SLDPRT
149.9 x 6.87 x 149.9 mm
