samim-robotix/IRoCU-2024-ISRO-Rover/ISRO Total File/Robotic Arm/nylon disk btm.SLDPRT

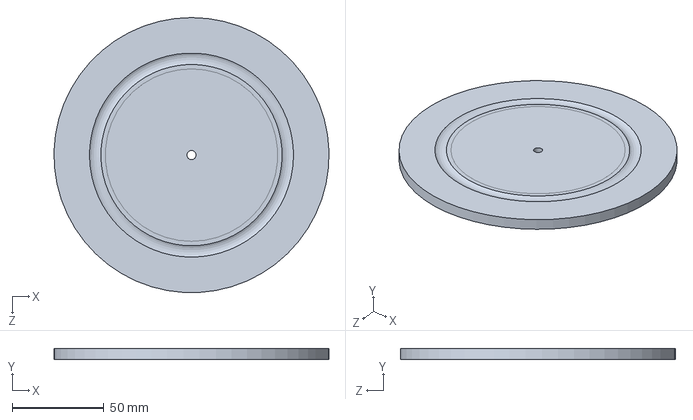
[picture p368: CAD file, 2026-10-19]
ISRO Total File/Robotic Arm/nylon disk btm.SLDPRT
149.9 x 6.00 x 149.9 mm
