samim-robotix/IRoCU-2024-ISRO-Rover/ISRO Total File/Robotic Arm/servo clamp - wrist.SLDPRT

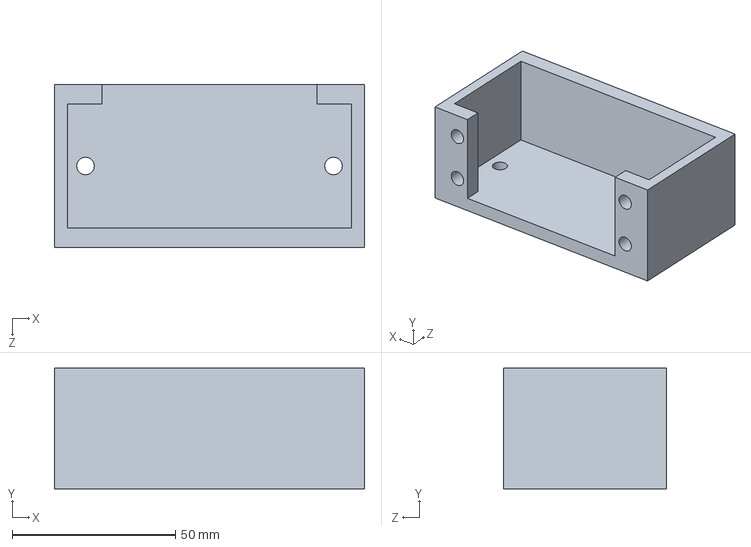
[picture p369: CAD file, 2026-10-19]
ISRO Total File/Robotic Arm/servo clamp - wrist.SLDPRT
95.0 x 37.0 x 50.0 mm
