samim-robotix/IRoCU-2024-ISRO-Rover/ISRO Total File/Robotic Arm/arm_l2_20.SLDPRT

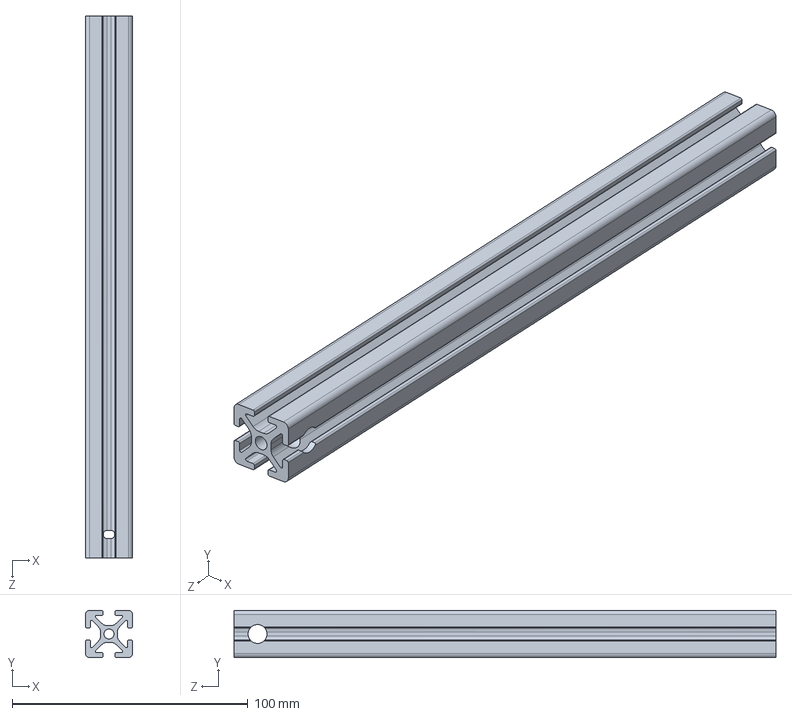
[picture p370: CAD file, 2026-10-19]
ISRO Total File/Robotic Arm/arm_l2_20.SLDPRT
20.0 x 20.0 x 230.0 mm
