samim-robotix/IRoCU-2024-ISRO-Rover/ISRO Total File/Robotic Arm/base grip.SLDPRT

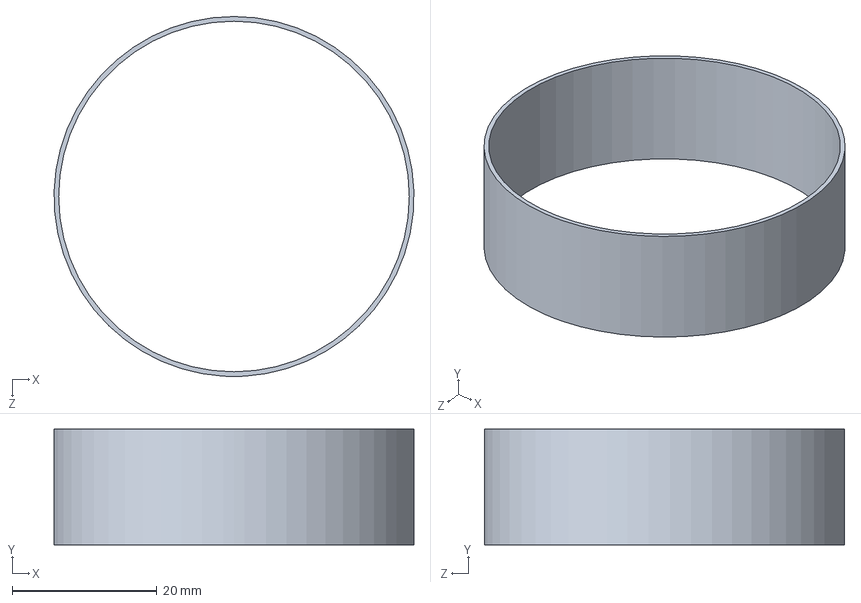
[picture p371: CAD file, 2026-10-19]
ISRO Total File/Robotic Arm/base grip.SLDPRT
49.7 x 16.0 x 49.7 mm
