samim-robotix/IRoCU-2024-ISRO-Rover/ISRO Total File/Robotic Arm/shldr motor clamp.SLDPRT

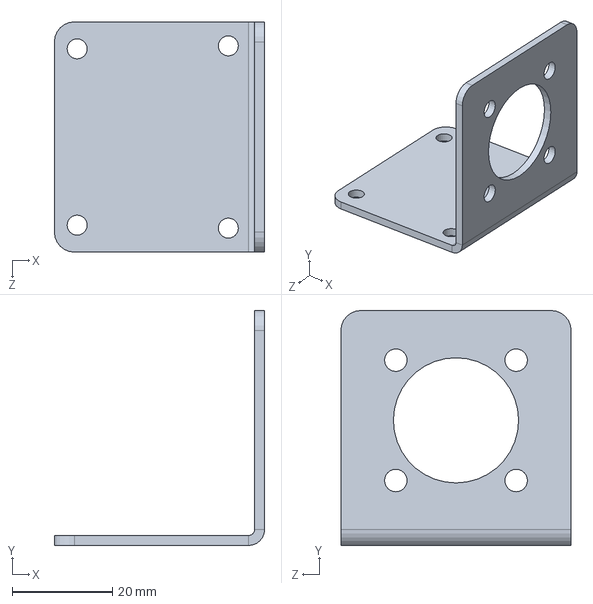
[picture p372: CAD file, 2026-10-19]
ISRO Total File/Robotic Arm/shldr motor clamp.SLDPRT
42.0 x 46.9 x 46.0 mm
