samim-robotix/IRoCU-2024-ISRO-Rover/ISRO Total File/Robotic Arm/enc case.SLDPRT

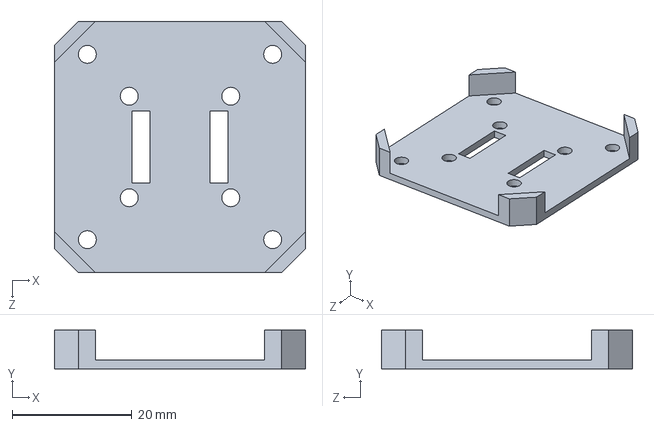
[picture p373: CAD file, 2026-10-19]
ISRO Total File/Robotic Arm/enc case.SLDPRT
42.0 x 6.50 x 42.0 mm
