samim-robotix/IRoCU-2024-ISRO-Rover/(list of files, cad)

Other CAD files:
ISRO Total File/Robotic Arm/base motor plate assm.SLDASM
ISRO Total File/Robotic Arm/Gripper/robot-servo-motor-gripper-1.snapshot.3/Robo Arm.STEP
ISRO Total File/Robotic Arm/STLS/grip move.STL
ISRO Total File/Robotic Arm/STLS/5mm bush.STL
ISRO Total File/Electronics/xt60_faceplate_act.STL
ISRO Total File/OBS_Chassis/RB parts/2nd piv 1.SLDPRT
ISRO Total File/New Designs/wheel motor.STEP
ISRO Total File/OBS_Chassis/T18.SLDPRT
ISRO Total File/OBS_Chassis/T15.SLDPRT
ISRO Total File/Robotic Arm/Gripper/u gripper clamp.SLDPRT
ISRO Total File/OBS_Chassis/T55.SLDPRT
ISRO Total File/Robotic Arm/Robo Arm Assem/arm_l1.SLDPRT
ISRO Total File/OBS_Chassis/T35.SLDPRT
ISRO Total File/Robotic Arm/servo clamp.SLDPRT
ISRO Total File/BOT/diff arm 2a.SLDPRT
ISRO Total File/OBS_Chassis/T41.SLDPRT
ISRO Total File/Robotic Arm/arm_l2_30.SLDPRT
ISRO Total File/ARM/ALG.SLDPRT
ISRO Total File/Robotic Arm/sld_cpl.SLDPRT
ISRO Total File/Robotic Arm/servo clamp - wrist U.SLDPRT
ISRO Total File/Robotic Arm/shoulder motor holder.SLDPRT
ISRO Total File/ARM/arm new assm.SLDDRW
ISRO Total File/BOT/bot assem.SLDDRW
ISRO Total File/Electronics/xt60_faceplate.STL
ISRO Total File/OBS_Chassis/5537T104_T-Slotted Framing.SLDPRT
ISRO Total File/OBS_Chassis/KP000.SLDPRT
ISRO Total File/OBS_Chassis/RB parts/1st piv - Copy.SLDPRT
ISRO Total File/OBS_Chassis/RB parts/1st piv.DXF
ISRO Total File/OBS_Chassis/RB parts/DXF files/1st piv.SLDPRT
ISRO Total File/OBS_Chassis/RB parts/DXF files/3rd piv.SLDPRT
ISRO Total File/OBS_Chassis/rover assem.IGS
ISRO Total File/Robotic Arm/51118 base botm.STEP
ISRO Total File/Robotic Arm/51118 base.SLDPRT
ISRO Total File/Robotic Arm/Gripper/lead screw.SLDPRT
ISRO Total File/Robotic Arm/Gripper/robot-servo-motor-gripper-1.snapshot.3/Assembly/Joint rod cap - Copy.SLDPRT
ISRO Total File/Robotic Arm/Gripper/robot-servo-motor-gripper-1.snapshot.3/Assembly/Joint rod cap 3.8 - Copy.SLDPRT
ISRO Total File/Robotic Arm/Gripper/robot-servo-motor-gripper-1.snapshot.3/Assembly/T8 Nut 1.5.SLDPRT
ISRO Total File/Robotic Arm/Gripper/robot-servo-motor-gripper-1.snapshot.3/Assembly/washer_1.SLDPRT
ISRO Total File/Robotic Arm/Gripper/robot-servo-motor-gripper-1.snapshot.3/Assembly/washer_2.8.SLDPRT
ISRO Total File/Robotic Arm/Gripper/robot-servo-motor-gripper-1.snapshot.3/Robo Arm.x_t
ISRO Total File/Robotic Arm/Gripper/robot-servo-motor-gripper-1.snapshot.3/lead screw.SLDPRT
ISRO Total File/Robotic Arm/LEAD SCREW, D=8mm, P=2mm, L=1000mm.stp
ISRO Total File/Robotic Arm/STLS/51118 base.STL
ISRO Total File/Robotic Arm/STLS/base grip.STL
ISRO Total File/Robotic Arm/STLS/bot rot plate.STL
ISRO Total File/Robotic Arm/STLS/cam enc p1.STL
ISRO Total File/Robotic Arm/STLS/cam enc p2.STL
ISRO Total File/Robotic Arm/STLS/enc case.STL
ISRO Total File/Robotic Arm/STLS/servo clamp - wrist U.STL
ISRO Total File/Robotic Arm/STLS/servo clamp - wrist.STL
ISRO Total File/Robotic Arm/STLS/shoulder motor holder.STL
ISRO Total File/Robotic Arm/STLS/top rot plate.STL
ISRO Total File/Robotic Arm/arm_l1.SLDPRT
ISRO Total File/Robotic Arm/bot rot plate.SLDDRW
ISRO Total File/Robotic Arm/misc/51118 SA.SLDPRT
ISRO Total File/Robotic Arm/misc/51118 base - test print.SLDPRT
ISRO Total File/Robotic Arm/nylon disk top.SLDDRW
ISRO Total File/Robotic Arm/plate pipe.SLDDRW
ISRO Total File/Robotic Arm/shoulder motor holder.SLDDRW
ISRO Total File/Robotic Arm/simple-gripper-with-high-gripping-force-2.snapshot.5/Assieme_pinza_rds.igs
ISRO Total File/Robotic Arm/simple-gripper-with-high-gripping-force-2.snapshot.5/Assieme_pinza_rds2.igs
ISRO Total File/Robotic Arm/skf_bearing_16010_2.stp
ISRO Total File/Robotic Arm/sld_cpl.SLDDRW
ISRO Total File/Robotic Arm/top rot plate 1isto1.SLDDRW
ISRO Total File/Robotic Arm/top rot plate.SLDDRW
ISRO Total File/usb-type-a-housing-case20221211-228130-ea8r07/jinner/usb-type-a-housing-case/USB_A_Housing_v5.f3d
