samim-robotix/IRoCU-2024-ISRO-Rover/ISRO Total File/ISRO Robotics Challenge/obseract/test_blink/test_blink/MDK-ARM/test_blink/test_blink.htm

# Static Call Graph for image test_blink\test_blink.axf

#<CALLGRAPH># ARM Linker, 6190004: Last Updated: Wed Apr 17 01:08:38 2024

### Maximum Stack Usage = 184 bytes + Unknown(Cycles, Untraceable Function Pointers)

### Call chain for Maximum Stack Depth:

main ⇒ SystemClock_Config ⇒ HAL_RCC_ClockConfig ⇒ HAL_RCC_GetSysClockFreq ⇒ __aeabi_uldivmod

### Mutually Recursive functions

- ADC_IRQHandler ⇒ ADC_IRQHandler
- BusFault_Handler ⇒ BusFault_Handler
- HardFault_Handler ⇒ HardFault_Handler
- MemManage_Handler ⇒ MemManage_Handler
- NMI_Handler ⇒ NMI_Handler
- UsageFault_Handler ⇒ UsageFault_Handler

### Function Pointers

- ADC_IRQHandler from startup_stm32f407xx.o(.text) referenced from startup_stm32f407xx.o(RESET)
- BusFault_Handler from stm32f4xx_it.o(.text.BusFault_Handler) referenced from startup_stm32f407xx.o(RESET)
- CAN1_RX0_IRQHandler from startup_stm32f407xx.o(.text) referenced from startup_stm32f407xx.o(RESET)
- CAN1_RX1_IRQHandler from startup_stm32f407xx.o(.text) referenced from startup_stm32f407xx.o(RESET)
- CAN1_SCE_IRQHandler from startup_stm32f407xx.o(.text) referenced from startup_stm32f407xx.o(RESET)
- CAN1_TX_IRQHandler from startup_stm32f407xx.o(.text) referenced from startup_stm32f407xx.o(RESET)
- CAN2_RX0_IRQHandler from startup_stm32f407xx.o(.text) referenced from startup_stm32f407xx.o(RESET)
- CAN2_RX1_IRQHandler from startup_stm32f407xx.o(.text) referenced from startup_stm32f407xx.o(RESET)
- CAN2_SCE_IRQHandler from startup_stm32f407xx.o(.text) referenced from startup_stm32f407xx.o(RESET)
- CAN2_TX_IRQHandler from startup_stm32f407xx.o(.text) referenced from startup_stm32f407xx.o(RESET)
- DCMI_IRQHandler from startup_stm32f407xx.o(.text) referenced from startup_stm32f407xx.o(RESET)
- DMA1_Stream0_IRQHandler from startup_stm32f407xx.o(.text) referenced from startup_stm32f407xx.o(RESET)
- DMA1_Stream1_IRQHandler from startup_stm32f407xx.o(.text) referenced from startup_stm32f407xx.o(RESET)
- DMA1_Stream2_IRQHandler from startup_stm32f407xx.o(.text) referenced from startup_stm32f407xx.o(RESET)
- DMA1_Stream3_IRQHandler from startup_stm32f407xx.o(.text) referenced from startup_stm32f407xx.o(RESET)
- DMA1_Stream4_IRQHandler from startup_stm32f407xx.o(.text) referenced from startup_stm32f407xx.o(RESET)
- DMA1_Stream5_IRQHandler from startup_stm32f407xx.o(.text) referenced from startup_stm32f407xx.o(RESET)
- DMA1_Stream6_IRQHandler from startup_stm32f407xx.o(.text) referenced from startup_stm32f407xx.o(RESET)
- DMA1_Stream7_IRQHandler from startup_stm32f407xx.o(.text) referenced from startup_stm32f407xx.o(RESET)
- DMA2_Stream0_IRQHandler from startup_stm32f407xx.o(.text) referenced from startup_stm32f407xx.o(RESET)
- DMA2_Stream1_IRQHandler from startup_stm32f407xx.o(.text) referenced from startup_stm32f407xx.o(RESET)
- DMA2_Stream2_IRQHandler from startup_stm32f407xx.o(.text) referenced from startup_stm32f407xx.o(RESET)
- DMA2_Stream3_IRQHandler from startup_stm32f407xx.o(.text) referenced from startup_stm32f407xx.o(RESET)
- DMA2_Stream4_IRQHandler from startup_stm32f407xx.o(.text) referenced from startup_stm32f407xx.o(RESET)
- DMA2_Stream5_IRQHandler from startup_stm32f407xx.o(.text) referenced from startup_stm32f407xx.o(RESET)
- DMA2_Stream6_IRQHandler from startup_stm32f407xx.o(.text) referenced from startup_stm32f407xx.o(RESET)
- DMA2_Stream7_IRQHandler from startup_stm32f407xx.o(.text) referenced from startup_stm32f407xx.o(RESET)
- DebugMon_Handler from stm32f4xx_it.o(.text.DebugMon_Handler) referenced from startup_stm32f407xx.o(RESET)
- ETH_IRQHandler from startup_stm32f407xx.o(.text) referenced from startup_stm32f407xx.o(RESET)
- ETH_WKUP_IRQHandler from startup_stm32f407xx.o(.text) referenced from startup_stm32f407xx.o(RESET)
- EXTI0_IRQHandler from startup_stm32f407xx.o(.text) referenced from startup_stm32f407xx.o(RESET)
- EXTI15_10_IRQHandler from startup_stm32f407xx.o(.text) referenced from startup_stm32f407xx.o(RESET)
- EXTI1_IRQHandler from startup_stm32f407xx.o(.text) referenced from startup_stm32f407xx.o(RESET)
- EXTI2_IRQHandler from startup_stm32f407xx.o(.text) referenced from startup_stm32f407xx.o(RESET)
- EXTI3_IRQHandler from startup_stm32f407xx.o(.text) referenced from startup_stm32f407xx.o(RESET)
- EXTI4_IRQHandler from startup_stm32f407xx.o(.text) referenced from startup_stm32f407xx.o(RESET)
- EXTI9_5_IRQHandler from startup_stm32f407xx.o(.text) referenced from startup_stm32f407xx.o(RESET)
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
- TIM7_IRQHandler from startup_stm32f407xx.o(.text) referenced from startup_stm32f407xx.o(RESET)
- TIM8_BRK_TIM12_IRQHandler from startup_stm32f407xx.o(.text) referenced from startup_stm32f407xx.o(RESET)
- TIM8_CC_IRQHandler from startup_stm32f407xx.o(.text) referenced from startup_stm32f407xx.o(RESET)
- TIM8_TRG_COM_TIM14_IRQHandler from startup_stm32f407xx.o(.text) referenced from startup_stm32f407xx.o(RESET)
- TIM8_UP_TIM13_IRQHandler from startup_stm32f407xx.o(.text) referenced from startup_stm32f407xx.o(RESET)
- UART4_IRQHandler from startup_stm32f407xx.o(.text) referenced from startup_stm32f407xx.o(RESET)
- UART5_IRQHandler from startup_stm32f407xx.o(.text) referenced from startup_stm32f407xx.o(RESET)
- USART1_IRQHandler from startup_stm32f407xx.o(.text) referenced from startup_stm32f407xx.o(RESET)
- USART2_IRQHandler from startup_stm32f407xx.o(.text) referenced from startup_stm32f407xx.o(RESET)
- USART3_IRQHandler from startup_stm32f407xx.o(.text) referenced from startup_stm32f407xx.o(RESET)
- USART6_IRQHandler from startup_stm32f407xx.o(.text) referenced from startup_stm32f407xx.o(RESET)
- UsageFault_Handler from stm32f4xx_it.o(.text.UsageFault_Handler) referenced from startup_stm32f407xx.o(RESET)
- WWDG_IRQHandler from startup_stm32f407xx.o(.text) referenced from startup_stm32f407xx.o(RESET)
- __main from entry.o(.ARM.Collect$$$$00000000) referenced from startup_stm32f407xx.o(.text)
- main from main.o(.text.main) referenced from entry9a.o(.ARM.Collect$$$$0000000B)

### Global Symbols

__main (Thumb, 0 bytes, Stack size unknown bytes, entry.o(.ARM.Collect$$$$00000000))
[Address Reference Count : 1]

- startup_stm32f407xx.o(.text)

_main_stk (Thumb, 0 bytes, Stack size unknown bytes, entry2.o(.ARM.Collect$$$$00000001))

_main_scatterload (Thumb, 0 bytes, Stack size unknown bytes, entry5.o(.ARM.Collect$$$$00000004))

[Calls]

- >> __scatterload

__main_after_scatterload (Thumb, 0 bytes, Stack size unknown bytes, entry5.o(.ARM.Collect$$$$00000004))

[Called By]

- >> __scatterload

_main_clock (Thumb, 0 bytes, Stack size unknown bytes, entry7b.o(.ARM.Collect$$$$00000008))

_main_cpp_init (Thumb, 0 bytes, Stack size unknown bytes, entry8b.o(.ARM.Collect$$$$0000000A))

_main_init (Thumb, 0 bytes, Stack size unknown bytes, entry9a.o(.ARM.Collect$$$$0000000B))

__rt_final_cpp (Thumb, 0 bytes, Stack size unknown bytes, entry10a.o(.ARM.Collect$$$$0000000D))

__rt_final_exit (Thumb, 0 bytes, Stack size unknown bytes, entry11a.o(.ARM.Collect$$$$0000000F))

Reset_Handler (Thumb, 8 bytes, Stack size 0 bytes, startup_stm32f407xx.o(.text))
[Address Reference Count : 1]

- startup_stm32f407xx.o(RESET)

ADC_IRQHandler (Thumb, 0 bytes, Stack size 0 bytes, startup_stm32f407xx.o(.text))

[Calls]

- >> ADC_IRQHandler

[Called By]

- >> ADC_IRQHandler

[Address Reference Count : 1]

- startup_stm32f407xx.o(RESET)

CAN1_RX0_IRQHandler (Thumb, 0 bytes, Stack size 0 bytes, startup_stm32f407xx.o(.text))
[Address Reference Count : 1]

- startup_stm32f407xx.o(RESET)

CAN1_RX1_IRQHandler (Thumb, 0 bytes, Stack size 0 bytes, startup_stm32f407xx.o(.text))
[Address Reference Count : 1]

- startup_stm32f407xx.o(RESET)

CAN1_SCE_IRQHandler (Thumb, 0 bytes, Stack size 0 bytes, startup_stm32f407xx.o(.text))
[Address Reference Count : 1]

- startup_stm32f407xx.o(RESET)

CAN1_TX_IRQHandler (Thumb, 0 bytes, Stack size 0 bytes, startup_stm32f407xx.o(.text))
[Address Reference Count : 1]

- startup_stm32f407xx.o(RESET)

CAN2_RX0_IRQHandler (Thumb, 0 bytes, Stack size 0 bytes, startup_stm32f407xx.o(.text))
[Address Reference Count : 1]

- startup_stm32f407xx.o(RESET)

CAN2_RX1_IRQHandler (Thumb, 0 bytes, Stack size 0 bytes, startup_stm32f407xx.o(.text))
[Address Reference Count : 1]

- startup_stm32f407xx.o(RESET)

CAN2_SCE_IRQHandler (Thumb, 0 bytes, Stack size 0 bytes, startup_stm32f407xx.o(.text))
[Address Reference Count : 1]

- startup_stm32f407xx.o(RESET)

CAN2_TX_IRQHandler (Thumb, 0 bytes, Stack size 0 bytes, startup_stm32f407xx.o(.text))
[Address Reference Count : 1]

- startup_stm32f407xx.o(RESET)

DCMI_IRQHandler (Thumb, 0 bytes, Stack size 0 bytes, startup_stm32f407xx.o(.text))
[Address Reference Count : 1]

- startup_stm32f407xx.o(RESET)

DMA1_Stream0_IRQHandler (Thumb, 0 bytes, Stack size 0 bytes, startup_stm32f407xx.o(.text))
[Address Reference Count : 1]

- startup_stm32f407xx.o(RESET)

DMA1_Stream1_IRQHandler (Thumb, 0 bytes, Stack size 0 bytes, startup_stm32f407xx.o(.text))
[Address Reference Count : 1]

- startup_stm32f407xx.o(RESET)

DMA1_Stream2_IRQHandler (Thumb, 0 bytes, Stack size 0 bytes, startup_stm32f407xx.o(.text))
[Address Reference Count : 1]

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

WWDG_IRQHandler (Thumb, 0 bytes, Stack size 0 bytes, startup_stm32f407xx.o(.text))
[Address Reference Count : 1]

- startup_stm32f407xx.o(RESET)

__aeabi_uldivmod (Thumb, 98 bytes, Stack size 40 bytes, uldiv.o(.text))

[Stack]

- Max Depth = 40
- Call Chain = __aeabi_uldivmod

[Calls]

- >> __aeabi_llsr
- >> __aeabi_llsl

[Called By]

- >> HAL_RCC_GetSysClockFreq

__aeabi_llsl (Thumb, 30 bytes, Stack size 0 bytes, llshl.o(.text))

[Called By]

- >> __aeabi_uldivmod

_ll_shift_l (Thumb, 0 bytes, Stack size 0 bytes, llshl.o(.text), UNUSED)

__aeabi_llsr (Thumb, 32 bytes, Stack size 0 bytes, llushr.o(.text))

[Called By]

- >> __aeabi_uldivmod

_ll_ushift_r (Thumb, 0 bytes, Stack size 0 bytes, llushr.o(.text), UNUSED)

__scatterload (Thumb, 28 bytes, Stack size 0 bytes, init.o(.text))

[Calls]

- >> __main_after_scatterload

[Called By]

- >> _main_scatterload

__scatterload_rt2 (Thumb, 0 bytes, Stack size 0 bytes, init.o(.text), UNUSED)

BusFault_Handler (Thumb, 2 bytes, Stack size 0 bytes, stm32f4xx_it.o(.text.BusFault_Handler))

[Calls]

- >> BusFault_Handler

[Called By]

- >> BusFault_Handler

[Address Reference Count : 1]

- startup_stm32f407xx.o(RESET)

DebugMon_Handler (Thumb, 2 bytes, Stack size 0 bytes, stm32f4xx_it.o(.text.DebugMon_Handler))
[Address Reference Count : 1]

- startup_stm32f407xx.o(RESET)

HAL_Delay (Thumb, 40 bytes, Stack size 16 bytes, stm32f4xx_hal.o(.text.HAL_Delay))

[Stack]

- Max Depth = 16
- Call Chain = HAL_Delay

[Calls]

- >> HAL_GetTick

[Called By]

- >> main

HAL_GPIO_Init (Thumb, 434 bytes, Stack size 44 bytes, stm32f4xx_hal_gpio.o(.text.HAL_GPIO_Init))

[Stack]

- Max Depth = 44
- Call Chain = HAL_GPIO_Init

[Called By]

- >> main

HAL_GPIO_TogglePin (Thumb, 14 bytes, Stack size 0 bytes, stm32f4xx_hal_gpio.o(.text.HAL_GPIO_TogglePin))

[Called By]

- >> main

HAL_GPIO_WritePin (Thumb, 10 bytes, Stack size 0 bytes, stm32f4xx_hal_gpio.o(.text.HAL_GPIO_WritePin))

[Called By]

- >> main

HAL_GetTick (Thumb, 12 bytes, Stack size 0 bytes, stm32f4xx_hal.o(.text.HAL_GetTick))

[Called By]

- >> HAL_RCC_ClockConfig
- >> HAL_RCC_OscConfig
- >> HAL_Delay

HAL_IncTick (Thumb, 26 bytes, Stack size 0 bytes, stm32f4xx_hal.o(.text.HAL_IncTick))

[Called By]

- >> SysTick_Handler

HAL_Init (Thumb, 54 bytes, Stack size 8 bytes, stm32f4xx_hal.o(.text.HAL_Init))

[Stack]

- Max Depth = 32
- Call Chain = HAL_Init ⇒ HAL_InitTick ⇒ HAL_NVIC_SetPriority

[Calls]

- >> HAL_NVIC_SetPriorityGrouping
- >> HAL_InitTick
- >> HAL_MspInit

[Called By]

- >> main

HAL_InitTick (Thumb, 72 bytes, Stack size 16 bytes, stm32f4xx_hal.o(.text.HAL_InitTick))

[Stack]

- Max Depth = 24
- Call Chain = HAL_InitTick ⇒ HAL_NVIC_SetPriority

[Calls]

- >> HAL_SYSTICK_Config
- >> HAL_NVIC_SetPriority

[Called By]

- >> HAL_RCC_ClockConfig
- >> HAL_Init

HAL_MspInit (Thumb, 56 bytes, Stack size 8 bytes, stm32f4xx_hal_msp.o(.text.HAL_MspInit))

[Stack]

- Max Depth = 8
- Call Chain = HAL_MspInit

[Called By]

- >> HAL_Init

HAL_NVIC_SetPriority (Thumb, 86 bytes, Stack size 8 bytes, stm32f4xx_hal_cortex.o(.text.HAL_NVIC_SetPriority))

[Stack]

- Max Depth = 8
- Call Chain = HAL_NVIC_SetPriority

[Called By]

- >> HAL_InitTick

HAL_NVIC_SetPriorityGrouping (Thumb, 32 bytes, Stack size 0 bytes, stm32f4xx_hal_cortex.o(.text.HAL_NVIC_SetPriorityGrouping))

[Called By]

- >> HAL_Init

HAL_RCC_ClockConfig (Thumb, 352 bytes, Stack size 24 bytes, stm32f4xx_hal_rcc.o(.text.HAL_RCC_ClockConfig))

[Stack]

- Max Depth = 72
- Call Chain = HAL_RCC_ClockConfig ⇒ HAL_RCC_GetSysClockFreq ⇒ __aeabi_uldivmod

[Calls]

- >> HAL_InitTick
- >> HAL_RCC_GetSysClockFreq
- >> HAL_GetTick

[Called By]

- >> SystemClock_Config

HAL_RCC_GetSysClockFreq (Thumb, 108 bytes, Stack size 8 bytes, stm32f4xx_hal_rcc.o(.text.HAL_RCC_GetSysClockFreq))

[Stack]

- Max Depth = 48
- Call Chain = HAL_RCC_GetSysClockFreq ⇒ __aeabi_uldivmod

[Calls]

- >> __aeabi_uldivmod

[Called By]

- >> HAL_RCC_ClockConfig

HAL_RCC_OscConfig (Thumb, 868 bytes, Stack size 32 bytes, stm32f4xx_hal_rcc.o(.text.HAL_RCC_OscConfig))

[Stack]

- Max Depth = 32
- Call Chain = HAL_RCC_OscConfig

[Calls]

- >> HAL_GetTick

[Called By]

- >> SystemClock_Config

HAL_SYSTICK_Config (Thumb, 44 bytes, Stack size 0 bytes, stm32f4xx_hal_cortex.o(.text.HAL_SYSTICK_Config))

[Called By]

- >> HAL_InitTick

HardFault_Handler (Thumb, 2 bytes, Stack size 0 bytes, stm32f4xx_it.o(.text.HardFault_Handler))

[Calls]

- >> HardFault_Handler

[Called By]

- >> HardFault_Handler

[Address Reference Count : 1]

- startup_stm32f407xx.o(RESET)

MemManage_Handler (Thumb, 2 bytes, Stack size 0 bytes, stm32f4xx_it.o(.text.MemManage_Handler))

[Calls]

- >> MemManage_Handler

[Called By]

- >> MemManage_Handler

[Address Reference Count : 1]

- startup_stm32f407xx.o(RESET)

NMI_Handler (Thumb, 2 bytes, Stack size 0 bytes, stm32f4xx_it.o(.text.NMI_Handler))

[Calls]

- >> NMI_Handler

[Called By]

- >> NMI_Handler

[Address Reference Count : 1]

- startup_stm32f407xx.o(RESET)

PendSV_Handler (Thumb, 2 bytes, Stack size 0 bytes, stm32f4xx_it.o(.text.PendSV_Handler))
[Address Reference Count : 1]

- startup_stm32f407xx.o(RESET)

SVC_Handler (Thumb, 2 bytes, Stack size 0 bytes, stm32f4xx_it.o(.text.SVC_Handler))
[Address Reference Count : 1]

- startup_stm32f407xx.o(RESET)

SysTick_Handler (Thumb, 4 bytes, Stack size 0 bytes, stm32f4xx_it.o(.text.SysTick_Handler))

[Calls]

- >> HAL_IncTick

[Address Reference Count : 1]

- startup_stm32f407xx.o(RESET)

SystemClock_Config (Thumb, 176 bytes, Stack size 88 bytes, main.o(.text.SystemClock_Config))

[Stack]

- Max Depth = 160
- Call Chain = SystemClock_Config ⇒ HAL_RCC_ClockConfig ⇒ HAL_RCC_GetSysClockFreq ⇒ __aeabi_uldivmod

[Calls]

- >> HAL_RCC_ClockConfig
- >> HAL_RCC_OscConfig

[Called By]

- >> main

SystemInit (Thumb, 26 bytes, Stack size 0 bytes, system_stm32f4xx.o(.text.SystemInit))
[Address Reference Count : 1]

- startup_stm32f407xx.o(.text)

UsageFault_Handler (Thumb, 2 bytes, Stack size 0 bytes, stm32f4xx_it.o(.text.UsageFault_Handler))

[Calls]

- >> UsageFault_Handler

[Called By]

- >> UsageFault_Handler

[Address Reference Count : 1]

- startup_stm32f407xx.o(RESET)

main (Thumb, 118 bytes, Stack size 24 bytes, main.o(.text.main))

[Stack]

- Max Depth = 184
- Call Chain = main ⇒ SystemClock_Config ⇒ HAL_RCC_ClockConfig ⇒ HAL_RCC_GetSysClockFreq ⇒ __aeabi_uldivmod

[Calls]

- >> HAL_Delay
- >> HAL_GPIO_TogglePin
- >> HAL_GPIO_Init
- >> HAL_GPIO_WritePin
- >> SystemClock_Config
- >> HAL_Init

[Address Reference Count : 1]

- entry9a.o(.ARM.Collect$$$$0000000B)

__scatterload_copy (Thumb, 14 bytes, Stack size unknown bytes, handlers.o(i.__scatterload_copy), UNUSED)

__scatterload_null (Thumb, 2 bytes, Stack size unknown bytes, handlers.o(i.__scatterload_null), UNUSED)

__scatterload_zeroinit (Thumb, 14 bytes, Stack size unknown bytes, handlers.o(i.__scatterload_zeroinit), UNUSED)

### Local Symbols

### Undefined Global Symbols
