samim-robotix/IRoCU-2024-ISRO-Rover/ISRO Total File/ARM/test base-RHSFM_{Motion Study 1}-BenchMark-Solver.txt

Solver 0.009 Linear-static-solver-Start 0 0 0 0 0 0 0 0 0 0 0 0 0 0 0 0 0 0 0 0 0 0 0 0 0 0 0 0
Solver 0.009 Loading-and-preparing-input-data-Start 0 0 0 0 0 0 0 0 0 0 0 0 0 0 0 0 0 0 0 0 0 0 0 0 0 0 0 0
Solver 0.232 Loading-and-preparing-input-data-End 0 0 0 0 0 0 0 0 0 0 0 0 0 0 0 0 0 0 0 0 0 0 0 0 0 0 0 0
Solver 0.232 Computing-load-vector-Start 0 0 0 0 0 0 0 0 0 0 0 0 0 0 0 0 0 0 0 0 0 0 0 0 0 0 0 0
Solver 0.314 Computing-load-vector-End 0 0 0 0 0 0 0 0 0 0 0 0 0 0 0 0 0 0 0 0 0 0 0 0 0 0 0 0
Solver 0.448 Computing-element-stiffness-matrix-Start 0 0 0 0 0 0 0 0 0 0 0 0 0 0 0 0 0 0 0 0 0 0 0 0 0 0 0 0
Solver 0.578 Computing-element-stiffness-matrix-End 0 0 0 0 0 0 0 0 0 0 0 0 0 0 0 0 0 0 0 0 0 0 0 0 0 0 0 0
Solver 0.588 RE-ARRANGING-GLOBAL-STIFFNESS-MATRIX-ARRAYS-FOR-INTEL-SOLVER-Start 0 0 0 0 0 0 0 0 0 0 0 0 0 0 0 0 0 0 0 0 0 0 0 0 0 0 0 0
Solver 0.613 RE-ARRANGING-GLOBAL-STIFFNESS-MATRIX-ARRAYS-FOR-INTEL-SOLVER-End 0 0 0 0 0 0 0 0 0 0 0 0 0 0 0 0 0 0 0 0 0 0 0 0 0 0 0 0
Solver 0.613 INITIALIZING-INTEL-SOLVER-Start 0 0 0 0 0 0 0 0 0 0 0 0 0 0 0 0 0 0 0 0 0 0 0 0 0 0 0 0
Solver 0.642 INITIALIZING-INTEL-SOLVER-End 0 0 0 0 0 0 0 0 0 0 0 0 0 0 0 0 0 0 0 0 0 0 0 0 0 0 0 0
Solver 1.118 GLOBAL-STIFFNESS-MATRIX-DECOMPOSITION-Start 0 0 0 0 0 0 0 0 0 0 0 0 0 0 0 0 0 0 0 0 0 0 0 0 0 0 0 0
Solver 1.290 GLOBAL-STIFFNESS-MATRIX-DECOMPOSITION-End 0 0 0 0 0 0 0 0 0 0 0 0 0 0 0 0 0 0 0 0 0 0 0 0 0 0 0 0
Solver 1.293 BACK&FORWARD-SUBSTITUATION-Start 0 0 0 0 0 0 0 0 0 0 0 0 0 0 0 0 0 0 0 0 0 0 0 0 0 0 0 0
Solver 1.322 BACK&FORWARD-SUBSTITUATION-End 0 0 0 0 0 0 0 0 0 0 0 0 0 0 0 0 0 0 0 0 0 0 0 0 0 0 0 0
Solver 1.448 Computing-reaction-forces-for-load-case(LCASE)=1-Start 0 0 0 0 0 0 0 0 0 0 0 0 0 0 0 0 0 0 0 0 0 0 0 0 0 0 0 0
Solver 1.563 Computing-reaction-forces-for-load-case(LCASE)=1-End 0 0 0 0 0 0 0 0 0 0 0 0 0 0 0 0 0 0 0 0 0 0 0 0 0 0 0 0
Solver 1.564 Computing-stresses-for-load-case=1-Start 0 0 0 0 0 0 0 0 0 0 0 0 0 0 0 0 0 0 0 0 0 0 0 0 0 0 0 0
Solver 1.591 Computing-stresses-for-load-case=1-End 0 0 0 0 0 0 0 0 0 0 0 0 0 0 0 0 0 0 0 0 0 0 0 0 0 0 0 0
Solver 1.593 Linear-static-solver-End 0 0 0 0 0 0 0 0 0 0 0 0 0 0 0 0 0 0 0 0 0 0 0 0 0 0 0 0
SOLVER TYPE= Intel Direct Sparse Solver
Number of Equations (NEQ)=42972
Number of Nodal points (NUMNP)=14314
Number of Pseudo nodes (NUMPS)=5
Number of Elements (NUME)=7977
Number of Pseudo Elements (NUMP)=5
SOLUTION TIME LOG
Time for Input Data Transfer from Database =1.941000
TIME FOR CALCULATION  OF STRUCTURE STIFFNESS MATRIX (STF_PHASE)=0.185000
TIME FOR INTEL SPARSE REORDERING EQUATIONS (REN_PHASE)=0.530000
TIME FOR INTEL SPARSE (LDL DECOMPOSITION) (DEC_PHASE)=0.172000
TIME FOR INTEL SPARSE (FWD & BWD SUBSTITUTIONS) (FBS_PHASE)=0.029000
TIME FOR LCP CONTACT (AND/OR LRG DISP) OPERATIONS (CNT_PHASE)=0.000000
TIME FOR REACTION FORCE & DISP UPDATE TO POST (REC_PAHSE)=0.239000
TIME FOR STRESS CALCULATION (STS_PHASE)=0.028000
TIME FOR WRITING POST PROCESSING INFORMATION (PST_PHASE)=0.000000
TOTAL SOLUTION TIME (TOT_TIME)=2.436000
