samim-robotix/IRoCU-2024-ISRO-Rover/ISRO Total File/ARM/testassm-RHSFM_{Motion Study 2}-BenchMark-Solver.txt

Solver 0.016 Linear-static-solver-Start 0 0 0 0 0 0 0 0 0 0 0 0 0 0 0 0 0 0 0 0 0 0 0 0 0 0 0 0
Solver 0.016 Loading-and-preparing-input-data-Start 0 0 0 0 0 0 0 0 0 0 0 0 0 0 0 0 0 0 0 0 0 0 0 0 0 0 0 0
Solver 0.422 Loading-and-preparing-input-data-End 0 0 0 0 0 0 0 0 0 0 0 0 0 0 0 0 0 0 0 0 0 0 0 0 0 0 0 0
Solver 0.422 Computing-load-vector-Start 0 0 0 0 0 0 0 0 0 0 0 0 0 0 0 0 0 0 0 0 0 0 0 0 0 0 0 0
Solver 0.516 Computing-load-vector-End 0 0 0 0 0 0 0 0 0 0 0 0 0 0 0 0 0 0 0 0 0 0 0 0 0 0 0 0
Solver 0.703 Computing-element-stiffness-matrix-Start 0 0 0 0 0 0 0 0 0 0 0 0 0 0 0 0 0 0 0 0 0 0 0 0 0 0 0 0
Solver 0.922 Computing-element-stiffness-matrix-End 0 0 0 0 0 0 0 0 0 0 0 0 0 0 0 0 0 0 0 0 0 0 0 0 0 0 0 0
Solver 0.922 RE-ARRANGING-GLOBAL-STIFFNESS-MATRIX-ARRAYS-FOR-INTEL-SOLVER-Start 0 0 0 0 0 0 0 0 0 0 0 0 0 0 0 0 0 0 0 0 0 0 0 0 0 0 0 0
Solver 0.969 RE-ARRANGING-GLOBAL-STIFFNESS-MATRIX-ARRAYS-FOR-INTEL-SOLVER-End 0 0 0 0 0 0 0 0 0 0 0 0 0 0 0 0 0 0 0 0 0 0 0 0 0 0 0 0
Solver 0.969 INITIALIZING-INTEL-SOLVER-Start 0 0 0 0 0 0 0 0 0 0 0 0 0 0 0 0 0 0 0 0 0 0 0 0 0 0 0 0
Solver 0.969 INITIALIZING-INTEL-SOLVER-End 0 0 0 0 0 0 0 0 0 0 0 0 0 0 0 0 0 0 0 0 0 0 0 0 0 0 0 0
Solver 1.751 GLOBAL-STIFFNESS-MATRIX-DECOMPOSITION-Start 0 0 0 0 0 0 0 0 0 0 0 0 0 0 0 0 0 0 0 0 0 0 0 0 0 0 0 0
Solver 2.032 GLOBAL-STIFFNESS-MATRIX-DECOMPOSITION-End 0 0 0 0 0 0 0 0 0 0 0 0 0 0 0 0 0 0 0 0 0 0 0 0 0 0 0 0
Solver 2.032 BACK&FORWARD-SUBSTITUATION-Start 0 0 0 0 0 0 0 0 0 0 0 0 0 0 0 0 0 0 0 0 0 0 0 0 0 0 0 0
Solver 2.079 BACK&FORWARD-SUBSTITUATION-End 0 0 0 0 0 0 0 0 0 0 0 0 0 0 0 0 0 0 0 0 0 0 0 0 0 0 0 0
Solver 2.454 Computing-reaction-forces-for-load-case(LCASE)=1-Start 0 0 0 0 0 0 0 0 0 0 0 0 0 0 0 0 0 0 0 0 0 0 0 0 0 0 0 0
Solver 2.641 Computing-reaction-forces-for-load-case(LCASE)=1-End 0 0 0 0 0 0 0 0 0 0 0 0 0 0 0 0 0 0 0 0 0 0 0 0 0 0 0 0
Solver 2.641 Computing-stresses-for-load-case=1-Start 0 0 0 0 0 0 0 0 0 0 0 0 0 0 0 0 0 0 0 0 0 0 0 0 0 0 0 0
Solver 2.688 Computing-stresses-for-load-case=1-End 0 0 0 0 0 0 0 0 0 0 0 0 0 0 0 0 0 0 0 0 0 0 0 0 0 0 0 0
Solver 2.688 Linear-static-solver-End 0 0 0 0 0 0 0 0 0 0 0 0 0 0 0 0 0 0 0 0 0 0 0 0 0 0 0 0
SOLVER TYPE= Intel Direct Sparse Solver
Number of Equations (NEQ)=86916
Number of Nodal points (NUMNP)=28952
Number of Pseudo nodes (NUMPS)=10
Number of Elements (NUME)=15243
Number of Pseudo Elements (NUMP)=10
SOLUTION TIME LOG
Time for Input Data Transfer from Database =2.436000
TIME FOR CALCULATION  OF STRUCTURE STIFFNESS MATRIX (STF_PHASE)=0.266000
TIME FOR INTEL SPARSE REORDERING EQUATIONS (REN_PHASE)=0.829000
TIME FOR INTEL SPARSE (LDL DECOMPOSITION) (DEC_PHASE)=0.281000
TIME FOR INTEL SPARSE (FWD & BWD SUBSTITUTIONS) (FBS_PHASE)=0.047000
TIME FOR LCP CONTACT (AND/OR LRG DISP) OPERATIONS (CNT_PHASE)=0.000000
TIME FOR REACTION FORCE & DISP UPDATE TO POST (REC_PAHSE)=0.547000
TIME FOR STRESS CALCULATION (STS_PHASE)=0.047000
TIME FOR WRITING POST PROCESSING INFORMATION (PST_PHASE)=0.000000
TOTAL SOLUTION TIME (TOT_TIME)=3.750000
