samim-robotix/IRoCU-2024-ISRO-Rover/ISRO Total File/New Designs/PerformanceLog.txt

Number of Contacts: 1
Number of contact data: 2227
