samim-robotix/IRoCU-2024-ISRO-Rover/ISRO Total File/ISRO Robotics Challenge/ML Images/20_40Craters.v2i.yolov8/test/images/frame_0_jpg.rf.955f1a8d9101b0fab0077a4e25dabf0c.jpg

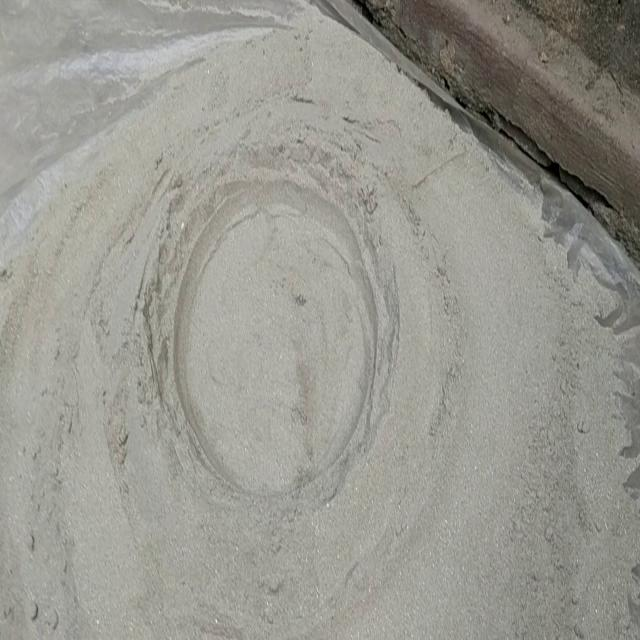
ISRO Total File/ISRO Robotics Challenge/ML Images/20_40Craters.v2i.yolov8/test/images/frame_0_jpg.rf.955f1a8d9101b0fab0077a4e25dabf0c.jpg
