samim-robotix/IRoCU-2024-ISRO-Rover/ISRO Total File/ISRO Robotics Challenge/ML Images/20_40Craters.v2i.yolov8/test/images/frame_18_jpg.rf.edbf5e88460313b6c0173abe0db3d2c6.jpg

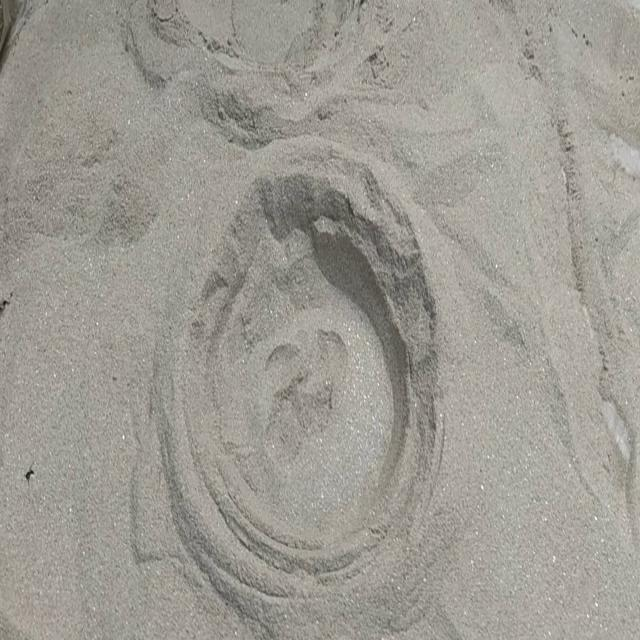
ISRO Total File/ISRO Robotics Challenge/ML Images/20_40Craters.v2i.yolov8/test/images/frame_18_jpg.rf.edbf5e88460313b6c0173abe0db3d2c6.jpg
