samim-robotix/IRoCU-2024-ISRO-Rover/ISRO Total File/ISRO Robotics Challenge/ML Images/20_40Craters.v2i.yolov8/test/images/frame_21_jpg.rf.fa962cbeaae09e22ce762783d5427bed.jpg

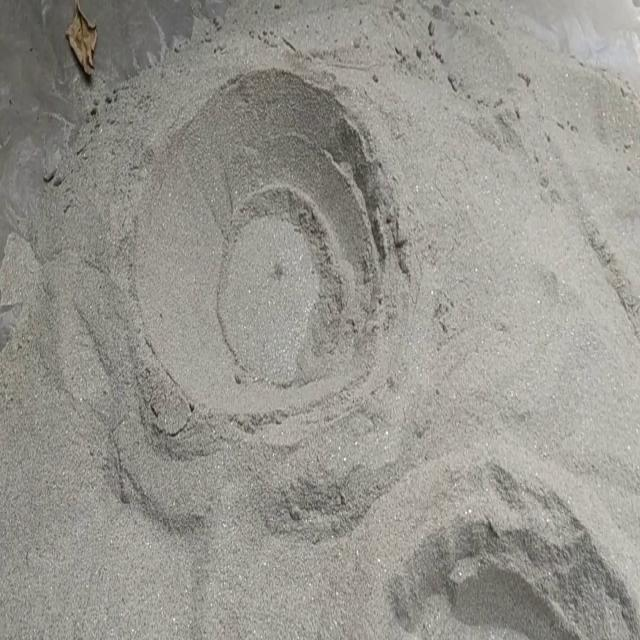
ISRO Total File/ISRO Robotics Challenge/ML Images/20_40Craters.v2i.yolov8/test/images/frame_21_jpg.rf.fa962cbeaae09e22ce762783d5427bed.jpg
