samim-robotix/IRoCU-2024-ISRO-Rover/ISRO Total File/ISRO Robotics Challenge/ML Images/20_40Craters.v2i.yolov8/test/images/frame_24_jpg.rf.c3da05e362c2f68aadb30bab83d26d77.jpg

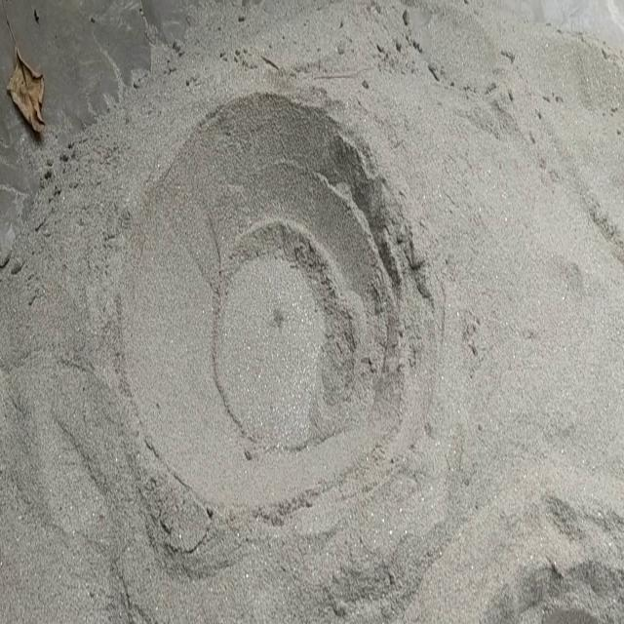
ISRO Total File/ISRO Robotics Challenge/ML Images/20_40Craters.v2i.yolov8/test/images/frame_24_jpg.rf.c3da05e362c2f68aadb30bab83d26d77.jpg
