samim-robotix/IRoCU-2024-ISRO-Rover/ISRO Total File/ISRO Robotics Challenge/ML Images/20_40Craters.v2i.yolov8/test/images/frame_30_jpg.rf.64c21974e668d738d9461d616d909665.jpg

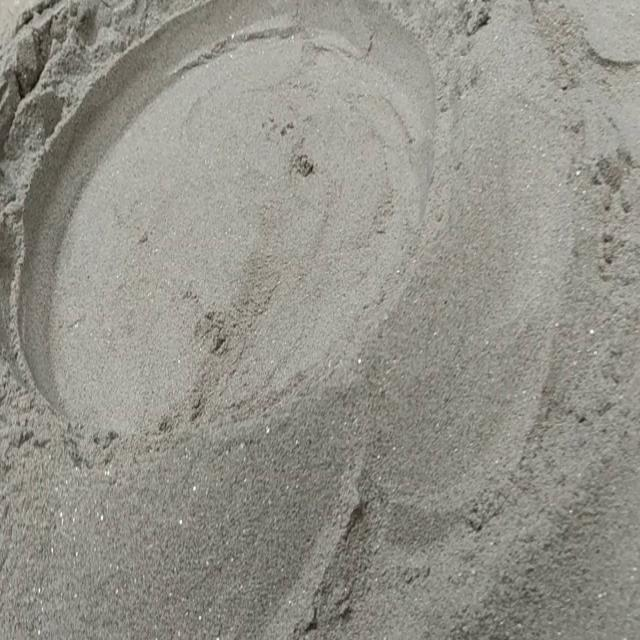
ISRO Total File/ISRO Robotics Challenge/ML Images/20_40Craters.v2i.yolov8/test/images/frame_30_jpg.rf.64c21974e668d738d9461d616d909665.jpg
