samim-robotix/IRoCU-2024-ISRO-Rover/ISRO Total File/ISRO Robotics Challenge/ML Images/20_40Craters.v2i.yolov8/test/images/frame_31_jpg.rf.630898386d571bf4b11e85e1b5c37819.jpg

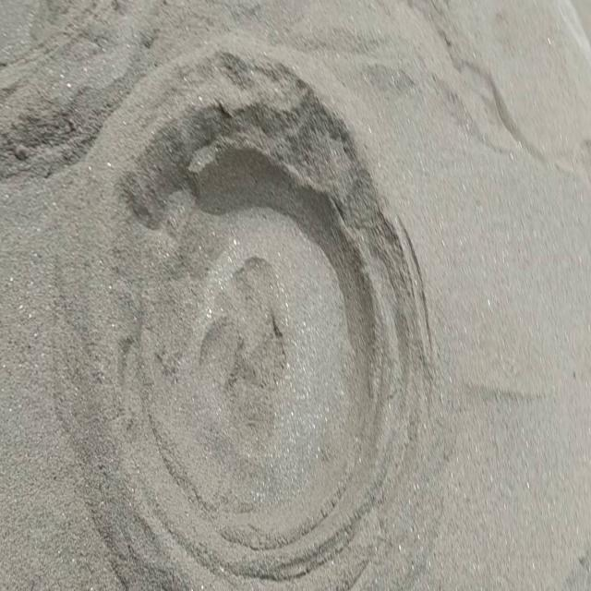
ISRO Total File/ISRO Robotics Challenge/ML Images/20_40Craters.v2i.yolov8/test/images/frame_31_jpg.rf.630898386d571bf4b11e85e1b5c37819.jpg
