samim-robotix/IRoCU-2024-ISRO-Rover/ISRO Total File/ISRO Robotics Challenge/ML Images/20_40Craters.v2i.yolov8/test/images/frame_36_jpg.rf.19f9b931255b3f4eae57b90a6f0808d5.jpg

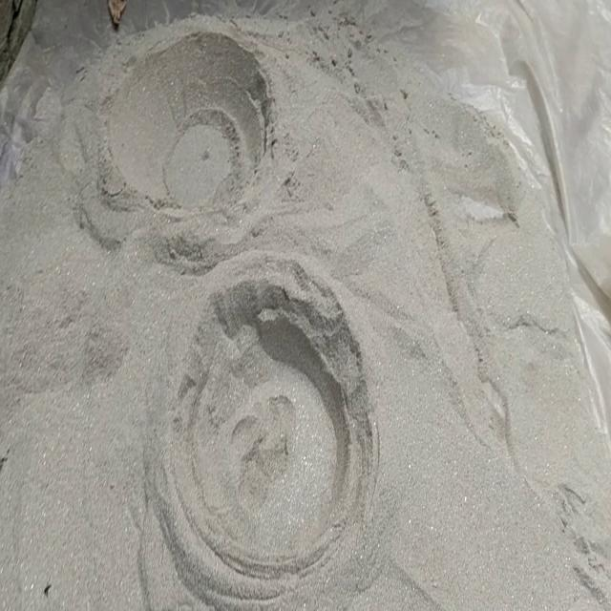
ISRO Total File/ISRO Robotics Challenge/ML Images/20_40Craters.v2i.yolov8/test/images/frame_36_jpg.rf.19f9b931255b3f4eae57b90a6f0808d5.jpg
