samim-robotix/IRoCU-2024-ISRO-Rover/ISRO Total File/ISRO Robotics Challenge/ML Images/20_40Craters.v2i.yolov8/test/images/frame_52_jpg.rf.853bc58a54557a34fde5d741a80de888.jpg

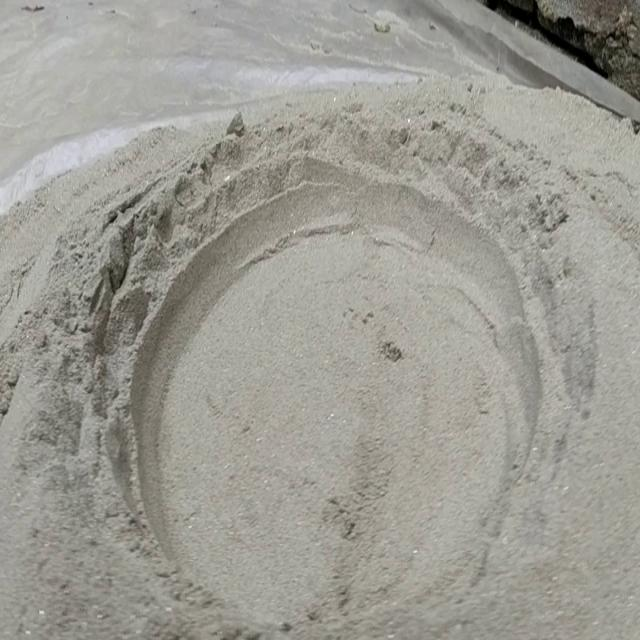
ISRO Total File/ISRO Robotics Challenge/ML Images/20_40Craters.v2i.yolov8/test/images/frame_52_jpg.rf.853bc58a54557a34fde5d741a80de888.jpg
