samim-robotix/IRoCU-2024-ISRO-Rover/ISRO Total File/ISRO Robotics Challenge/ML Images/20_40Craters.v2i.yolov8/test/images/frame_53_jpg.rf.8e456ae22c4a269490d6a757f4448172.jpg

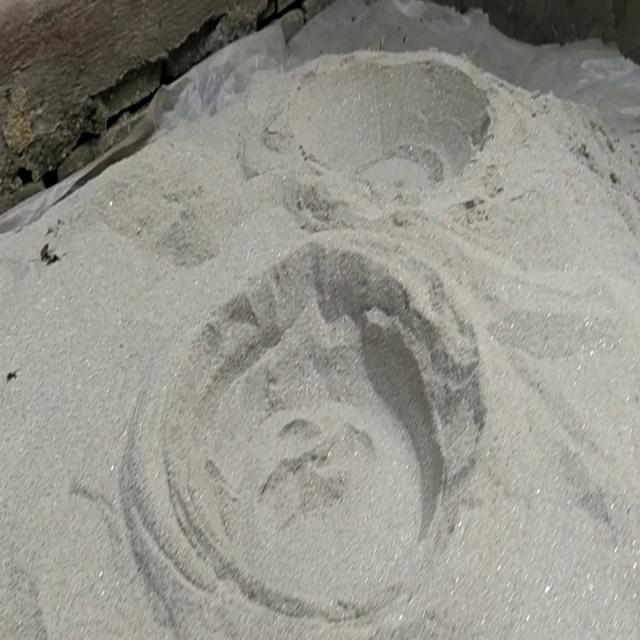
ISRO Total File/ISRO Robotics Challenge/ML Images/20_40Craters.v2i.yolov8/test/images/frame_53_jpg.rf.8e456ae22c4a269490d6a757f4448172.jpg
