samim-robotix/IRoCU-2024-ISRO-Rover/ISRO Total File/ISRO Robotics Challenge/ML Images/20_40Craters.v2i.yolov8/test/images/frame_58_jpg.rf.1c027d7190a5aeef096a21461aa4d078.jpg

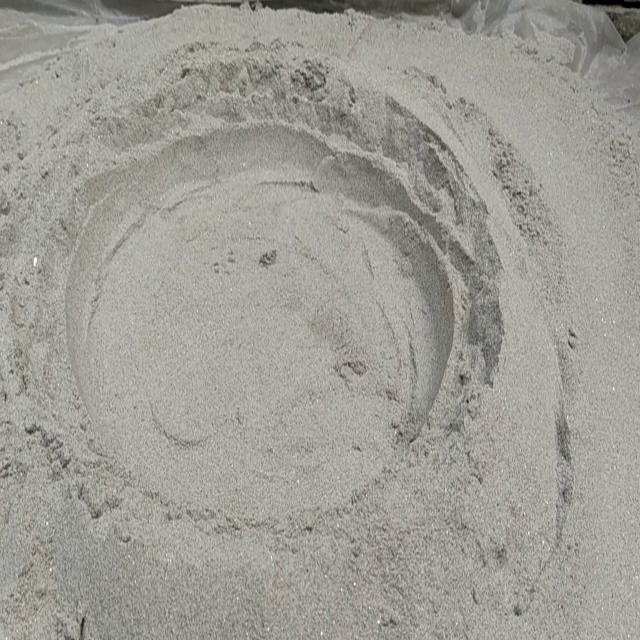
ISRO Total File/ISRO Robotics Challenge/ML Images/20_40Craters.v2i.yolov8/test/images/frame_58_jpg.rf.1c027d7190a5aeef096a21461aa4d078.jpg
