samim-robotix/IRoCU-2024-ISRO-Rover/ISRO Total File/ISRO Robotics Challenge/ML Images/20_40Craters.v2i.yolov8/test/images/frame_58_jpg.rf.6510461e11d0c4d6f3da4bd5aef39618.jpg

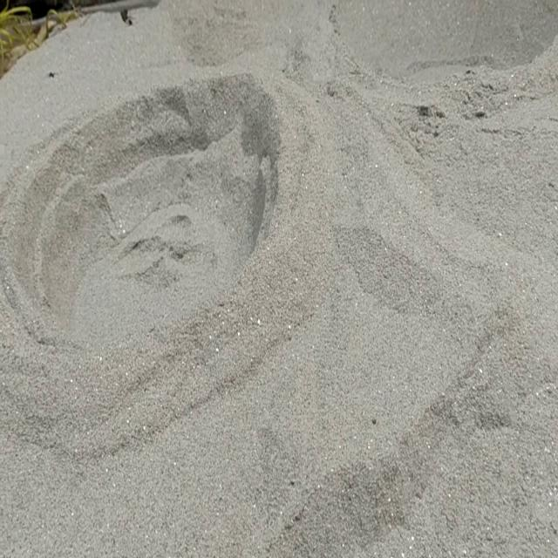
ISRO Total File/ISRO Robotics Challenge/ML Images/20_40Craters.v2i.yolov8/test/images/frame_58_jpg.rf.6510461e11d0c4d6f3da4bd5aef39618.jpg
