samim-robotix/IRoCU-2024-ISRO-Rover/ISRO Total File/ISRO Robotics Challenge/ML Images/20_40Craters.v2i.yolov8/test/images/frame_61_jpg.rf.86a1ff5e26e80b35115bc801a127860c.jpg

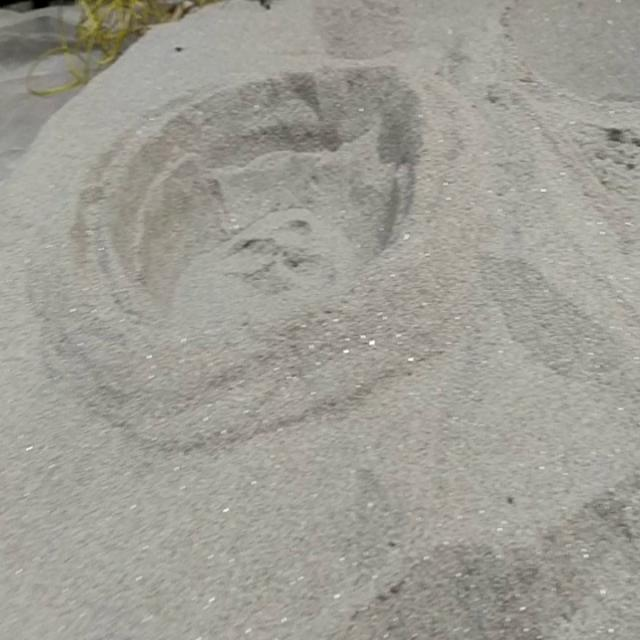
ISRO Total File/ISRO Robotics Challenge/ML Images/20_40Craters.v2i.yolov8/test/images/frame_61_jpg.rf.86a1ff5e26e80b35115bc801a127860c.jpg
