samim-robotix/IRoCU-2024-ISRO-Rover/ISRO Total File/ISRO Robotics Challenge/ML Images/20_40Craters.v2i.yolov8/test/images/frame_87_jpg.rf.5fdbba67c4e95827f6aa7275c47bcf81.jpg

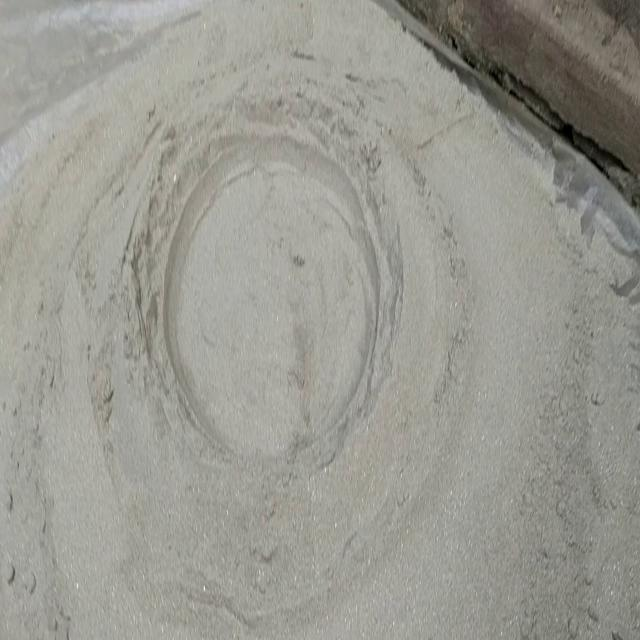
ISRO Total File/ISRO Robotics Challenge/ML Images/20_40Craters.v2i.yolov8/test/images/frame_87_jpg.rf.5fdbba67c4e95827f6aa7275c47bcf81.jpg
