samim-robotix/IRoCU-2024-ISRO-Rover/ISRO Total File/ISRO Robotics Challenge/ML Images/20_40Craters.v2i.yolov8/test/images/frame_100_jpg.rf.7f71a5288e7fa64a30d84a5c8c2b8198.jpg

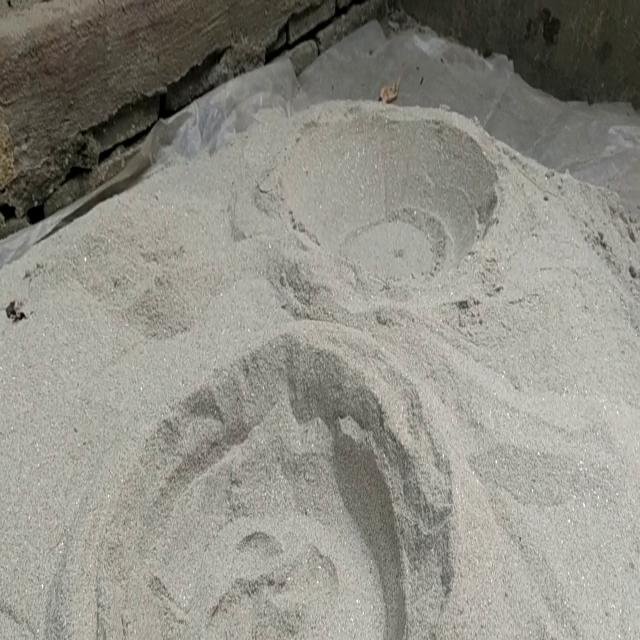
ISRO Total File/ISRO Robotics Challenge/ML Images/20_40Craters.v2i.yolov8/test/images/frame_100_jpg.rf.7f71a5288e7fa64a30d84a5c8c2b8198.jpg
