samim-robotix/IRoCU-2024-ISRO-Rover/ISRO Total File/ISRO Robotics Challenge/ML Images/20_40Craters.v2i.yolov8/test/images/frame_109_jpg.rf.b638cf8df8e1ac0b2d7dc1ef3433aad8.jpg

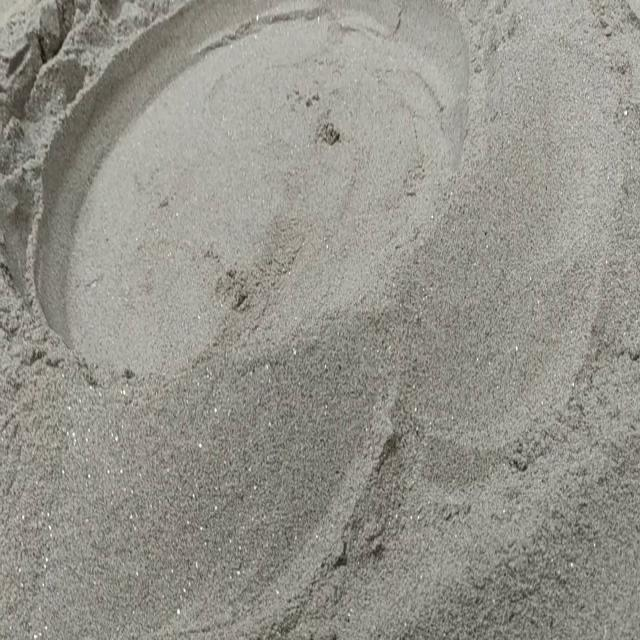
ISRO Total File/ISRO Robotics Challenge/ML Images/20_40Craters.v2i.yolov8/test/images/frame_109_jpg.rf.b638cf8df8e1ac0b2d7dc1ef3433aad8.jpg
