samim-robotix/IRoCU-2024-ISRO-Rover/ISRO Total File/ISRO Robotics Challenge/ML Images/20_40Craters.v2i.yolov8/test/images/frame_111_jpg.rf.56bb55320ac0ef8b856a2cbcff0eeb7b.jpg

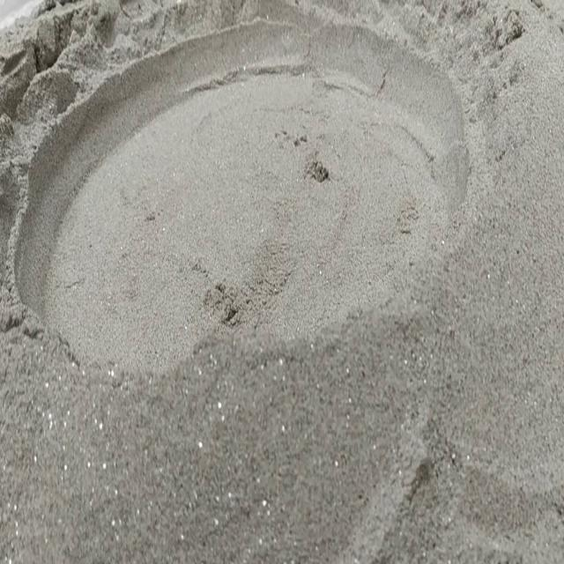
ISRO Total File/ISRO Robotics Challenge/ML Images/20_40Craters.v2i.yolov8/test/images/frame_111_jpg.rf.56bb55320ac0ef8b856a2cbcff0eeb7b.jpg
