samim-robotix/IRoCU-2024-ISRO-Rover/ISRO Total File/ISRO Robotics Challenge/ML Images/20_40Craters.v2i.yolov8/test/images/frame_116_jpg.rf.db2e6356cd2e5a57df9df077ab689009.jpg

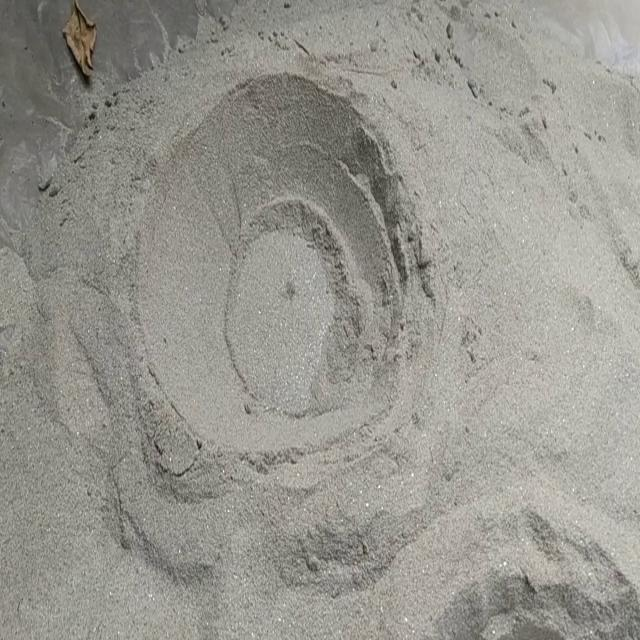
ISRO Total File/ISRO Robotics Challenge/ML Images/20_40Craters.v2i.yolov8/test/images/frame_116_jpg.rf.db2e6356cd2e5a57df9df077ab689009.jpg
