samim-robotix/IRoCU-2024-ISRO-Rover/ISRO Total File/ISRO Robotics Challenge/ML Images/20_40Craters.v2i.yolov8/test/images/frame_120_jpg.rf.0319d7eee21e217f273f4e385b20e931.jpg

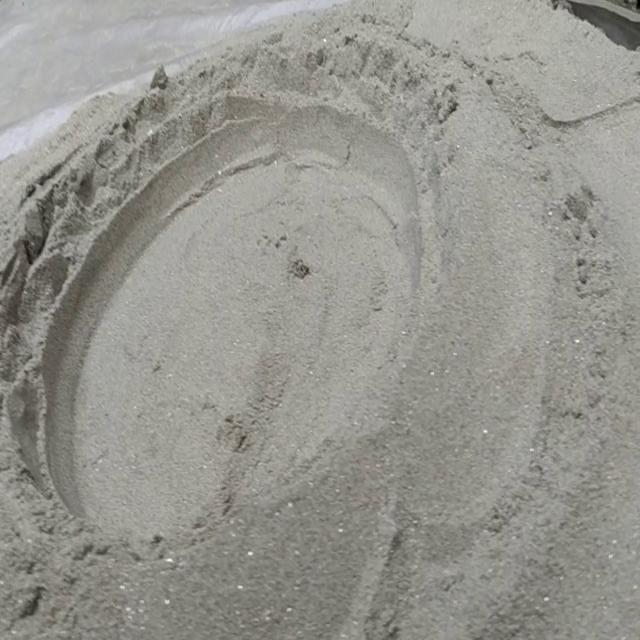
ISRO Total File/ISRO Robotics Challenge/ML Images/20_40Craters.v2i.yolov8/test/images/frame_120_jpg.rf.0319d7eee21e217f273f4e385b20e931.jpg
