samim-robotix/IRoCU-2024-ISRO-Rover/ISRO Total File/ISRO Robotics Challenge/ML Images/20_40Craters.v2i.yolov8/test/images/frame_131_jpg.rf.076a27cdda87ed61c7e60b859588928e.jpg

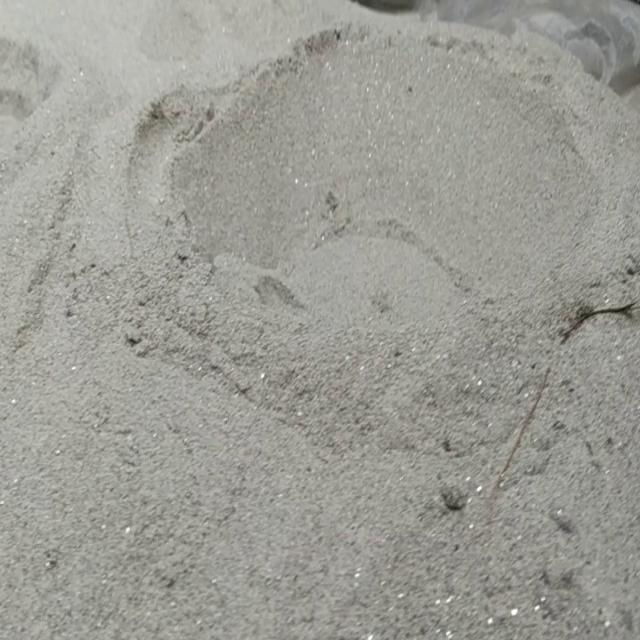
ISRO Total File/ISRO Robotics Challenge/ML Images/20_40Craters.v2i.yolov8/test/images/frame_131_jpg.rf.076a27cdda87ed61c7e60b859588928e.jpg
