samim-robotix/IRoCU-2024-ISRO-Rover/ISRO Total File/ISRO Robotics Challenge/ML Images/20_40Craters.v2i.yolov8/test/images/frame_131_jpg.rf.754aff859b80f08bd2ebe40e262cacd6.jpg

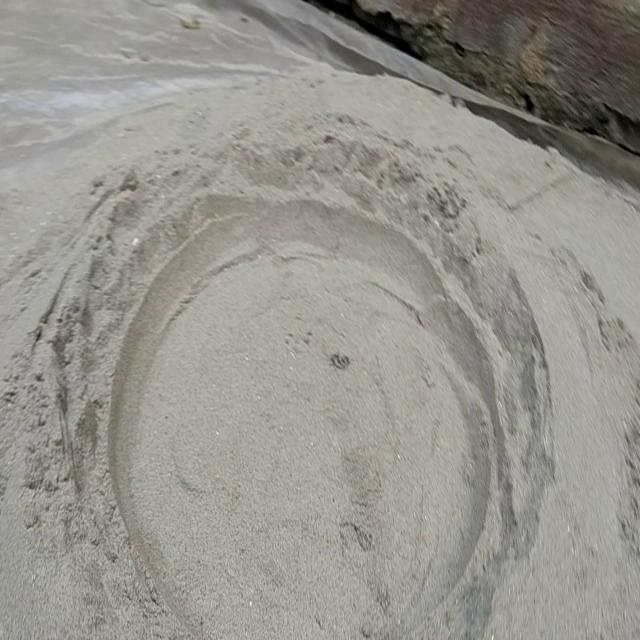
ISRO Total File/ISRO Robotics Challenge/ML Images/20_40Craters.v2i.yolov8/test/images/frame_131_jpg.rf.754aff859b80f08bd2ebe40e262cacd6.jpg
