samim-robotix/IRoCU-2024-ISRO-Rover/ISRO Total File/ISRO Robotics Challenge/ML Images/20_40Craters.v2i.yolov8/test/images/frame_141_jpg.rf.2e57f48295c383898355d6f943adfed7.jpg

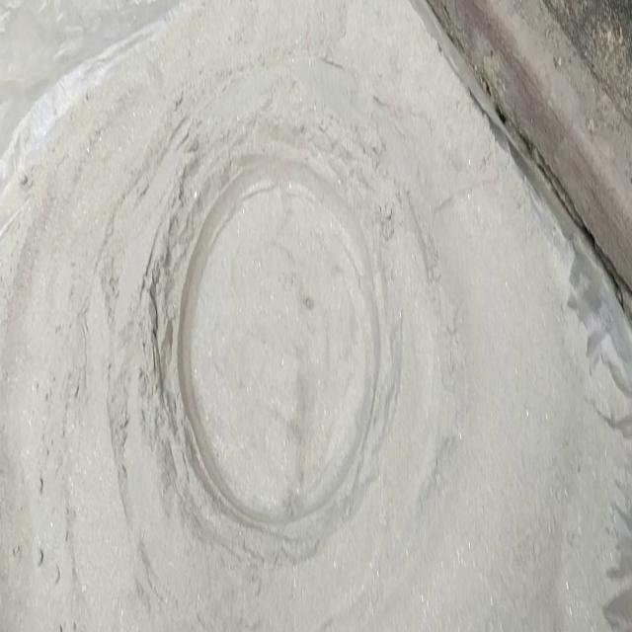
ISRO Total File/ISRO Robotics Challenge/ML Images/20_40Craters.v2i.yolov8/test/images/frame_141_jpg.rf.2e57f48295c383898355d6f943adfed7.jpg
