samim-robotix/IRoCU-2024-ISRO-Rover/ISRO Total File/ISRO Robotics Challenge/ML Images/20_40Craters.v2i.yolov8/test/images/frame_143_jpg.rf.58f2c4dd26c1284eab6d9444ac5d2f70.jpg

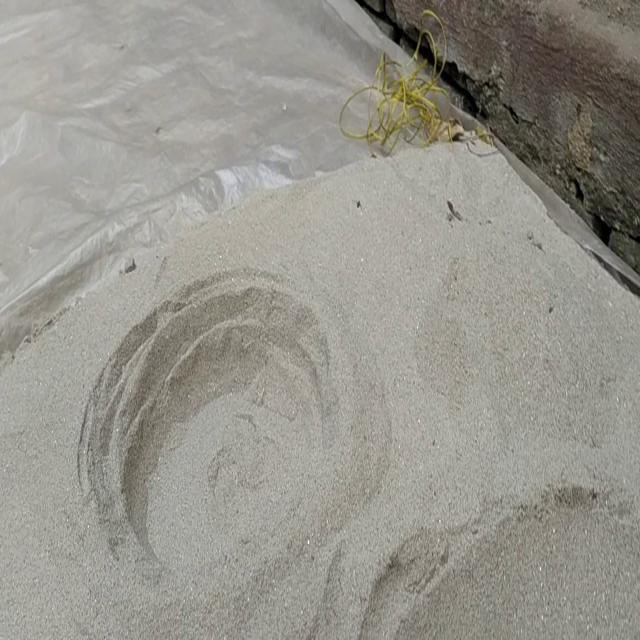
ISRO Total File/ISRO Robotics Challenge/ML Images/20_40Craters.v2i.yolov8/test/images/frame_143_jpg.rf.58f2c4dd26c1284eab6d9444ac5d2f70.jpg
