samim-robotix/IRoCU-2024-ISRO-Rover/ISRO Total File/ISRO Robotics Challenge/ML Images/20_40Craters.v2i.yolov8/test/images/frame_152_jpg.rf.6906b5dff600020bf15363af3c7ba9ac.jpg

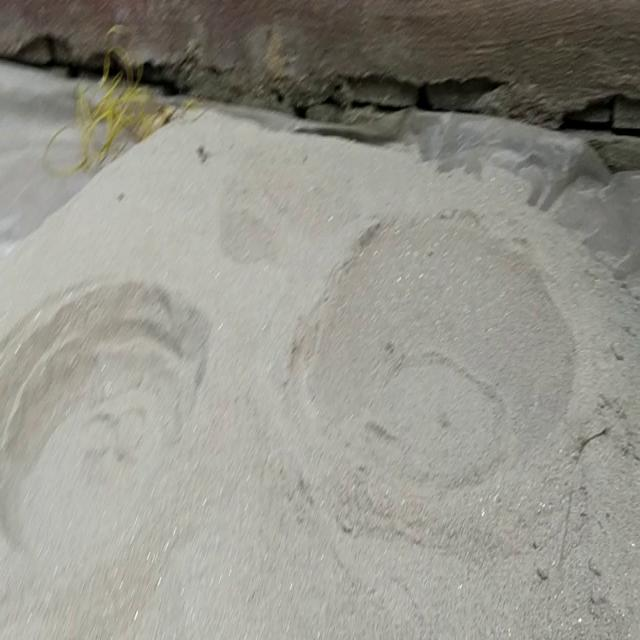
ISRO Total File/ISRO Robotics Challenge/ML Images/20_40Craters.v2i.yolov8/test/images/frame_152_jpg.rf.6906b5dff600020bf15363af3c7ba9ac.jpg
