samim-robotix/IRoCU-2024-ISRO-Rover/ISRO Total File/ISRO Robotics Challenge/ML Images/20_40Craters.v2i.yolov8/test/images/frame_186_jpg.rf.93d640fed569e09094dfc438da19cdce.jpg

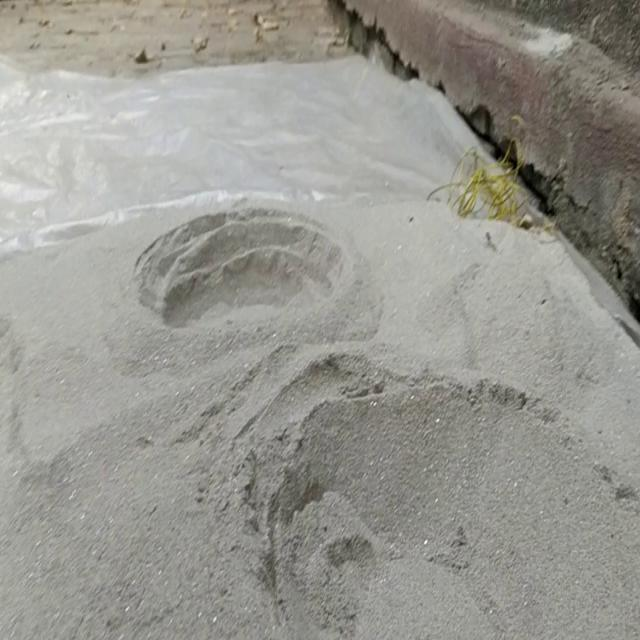
ISRO Total File/ISRO Robotics Challenge/ML Images/20_40Craters.v2i.yolov8/test/images/frame_186_jpg.rf.93d640fed569e09094dfc438da19cdce.jpg
