samim-robotix/IRoCU-2024-ISRO-Rover/ISRO Total File/ISRO Robotics Challenge/ML Images/20_40Craters.v2i.yolov8/test/images/IMG_20240413_163526_jpg.rf.ace45fbd170fca8678507b4f5a2f841f.jpg

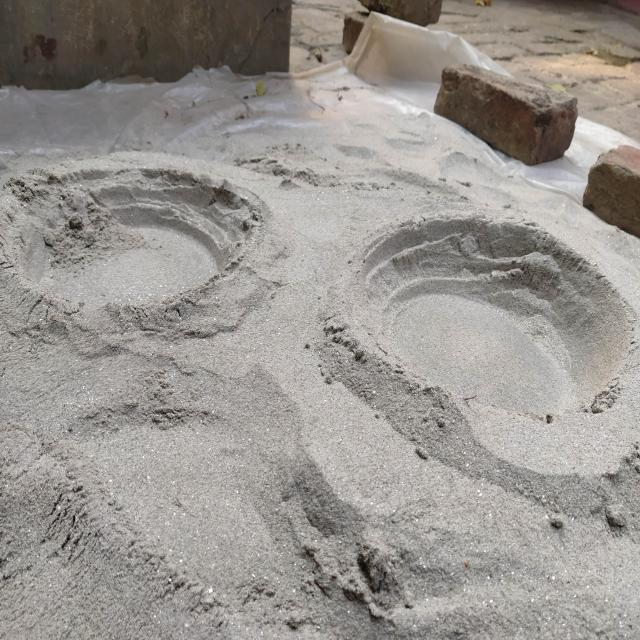
ISRO Total File/ISRO Robotics Challenge/ML Images/20_40Craters.v2i.yolov8/test/images/IMG_20240413_163526_jpg.rf.ace45fbd170fca8678507b4f5a2f841f.jpg
