samim-robotix/IRoCU-2024-ISRO-Rover/ISRO Total File/ISRO Robotics Challenge/ML Images/20_40Craters.v2i.yolov8/test/images/IMG_20240413_164110_jpg.rf.c16440bdf941206ebdf3ee72746d2aac.jpg

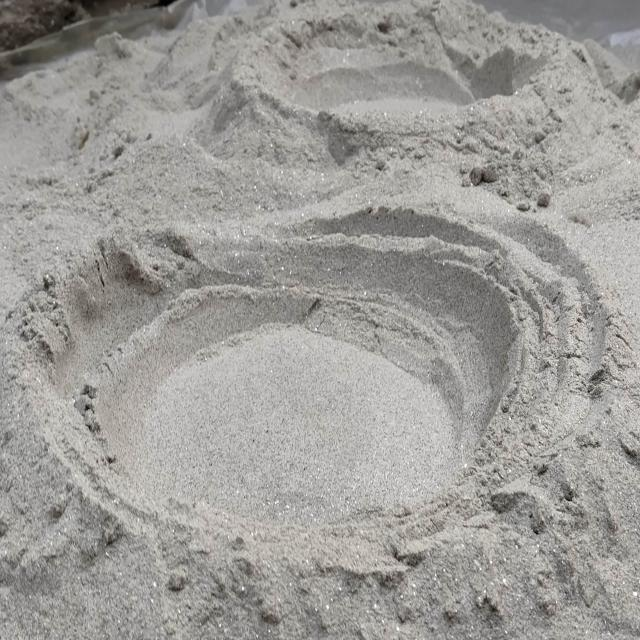
ISRO Total File/ISRO Robotics Challenge/ML Images/20_40Craters.v2i.yolov8/test/images/IMG_20240413_164110_jpg.rf.c16440bdf941206ebdf3ee72746d2aac.jpg
