samim-robotix/IRoCU-2024-ISRO-Rover/ISRO Total File/ISRO Robotics Challenge/ML Images/20_40Craters.v2i.yolov8/test/images/IMG_20240413_164126_jpg.rf.87b6080664fab927dd7583ba961cfeae.jpg

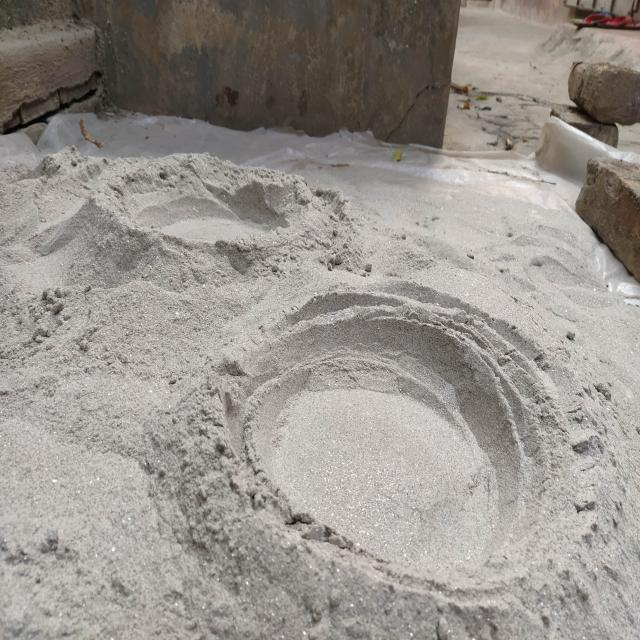
ISRO Total File/ISRO Robotics Challenge/ML Images/20_40Craters.v2i.yolov8/test/images/IMG_20240413_164126_jpg.rf.87b6080664fab927dd7583ba961cfeae.jpg
