samim-robotix/IRoCU-2024-ISRO-Rover/ISRO Total File/ISRO Robotics Challenge/ML Images/20_40Craters.v2i.yolov8/test/images/IMG_20240413_164144_jpg.rf.7c623f2cfa84bed8bff07b6d5a23a31a.jpg

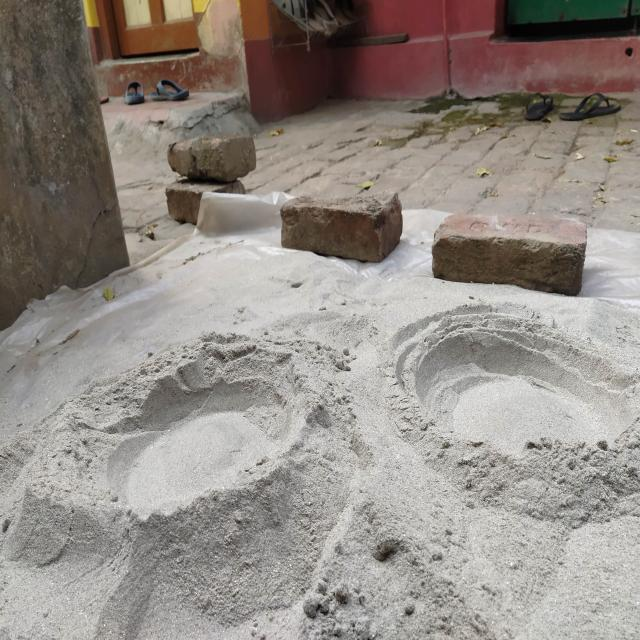
ISRO Total File/ISRO Robotics Challenge/ML Images/20_40Craters.v2i.yolov8/test/images/IMG_20240413_164144_jpg.rf.7c623f2cfa84bed8bff07b6d5a23a31a.jpg
