samim-robotix/IRoCU-2024-ISRO-Rover/ISRO Total File/ISRO Robotics Challenge/ML Images/20_40Craters.v2i.yolov8/test/images/IMG_20240413_164402_jpg.rf.959c3d1ebb2bf252b6f2039517873e77.jpg

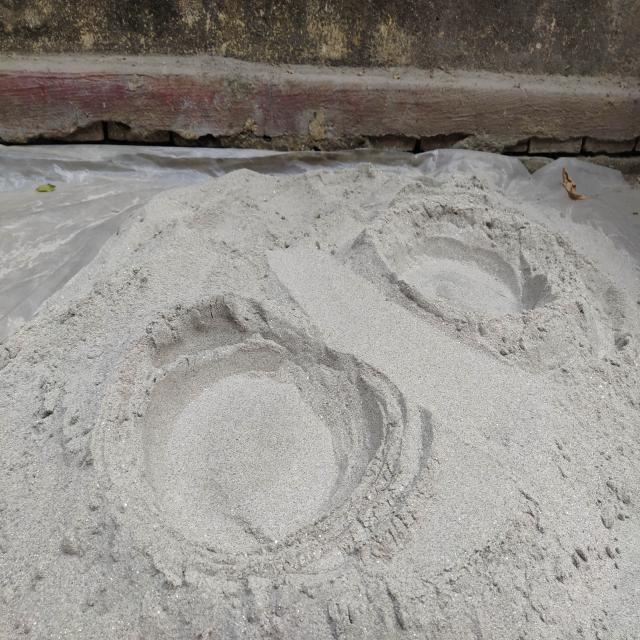
ISRO Total File/ISRO Robotics Challenge/ML Images/20_40Craters.v2i.yolov8/test/images/IMG_20240413_164402_jpg.rf.959c3d1ebb2bf252b6f2039517873e77.jpg
