samim-robotix/IRoCU-2024-ISRO-Rover/ISRO Total File/ISRO Robotics Challenge/ML Images/20_40Craters.v2i.yolov8/test/images/IMG_20240413_164617_jpg.rf.4256778d696a6e491b49ccfb37d2b015.jpg

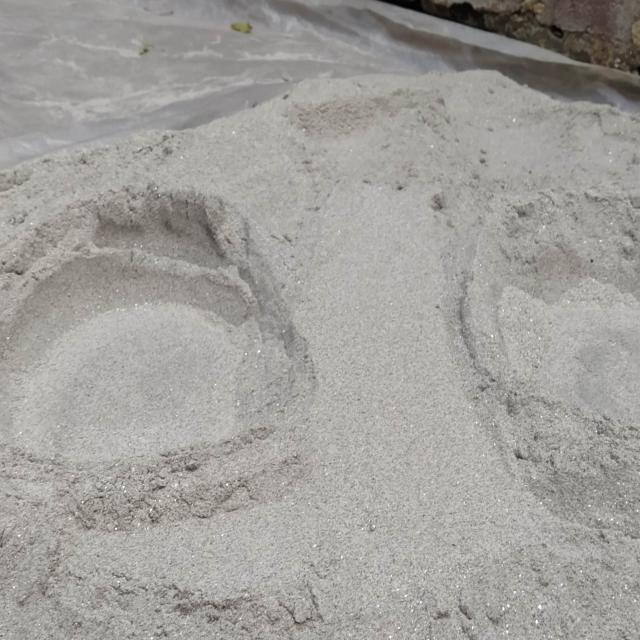
ISRO Total File/ISRO Robotics Challenge/ML Images/20_40Craters.v2i.yolov8/test/images/IMG_20240413_164617_jpg.rf.4256778d696a6e491b49ccfb37d2b015.jpg
