samim-robotix/IRoCU-2024-ISRO-Rover/ISRO Total File/ISRO Robotics Challenge/ML Images/20_40Craters.v2i.yolov8/test/images/IMG_20240413_165044_jpg.rf.b4ed8a2ee0cfc920df162cfc85b98e81.jpg

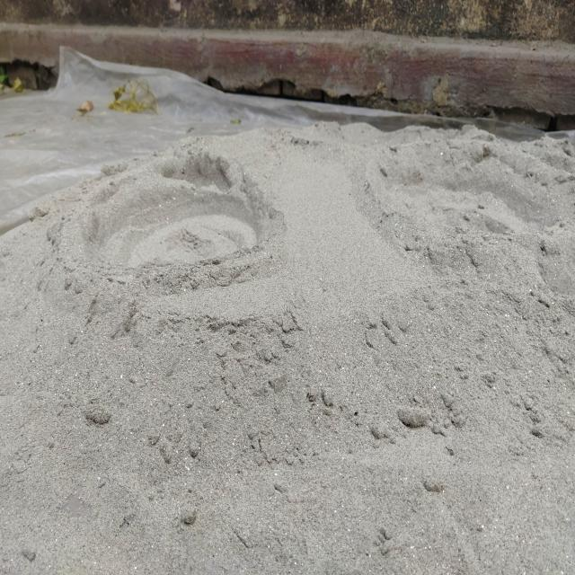
ISRO Total File/ISRO Robotics Challenge/ML Images/20_40Craters.v2i.yolov8/test/images/IMG_20240413_165044_jpg.rf.b4ed8a2ee0cfc920df162cfc85b98e81.jpg
