samim-robotix/IRoCU-2024-ISRO-Rover/ISRO Total File/ISRO Robotics Challenge/ML Images/20_40Craters.v2i.yolov8/test/images/IMG_20240413_165045_jpg.rf.45357a6a2a815512b2af4d006fdb6f90.jpg

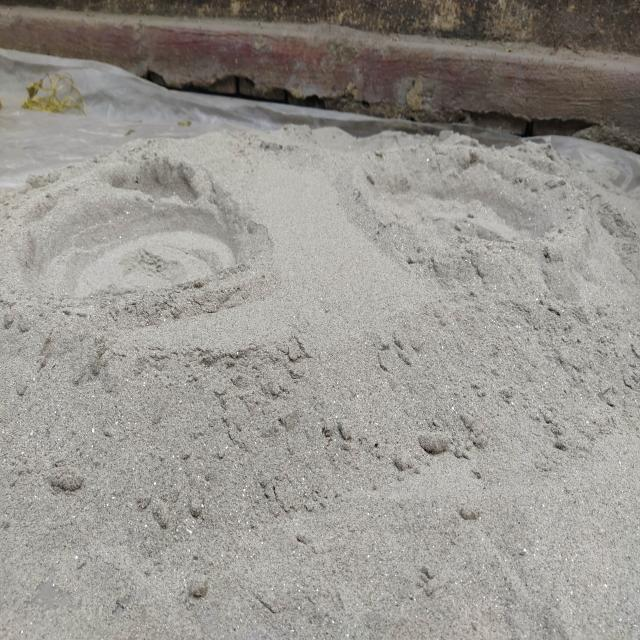
ISRO Total File/ISRO Robotics Challenge/ML Images/20_40Craters.v2i.yolov8/test/images/IMG_20240413_165045_jpg.rf.45357a6a2a815512b2af4d006fdb6f90.jpg
