samim-robotix/IRoCU-2024-ISRO-Rover/ISRO Total File/ISRO Robotics Challenge/ML Images/20_40Craters.v2i.yolov8/test/images/IMG_20240413_165059_jpg.rf.cd2e3534a89107446f36d41c433b53f6.jpg

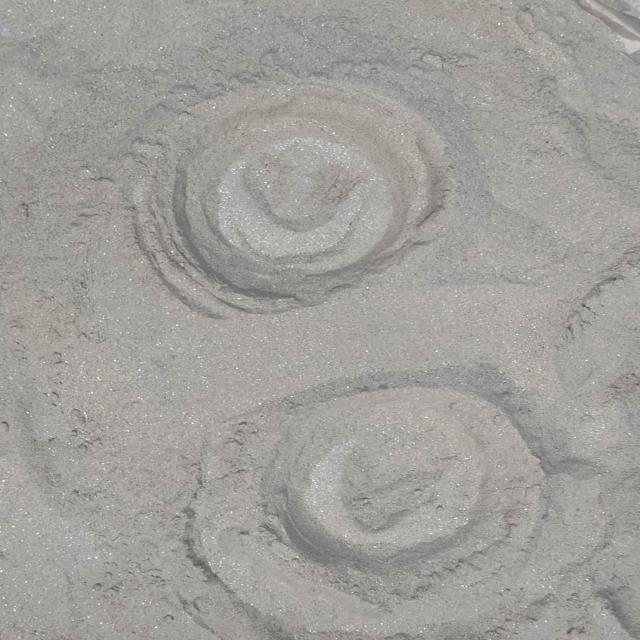
ISRO Total File/ISRO Robotics Challenge/ML Images/20_40Craters.v2i.yolov8/test/images/IMG_20240413_165059_jpg.rf.cd2e3534a89107446f36d41c433b53f6.jpg
