samim-robotix/IRoCU-2024-ISRO-Rover/ISRO Total File/ISRO Robotics Challenge/ML Images/20_40Craters.v2i.yolov8/test/images/IMG_20240413_165117_jpg.rf.2dfe6e1ce7dd46bec0cbee9a0260eca8.jpg

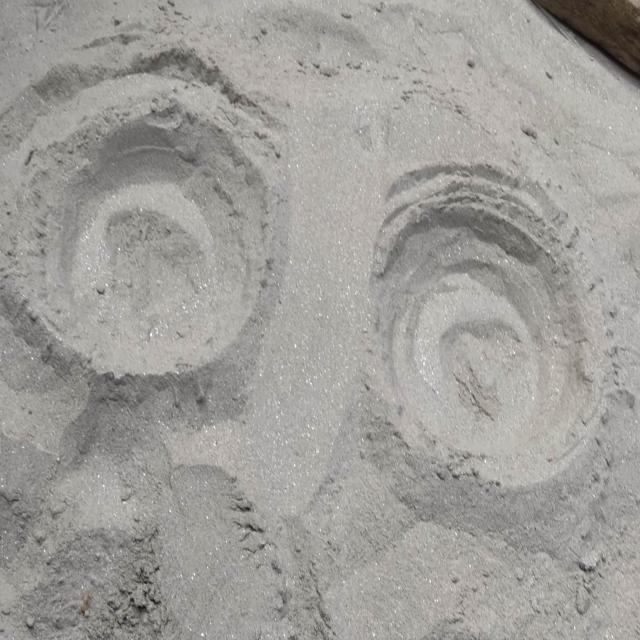
ISRO Total File/ISRO Robotics Challenge/ML Images/20_40Craters.v2i.yolov8/test/images/IMG_20240413_165117_jpg.rf.2dfe6e1ce7dd46bec0cbee9a0260eca8.jpg
