samim-robotix/IRoCU-2024-ISRO-Rover/ISRO Total File/ISRO Robotics Challenge/ML Images/20_40Craters.v2i.yolov8/test/images/IMG_20240413_170551_jpg.rf.2efc5371519ea5bc4ac7bc47d672fb5c.jpg

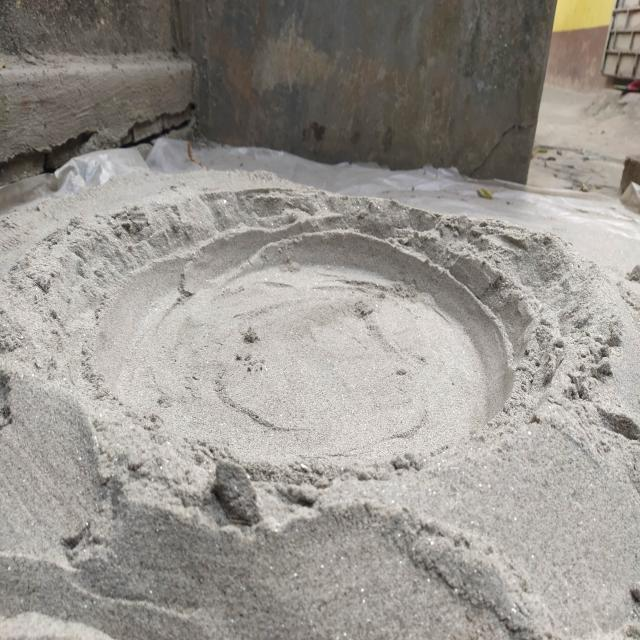
ISRO Total File/ISRO Robotics Challenge/ML Images/20_40Craters.v2i.yolov8/test/images/IMG_20240413_170551_jpg.rf.2efc5371519ea5bc4ac7bc47d672fb5c.jpg
