samim-robotix/IRoCU-2024-ISRO-Rover/ISRO Total File/ISRO Robotics Challenge/ML Images/20_40Craters.v2i.yolov8/test/images/IMG_20240413_170559_jpg.rf.9e8fbc1cdf5f6ac91179067fc773c16e.jpg

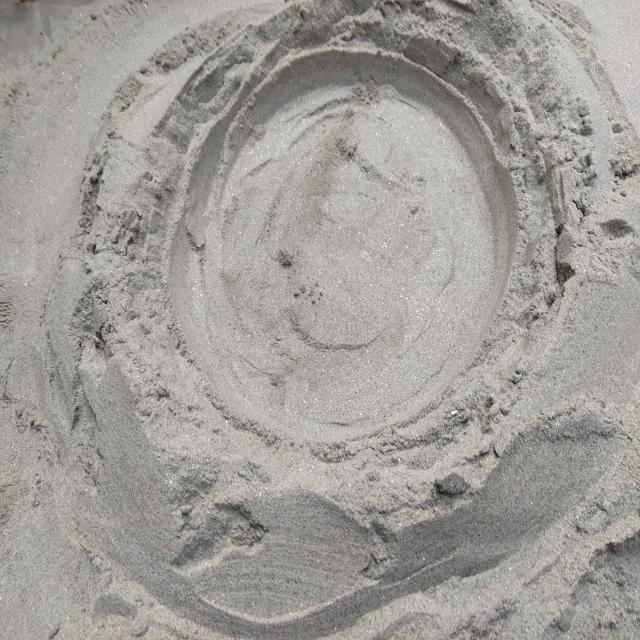
ISRO Total File/ISRO Robotics Challenge/ML Images/20_40Craters.v2i.yolov8/test/images/IMG_20240413_170559_jpg.rf.9e8fbc1cdf5f6ac91179067fc773c16e.jpg
