samim-robotix/IRoCU-2024-ISRO-Rover/ISRO Total File/ISRO Robotics Challenge/ML Images/20_40Craters.v2i.yolov8/test/images/IMG_20240413_170734_jpg.rf.1c1eb39b9d2ae80971d60504435c86bb.jpg

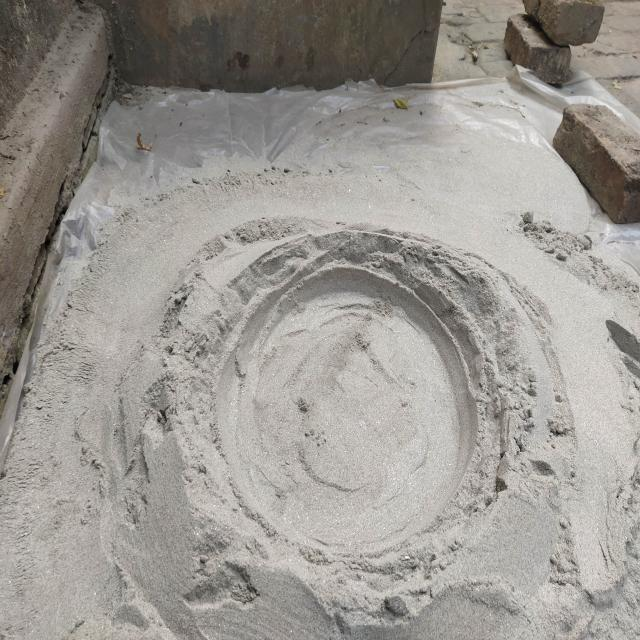
ISRO Total File/ISRO Robotics Challenge/ML Images/20_40Craters.v2i.yolov8/test/images/IMG_20240413_170734_jpg.rf.1c1eb39b9d2ae80971d60504435c86bb.jpg
