samim-robotix/IRoCU-2024-ISRO-Rover/ISRO Total File/ISRO Robotics Challenge/ML Images/20_40Craters.v2i.yolov8/test/images/IMG_20240413_171845_jpg.rf.7c1adf80e87aa4feb805f7e94dde33b3.jpg

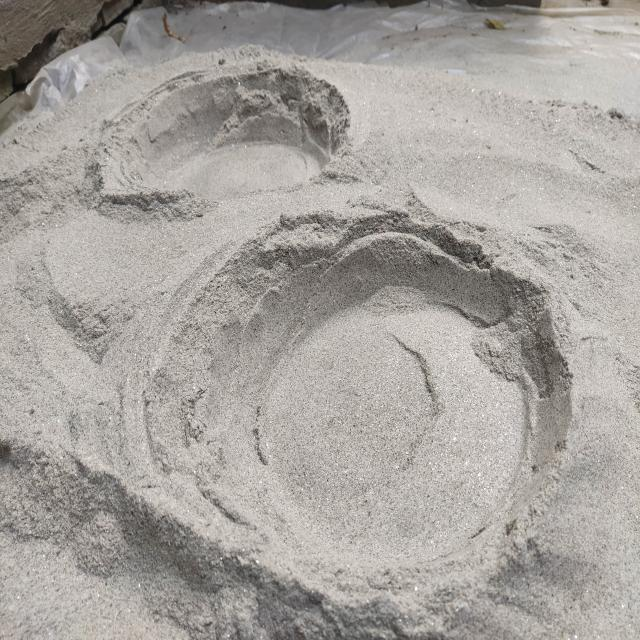
ISRO Total File/ISRO Robotics Challenge/ML Images/20_40Craters.v2i.yolov8/test/images/IMG_20240413_171845_jpg.rf.7c1adf80e87aa4feb805f7e94dde33b3.jpg
