samim-robotix/IRoCU-2024-ISRO-Rover/ISRO Total File/ISRO Robotics Challenge/ML Images/20_40Craters.v2i.yolov8/test/images/IMG_20240413_171905_jpg.rf.346b66d7bff8921a2958268aef548ea1.jpg

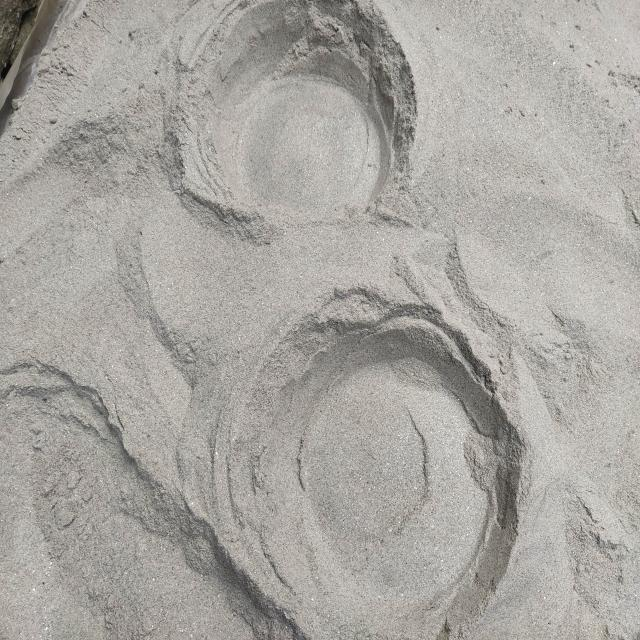
ISRO Total File/ISRO Robotics Challenge/ML Images/20_40Craters.v2i.yolov8/test/images/IMG_20240413_171905_jpg.rf.346b66d7bff8921a2958268aef548ea1.jpg
