samim-robotix/IRoCU-2024-ISRO-Rover/ISRO Total File/ISRO Robotics Challenge/ML Images/20_40Craters.v2i.yolov8/test/images/IMG_20240413_171911_jpg.rf.bc90cd498ee308701e8e7ac8fa2138c9.jpg

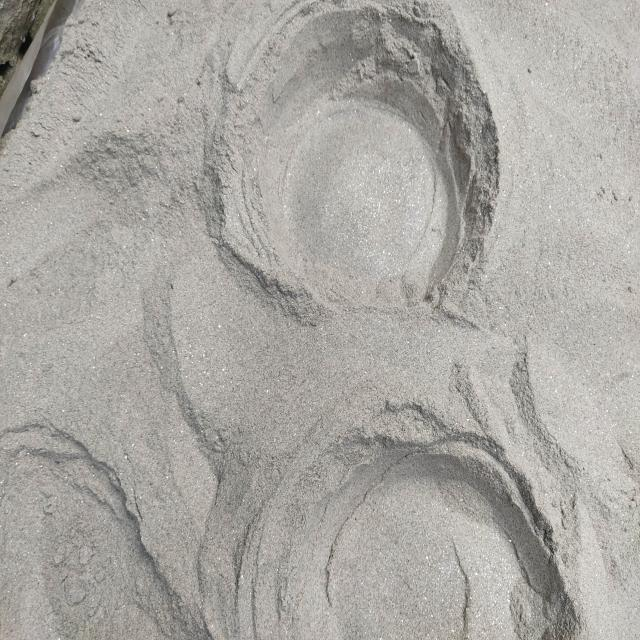
ISRO Total File/ISRO Robotics Challenge/ML Images/20_40Craters.v2i.yolov8/test/images/IMG_20240413_171911_jpg.rf.bc90cd498ee308701e8e7ac8fa2138c9.jpg
