samim-robotix/IRoCU-2024-ISRO-Rover/ISRO Total File/ISRO Robotics Challenge/ML Images/20_40Craters.v2i.yolov8/test/images/IMG_20240414_170507_jpg.rf.cf6ad9f71b62e792b6da6c0f7809b192.jpg

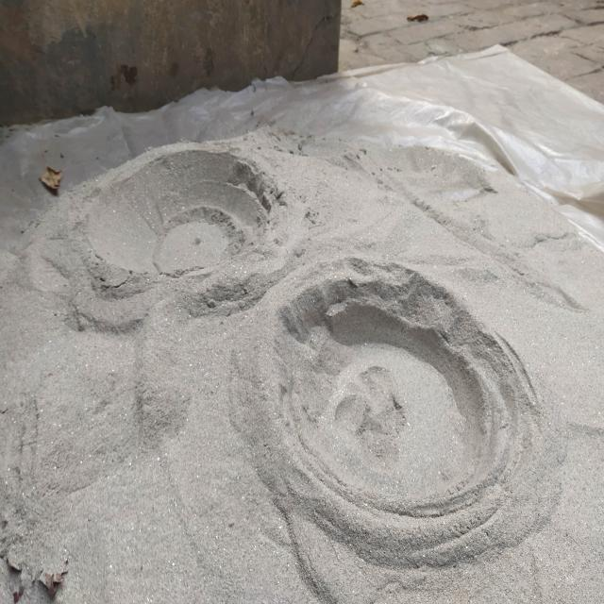
ISRO Total File/ISRO Robotics Challenge/ML Images/20_40Craters.v2i.yolov8/test/images/IMG_20240414_170507_jpg.rf.cf6ad9f71b62e792b6da6c0f7809b192.jpg
