samim-robotix/IRoCU-2024-ISRO-Rover/ISRO Total File/ISRO Robotics Challenge/ML Images/Final Model/test2.jpg

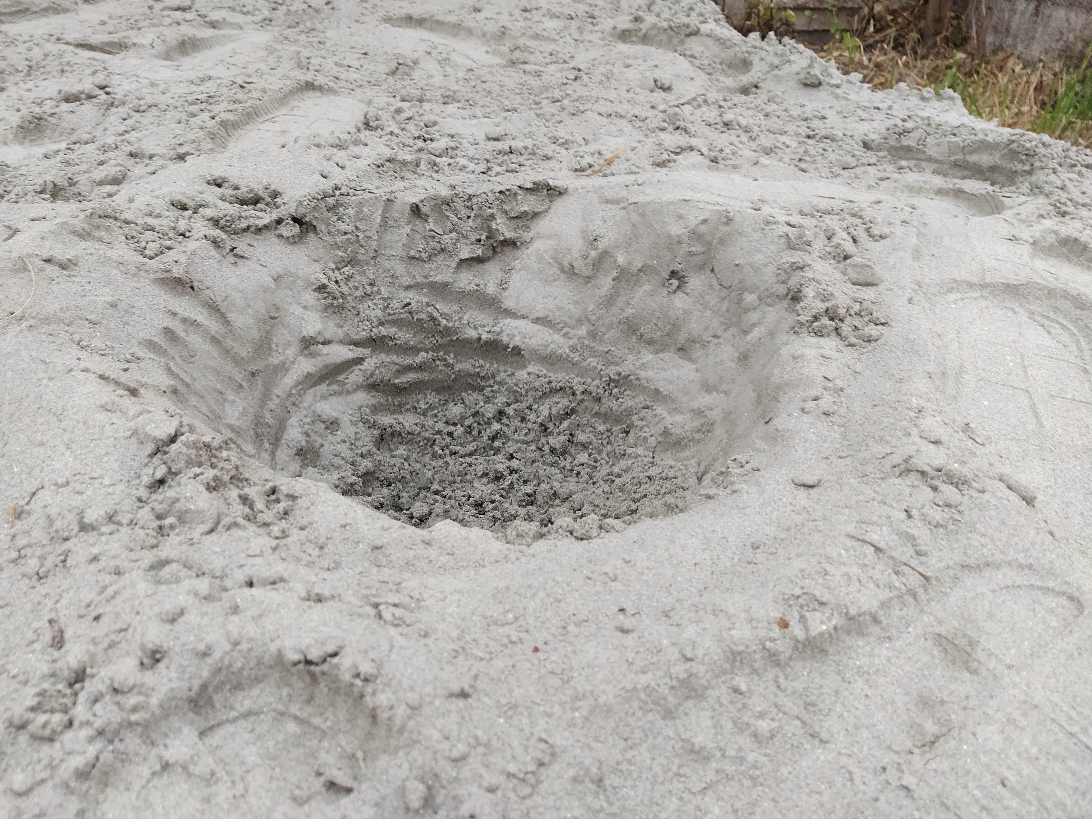
ISRO Total File/ISRO Robotics Challenge/ML Images/Final Model/test2.jpg
