samim-robotix/IRoCU-2024-ISRO-Rover/ISRO Total File/ISRO Robotics Challenge/ML Images/yolov8/validate.jpg

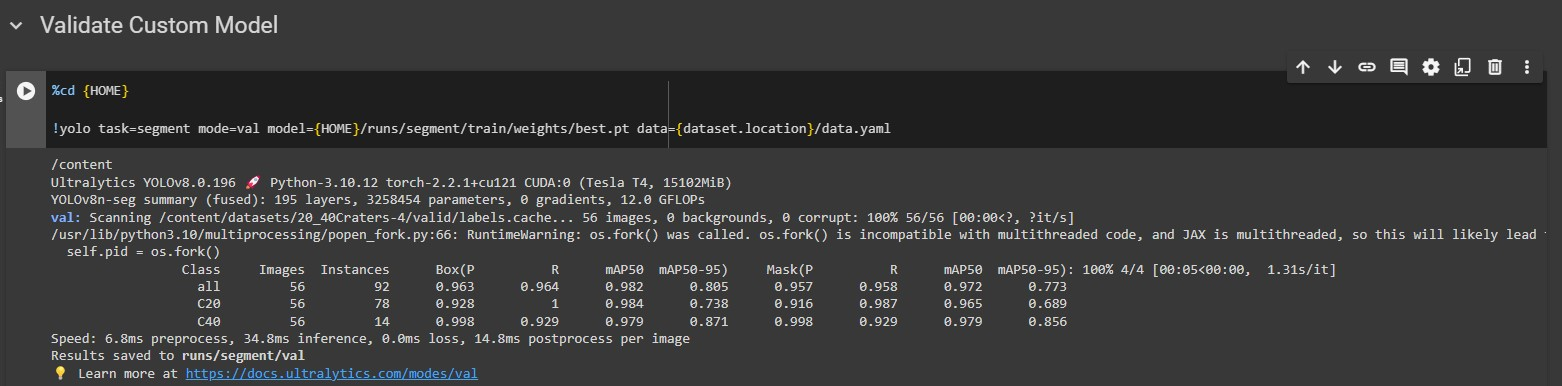
ISRO Total File/ISRO Robotics Challenge/ML Images/yolov8/validate.jpg
