samim-robotix/IRoCU-2024-ISRO-Rover/ISRO/testing img/2.jpeg

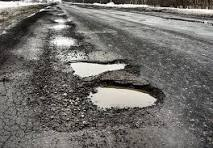
ISRO/testing img/2.jpeg
