samim-robotix/IRoCU-2024-ISRO-Rover/ISRO/testing img/IMG-20240415-WA0030.jpg

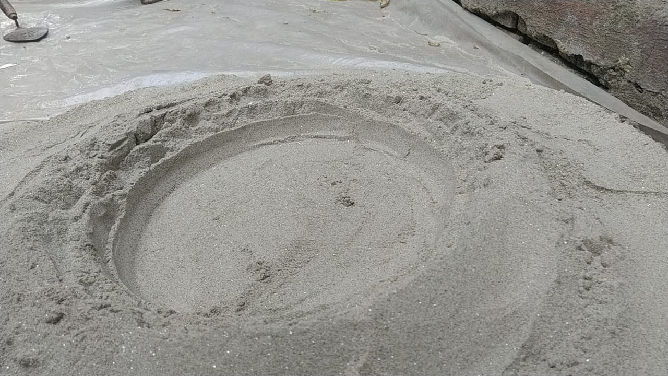
ISRO/testing img/IMG-20240415-WA0030.jpg
