samim-robotix/IRoCU-2024-ISRO-Rover/ISRO/testing img/test1.jpeg

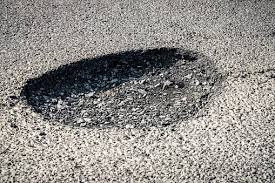
ISRO/testing img/test1.jpeg
