samim-robotix/IRoCU-2024-ISRO-Rover/ISRO Total File/OBS_Chassis/rover assem chassis.pdf

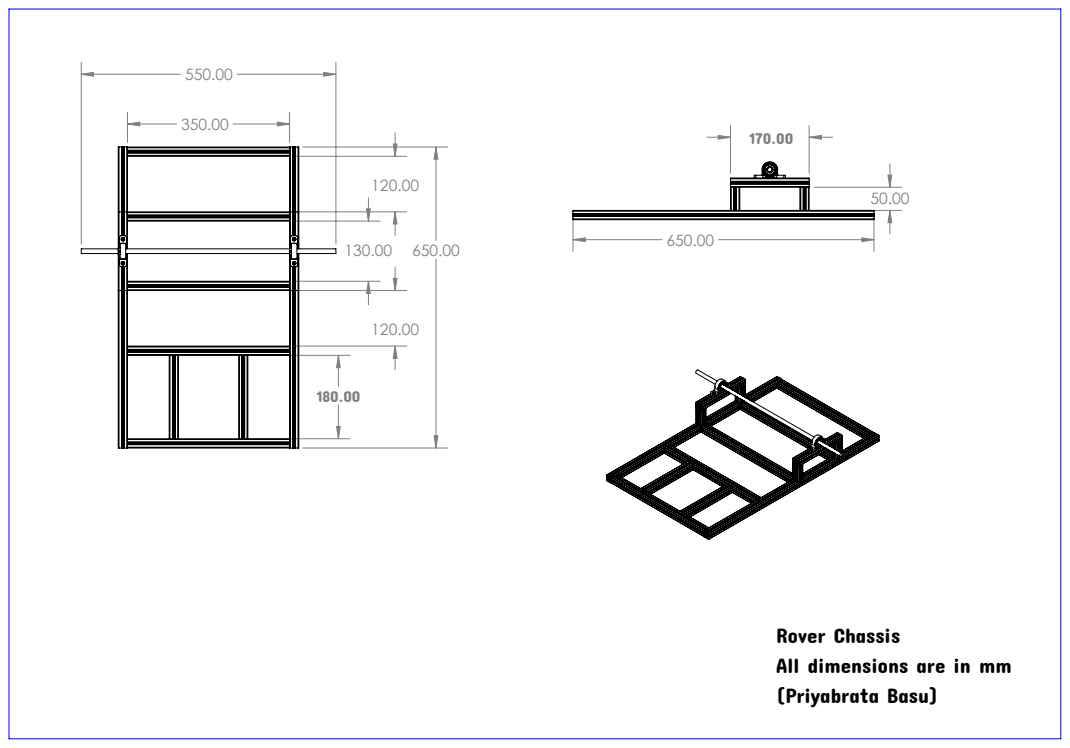
[picture p449: page 1]

Rover Chassis
All dimensions are in mm
(Priyabrata Basu)
