samim-robotix/IRoCU-2024-ISRO-Rover/ISRO Total File/ISRO Robotics Challenge/obseract/arm_inv_kine.ipynb - Colab.pdf

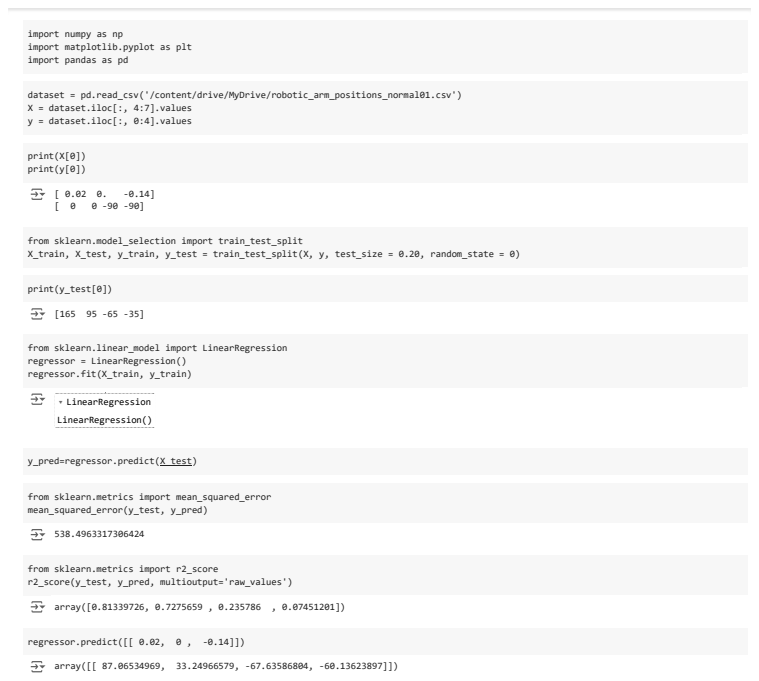
[picture p451: page 1]
print(X[0]) print(y[0]); print(y_test[0]); y_pred=regressor.predict(X_test); array([0.81339726, 0.7275659 , 0.235786 , 0.07451201]); regressor.predict([[ 0.02, 0 , -0.14]]); array([[ 87.06534969, 33.24966579, -67.63586804, -60.13623897]])

import numpy as np
import matplotlib.pyplot as plt
import pandas as pd

dataset = pd.read_csv('/content/drive/MyDrive/robotic_arm_positions_normal01.csv')
X = dataset.iloc[:, 4:7].values
y = dataset.iloc[:, 0:4].values

from sklearn.model_selection import train_test_split
X_train, X_test, y_train, y_test = train_test_split(X, y, test_size = 0.20, random_state = 0)

from sklearn.linear_model import LinearRegression
regressor = LinearRegression()
regressor.fit(X_train, y_train)

▾ LinearRegression
LinearRegression()

from sklearn.metrics import mean_squared_error
mean_squared_error(y_test, y_pred)

from sklearn.metrics import r2_score
r2_score(y_test, y_pred, multioutput='raw_values')
