samim-robotix/IRoCU-2024-ISRO-Rover/ISRO Total File/OBS_Chassis/rover rocker boogie assem.pdf

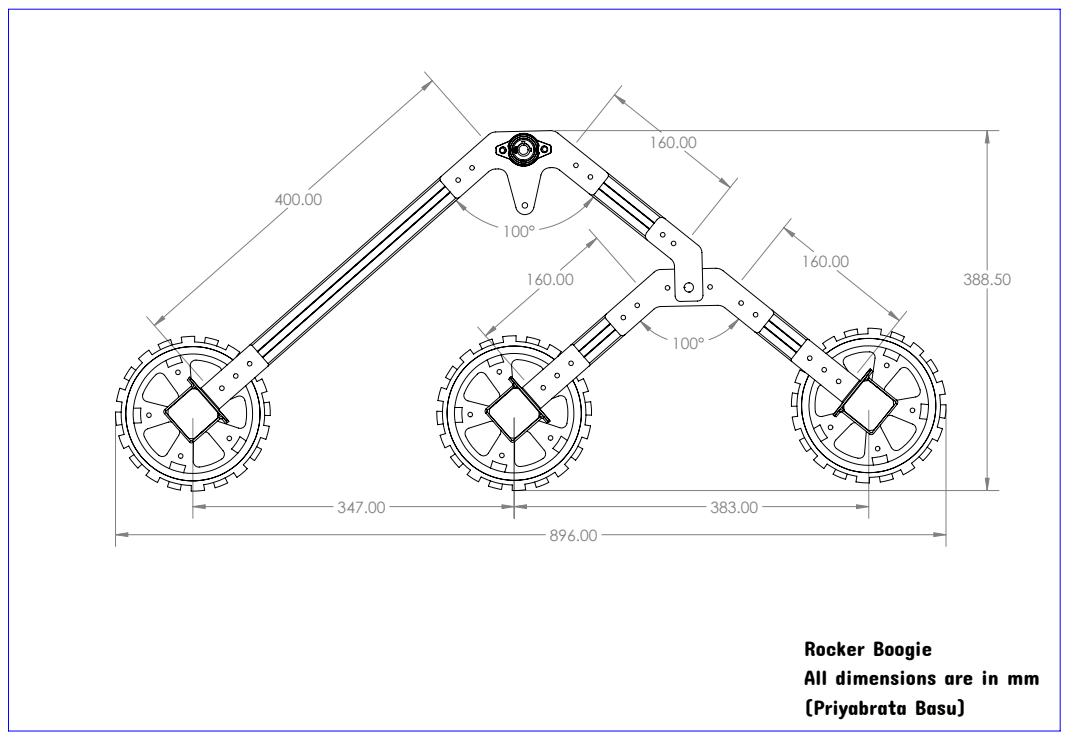
[picture p452: page 1]

Rocker Boogie
All dimensions are in mm
(Priyabrata Basu)
