samim-robotix/IRoCU-2024-ISRO-Rover/ISRO/OVERVIEW/test1.pdf

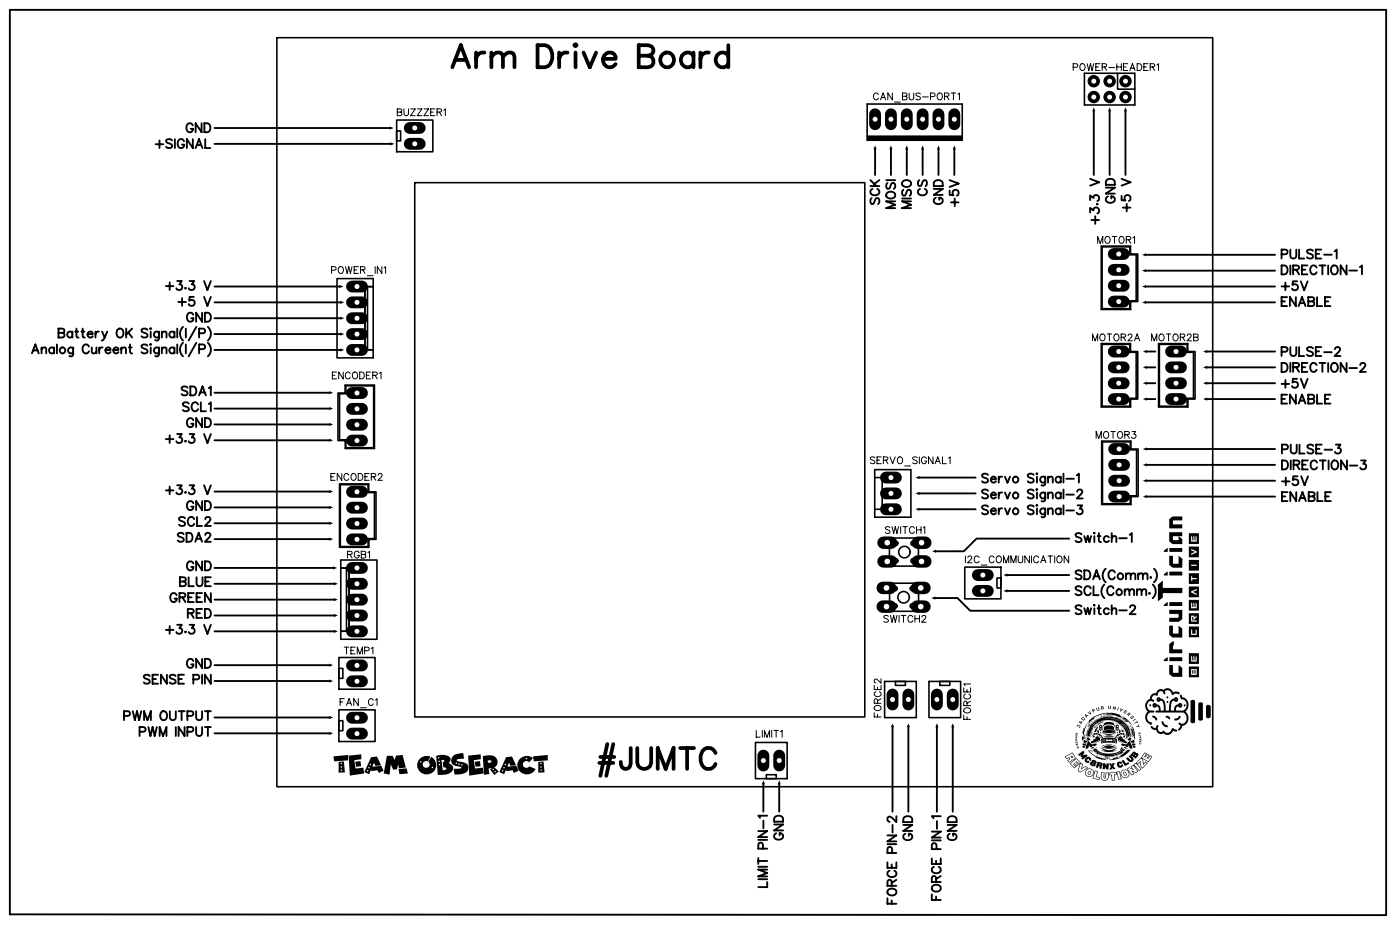
[picture p453: page 1]
