samim-robotix/IRoCU-2024-ISRO-Rover/ISRO/OVERVIEW/test2.pdf

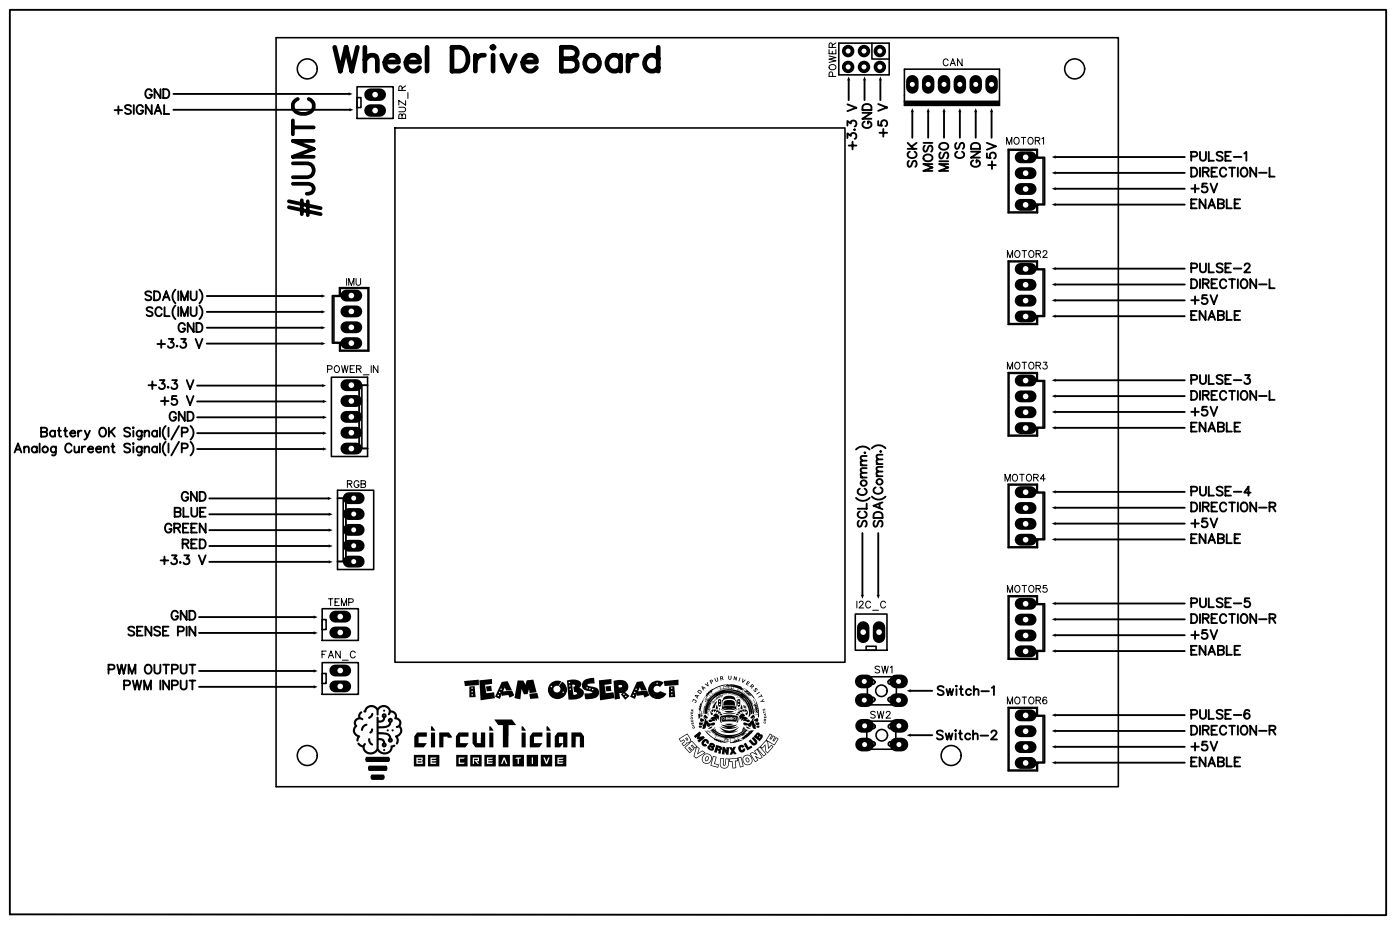
[picture p454: page 1]
