samim-robotix/IRoCU-2024-ISRO-Rover/ISRO/OVERVIEW/test3.pdf

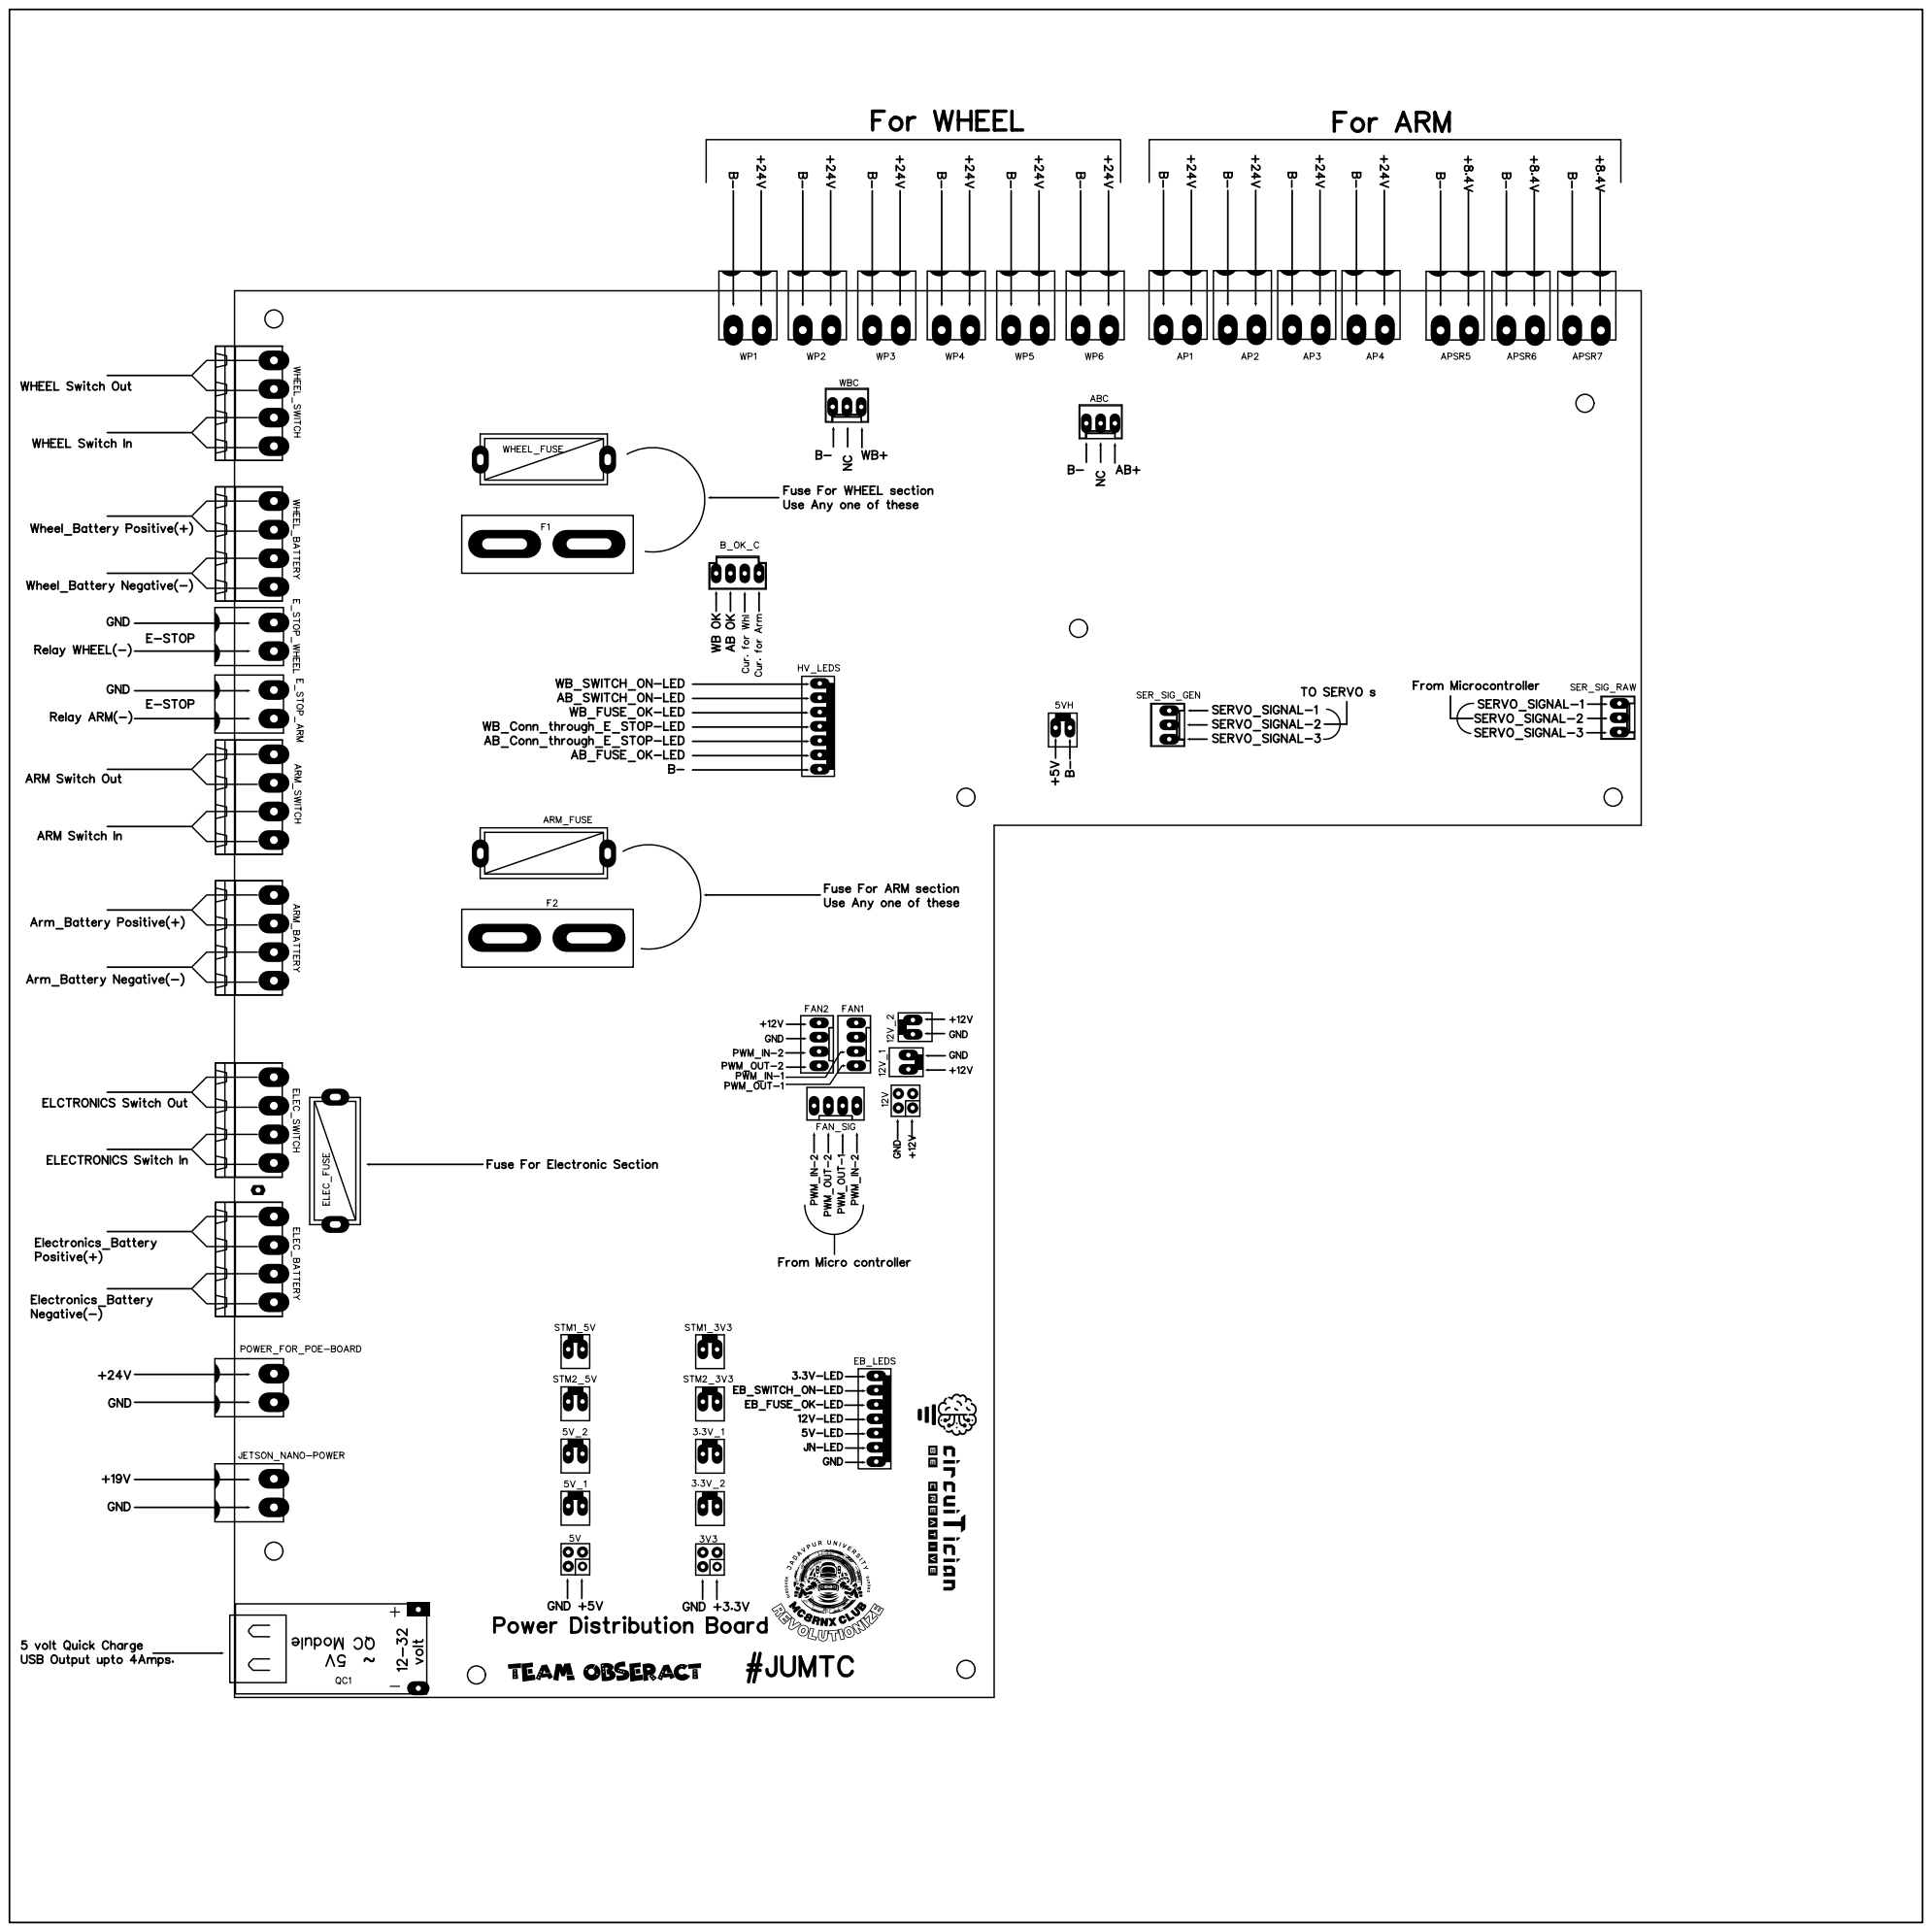
[picture p455: page 1]
