samim-robotix/IRoCU-2024-ISRO-Rover/ISRO/OVERVIEW/test4.pdf

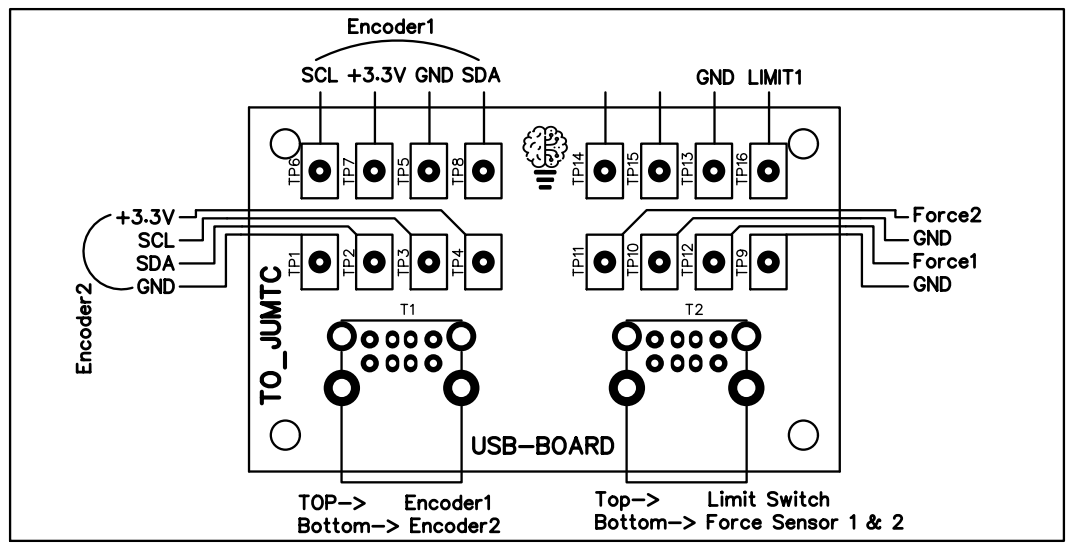
[picture p456: page 1]
