samim-robotix/IRoCU-2024-ISRO-Rover/ISRO/OVERVIEW/test5.pdf

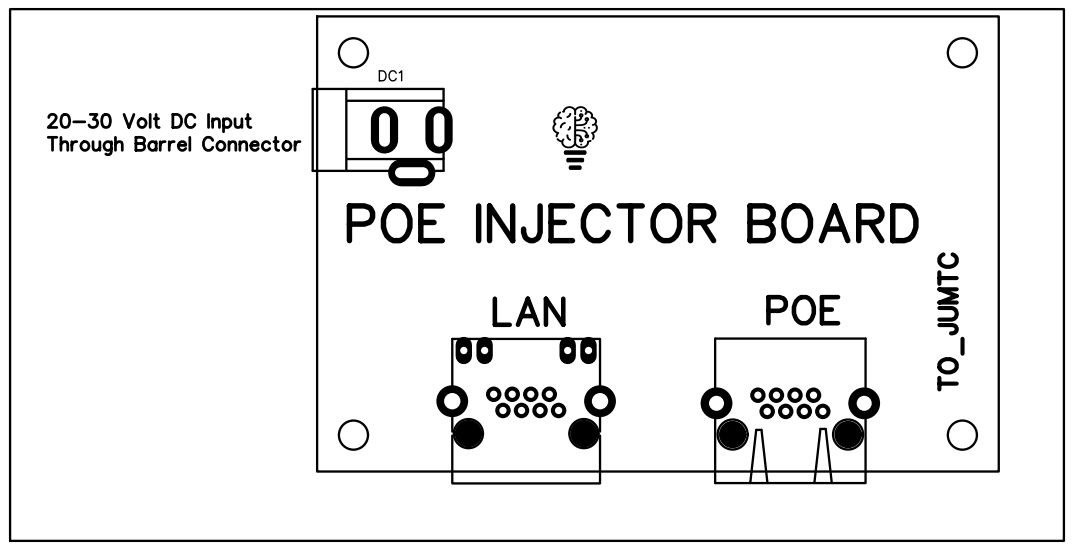
[picture p457: page 1]
