samim-robotix/IRoCU-2024-ISRO-Rover/ISRO/OVERVIEW/test6.pdf

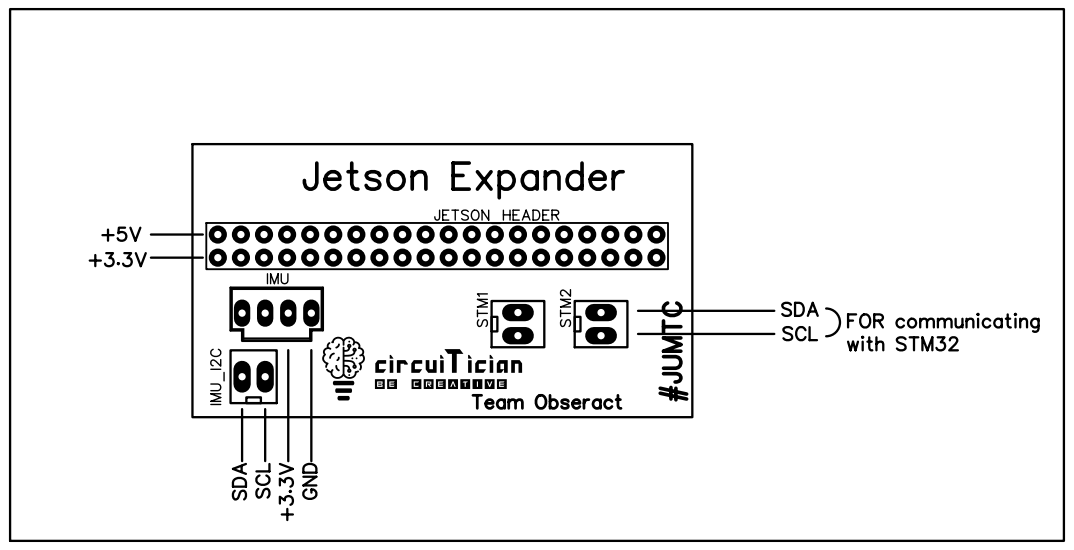
[picture p458: page 1]
