samim-robotix/IRoCU-2024-ISRO-Rover/ISRO Total File/Robotic Arm/top rot plate 1isto1.pdf

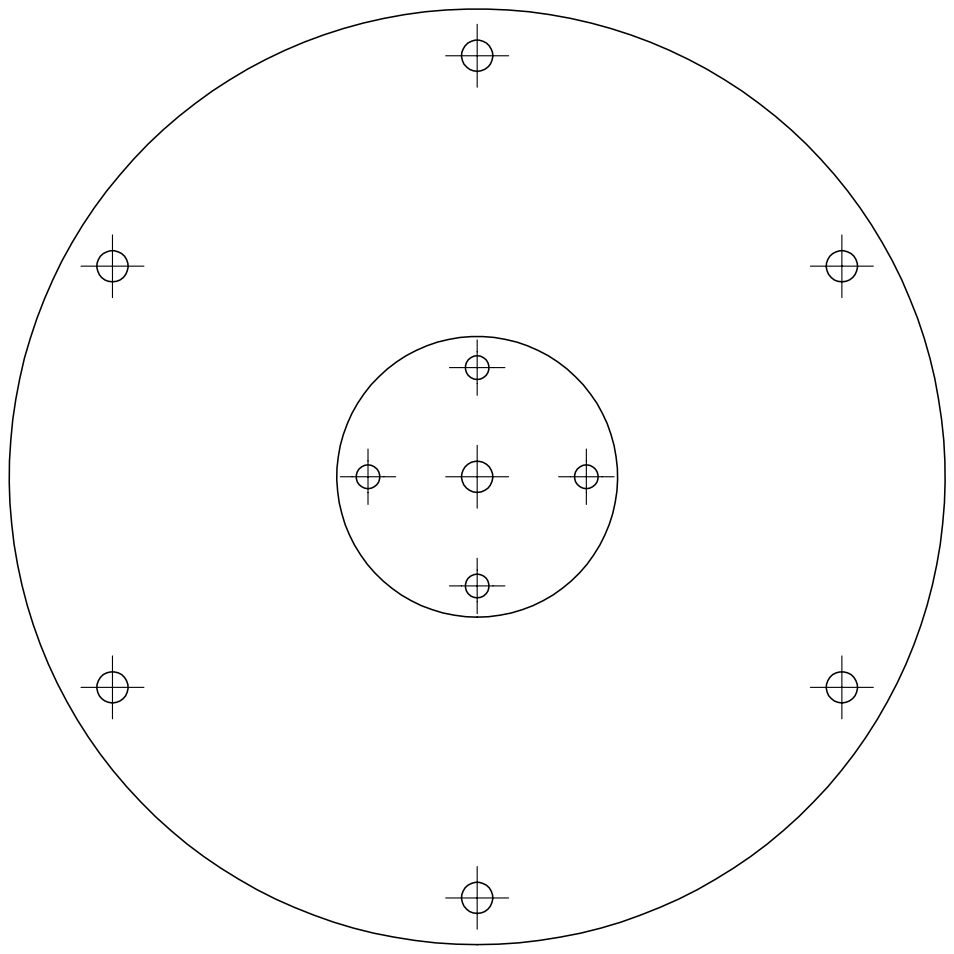
[picture p459: page 1]
