samim-robotix/IRoCU-2024-ISRO-Rover/ISRO Total File/ISRO Robotics Challenge/obseract/baggingregressor.ipynb - Colab.pdf

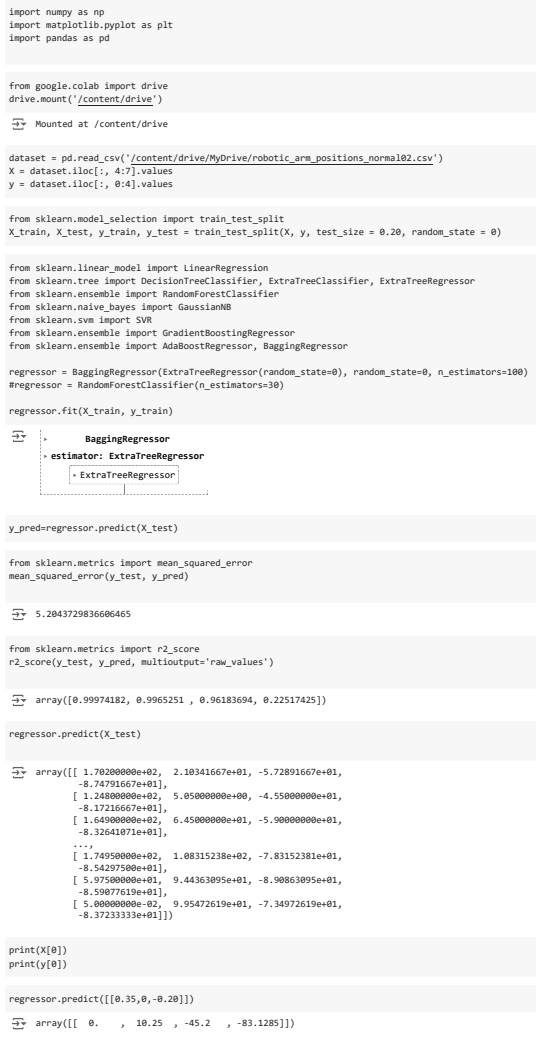
[picture p460: page 1]
regressor.fit(X_train, y_train); y_pred=regressor.predict(X_test); array([0.99974182, 0.9965251 , 0.96183694, 0.22517425]); regressor.predict(X_test)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

import numpy as np
import matplotlib.pyplot as plt
import pandas as pd

from google.colab import drive
drive.mount('/content/drive')

Mounted at /content/drive

dataset = pd.read_csv('/content/drive/MyDrive/robotic_arm_positions_normal02.csv')
X = dataset.iloc[:, 4:7].values
y = dataset.iloc[:, 0:4].values

from sklearn.model_selection import train_test_split
X_train, X_test, y_train, y_test = train_test_split(X, y, test_size = 0.20, random_state = 0)

from sklearn.linear_model import LinearRegression
from sklearn.tree import DecisionTreeClassifier, ExtraTreeClassifier, ExtraTreeRegressor
from sklearn.ensemble import RandomForestClassifier
from sklearn.naive_bayes import GaussianNB
from sklearn.svm import SVR
from sklearn.ensemble import GradientBoostingRegressor
from sklearn.ensemble import AdaBoostRegressor, BaggingRegressor

regressor = BaggingRegressor(ExtraTreeRegressor(random_state=0), random_state=0, n_estimators=100)
#regressor = RandomForestClassifier(n_estimators=30)

▸ BaggingRegressor
▸ estimator: ExtraTreeRegressor
▸ ExtraTreeRegressor

from sklearn.metrics import mean_squared_error
mean_squared_error(y_test, y_pred)

from sklearn.metrics import r2_score
r2_score(y_test, y_pred, multioutput='raw_values')

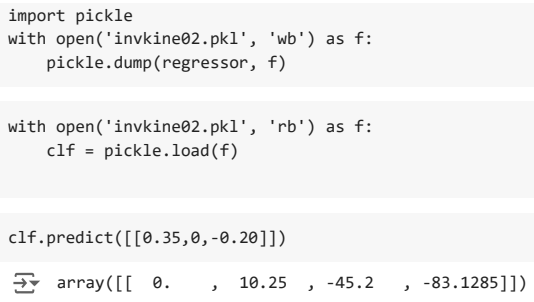
[picture p461: figure]
import pickle with open('invkine02.pkl', 'wb') as f: pickle.dump(regressor, f); with open('invkine02.pkl', 'rb') as f: clf = pickle.load(f); clf.predict([[0.35,0,-0.20]]); array([[ 0.
