samim-robotix/IRoCU-2024-ISRO-Rover/ISRO Total File/ISRO Robotics Challenge/obseract/STM32_CAN_COM/TUT_CAN_F103/TUT_CAN_F103.ioc

Mcu.UserName=STM32F103C8Tx
PC13-TAMPER-RTC.Signal=GPIO_Output
PD0-OSC_IN.Signal=RCC_OSC_IN
PD1-OSC_OUT.Signal=RCC_OSC_OUT
PA13.Signal=SYS_JTMS-SWDIO
PA12.Signal=CAN_TX
PA11.Signal=CAN_RX
PA14.Signal=SYS_JTCK-SWCLK
