samim-robotix/IRoCU-2024-ISRO-Rover/ISRO Total File/ISRO Robotics Challenge/obseract/STM32_CAN_COM/TUT_CAN_F103/Core/Src/main.c

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
/* Includes ------------------------------------------------------------------*/
#include "main.h"

CAN_HandleTypeDef hcan;

void SystemClock_Config(void);
static void MX_GPIO_Init(void);
static void MX_CAN_Init(void);
/* USER CODE BEGIN 0 */

CAN_TxHeaderTypeDef TxHeader;
CAN_RxHeaderTypeDef RxHeader;

uint8_t TxData[8];
uint8_t RxData[8];

uint32_t TxMailbox;

int datacheck = 0;


void HAL_CAN_RxFifo1MsgPendingCallback(CAN_HandleTypeDef *hcan)
{
	HAL_CAN_GetRxMessage(hcan, CAN_RX_FIFO1, &RxHeader, RxData);
	if (RxHeader.DLC == 2)
	{
		datacheck = 1;
	}
}

/* USER CODE END 0 */

/**
  * @brief  The application entry point.
  * @retval int
  */
int main(void)
{
  /* MCU Configuration--------------------------------------------------------*/

  /* Reset of all peripherals, Initializes the Flash interface and the Systick. */
  HAL_Init();

  /* Configure the system clock */
  SystemClock_Config();

  /* Initialize all configured peripherals */
  MX_GPIO_Init();
  MX_CAN_Init();
  /* USER CODE BEGIN 2 */

  HAL_CAN_Start(&hcan);

  // Activate the notification
  HAL_CAN_ActivateNotification(&hcan, CAN_IT_RX_FIFO1_MSG_PENDING);


  TxHeader.DLC = 2;  // data length
  TxHeader.IDE = CAN_ID_STD;
  TxHeader.RTR = CAN_RTR_DATA;
  TxHeader.StdId = 0x103;  // ID


  TxData[0] = 200;  // ms delay
  TxData[1] = 20;  // loop rep

  /* USER CODE END 2 */

  /* Infinite loop */
  /* USER CODE BEGIN WHILE */
  while (1)
  {
    /* USER CODE END WHILE */

    /* USER CODE BEGIN 3 */

	  HAL_Delay (1000);

	  if (datacheck)
	  {
		  // blink the LED
		  for (int i=0; i<RxData[1]; i++)
		  {
			  HAL_GPIO_TogglePin(GPIOC, GPIO_PIN_13);
			  HAL_Delay(RxData[0]);
		  }

		  datacheck = 0;

		  HAL_CAN_AddTxMessage(&hcan, &TxHeader, TxData, &TxMailbox);

	  }
  }
  /* USER CODE END 3 */
}

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
