samim-robotix/IRoCU-2024-ISRO-Rover/ISRO Total File/ISRO Robotics Challenge/obseract/st_platformio/as5600_enc/src/main.cpp

#include <Arduino.h>

#include "AS5600.h"
#include <Wire.h>


AS5600 as5600;   //  use default Wire


void setup()
{
  Serial.begin(115200);
  Serial.println(__FILE__);
  Serial.print("AS5600_LIB_VERSION: ");
  Serial.println(AS5600_LIB_VERSION);

  Wire.setSCL(PB8);
  Wire.setSDA(PB9);

  Wire.begin();

  as5600.begin(4);  //  set direction pin.
  as5600.setDirection(AS5600_CLOCK_WISE);  //  default, just be explicit.
  int b = as5600.isConnected();
  Serial.print("Connect: ");
  Serial.println(b);
  delay(1000);
}


void loop()
{
  //  Serial.print(millis());
  //  Serial.print("\t");
  Serial.print(as5600.readAngle());
  Serial.print("\t");
  Serial.println(as5600.rawAngle());
  //  Serial.println(as5600.rawAngle() * AS5600_RAW_TO_DEGREES);

  delay(100);
}
