samim-robotix/IRoCU-2024-ISRO-Rover/ISRO/stm_roboarm/src/main.cpp

#include <Arduino.h>

#include "DFRobot_MCP2515.h"

const int SPI_CS_PIN = PA15;

DFRobot_MCP2515 CAN(SPI_CS_PIN);                                    // Set CS pin

void setup()
{
    Serial.begin(115200);

    while( CAN.begin(CAN_500KBPS) ){   // init can bus : baudrate = 500k
        Serial.println("DFROBOT's CAN BUS Shield init fail");
        Serial.println("Please Init CAN BUS Shield again");
        delay(3000);
    }
    Serial.println("DFROBOT's CAN BUS Shield init ok!\n");

}

unsigned char data[8] = {'D', 'F', 'R', 'O', 'B', 'O', 'T', '!'};
void loop()
{
    // send data:  id = 0x06, standrad flame, data len = 8, data: data buf
    CAN.sendMsgBuf(0x06, 0, 8, data);
    delay(100);                       // send data per 100ms
}
