samim-robotix/IRoCU-2024-ISRO-Rover/ISRO Total File/ISRO Robotics Challenge/obseract/color_hsv.py

import cv2
import numpy as np

cap = cv2.VideoCapture(0)

while True:
    _, frame = cap.read()
    hsv_frame = cv2.cvtColor(frame, cv2.COLOR_BGR2HSV)
        # Red color
    low_red = np.array([0, 127, 60])
    high_red = np.array([30, 255, 255])
    red_mask = cv2.inRange(hsv_frame, low_red, high_red)
    red = cv2.bitwise_and(frame, frame, mask=red_mask)
        # Blue color
    # low_blue = np.array([94, 80, 2])
    # high_blue = np.array([126, 255, 255])
    # blue_mask = cv2.inRange(hsv_frame, low_blue, high_blue)
    # blue = cv2.bitwise_and(frame, frame, mask=blue_mask)

    # Green color
    # low_green = np.array([25, 52, 72])
    # high_green = np.array([102, 255, 255])
    # green_mask = cv2.inRange(hsv_frame, low_green, high_green)
    # green = cv2.bitwise_and(frame, frame, mask=green_mask)

    # Every color except white
    # low = np.array([0, 42, 0])
    # high = np.array([179, 255, 255])
    # mask = cv2.inRange(hsv_frame, low, high)
    # result = cv2.bitwise_and(frame, frame, mask=mask)
    
    cv2.imshow("Frame", frame)
    cv2.imshow("Red", red)
    # cv2.imshow("Blue", blue)
    # cv2.imshow("Green", green)
    # cv2.imshow("Result", result)

    key = cv2.waitKey(1)
    if key == 27:
        break
